micromake/micromake.github.io/docs/index.md

---
title: 导览
icon: lucide/rocket
---

<div class="grid cards" markdown>
-   :material-clock-fast:{ .lg .middle } __Tips__

    ---

    <ul>
      <li>搜索关键词以打开文章。</li>
      <li>通过主题和目录以打开文章。</li>
      <li>电脑端：请在上方标签栏选择语言，在左侧目录选择文章。</li>
      <li>移动端：请在上方标签栏选择语言，请点击左上角图标选择文章。</li>

</div>
