micromake/micromake.github.io/docs/delta/3/3.md

---
title: 传动组装
---

## 0.注意事项

!!! info "螺丝固定"
    螺丝需要涂抹螺纹胶,  需要涂抹螺纹胶的螺丝使用<strong><span style="color:#295FCC">蓝色</span></strong>显示：
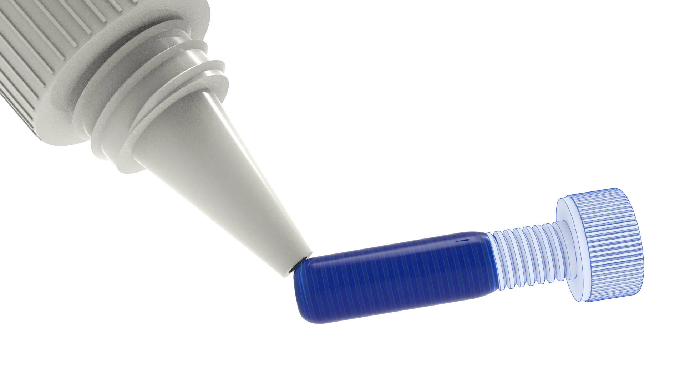
[picture p3: docs/delta/3/ls.webp]
    

???+ tip "安装建议"

    安装导轨时，建议佩戴手套。
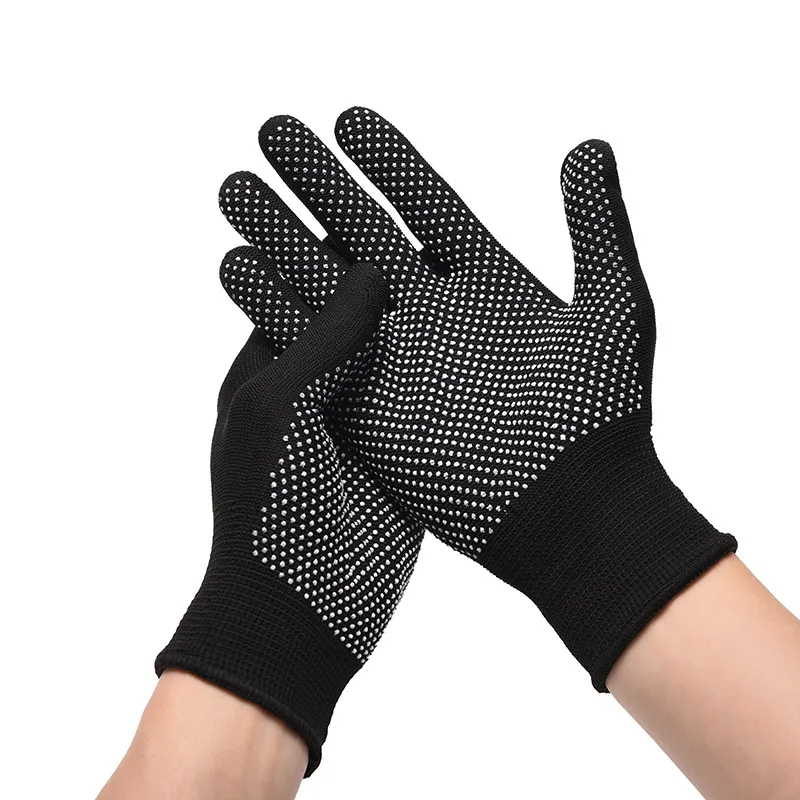
[picture p4: docs/delta/3/jy1.webp]
    
    建议在平整的桌面进行安装。
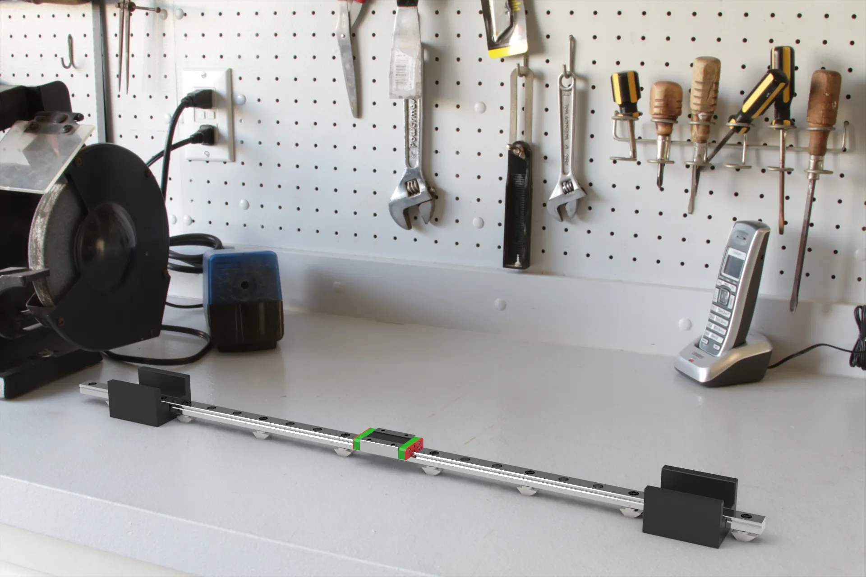
[picture p5: docs/delta/3/jy2.webp]
    

## 1.导轨组装

### 所需物料

1.直线导轨 * 3
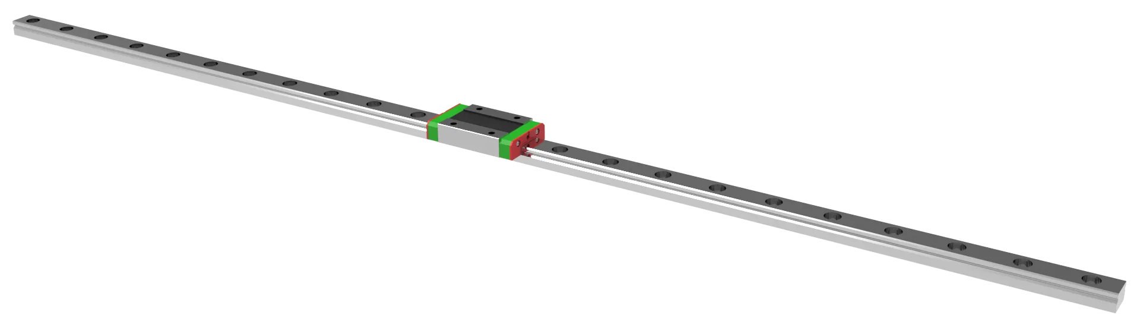
[picture p6: docs/delta/3/dg.webp]
   

2.M3*10 杯头螺丝 * 24
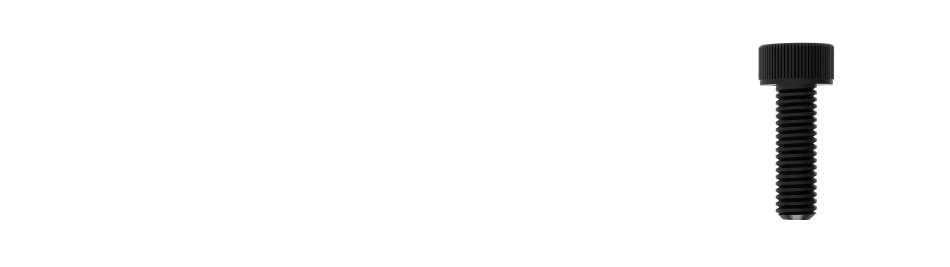
[picture p7: docs/delta/3/M3-10.webp]
   

3.M3*14 杯头螺丝 * 3
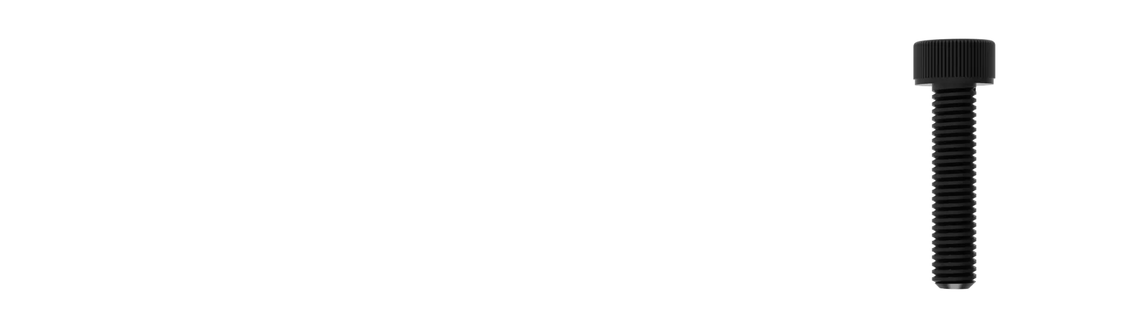
[picture p8: docs/delta/3/M3X14.webp]
   

4.船型螺母30型-M3 * 27
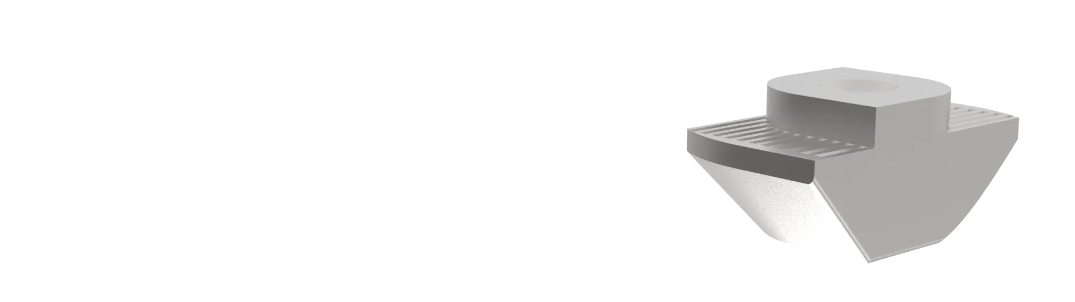
[picture p9: docs/delta/3/30M3.webp]
   

### 打印零件

1.[导轨定位件] * 2
[导轨定位件]: dy1.stl
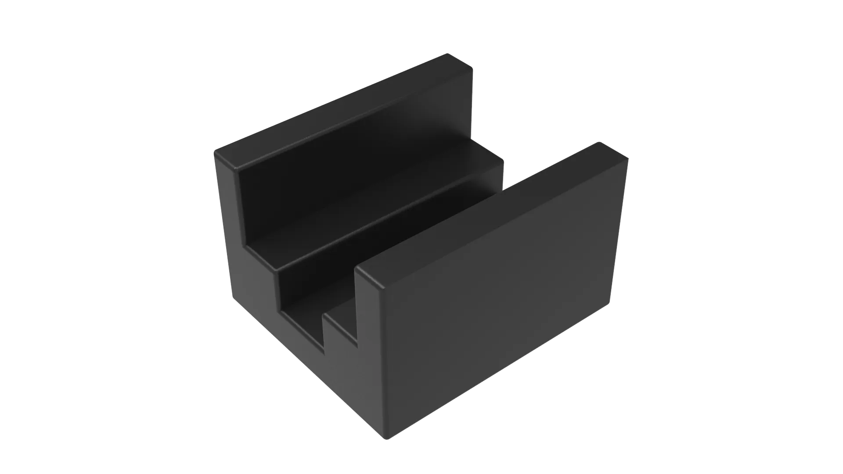
[picture p10: docs/delta/3/dy1.webp]
   

2.[导轨防脱块] * 3
[导轨防脱块]: dy2.stl
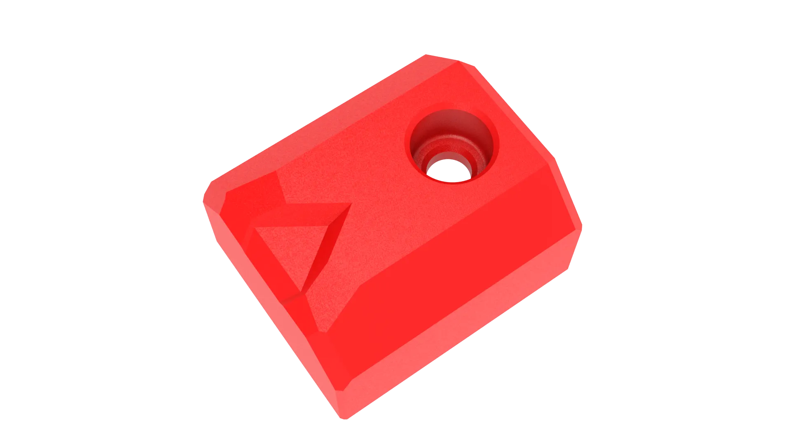
[picture p11: docs/delta/3/dy2.webp]
   

### 组装流程

1.拿出<strong>直线导轨</strong>使用两个<strong>导轨定位件</strong>将导轨撑起，使用<strong>M3*10 杯头螺丝</strong>穿过导轨，从上往下每隔两个孔安装一颗，总计八颗。
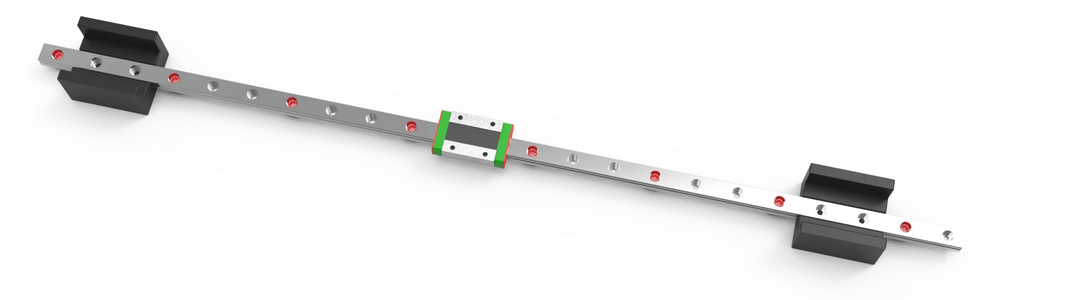
[picture p12: docs/delta/3/1.webp]
   

!!! info "info"
    此步骤建议在干净的桌面上进行操作。

2.在导轨处套入<strong>导轨防脱块</strong>使用<strong>M3*14 杯头螺丝</strong>穿过导轨。
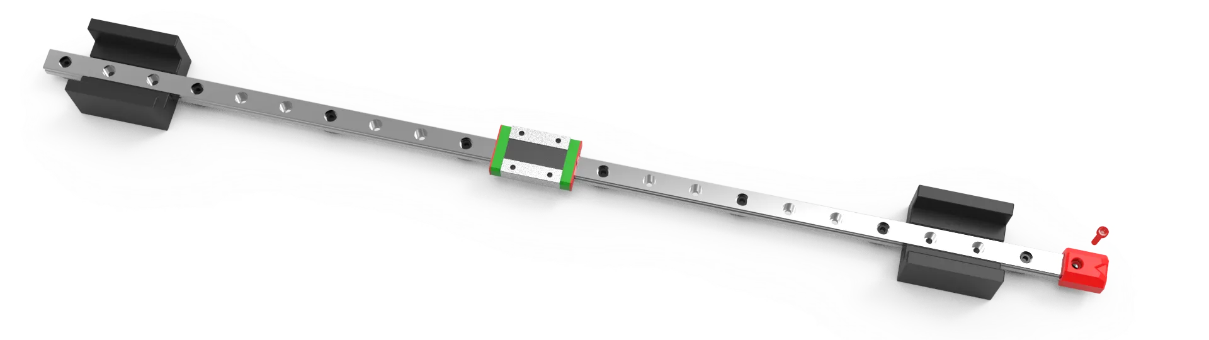
[picture p13: docs/delta/3/2.webp]
   

3.拧上九颗<strong>船型螺母30型-M3</strong>，不要拧紧，拧上即可。
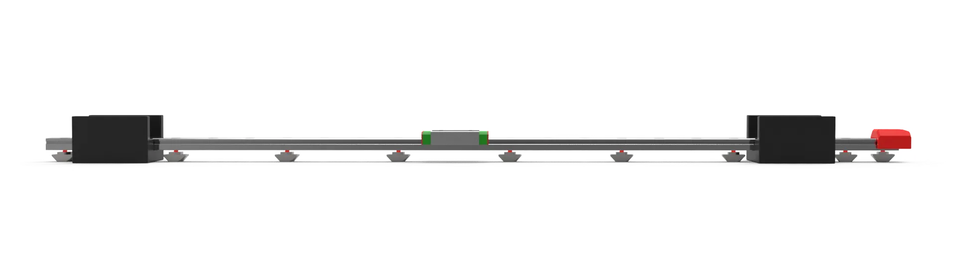
[picture p14: docs/delta/3/3.webp]
   

4.将<strong>直线导轨</strong>放入<strong>长型材</strong>上，<strong>船型螺母30型-M3</strong>应在槽内，使用两个<strong>导轨固定件</strong>辅助型材左右定位，防止滑块脱落，<strong>导轨防脱块</strong>在下方固定,如图所示。
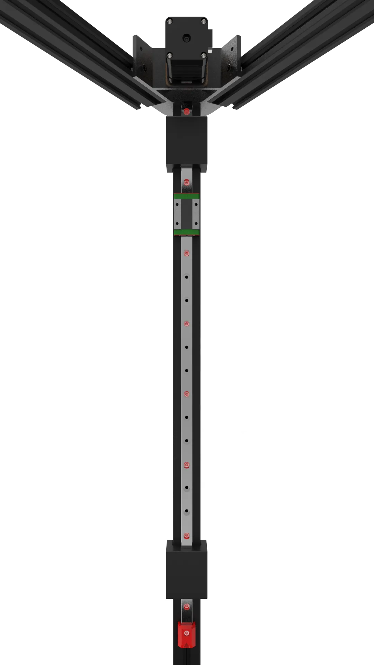
[picture p15: docs/delta/3/4.webp]
   
   
5.拧紧<strong>M3*10 杯头螺丝</strong>，确保所有<strong>船型螺母30型-M3</strong>全部卡到<strong>长型材</strong>槽内，安装完成后滑动<strong>直线导轨</strong>上的滑块，确认是否顺滑没有卡顿，可适当加入润滑油使滑块运动顺畅，最后取出<strong>导轨定位块</strong>，如图所示。
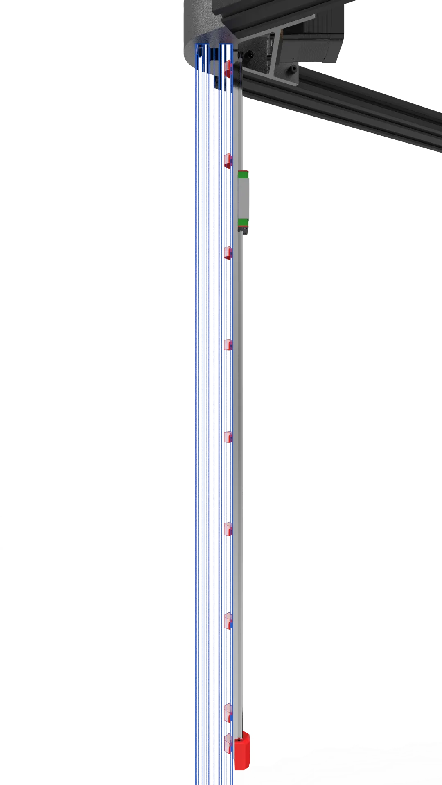
[picture p16: docs/delta/3/5.webp]
   

6.另外两根安装方法相同。
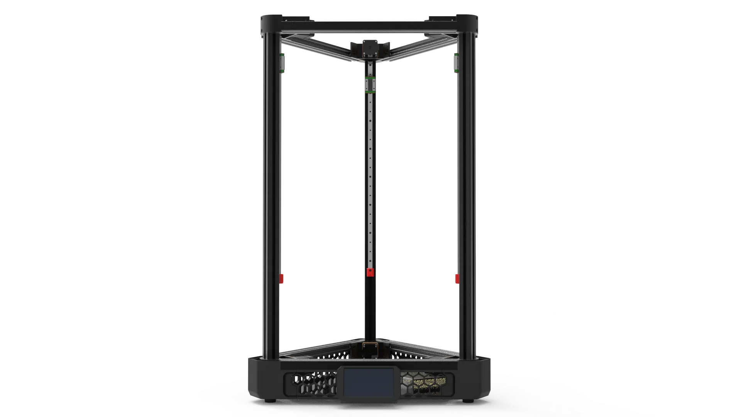
[picture p17: docs/delta/3/10.webp]
   
   
## 2.滑块组装

### 所需物料

1.金属连接滑块 * 3
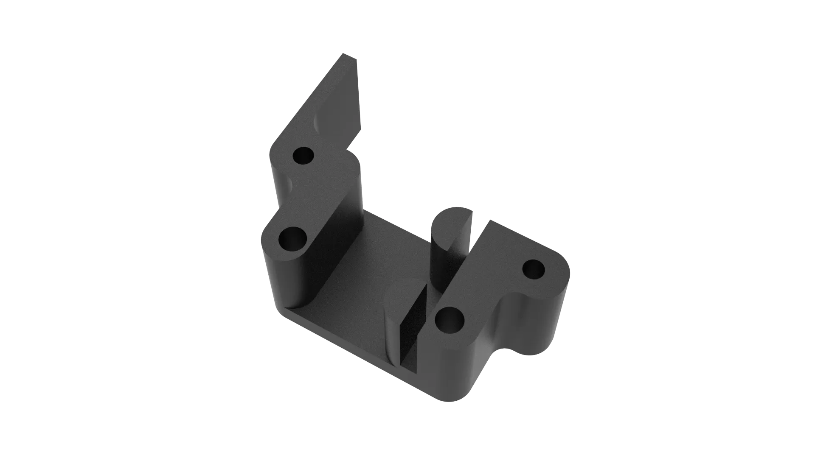
[picture p18: docs/delta/3/hk.webp]
   

2.金属球头连接件 * 3
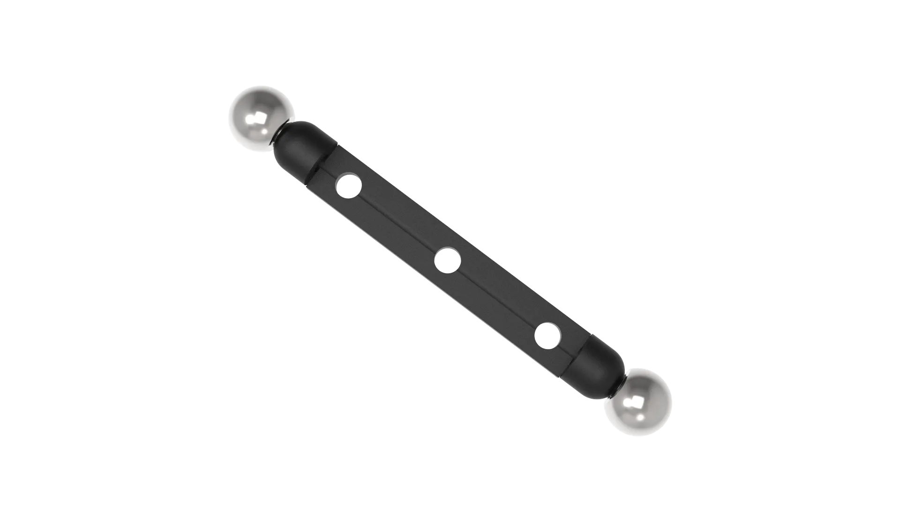
[picture p19: docs/delta/3/ljj.webp]
   

3.2GT开口同步带 * 3
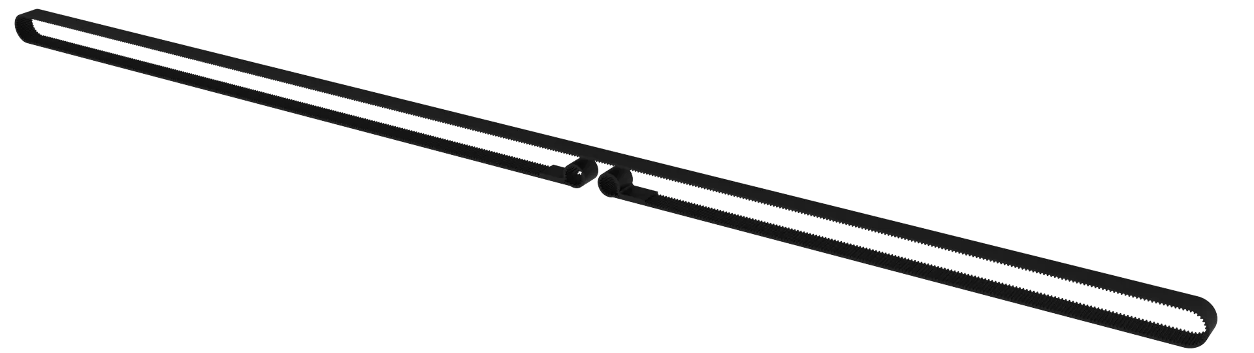
[picture p20: docs/delta/3/pd.webp]
   

4.扎带 * 12
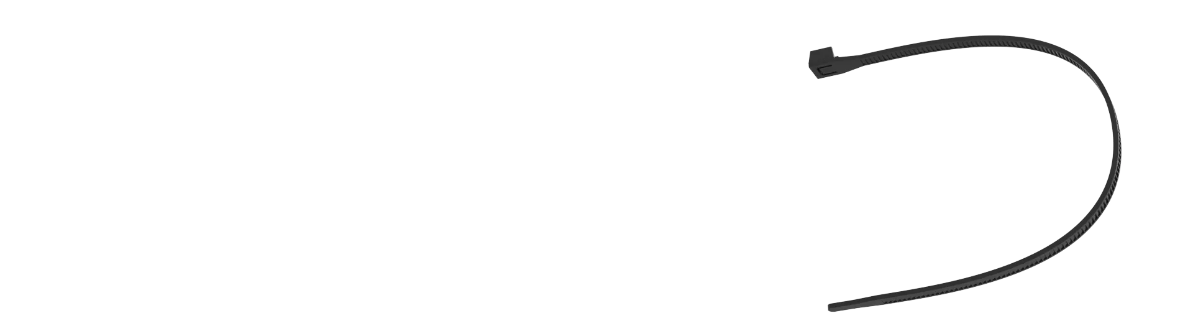
[picture p21: docs/delta/3/zd.webp]
   

5.M3*14 杯头螺丝 * 6
   

6.M3*20 杯头螺丝 * 6
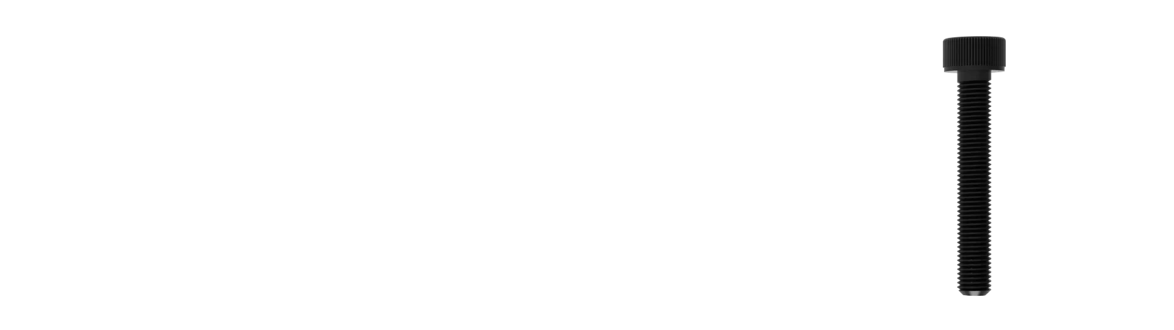
[picture p22: docs/delta/3/M3X20.webp]
   

### 打印零件

1.[滑块垫片] * 3
[滑块垫片]: dy3.stl
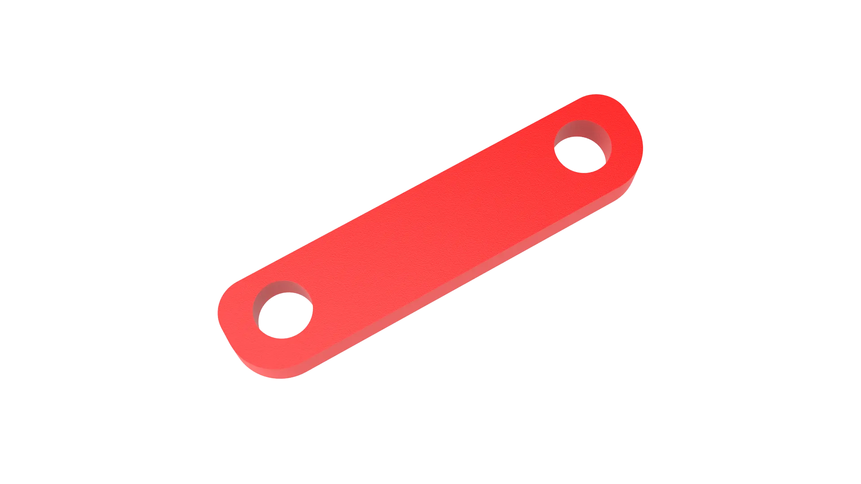
[picture p23: docs/delta/3/dy3.webp]
   

2.[滑块装饰块] * 3
[滑块装饰块]: dy4.stl
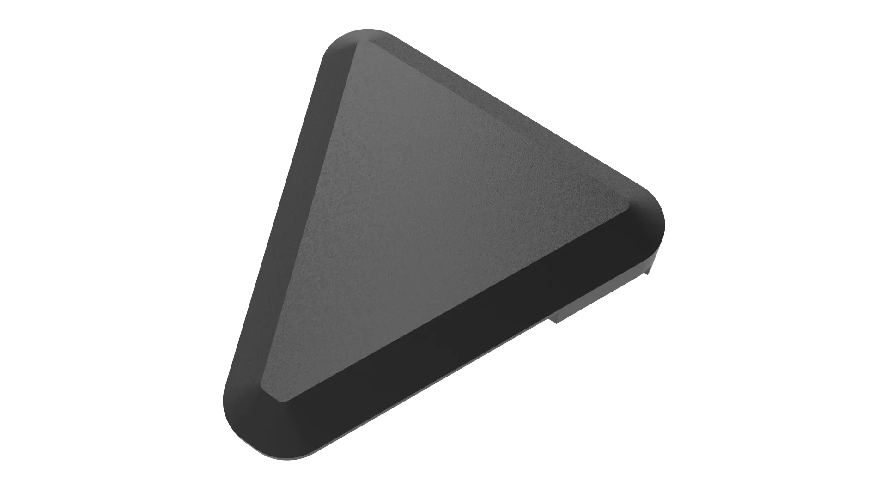
[picture p24: docs/delta/3/dy4.webp]
   

### 组装流程

1.将<strong>2GT开口同步带</strong>穿过两个<strong>步进电机</strong>，两端分别套到<strong>步进电机</strong>同步轮的槽内，如图所示。
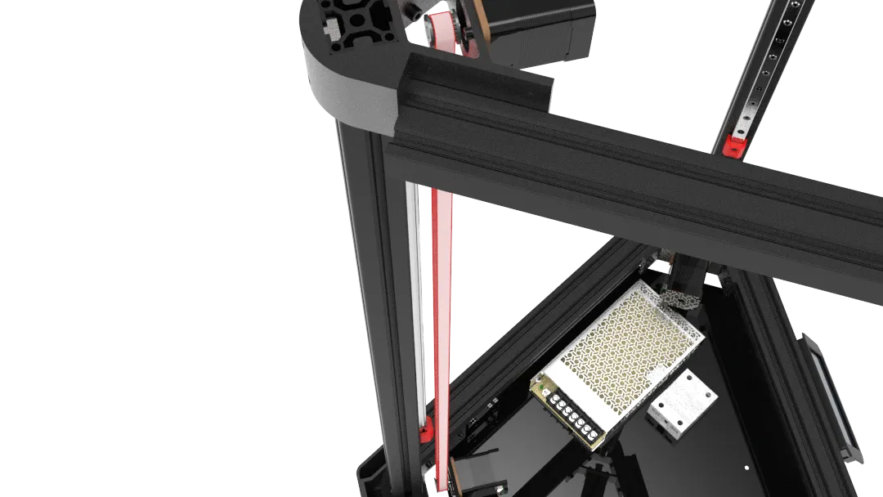
[picture p25: docs/delta/3/6.webp]
   
2.将<strong>2GT开口同步带</strong>的两端绕到<strong>金属连接滑块</strong>中，使用<strong>扎带</strong>将扎紧，并减去多余的部分，如图所示。
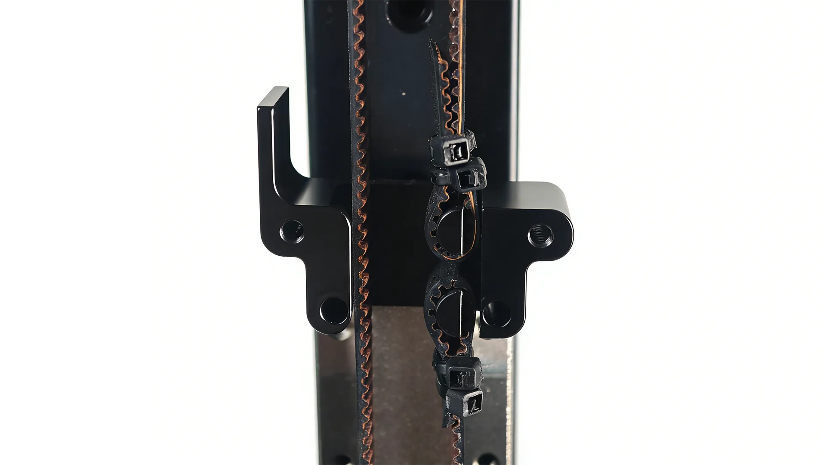
[picture p26: docs/delta/3/7.webp]
   

3.使用两颗<strong>M3*20 杯头螺丝</strong>穿过<strong>滑块垫片</strong>与<strong>金属连接滑块</strong>后固定到<strong>直线导轨</strong>的滑块上，需拧紧,如图所示。
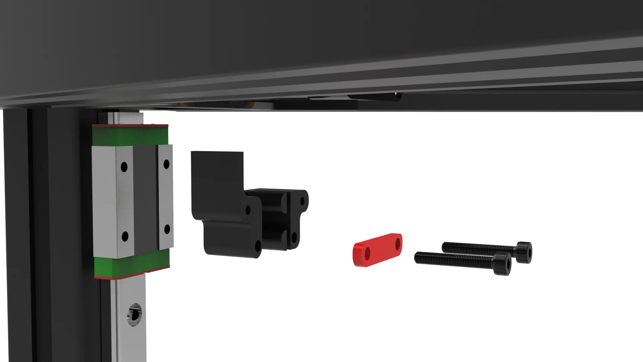
[picture p27: docs/delta/3/8.webp]
   
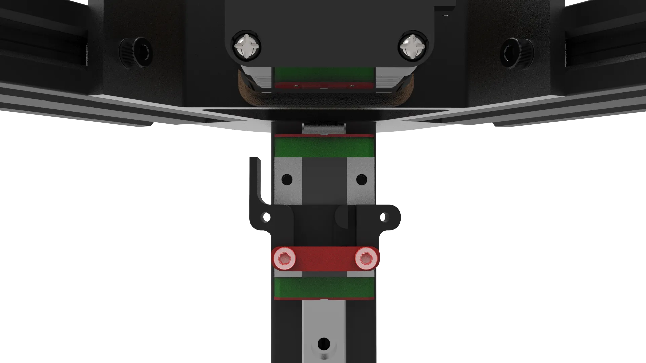
[picture p28: docs/delta/3/9.webp]
   

4.使用两颗<strong>M3*14 杯头螺丝</strong>穿过<strong>滑块垫片</strong>与<strong>金属连接滑块</strong>，涂抹上<strong>螺纹胶</strong>后固定到<strong>直线导轨</strong>的滑块上，需拧紧,如图所示。 
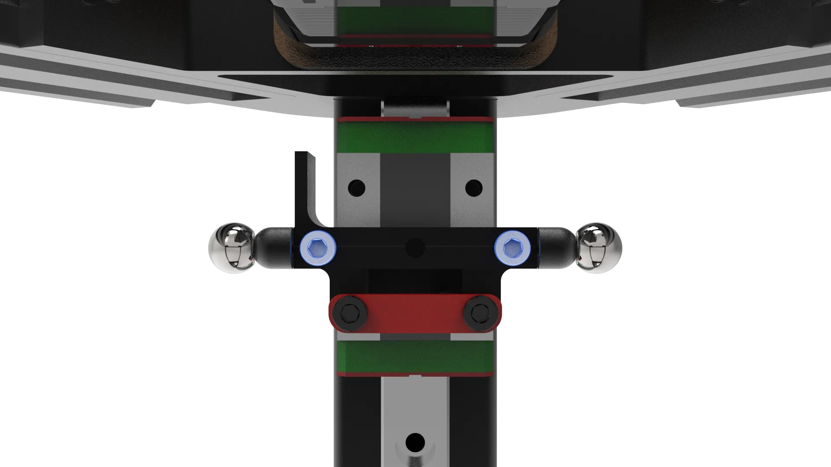
[picture p29: docs/delta/3/11.webp]
   

5.将<strong>滑块装饰块</strong>卡入到<strong>金属连接滑块</strong>上，如图所示。
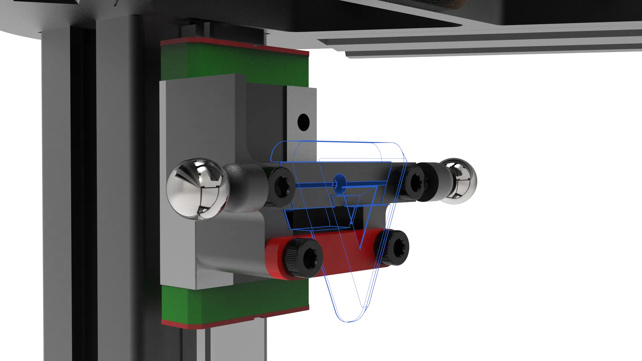
[picture p30: docs/delta/3/12.webp]
   
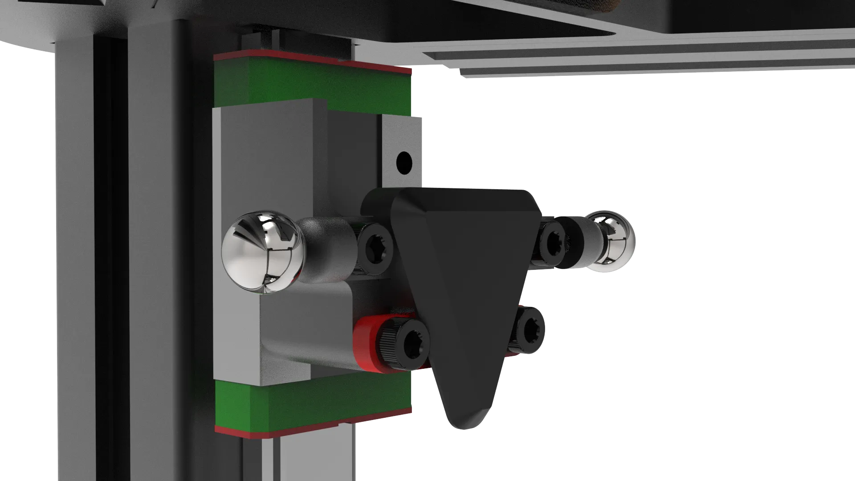
[picture p31: docs/delta/3/13.webp]
   

6.另外两组安装方法相同。
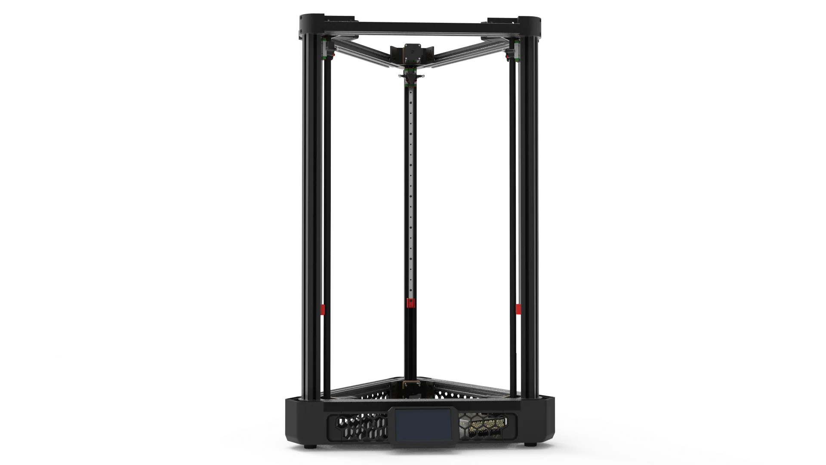
[picture p32: docs/delta/3/14.webp]
   

## 3.传动调节

### 所需物料

1.扭力弹簧 * 3
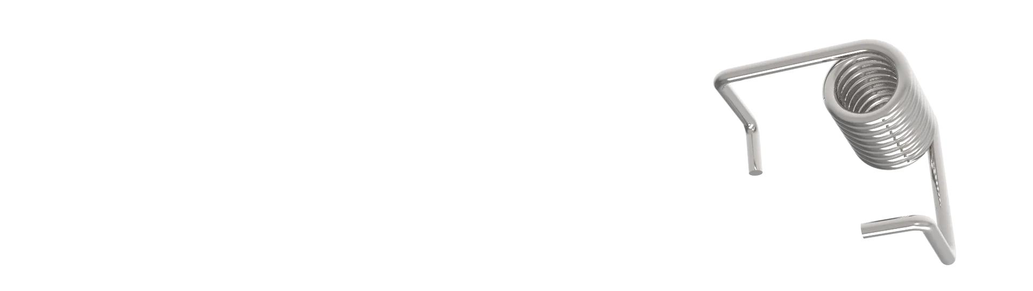
[picture p33: docs/delta/3/th.webp]
   

2.扎带 * 3
   

### 打印零件

1.[皮带松紧调节件] * 3
[皮带松紧调节件]: dy5.stl
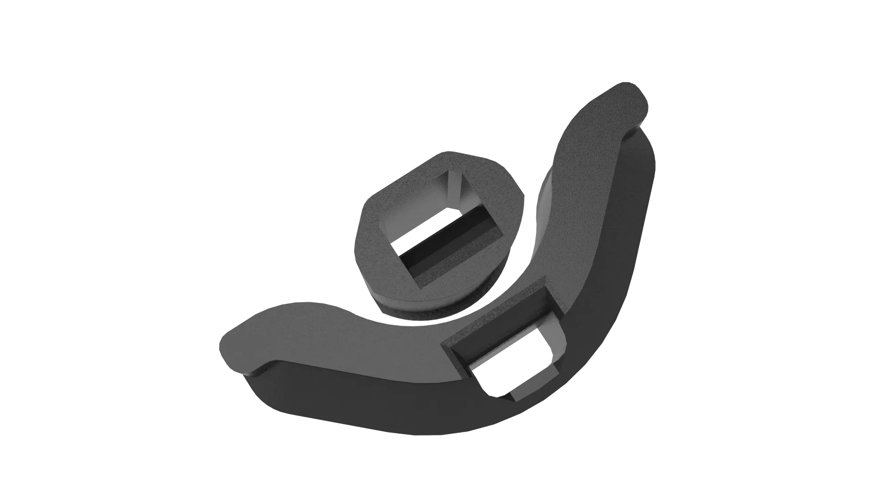
[picture p34: docs/delta/3/dy5.webp]
   

### 组装流程

1.将<strong>皮带松紧调节件</strong>与<strong>2GT开口同步带</strong>如图所示连接。
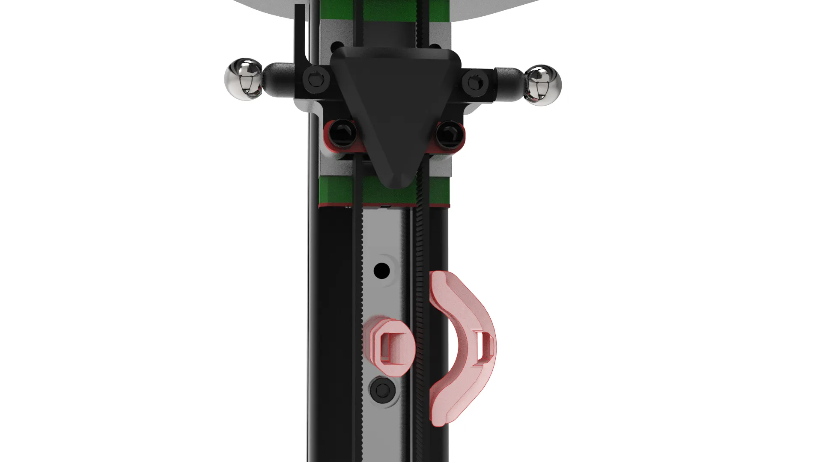
[picture p35: docs/delta/3/15.webp]
   

2.使用<strong>扎带</strong>拉紧<strong>皮带松紧调节件</strong>使<strong>2GT开口同步带</strong>紧绷。
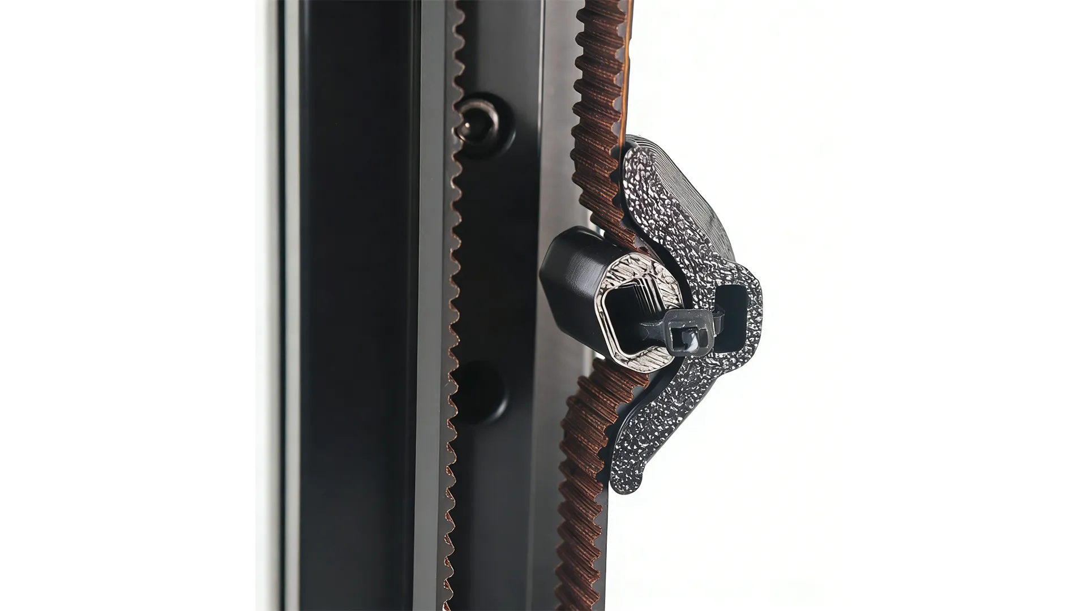
[picture p36: docs/delta/3/16.webp]
   
   
3.上下滑动<strong>金属连接滑块</strong>观察<strong>2GT开口同步带</strong>运动过程中是否会卡同步轮边缘，如图所示。
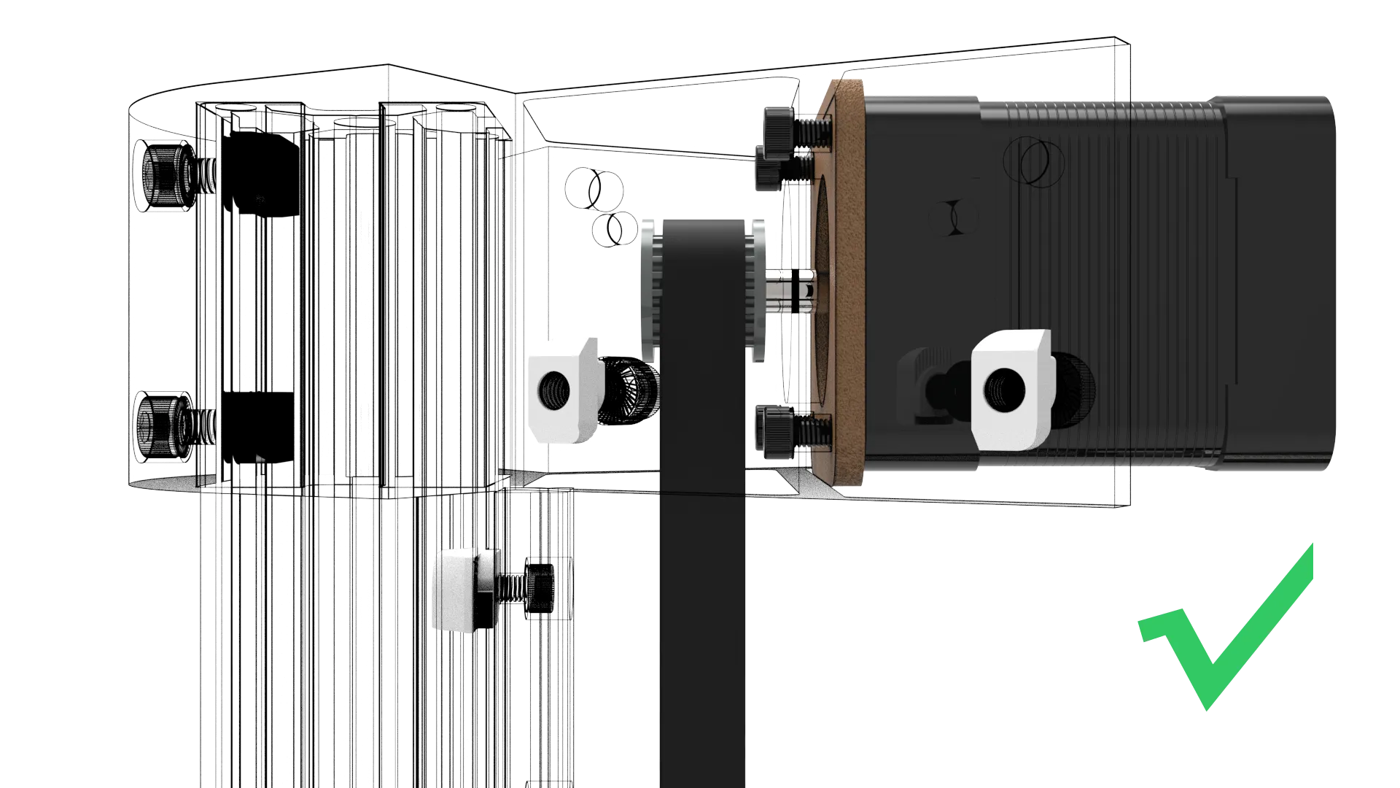
[picture p37: docs/delta/3/zq.webp]
   
!!! failure "错误"
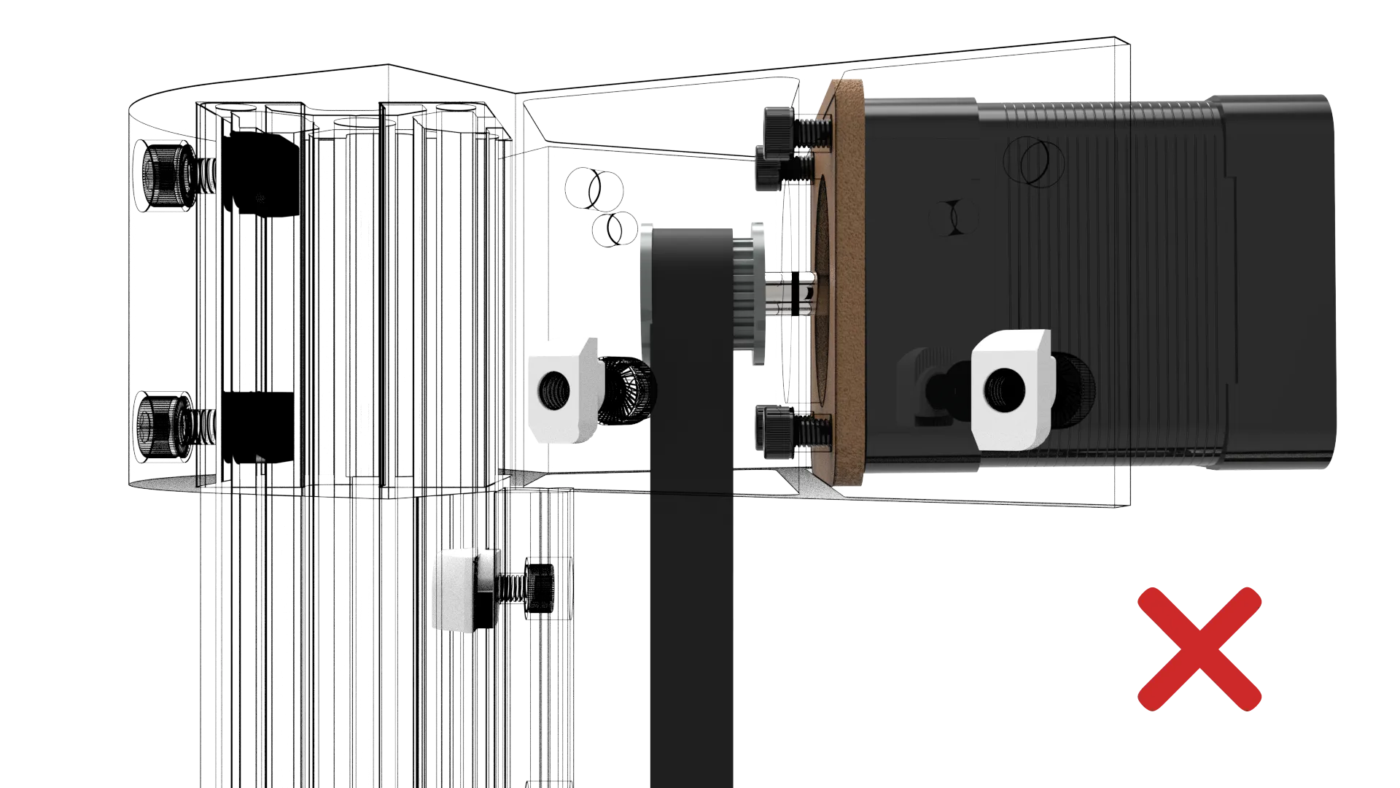
[picture p38: docs/delta/3/17.webp]
    
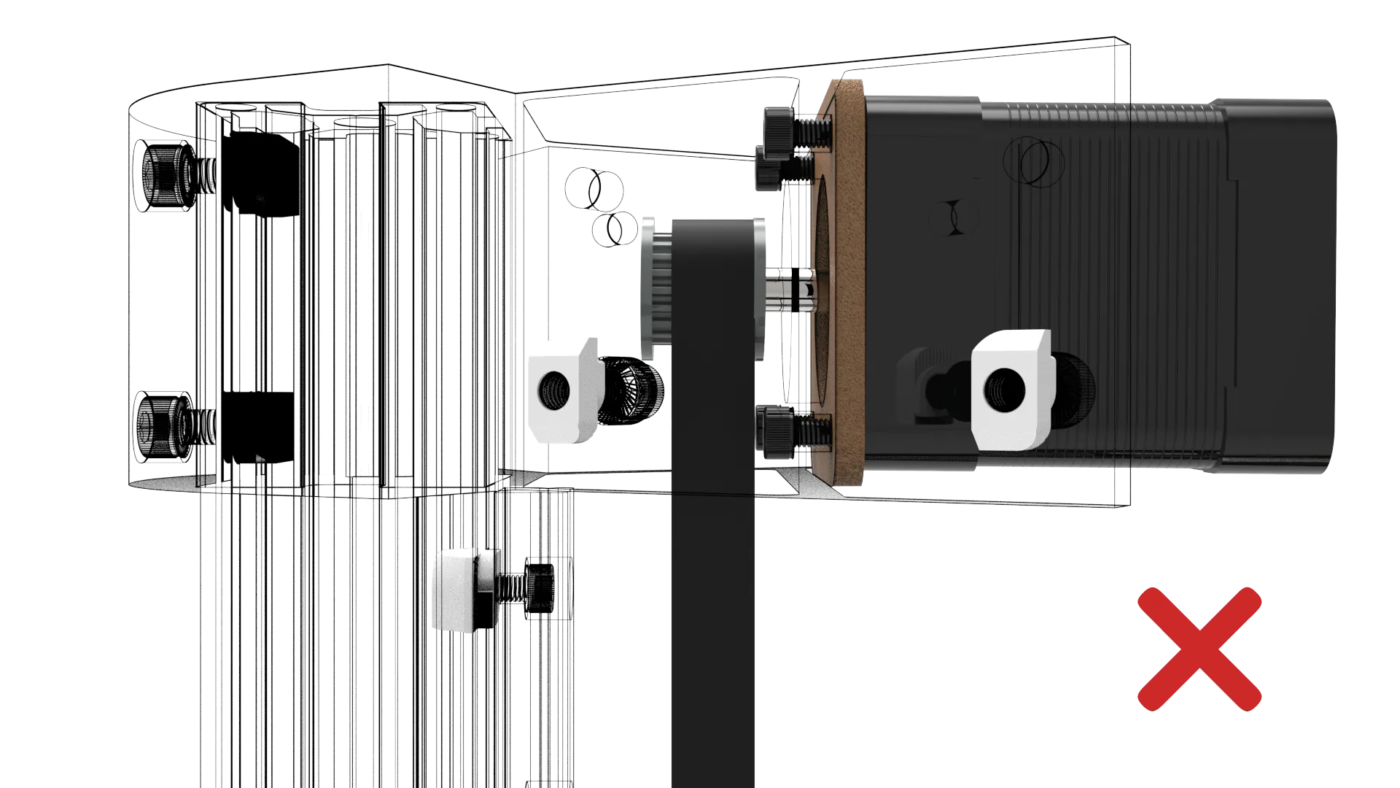
[picture p39: docs/delta/3/18.webp]
    

4.可调节<strong>步进电机</strong>的上下任意平行的两颗螺丝的松紧改变<strong>步进电机</strong>角度，使<strong>2GT开口同步带</strong>运动过程中不会摩擦<strong>步进电机</strong>的同步轮边缘。
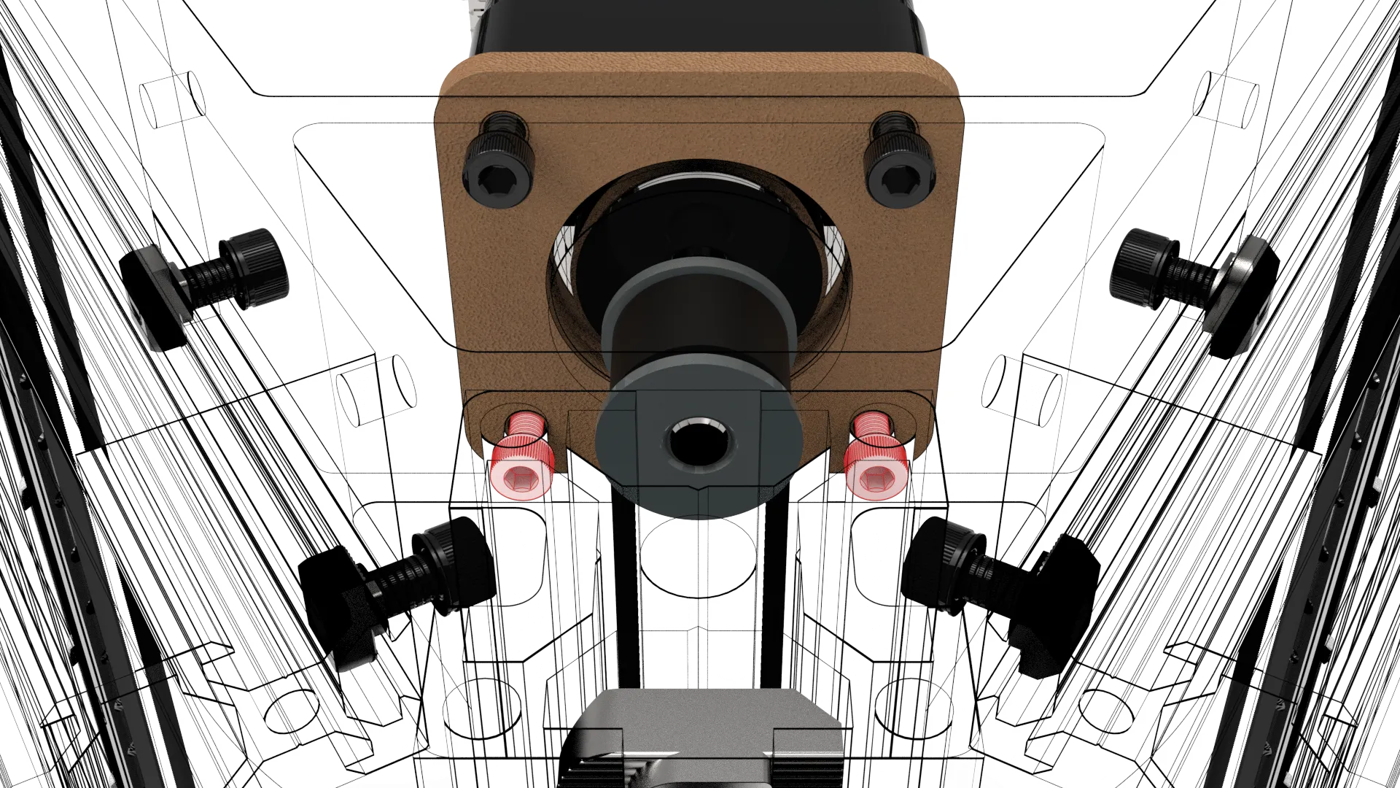
[picture p40: docs/delta/3/19.webp]
   
!!! success "正确"
    

5.最后如图所示位置安装<strong>扭力弹簧</strong>使具有一定自预紧力。
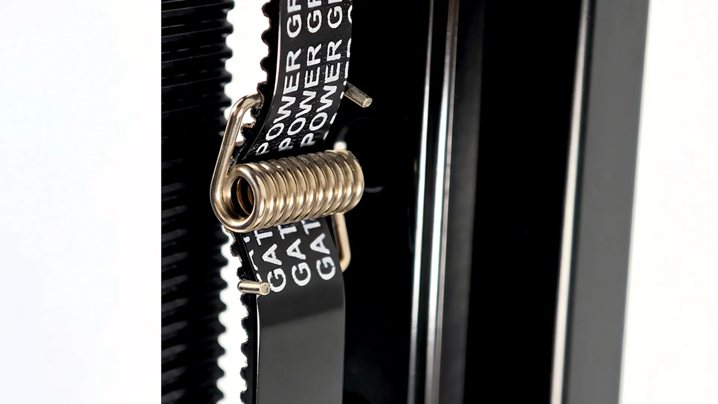
[picture p41: docs/delta/3/20.webp]
   

???- note "另一种皮带安装方法"

    这是另一种<strong>2GT开口同步带</strong>安装方法，原始的设计本应如此，更换为更加粗壮结实的同步带规格，最高支持到10MM宽度。
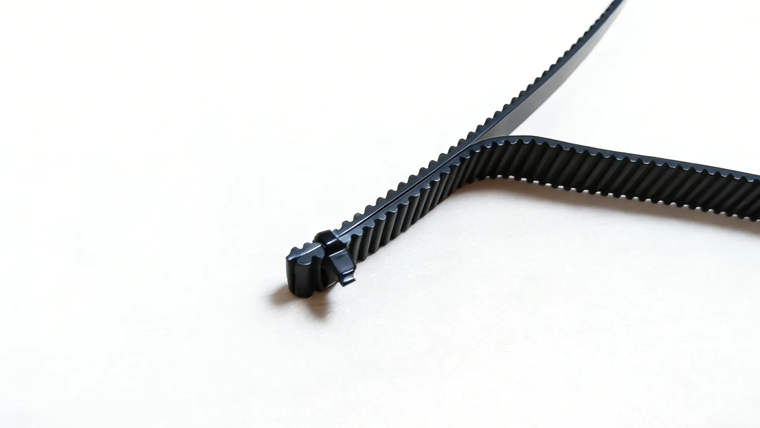
[picture p42: docs/delta/3/kz1.webp]
    
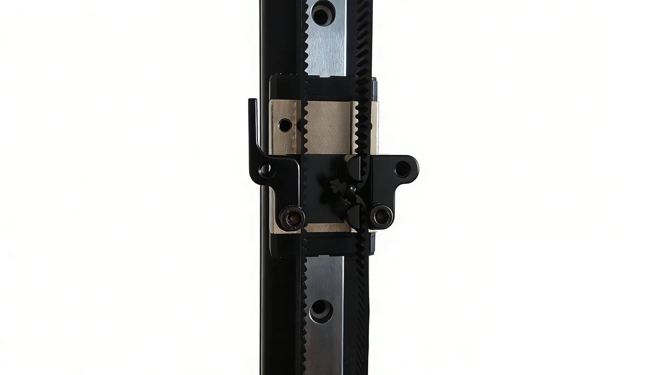
[picture p43: docs/delta/3/kz2.webp]
    
    使用另一种MGN滑块可以无需安装滑块垫片直接即可固定，因为量产的<strong>直线导轨</strong>变更，为了不额外增加螺丝种类才做了打印件进行抬升。（注意：如果不使用打印件而是直接进行螺丝固定，<strong>M3*20 杯头螺丝</strong>需要涂抹螺纹胶使其更加紧固。）

???- question "FAQ"

    **Q: 减震垫的作用是什么？**

    **A:** 步进电机与金属脚垫均为金属材质，电机高速运动时所产生的震动会传到了框架上，使用柔性垫片可以有效隔绝震动与噪音，同时因为是柔性垫片，可很方便的通过调节螺丝松紧度调节电机角度，进一步降低装配调试难度。
