micromake/micromake.github.io/docs/delta/2/2.md

---
title: 下部组装
---

## 0.注意事项

!!! warning "螺丝固定"
    螺丝固定打印件时，不要拧的过紧，以免拧坏打印件。

!!! info "嵌入螺母"
    部分打印件需借助烙铁压入<strong>滚花螺母</strong>：
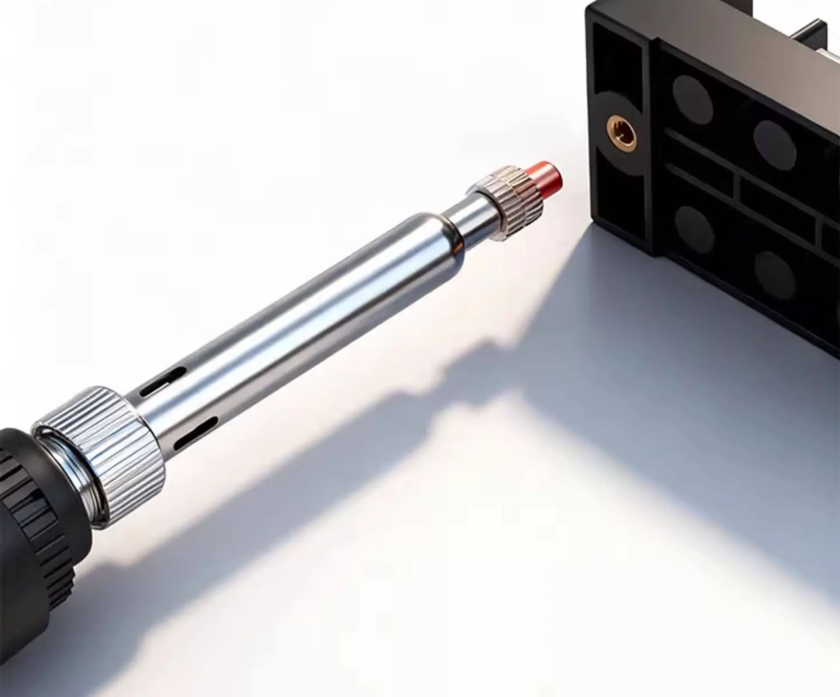
[picture p44: docs/delta/2/1.webp]
    

## 1.下装饰件

### 所需物料

1.脚垫 * 3
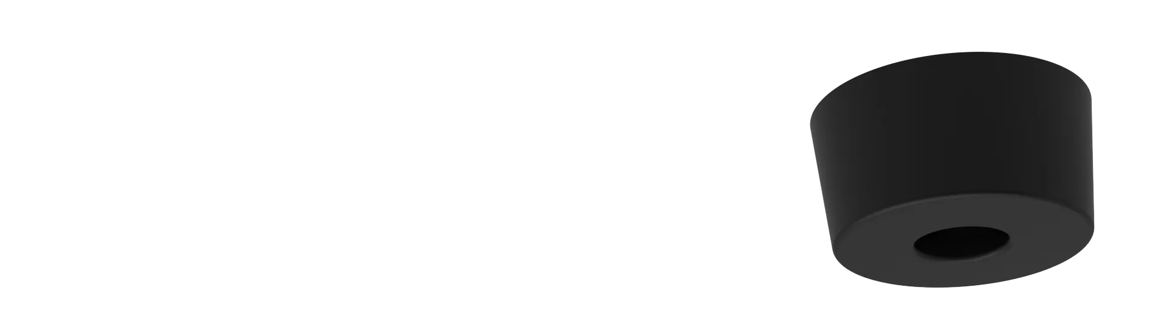
[picture p45: docs/delta/2/jd.webp]
   

2.船型螺母20型-M3 * 6
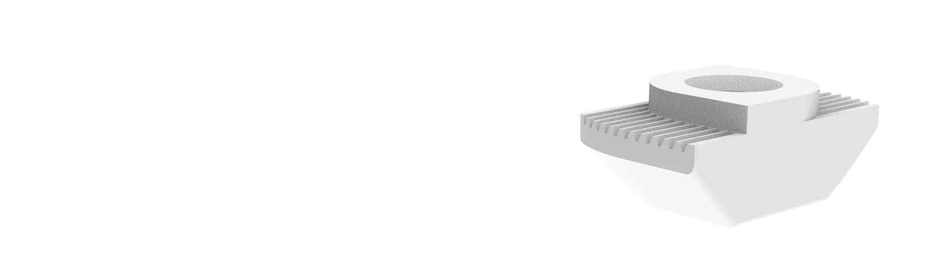
[picture p46: docs/delta/2/20M3.webp]
   

3.M5*16 杯头螺丝 * 3
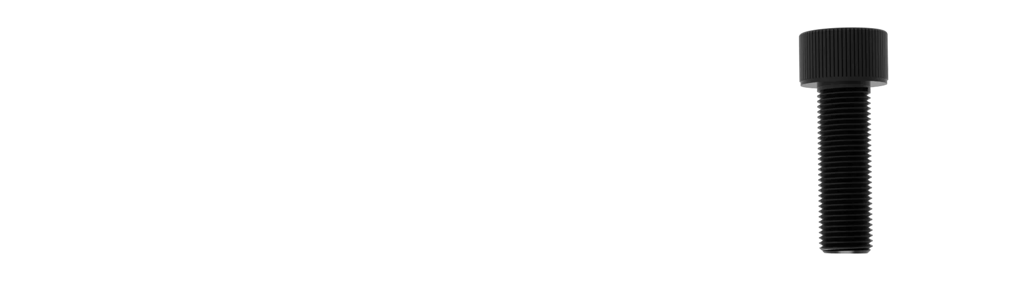
[picture p47: docs/delta/2/M5X16.webp]
   

4.M3*10 杯头螺丝 * 6
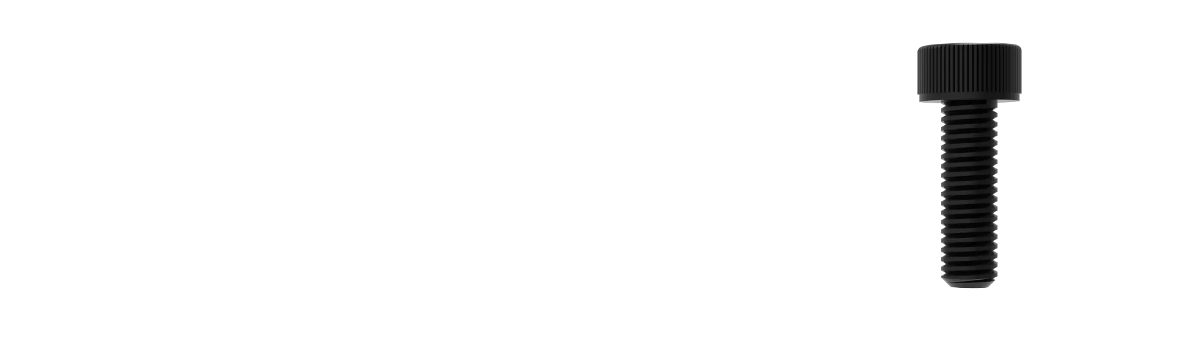
[picture p48: docs/delta/2/M3X10.webp]
   

### 打印零件

1.[下脚件装饰件] * 3
[下脚件装饰件]: dy1.stl
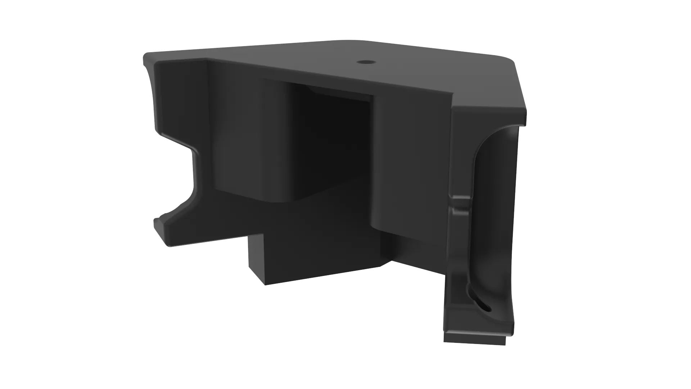
[picture p49: docs/delta/2/dy1.webp]
   

### 组装流程

1.将<strong>M5*16 杯头螺丝</strong>穿过<strong>脚垫</strong>拧入到<strong>下脚件装饰件</strong>中。
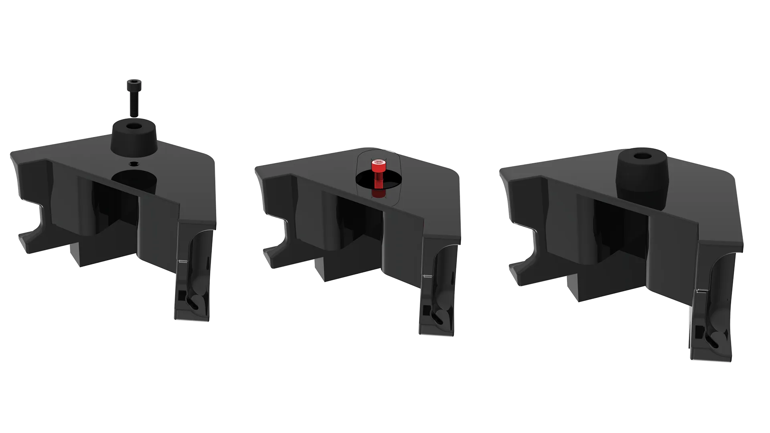
[picture p50: docs/delta/2/2.webp]
   

2.将<strong>M3*10 杯头螺丝</strong>穿过<strong>下脚件装饰件</strong>并套上<strong>船型螺母20型-M3</strong>。
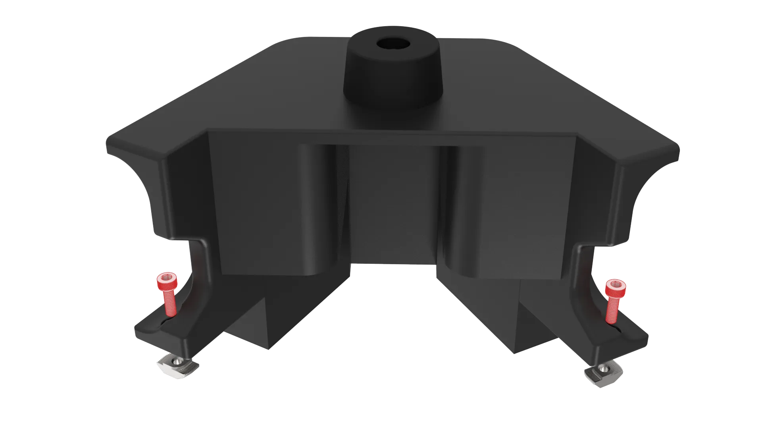
[picture p51: docs/delta/2/3.webp]
   

3.<strong>M3*10 杯头螺丝</strong>拧上即可，无需拧紧。
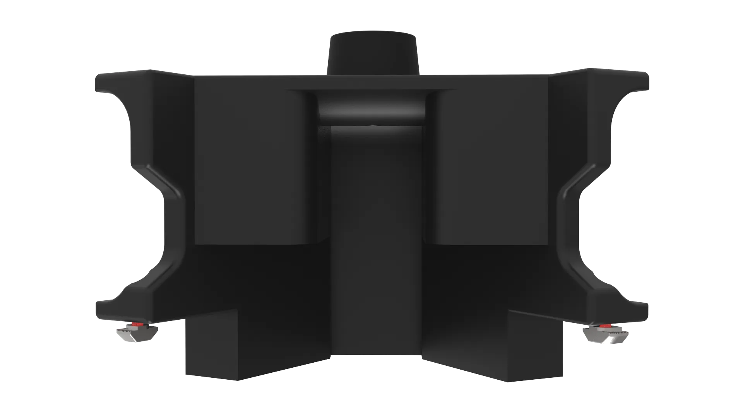
[picture p52: docs/delta/2/4.webp]
   

4.固定到<strong>短铝型材</strong>上。
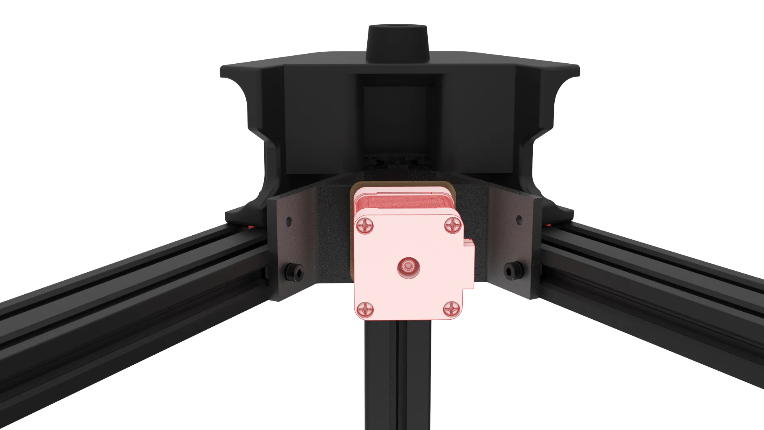
[picture p53: docs/delta/2/5.webp]
   

5.注意<strong>船型螺母20型-M3</strong>的位置，应卡在型材上，不要拧的过紧，以免拧坏<strong>下脚件装饰件</strong>。
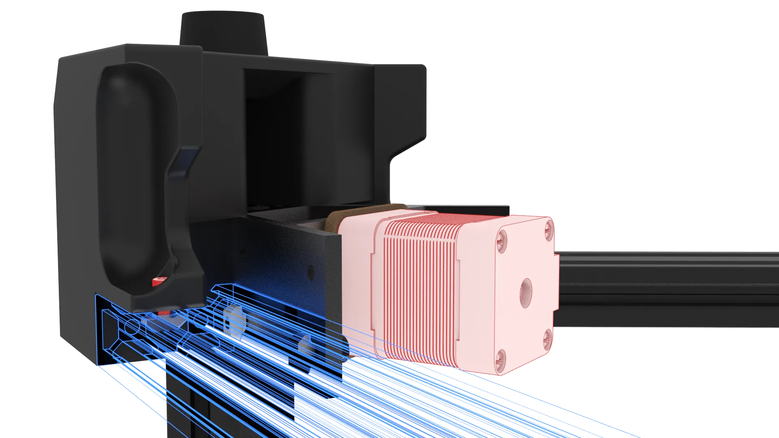
[picture p54: docs/delta/2/6.webp]
   

6.另外两组安装方法相同。
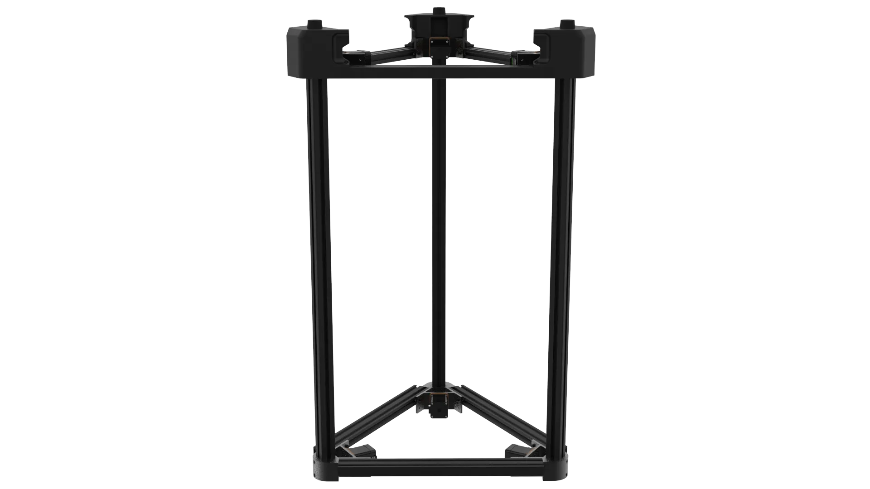
[picture p55: docs/delta/2/7.webp]
   

## 2.左侧裙边

### 所需物料

1.M3*8 沉头螺丝 * 6
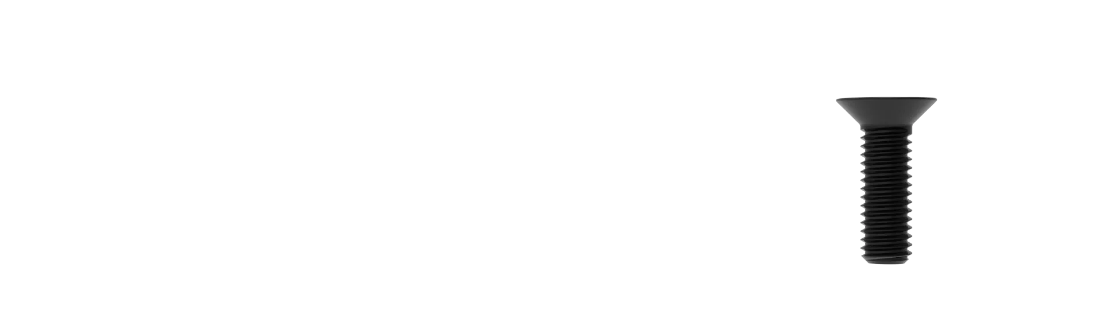
[picture p56: docs/delta/2/M3X8.webp]
   

2.滚花螺母 * 3
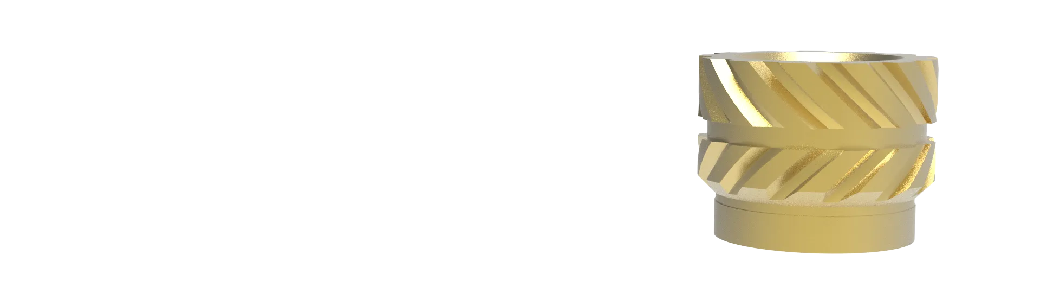
[picture p57: docs/delta/2/tlm.webp]
   
   
3.船型螺母20型-M3 * 6
   

### 打印零件

1.[左裙边打印件]  * 3
[左裙边打印件]: dy2.stl
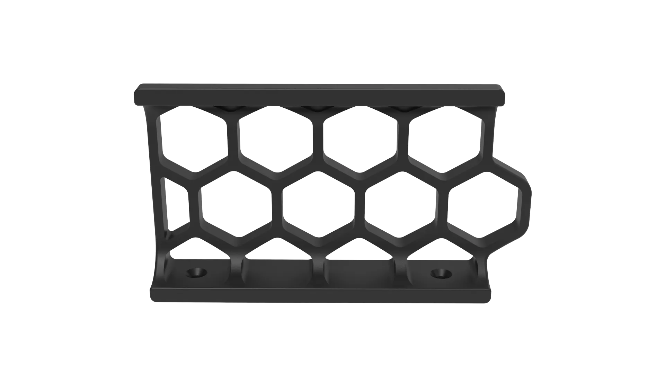
[picture p58: docs/delta/2/dy2.webp]
   

### 组装流程

1.使用烙铁将<strong>滚花螺母</strong>压入<strong>左裙边打印件</strong>中。
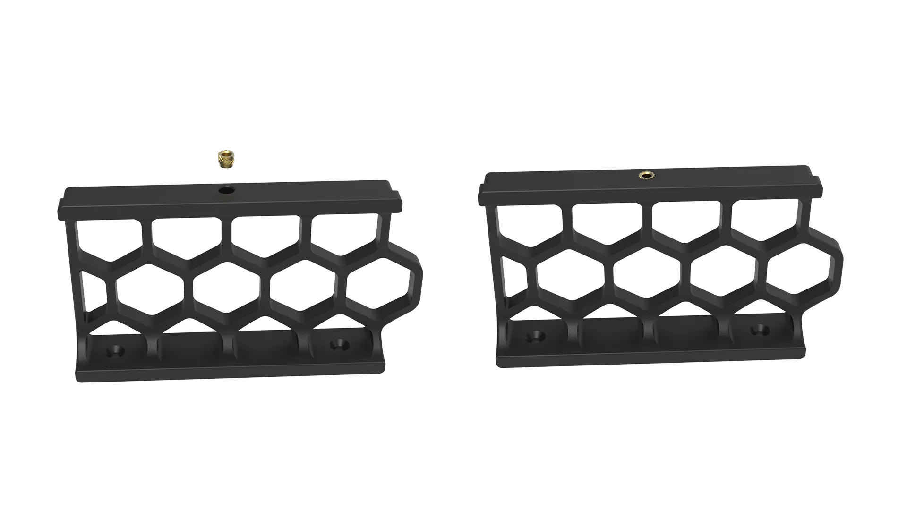
[picture p59: docs/delta/2/8.webp]
   

2.将<strong>M3*8 沉头螺丝</strong>穿过<strong>左裙边打印件</strong>并套上<strong>船型螺母20型-M3</strong>。
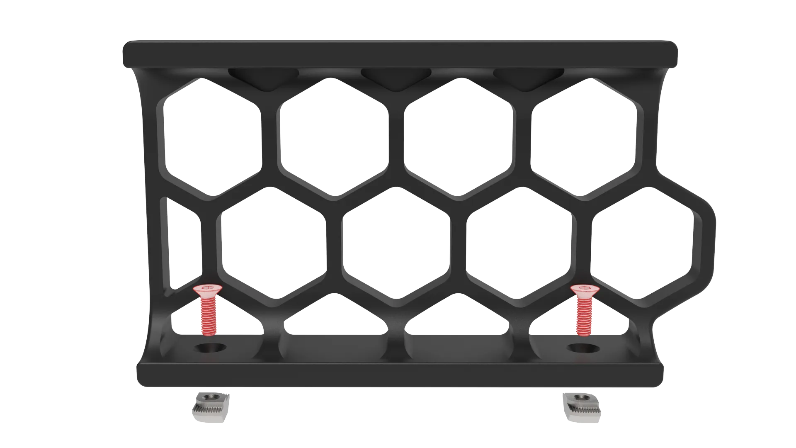
[picture p60: docs/delta/2/9.webp]
   

3.<strong>M3*8 沉头螺丝</strong>拧上即可，无需拧紧。
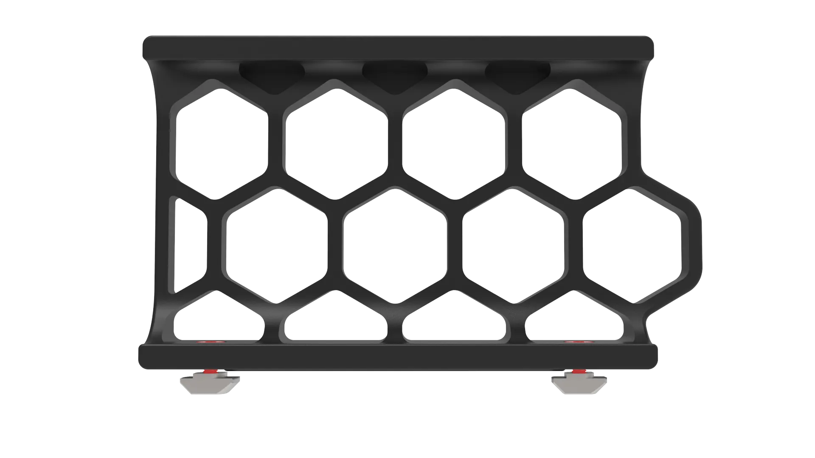
[picture p61: docs/delta/2/10.webp]
   

4.固定到<strong>短铝型材</strong>上。
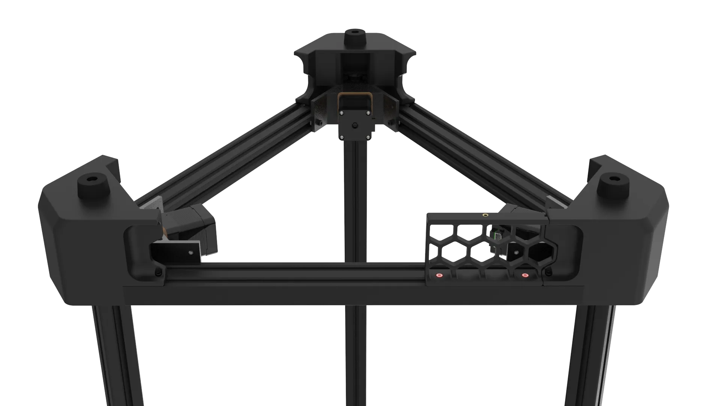
[picture p62: docs/delta/2/11.webp]
   

5.另外两组安装方法相同。
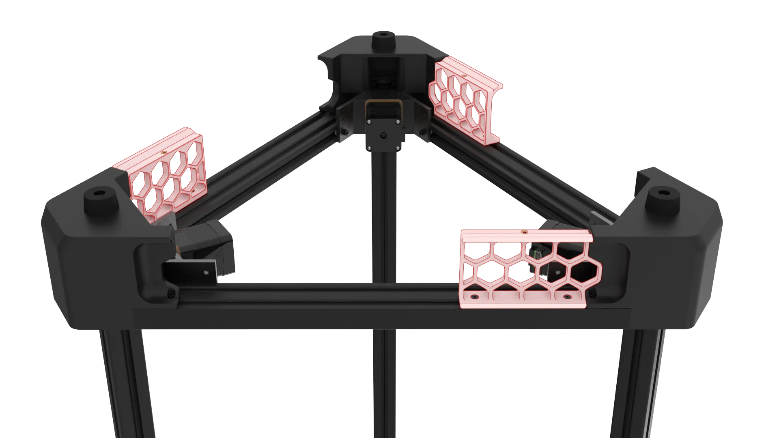
[picture p63: docs/delta/2/12.webp]
   
  
## 3.电源开关

### 所需物料

1.电源开关 * 1
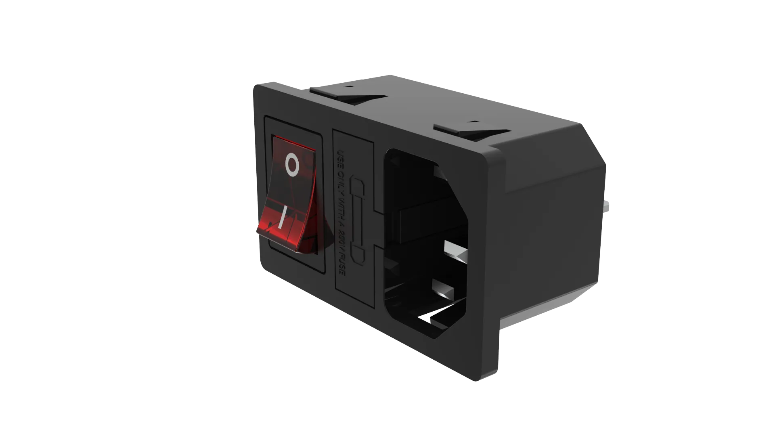
[picture p64: docs/delta/2/kg.webp]
   

2.M3*8 沉头螺丝 * 2
   

3.滚花螺母 * 1
   

4.船型螺母20型-M3 * 2
   

### 打印零件

1.[右裙边开关打印件] * 1
[右裙边开关打印件]: dy3.stl
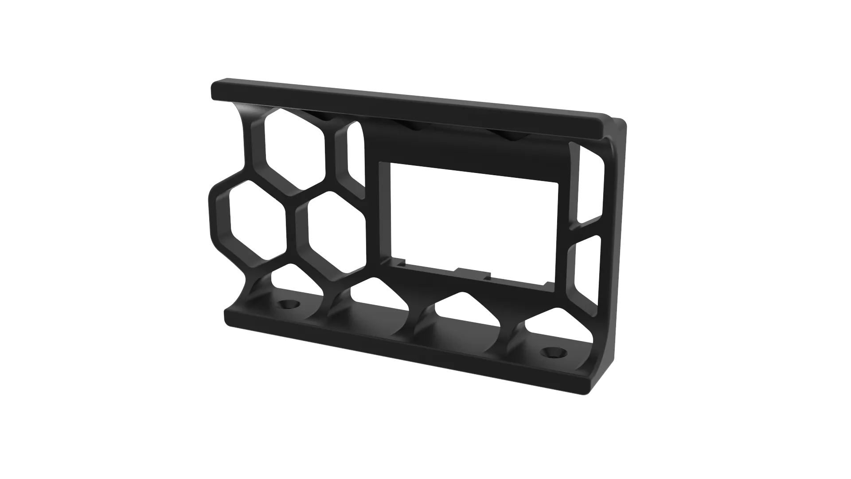
[picture p65: docs/delta/2/dy3.webp]
   

### 组装流程

1.使用烙铁将<strong>滚花螺母</strong>压入<strong>右裙边开关打印件</strong>中。
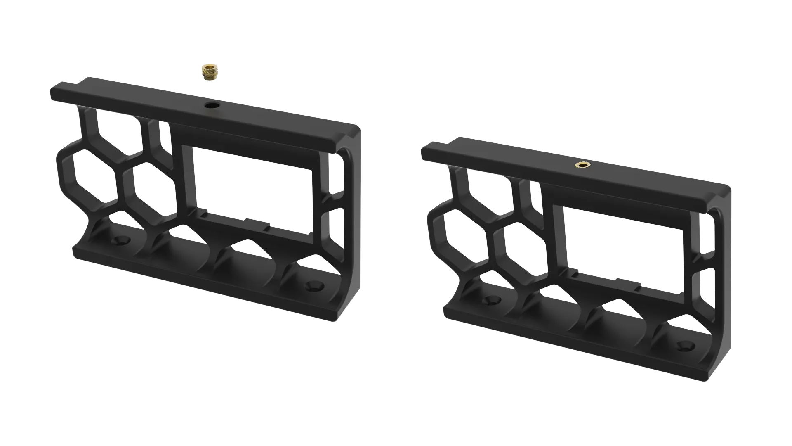
[picture p66: docs/delta/2/13.webp]
   

2.将<strong>电源开关</strong>装入<strong>右裙边开关打印件</strong>中。
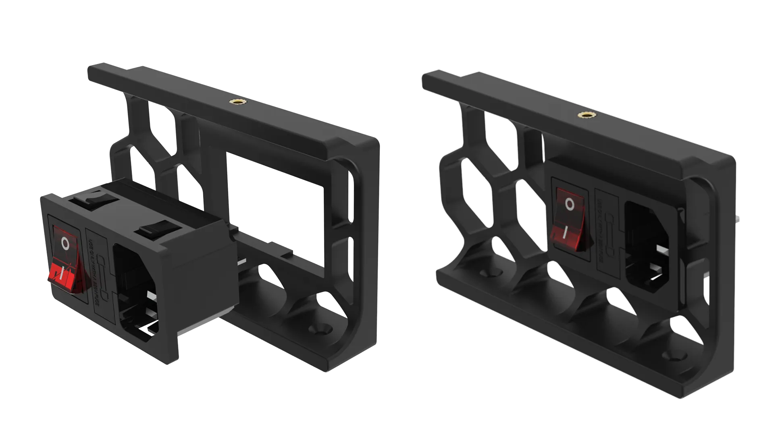
[picture p67: docs/delta/2/14.webp]
   

3.将<strong>M3*8 沉头螺丝</strong>穿过<strong>右裙边开关打印件</strong>并套上<strong>船型螺母20型-M3</strong>。
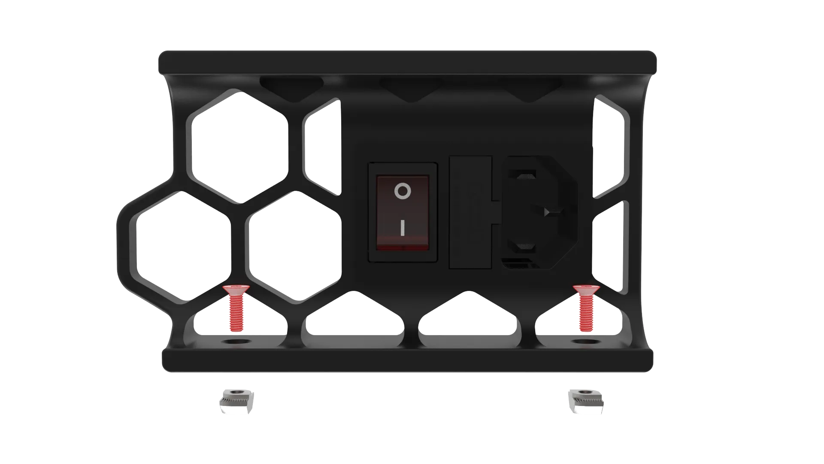
[picture p68: docs/delta/2/15.webp]
   

4.<strong>M3*8 沉头螺丝</strong>拧上即可，无需拧紧。
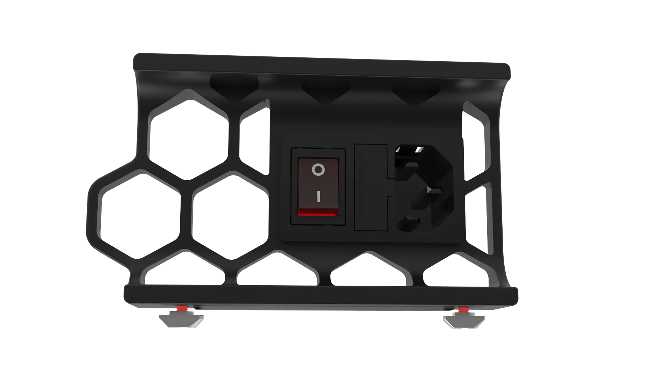
[picture p69: docs/delta/2/16.webp]
   

5.固定到<strong>短铝型材</strong>上。
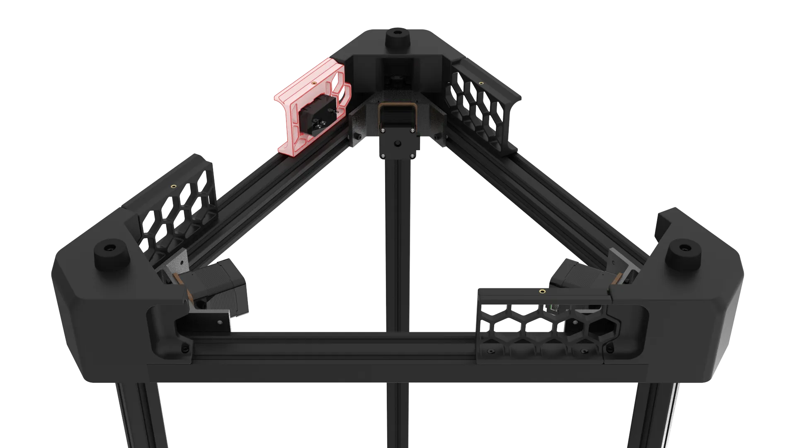
[picture p70: docs/delta/2/17.webp]
   

## 4.右侧裙边

### 所需物料

1.M3*8 沉头螺丝 * 4
   

2.滚花螺母 * 2
   

3.船型螺母20型-M3 * 4
   

### 打印零件

1.[右裙边打印件] * 2
[右裙边打印件]: dy4.stl
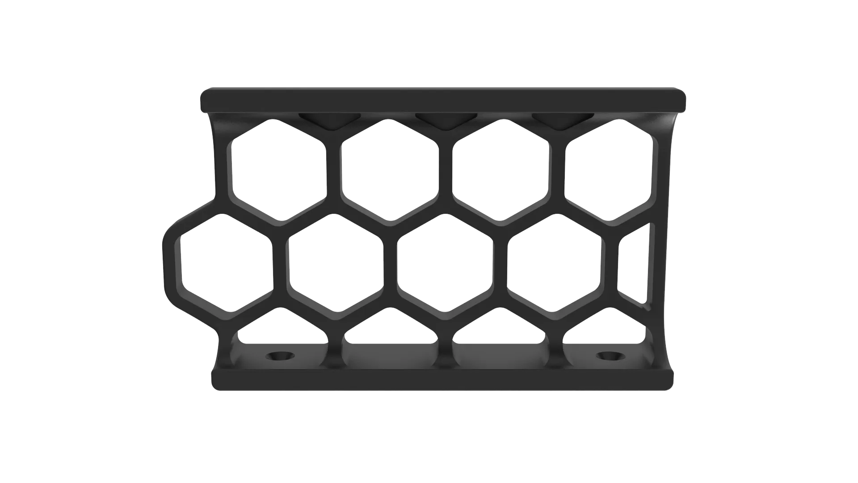
[picture p71: docs/delta/2/dy4.webp]
   

### 组装流程

1.使用烙铁将<strong>滚花螺母</strong>压入<strong>右裙边打印件</strong>中。
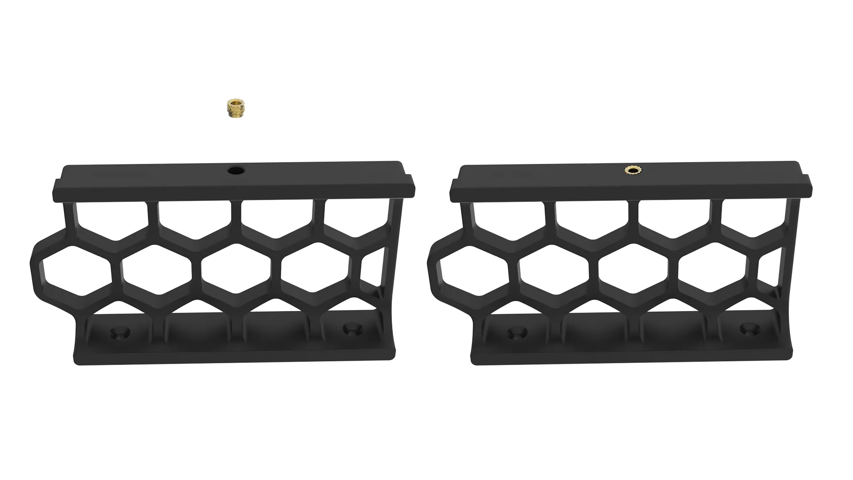
[picture p72: docs/delta/2/18.webp]
   

2.将<strong>M3*8 沉头螺丝</strong>穿过<strong>右裙边打印件</strong>并套上<strong>船型螺母20型-M3</strong>。
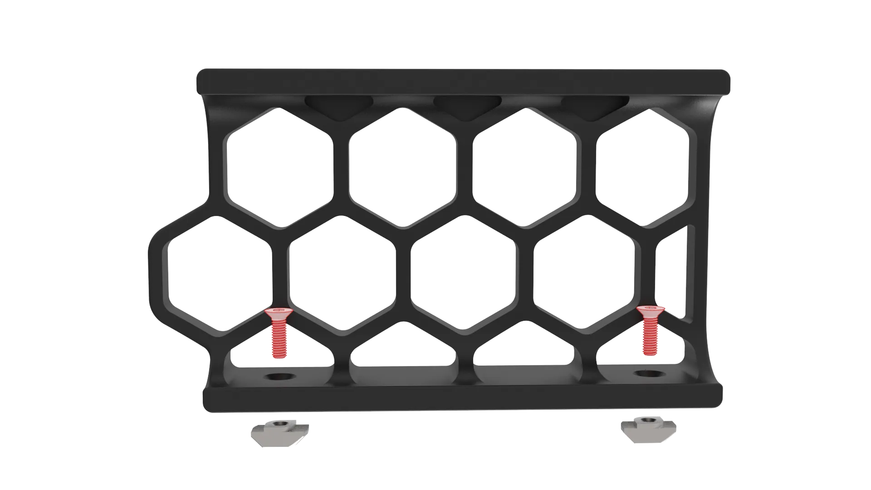
[picture p73: docs/delta/2/19.webp]
   

3.<strong>M3*8 沉头螺丝</strong>拧上即可，无需拧紧。
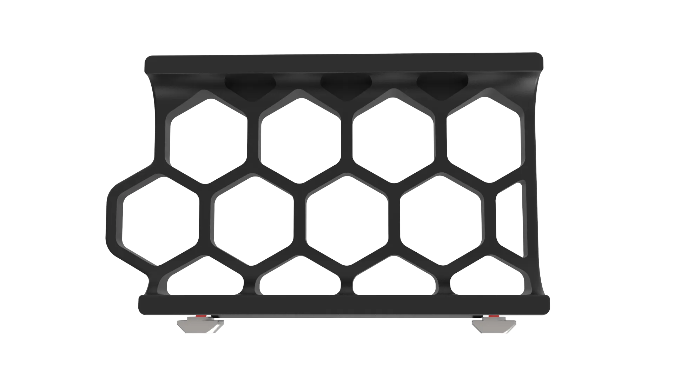
[picture p74: docs/delta/2/20.webp]
      

4.固定到<strong>短铝型材</strong>上。
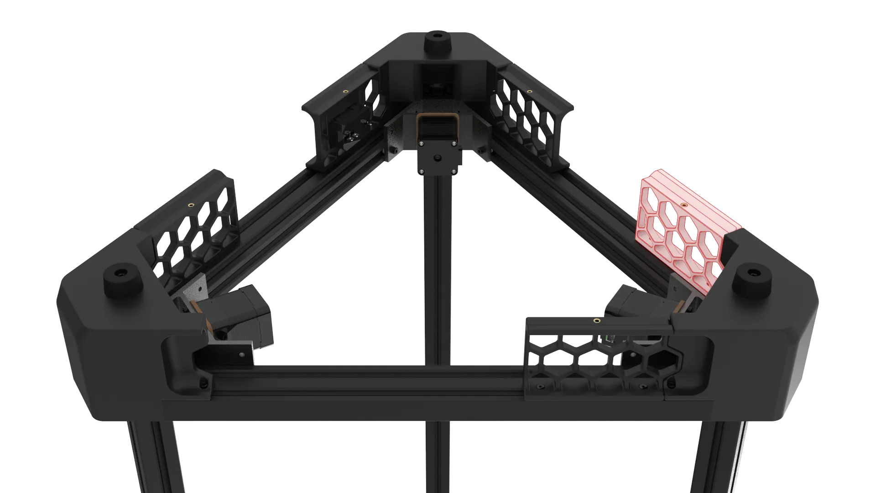
[picture p75: docs/delta/2/21.webp]
   

5.另外一组安装方法相同。
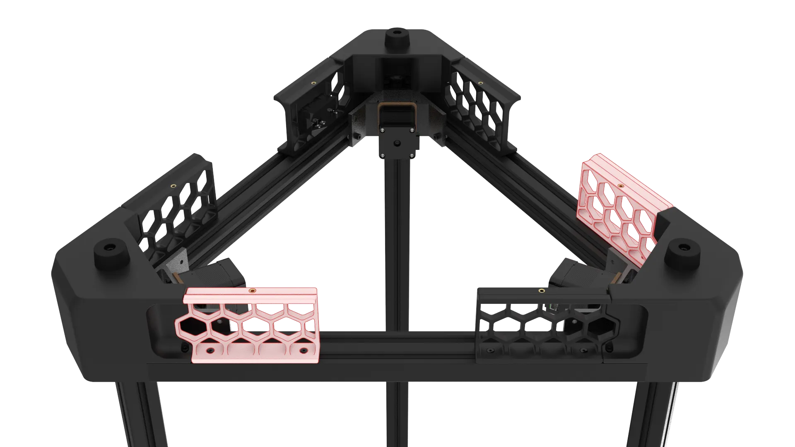
[picture p76: docs/delta/2/22.webp]
   

## 5.两侧裙边

### 所需物料

1.M3*8 沉头螺丝 * 4
   

2.滚花螺母 * 4
   

3.船型螺母20型-M3 * 4
   

### 打印零件

1.[中间裙边打印件] * 2
[中间裙边打印件]: dy5.stl
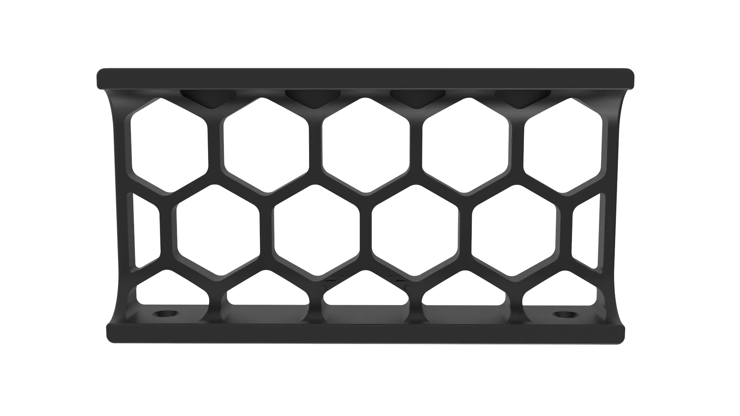
[picture p77: docs/delta/2/dy5.webp]
   

### 组装流程

1.使用烙铁将<strong>滚花螺母</strong>压入<strong>中间裙边打印件</strong>中。
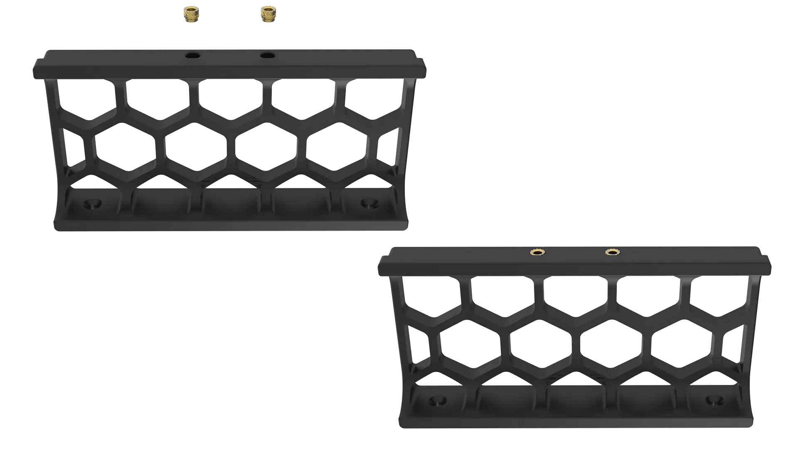
[picture p78: docs/delta/2/23.webp]
   

2.将<strong>M3*8 沉头螺丝</strong>穿过<strong>中间裙边打印件</strong>并套上<strong>船型螺母20型-M3</strong>。
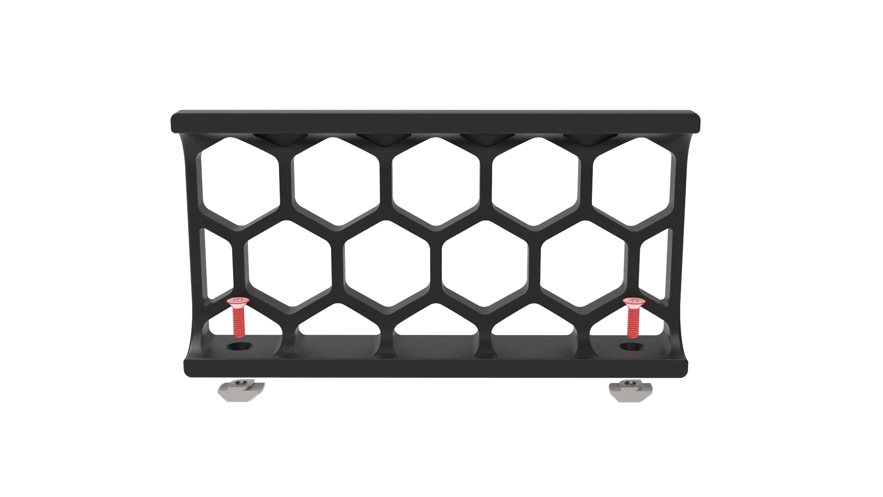
[picture p79: docs/delta/2/24.webp]
   

3.<strong>M3*8 沉头螺丝</strong>拧上即可，无需拧紧。
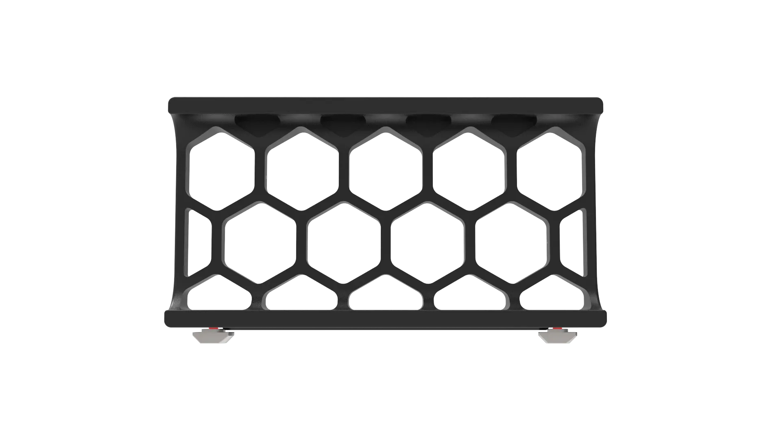
[picture p80: docs/delta/2/25.webp]
      

4.固定到<strong>短铝型材</strong>上。
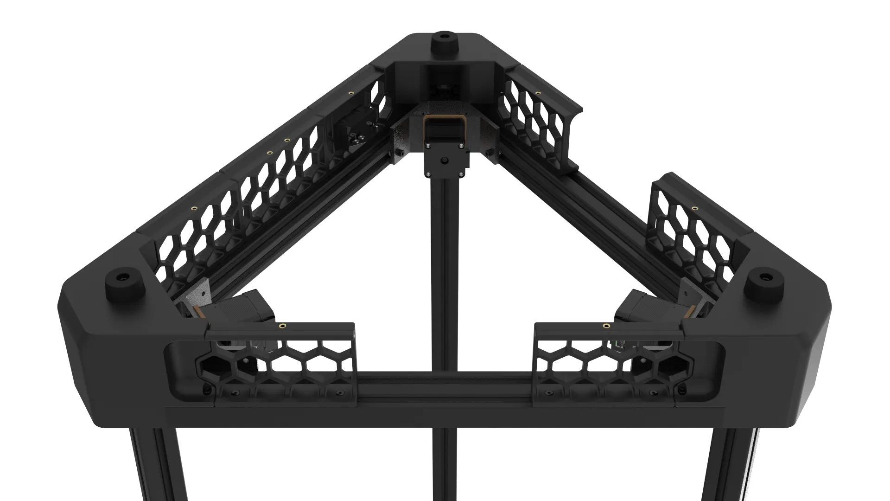
[picture p81: docs/delta/2/26.webp]
   

5.另外一组安装方法相同。
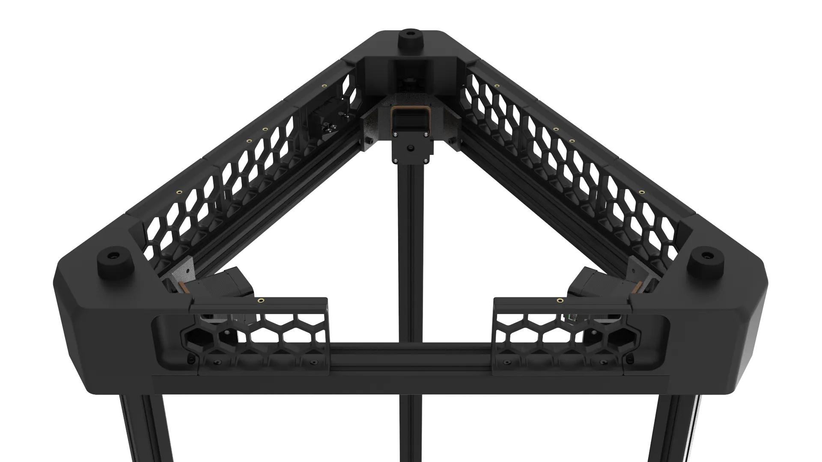
[picture p82: docs/delta/2/27.webp]
   

!!! info "注意开关的所在位置"
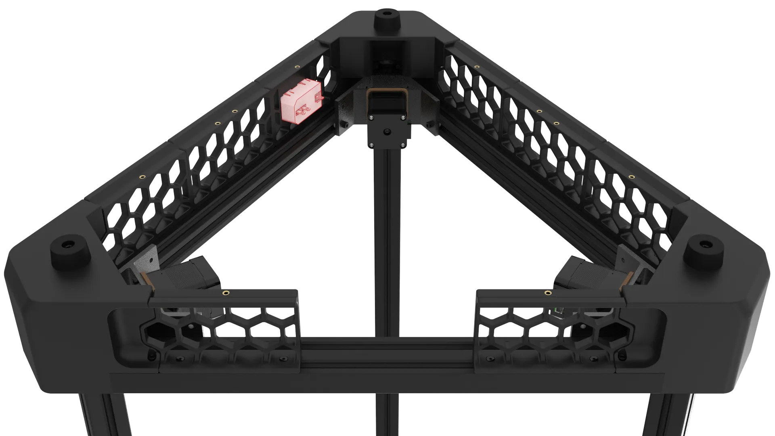
[picture p83: docs/delta/2/28.webp]
    

## 6.触摸屏幕

### 所需物料
1.触摸屏 * 1
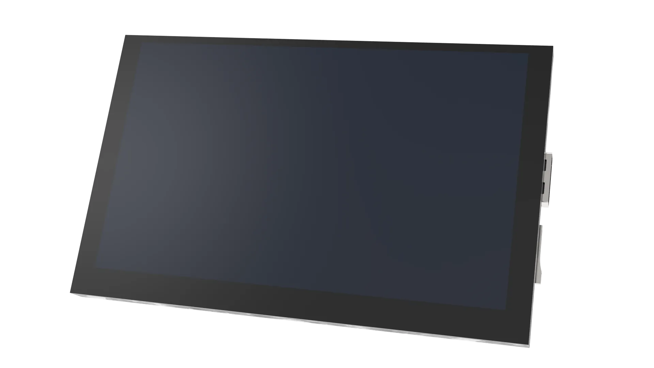
[picture p84: docs/delta/2/cmp.webp]
   

2.M3*8 沉头螺丝 * 2
   

3.滚花螺母 * 2
   

4.船型螺母20型-M3 * 2
   

### 打印零件

1.[屏幕固定件] * 1
[屏幕固定件]: dy6.stl
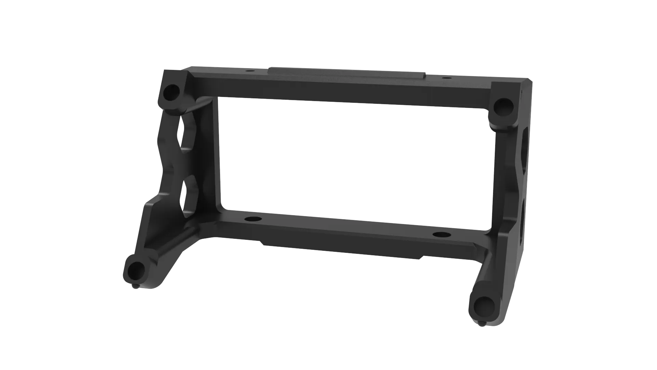
[picture p85: docs/delta/2/dy6.webp]
   
   
2.[屏幕前框] * 1
[屏幕前框]: dy7.stl
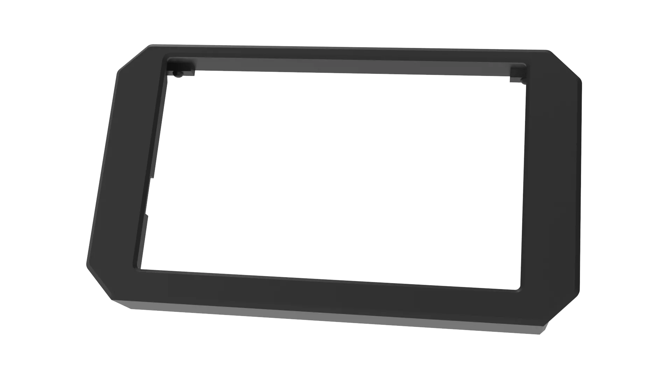
[picture p86: docs/delta/2/dy7.webp]
   

### 组装流程

1.使用烙铁将<strong>滚花螺母</strong>压入<strong>屏幕固定件</strong>中。
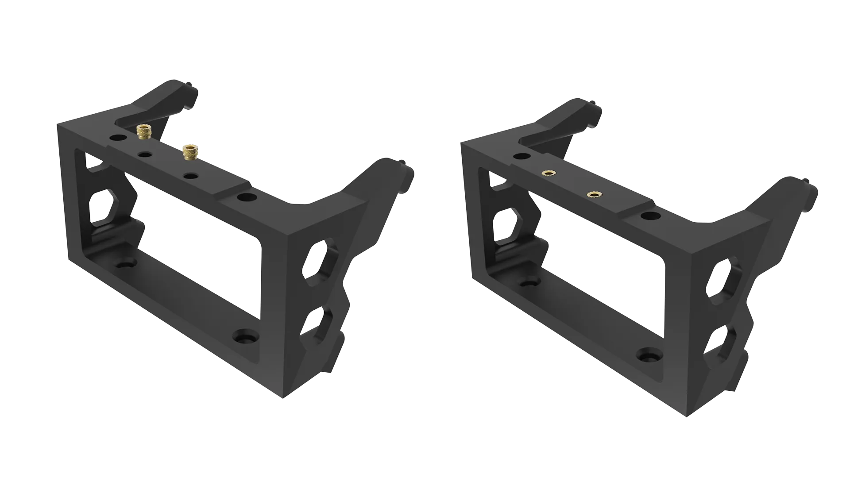
[picture p87: docs/delta/2/29.webp]
   

2.将<strong>M3*8 沉头螺丝</strong>穿过<strong>屏幕固定件</strong>并套上<strong>船型螺母20型-M3</strong>。
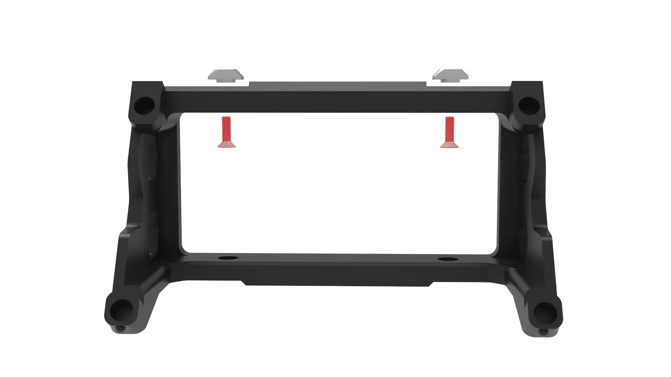
[picture p88: docs/delta/2/30.webp]
   

3.<strong>M3*8 沉头螺丝</strong>拧上即可，无需拧紧。
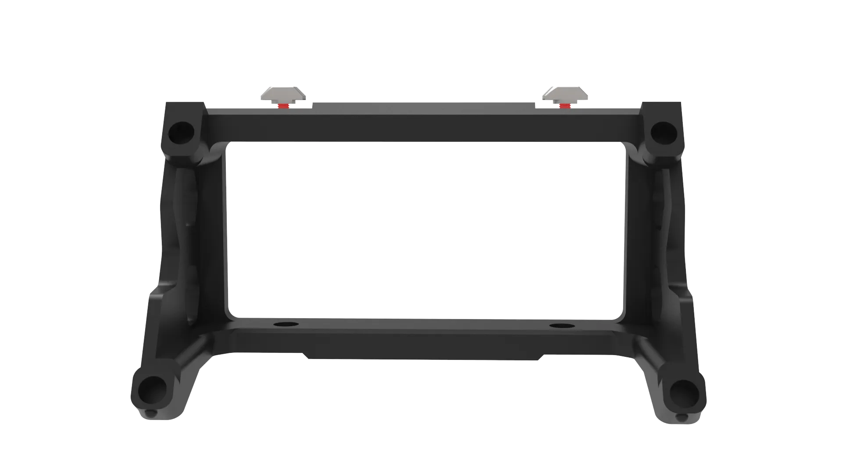
[picture p89: docs/delta/2/31.webp]
   

4.将<strong>触摸屏</strong>如图所示装入到<strong>屏幕固定件</strong>中。
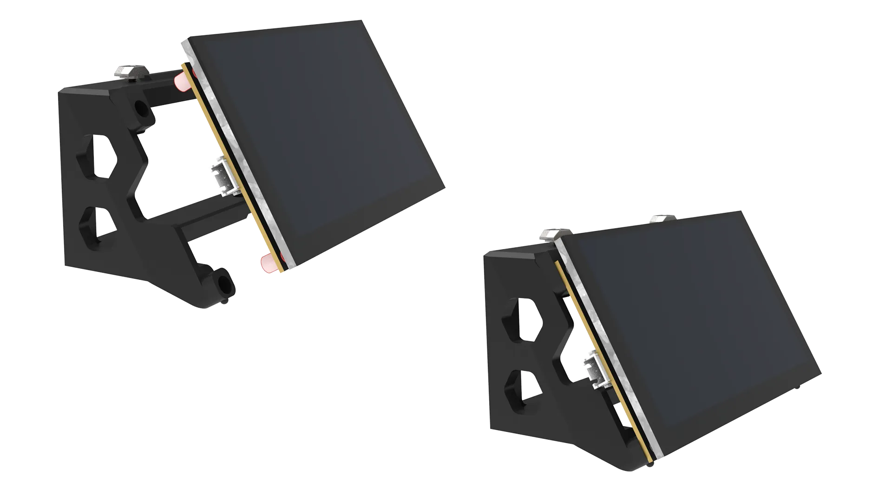
[picture p90: docs/delta/2/32.webp]
   

5.将<strong>屏幕前框</strong>扣入到屏幕上，注意角度，不要太过用力以免损坏屏幕。
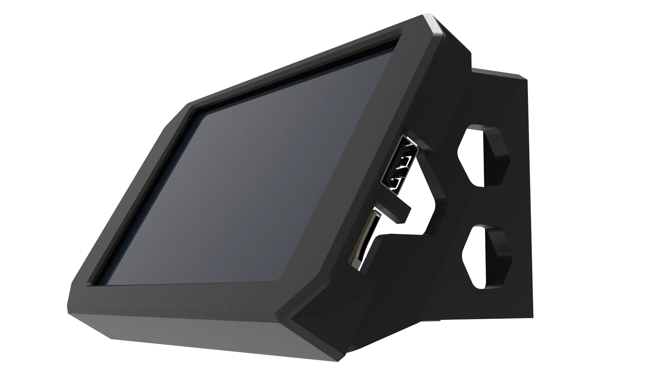
[picture p91: docs/delta/2/33.webp]
   
   
6.正确卡入时，<strong>屏幕前框</strong>应与<strong>屏幕固定件</strong>的卡扣相互扣合。
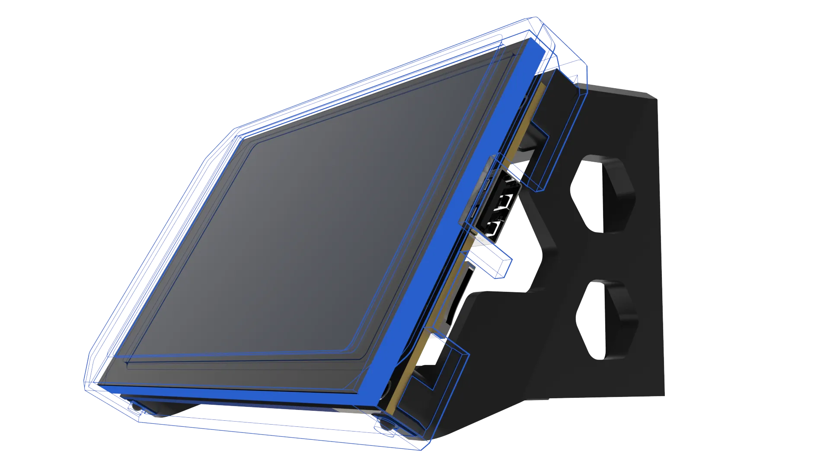
[picture p92: docs/delta/2/34.webp]
   

7.固定到<strong>短铝型材</strong>上。
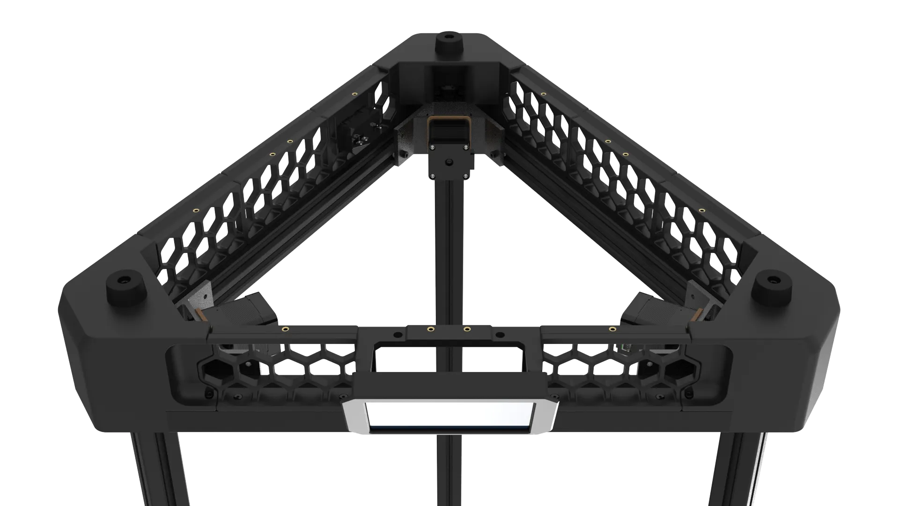
[picture p93: docs/delta/2/35.webp]
   

## 7.电器固定

### 所需物料
1.底部固定板 * 1
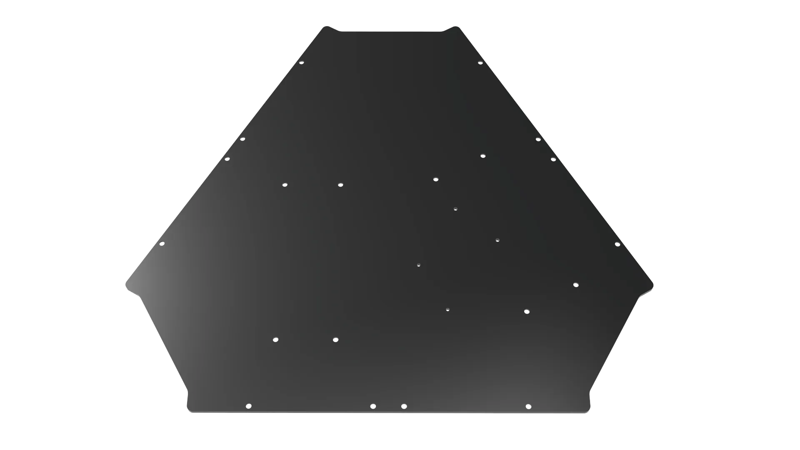
[picture p94: docs/delta/2/36.webp]
   

2.固态继电器 * 1
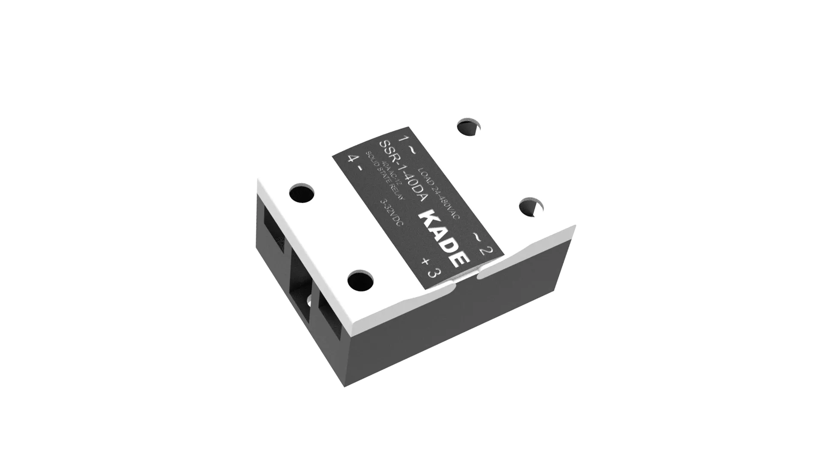
[picture p95: docs/delta/2/jdq.webp]
   

3.开关电源 * 1
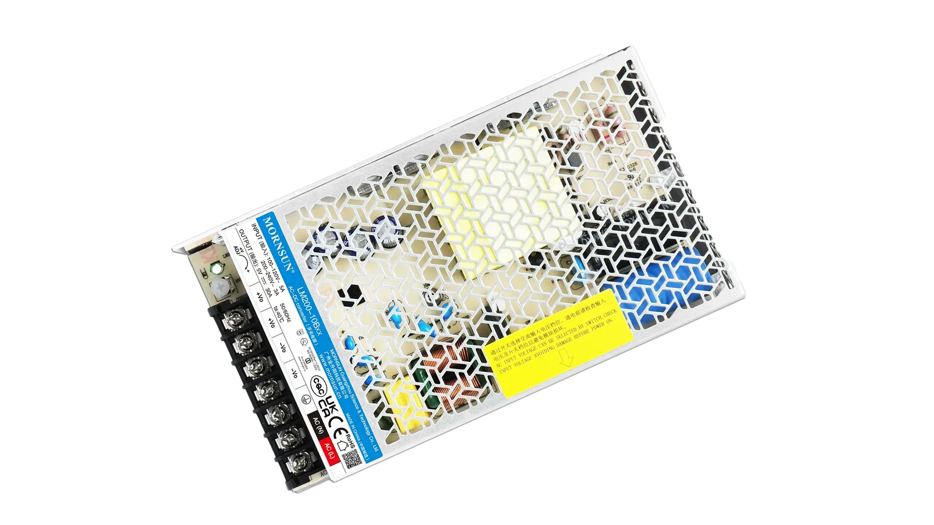
[picture p96: docs/delta/2/dy.webp]
   

4.M3*8 沉头螺丝 * 12
   

5.M3*10 杯头螺丝 * 2
   

6.M4*10 杯头螺丝 * 4
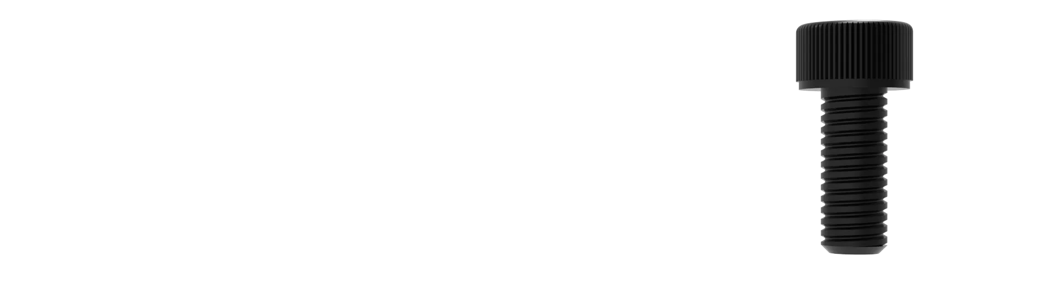
[picture p97: docs/delta/2/M4X10.webp]
   

7.M3自锁螺母 * 2
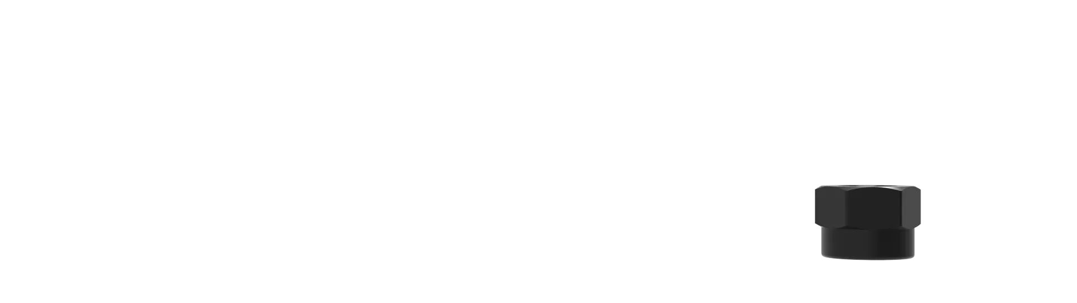
[picture p98: docs/delta/2/zslm.webp]
   

### 组装流程

1.将<strong>开关电源</strong>放置在<strong>底部固定板</strong>上，如图所示。
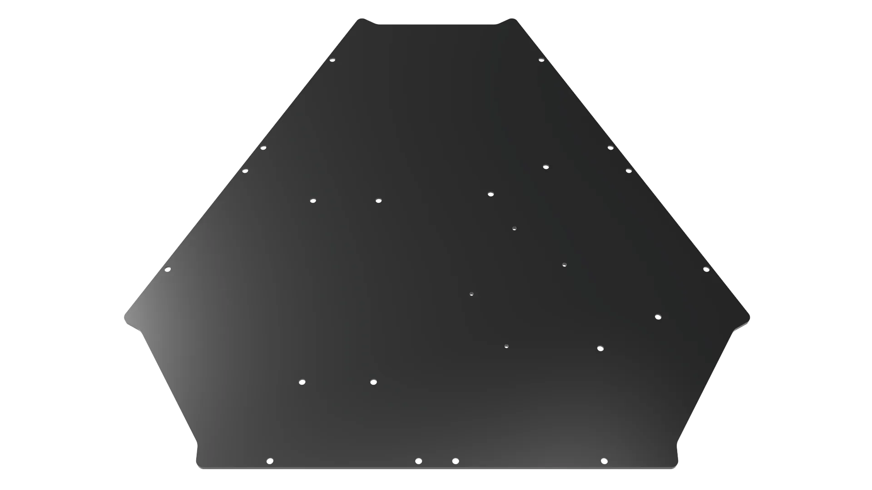
[picture p99: docs/delta/2/37.webp]
   
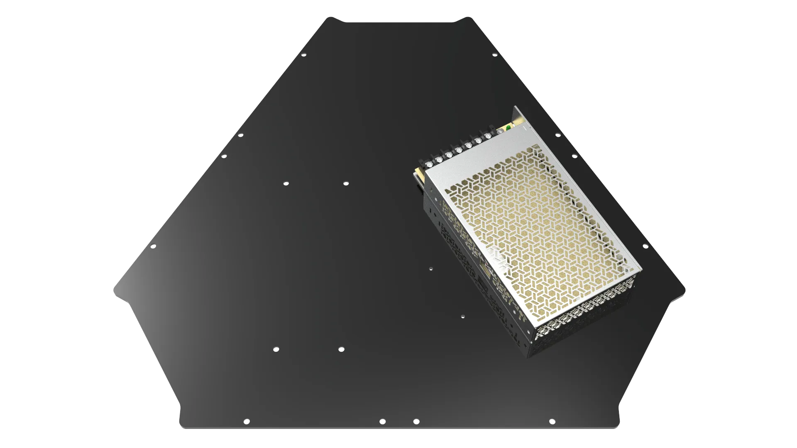
[picture p100: docs/delta/2/38.webp]
   

2.反转后，使用四颗<strong>M4*10 杯头螺丝</strong>进行固定，如图所示。
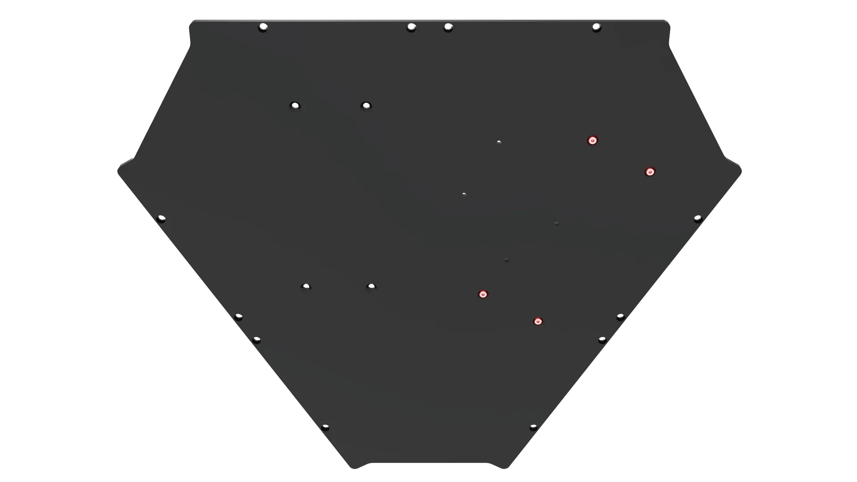
[picture p101: docs/delta/2/39.webp]
   

3.将<strong>固态继电器</strong>放置在<strong>电器固定盖板</strong>上，如图所示。
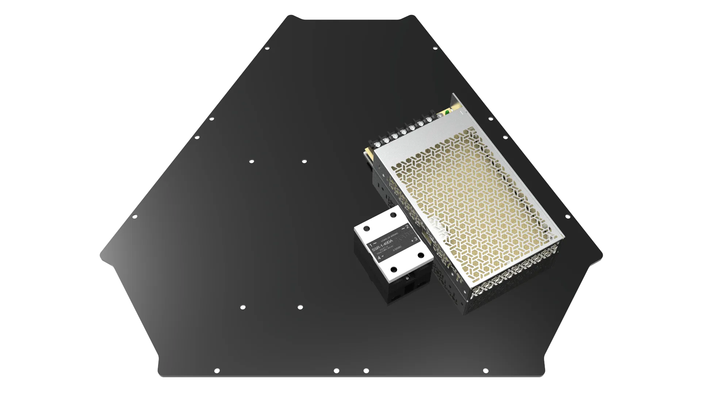
[picture p102: docs/delta/2/40.webp]
   

4.注意<strong>固态继电器</strong>的标识，如图所示。
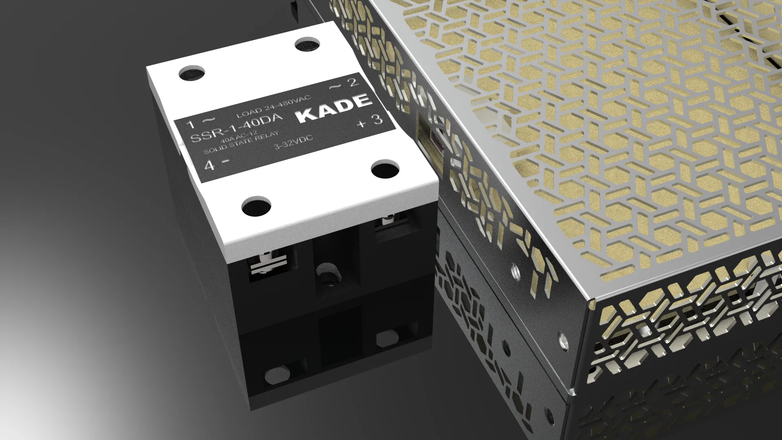
[picture p103: docs/delta/2/41.webp]
   

5.使用两颗<strong>M3*10 杯头螺丝</strong>穿过螺丝孔位。
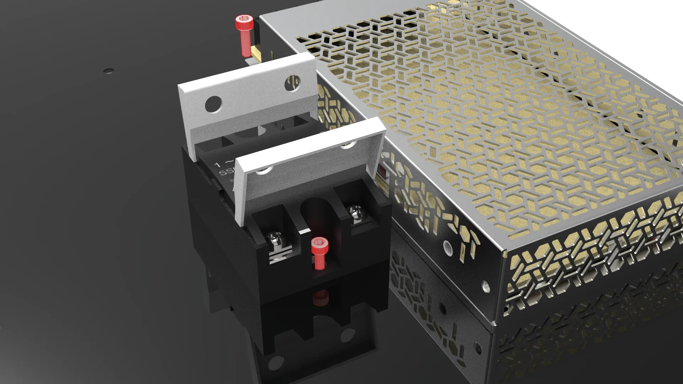
[picture p104: docs/delta/2/42.webp]
   
      
6.反转后使用两颗<strong>M3自锁螺母</strong>进行固定。
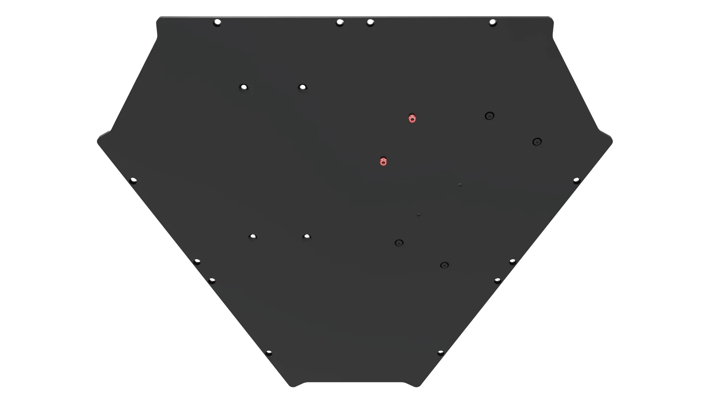
[picture p105: docs/delta/2/43.webp]
   
   
7.使用十二颗<strong>M3*8 沉头螺丝</strong>固定到底部。
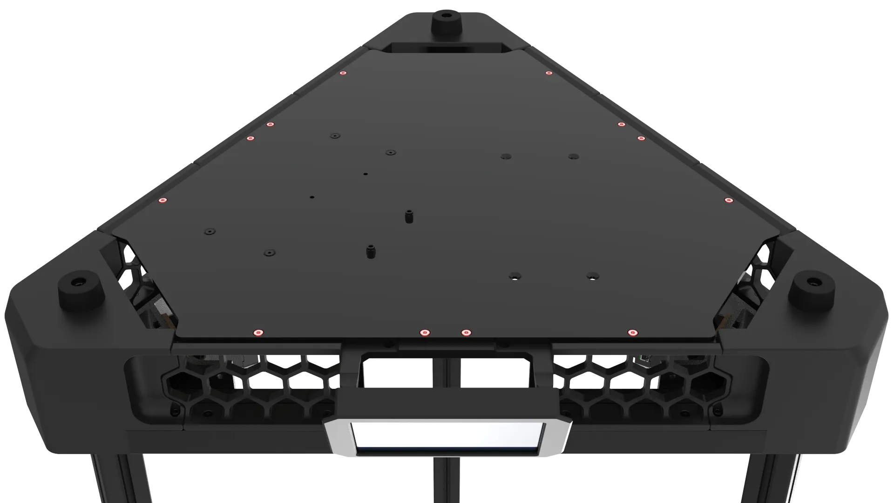
[picture p106: docs/delta/2/44.webp]
   

8.完成后后反转打印机，注意此时<strong>触摸屏</strong>朝前，<strong>开关电源</strong>与<strong>固态继电器</strong>应该右前侧。
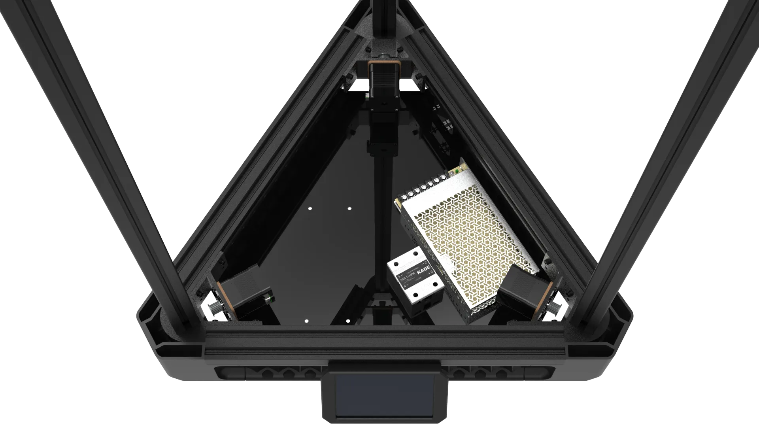
[picture p107: docs/delta/2/45.webp]
   

???- note "预留扩展"
    底部预留的四个孔位可安装第二个高压电源，适配MW与MORNSUN的螺丝孔位，安装方法相同。
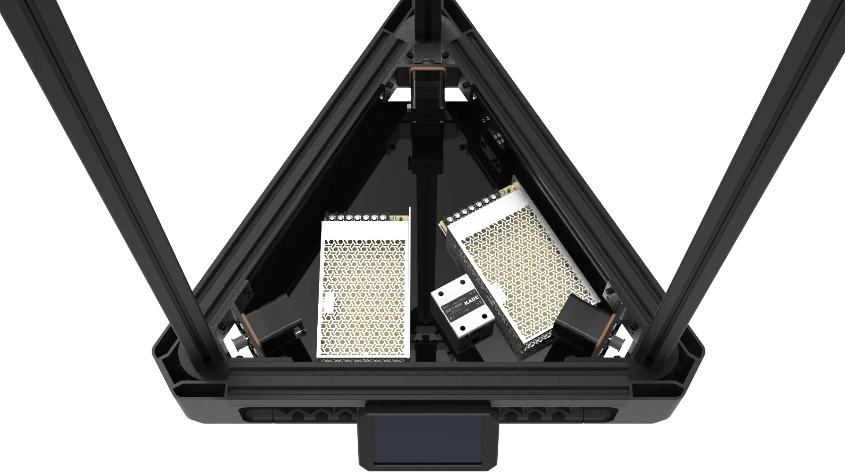
[picture p108: docs/delta/2/46.webp]
    

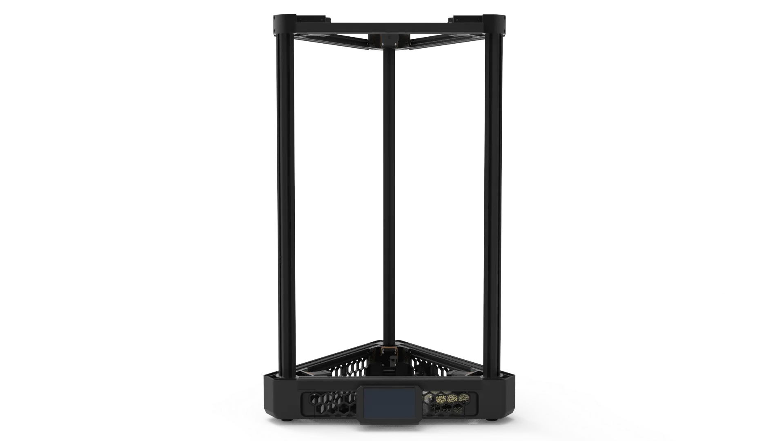
[picture p109: docs/delta/2/47.webp]


???- question "FAQ"

    **Q: 裙边与Voron是否兼容？**

    **A:** 是的，裙边打印件与Voron 3D打印机是兼容的，也可以安装到其他Voron风格的开源3D打印机上。

    **Q: 触摸屏可以装到Voron上么？**

    **A:** 是的，触摸屏与Voron 3D打印机是兼容的，也可以安装到其他任何使用2020铝型材的3D打印机上。

    **Q: 打印件放在框架下面晃动会影响打印精度么？**

    **A:** 不会，刚性骨架承重、柔性、易换件做功能与安装面，在高速、高温、高加速度场景下，稳定性、精度、维护性全面占优，避免打印件长期受力蠕变、高温软化导致框架失稳、平面度变差，金属框架高强度连接保证高温、震动下几乎永不松脱，打印件在下可减震、降噪、不共振，避免金属直接硬接触导致的高频振纹、层纹、边角拉丝问题，同时打印件自由度高可扩展可改装，所有打印件均能本机自己打印。
