micromake/micromake.github.io/docs/delta/5/5.md

---
title: 吊台组装
---

## 0.注意事项

!!! warning "螺丝固定"
    螺丝固定打印件时，不要拧的过紧，以免拧坏打印件。
    
    螺丝需要涂抹螺纹胶,  需要涂抹螺纹胶的螺丝使用<strong><span style="color:#295FCC">蓝色</span></strong>显示：
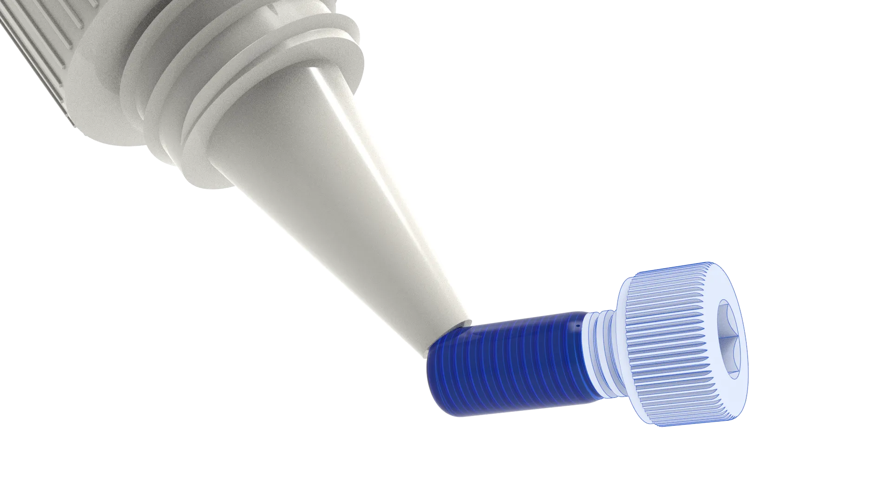
[picture p135: docs/delta/5/ls1.webp]
    
    
!!! info "嵌入螺母"
    部分打印件需借助烙铁压入<strong>滚花螺母</strong>：
    

???+ tip "安装建议"
    固定<strong>自锁螺母</strong>时，建议使用扳手辅助固定：
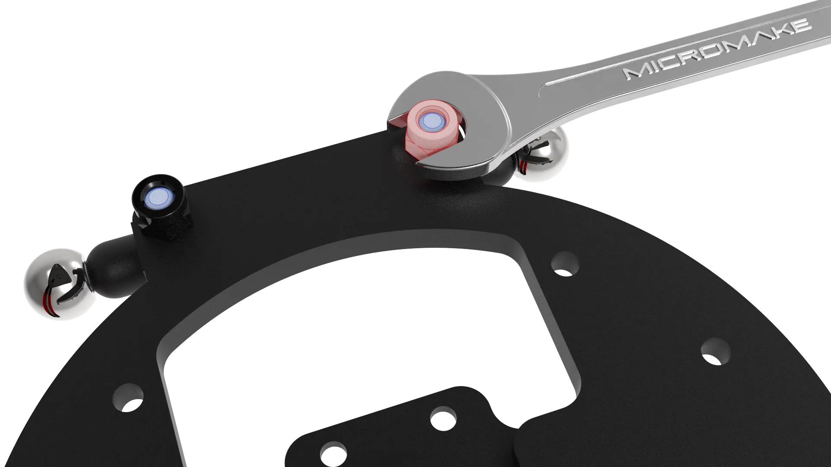
[picture p136: docs/delta/5/bs.webp]
    
    没有螺纹的打印件,使用电动工具安装会更轻松：
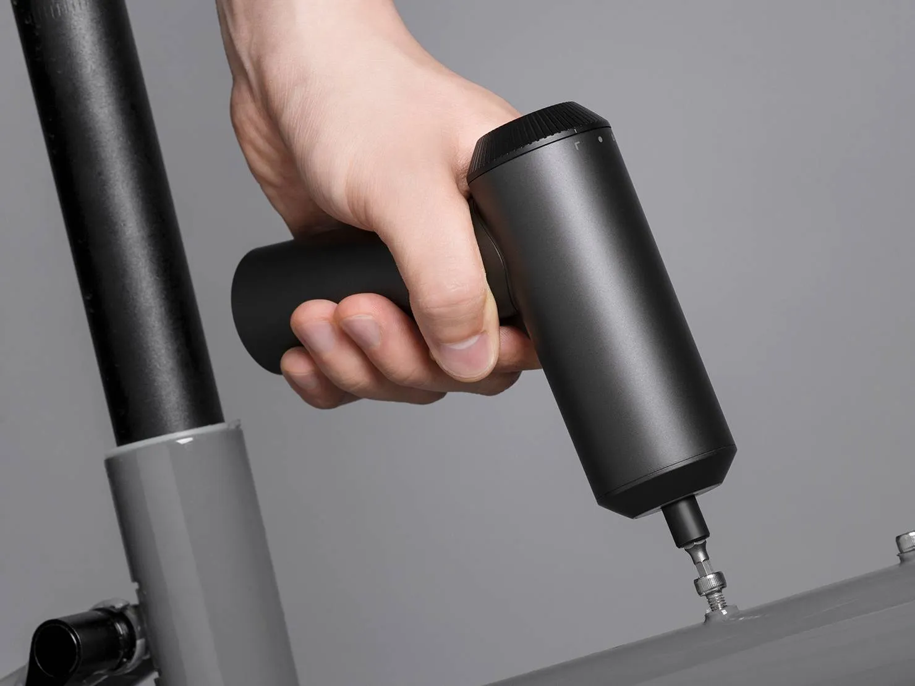
[picture p137: docs/delta/5/ddgj.webp]
    

## 1.热端组装

### 所需物料

1.金属吊台 * 1
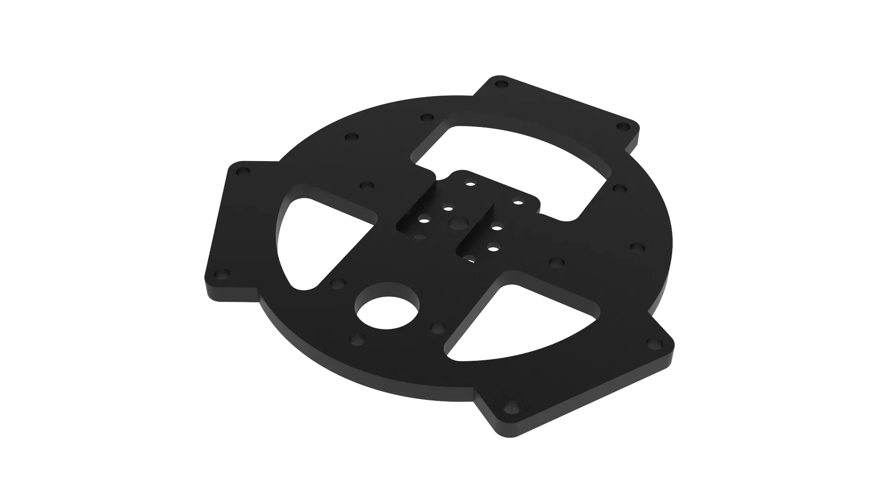
[picture p138: docs/delta/5/dt.webp]
   

2.金属球头连接件 * 3
   

3.打印头组件 * 1
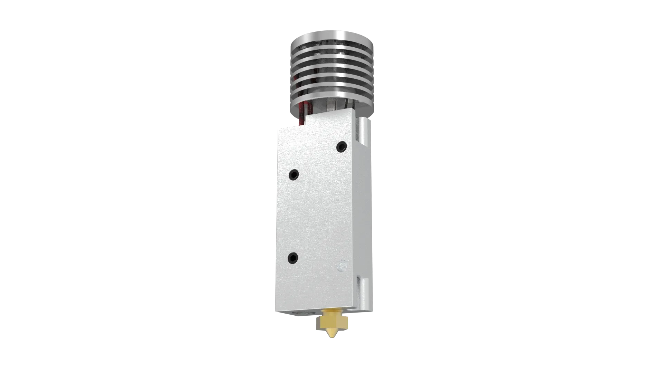
[picture p139: docs/delta/5/dyt.webp]
   

4.四氟管 * 1
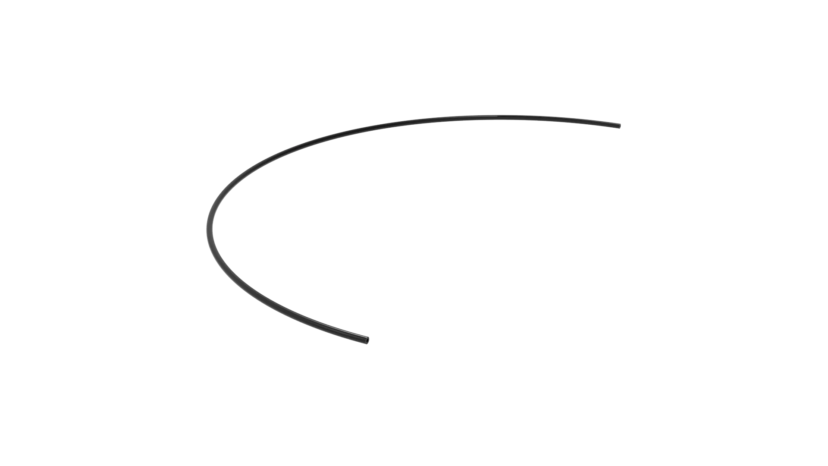
[picture p140: docs/delta/5/sfg.webp]
   

5.M2.5*6 杯头螺丝 * 4
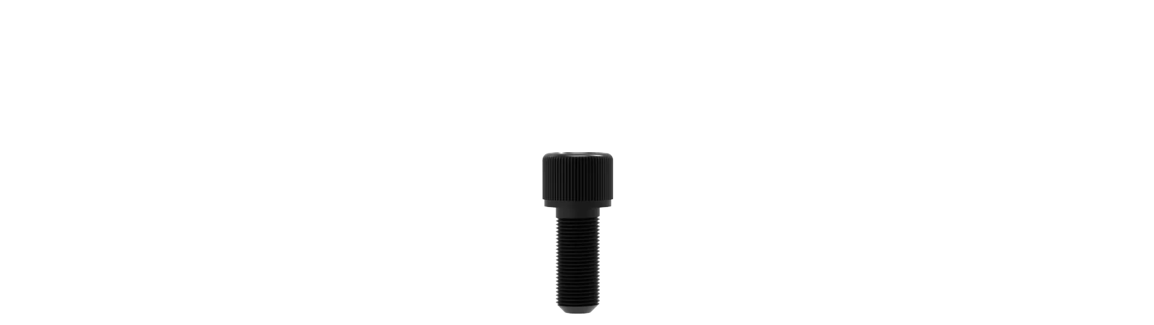
[picture p141: docs/delta/5/M2.5X6.webp]
   

6.M3*10 杯头螺丝 * 6
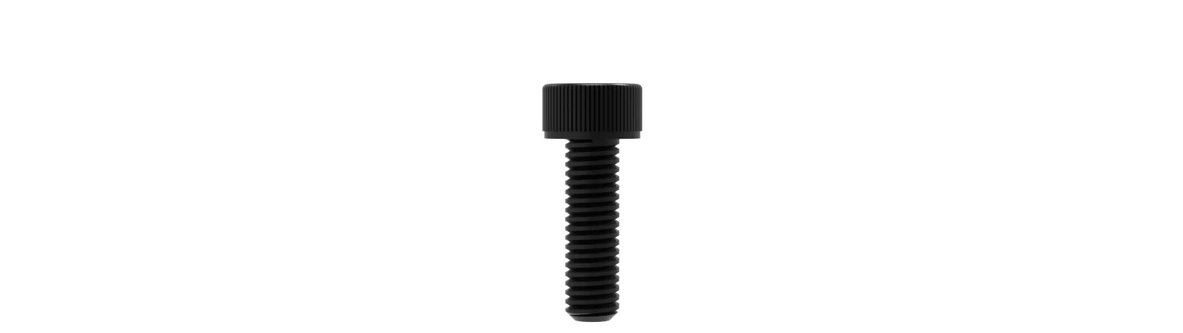
[picture p142: docs/delta/5/M3X10.webp]
   

7.自锁螺母 * 6
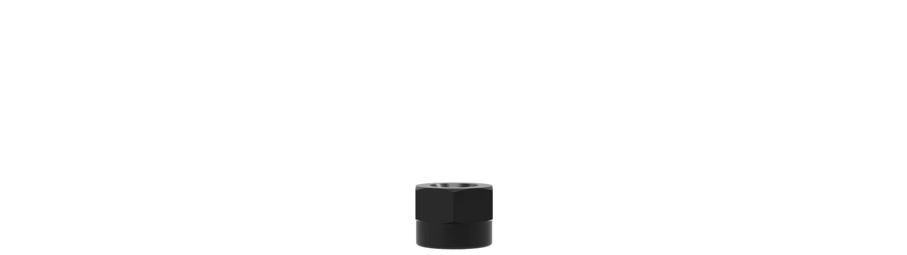
[picture p143: docs/delta/5/zslm.webp]
   

### 组装流程

1.将两颗<strong>M3*10 杯头螺丝</strong>丝插入<strong>金属球头连接件</strong>中，如图所示。
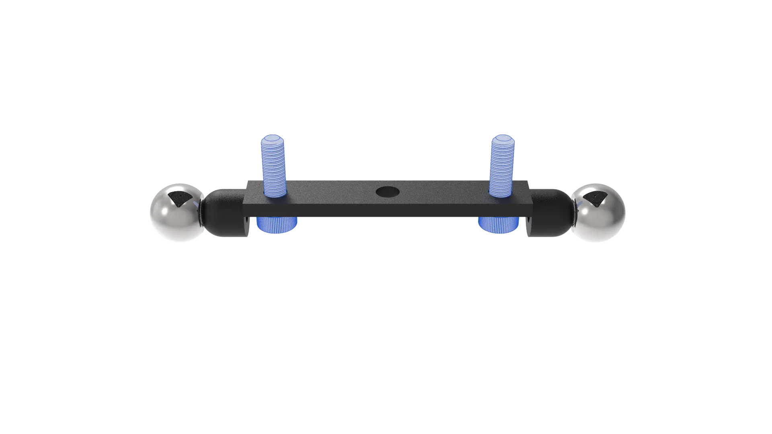
[picture p144: docs/delta/5/1.webp]
   

2.<strong>M3*10 杯头螺丝</strong>需要涂抹螺纹胶，插入到<strong>金属吊台</strong>上，使用两颗<strong>自锁螺母</strong>锁紧。
   
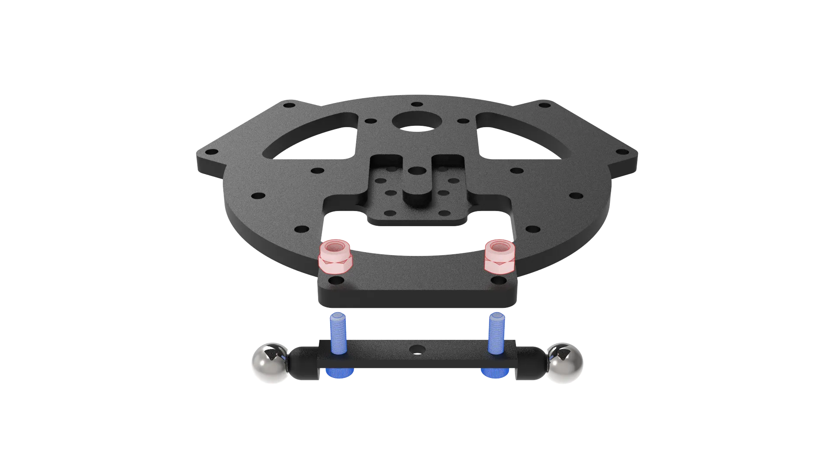
[picture p145: docs/delta/5/2.webp]
   

3.请务必锁紧，可使用扳手进行辅助固定。
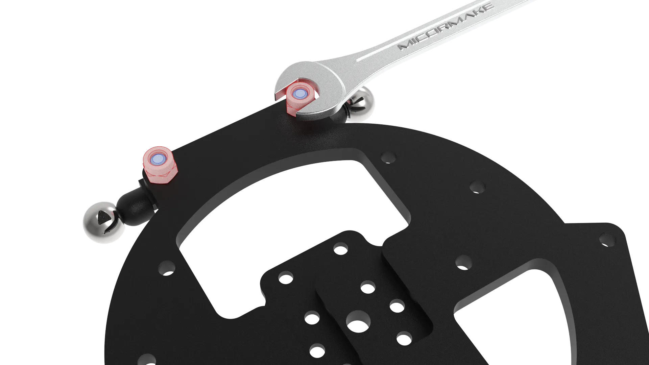
[picture p146: docs/delta/5/3.webp]
   
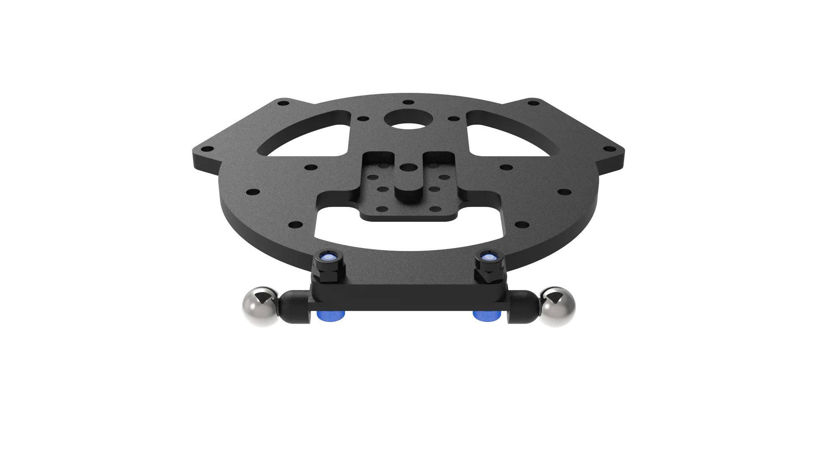
[picture p147: docs/delta/5/4.webp]
   

4.另外两组安装方法相同。
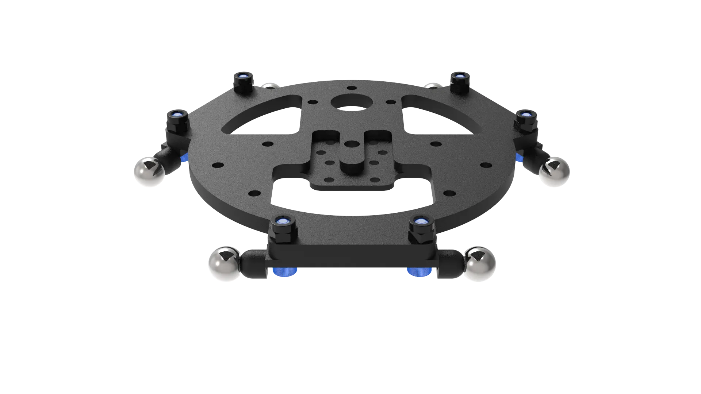
[picture p148: docs/delta/5/5.webp]
   

5.需要将四颗<strong>M2.5*6 杯头螺丝</strong>涂抹螺纹胶。
   
   
6.将<strong>四氟管</strong>裁剪出一段<strong>14MM</strong>长度的短管。
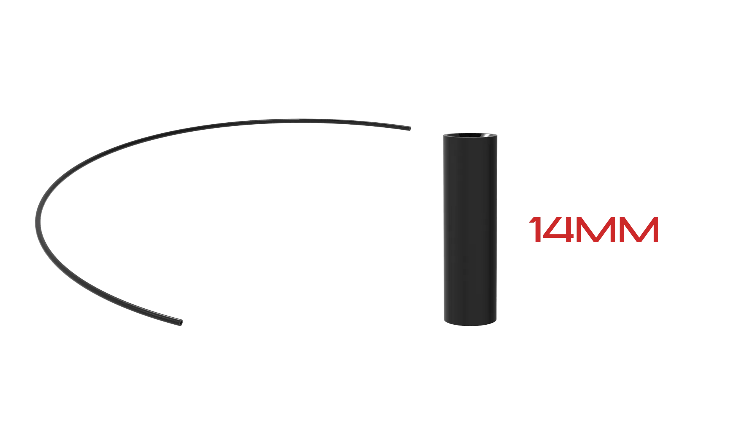
[picture p149: docs/delta/5/6.webp]
   

7.使用短管作为定位参考，如图所示将<strong>打印头组件</strong>与<strong>金属吊台</strong>连接。
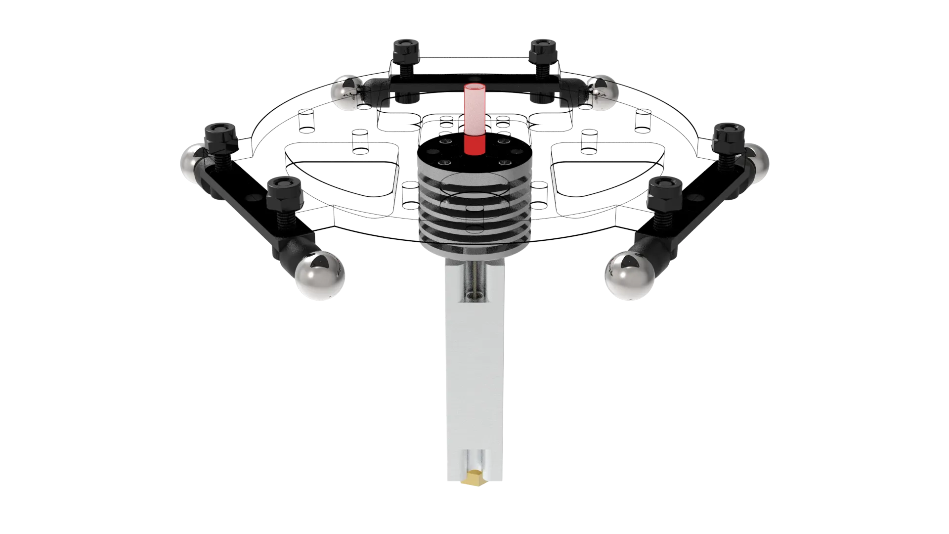
[picture p150: docs/delta/5/7.webp]
   
   
8.使用四颗<strong>M2.5*6 杯头螺丝</strong>穿过<strong>金属吊台</strong>与<strong>打印头组件</strong>固定，需要拧紧。
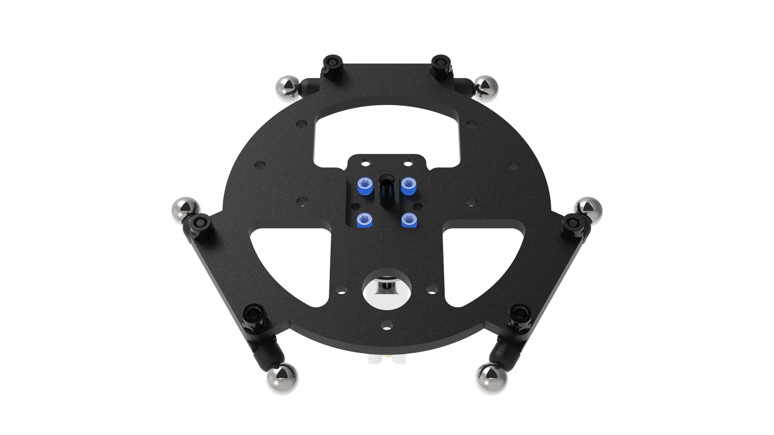
[picture p151: docs/delta/5/8.webp]
   

9.将<strong>打印头组件</strong>的线穿过<strong>金属吊台</strong>，如图所示的孔中。
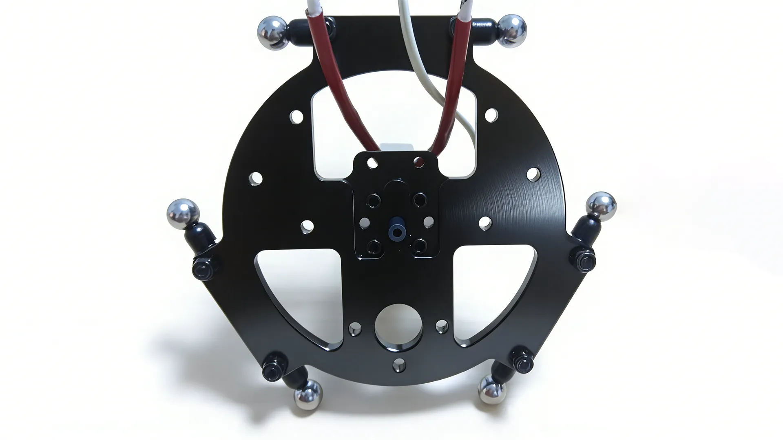
[picture p152: docs/delta/5/9.webp]
   

## 2.挤出组装

### 所需物料

1.挤出机背板 * 1
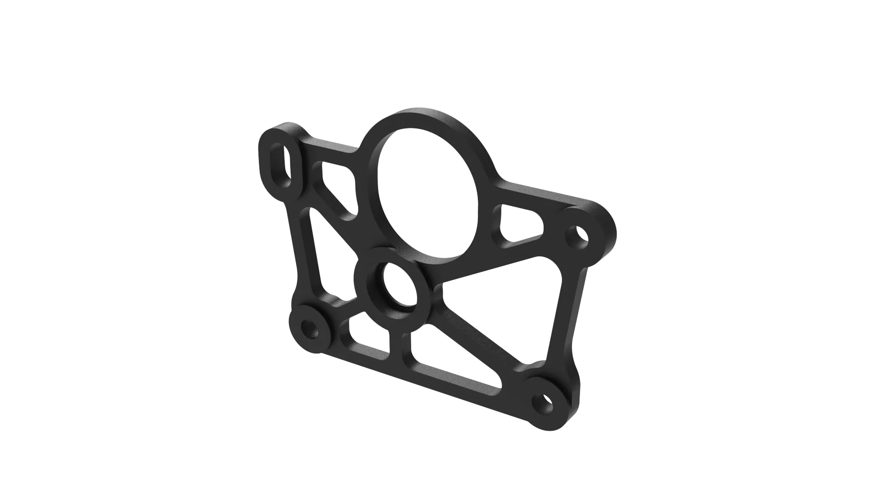
[picture p153: docs/delta/5/jsbb.webp]
   

2.挤出机电机 * 1
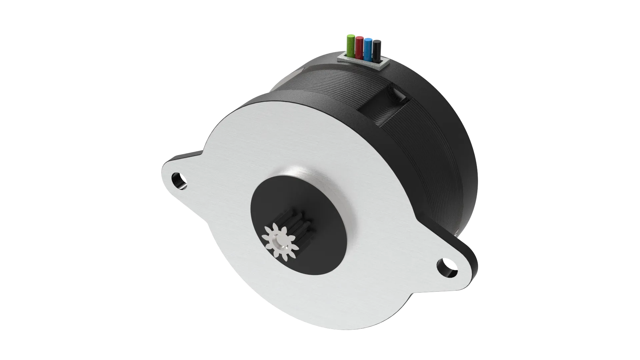
[picture p154: docs/delta/5/jcjdj.webp]
   

3.POM齿轮 * 1
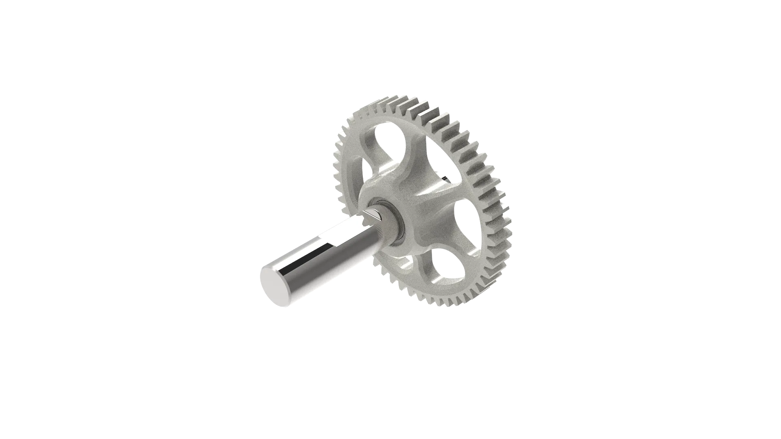
[picture p155: docs/delta/5/pom.webp]
   

4.长光轴 * 1
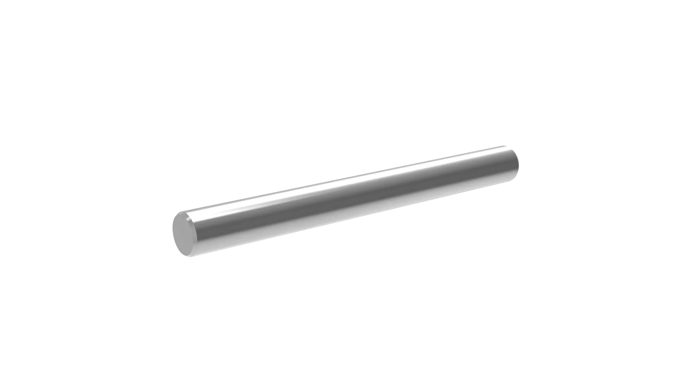
[picture p156: docs/delta/5/cgz.webp]
   

5.短光轴 * 1
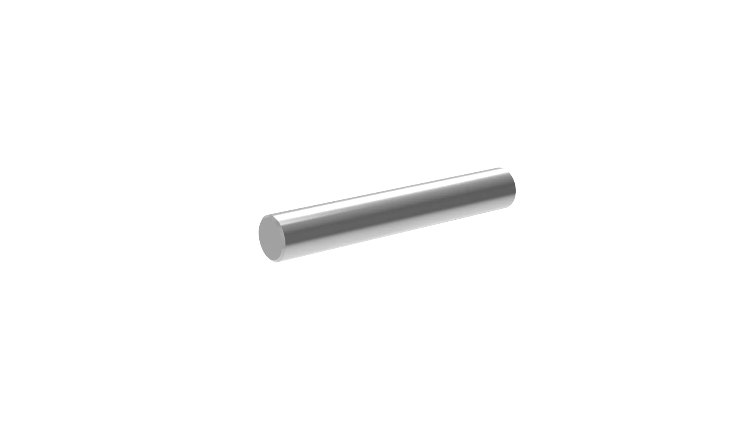
[picture p157: docs/delta/5/dgz.webp]
   

6.同步轮 * 1
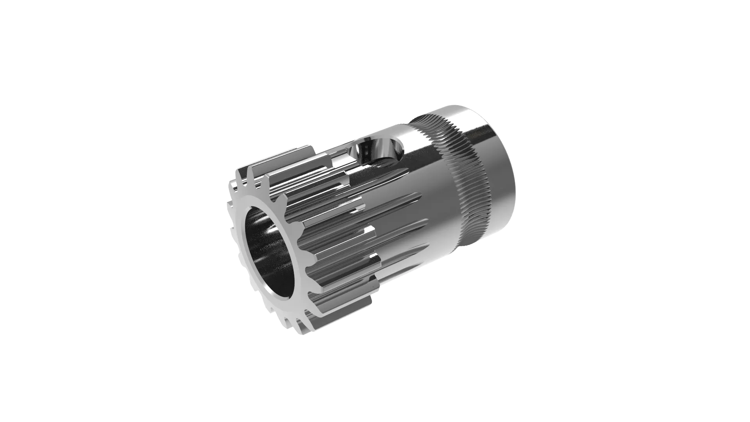
[picture p158: docs/delta/5/tbl.webp]
   

7.顶丝 * 1
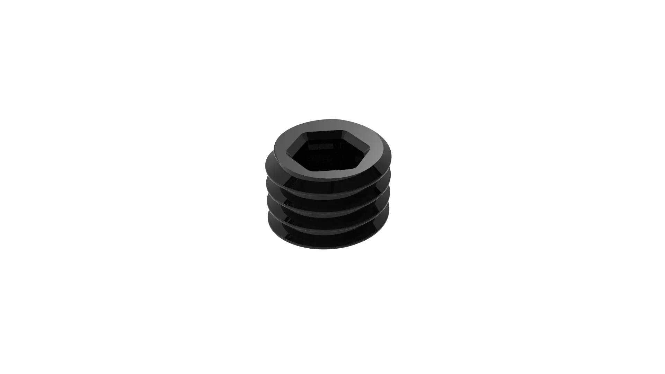
[picture p159: docs/delta/5/ds.webp]
   

8.惰轮 * 1
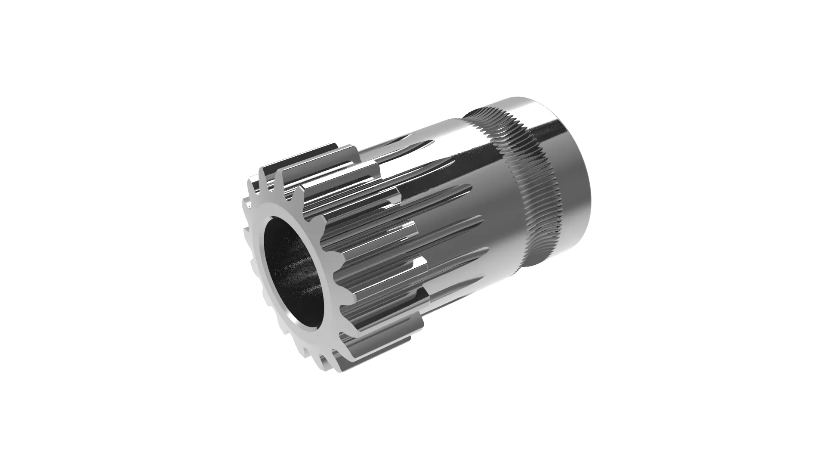
[picture p160: docs/delta/5/dl.webp]
   

9.弹簧 * 1
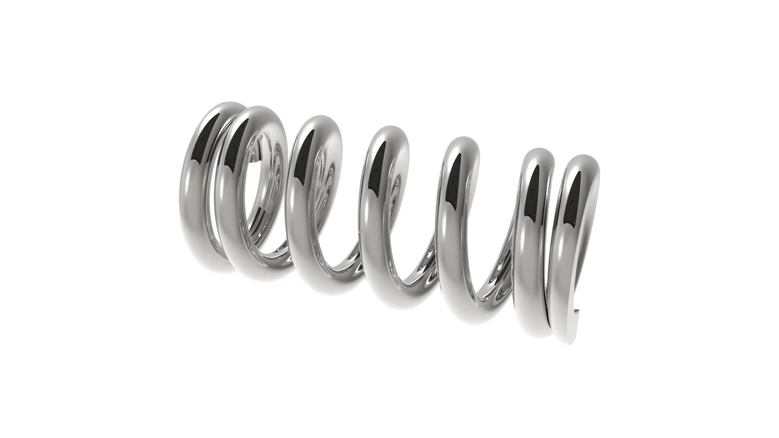
[picture p161: docs/delta/5/th.webp]
    

10.垫片 * 1
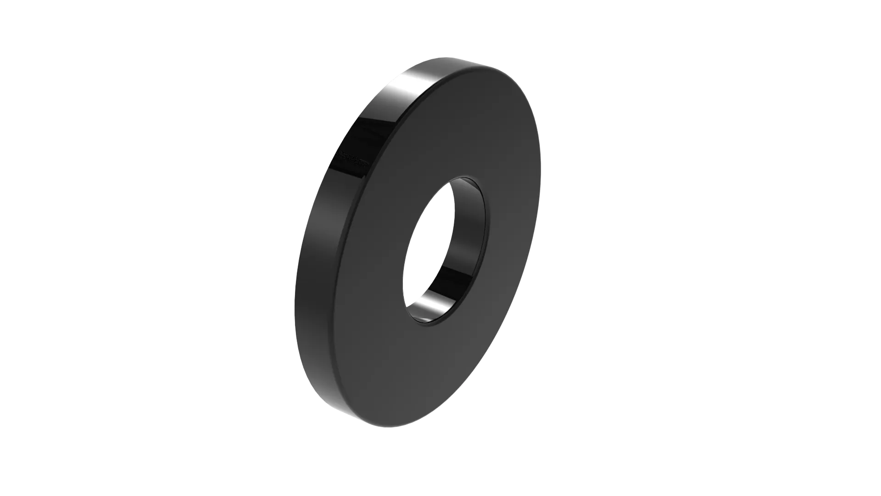
[picture p162: docs/delta/5/dp.webp]
    

11.手拧螺丝 * 1
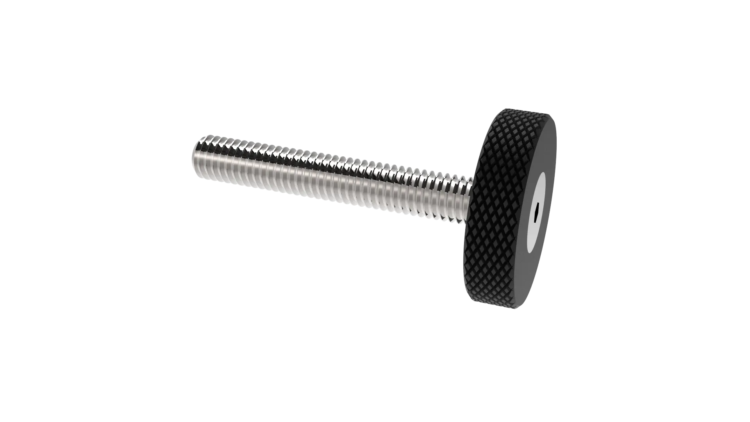
[picture p163: docs/delta/5/snlm.webp]
    

12.MR85轴承 * 2
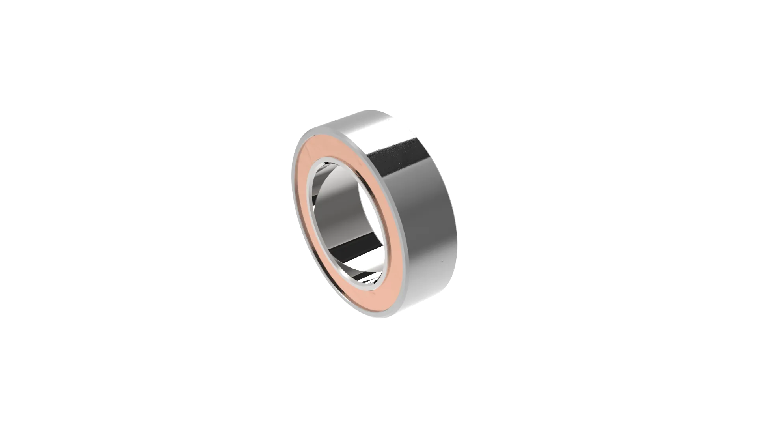
[picture p164: docs/delta/5/mr85.webp]
    

13.滚针轴承 * 2
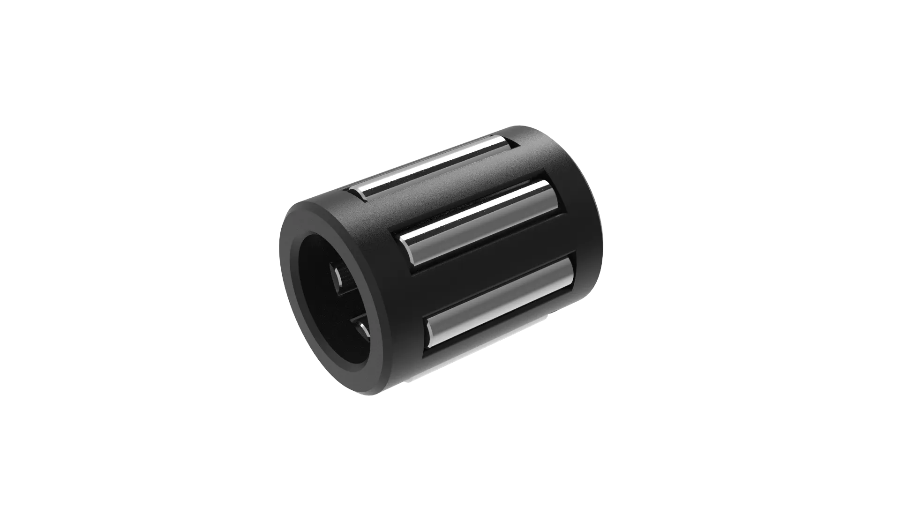
[picture p165: docs/delta/5/gzzc.webp]
    

14.尼龙隔离柱 * 4
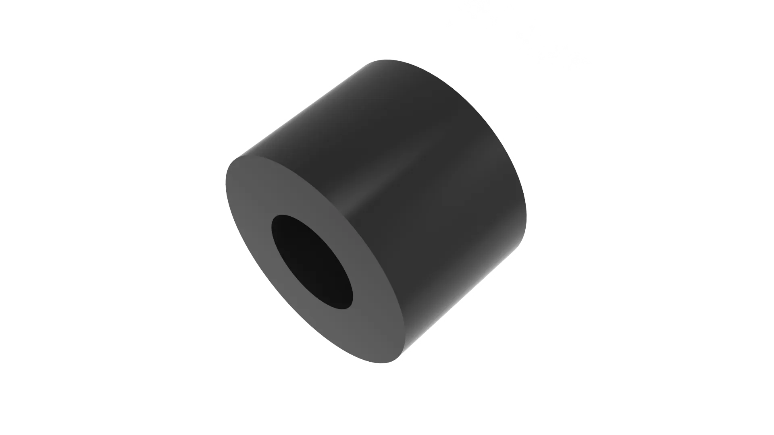
[picture p166: docs/delta/5/glz.webp]
    

15.自锁螺母 * 6
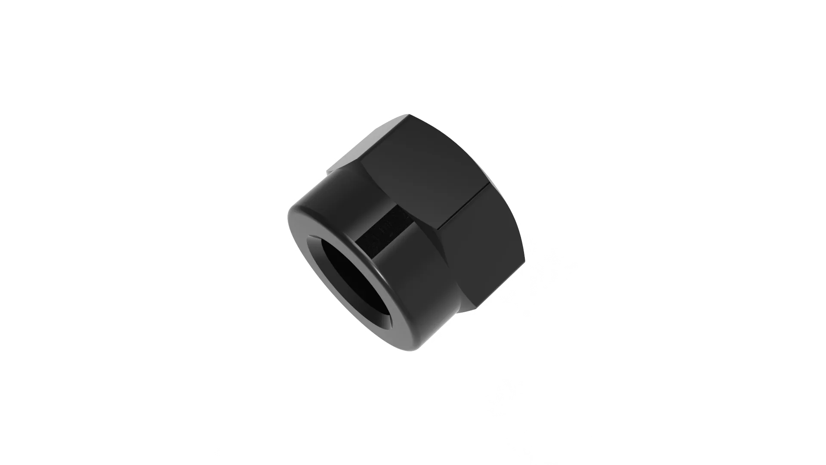
[picture p167: docs/delta/5/zs.webp]
    

16.滚花螺母 * 1
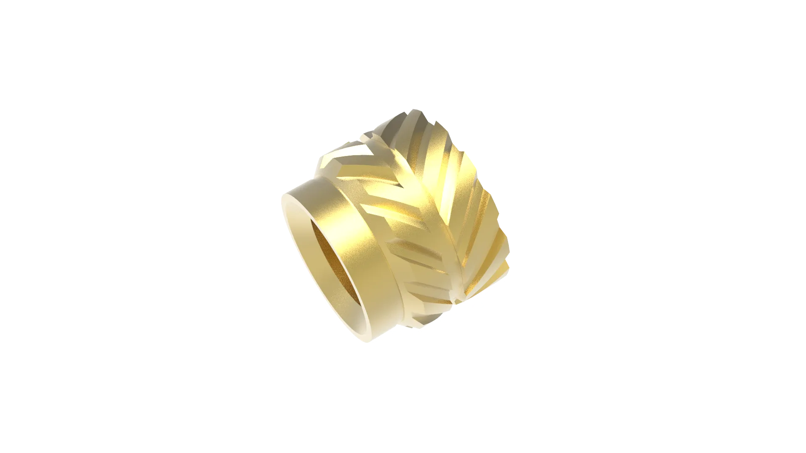
[picture p168: docs/delta/5/gh.webp]
   

17.M3*14 杯头螺丝 * 2
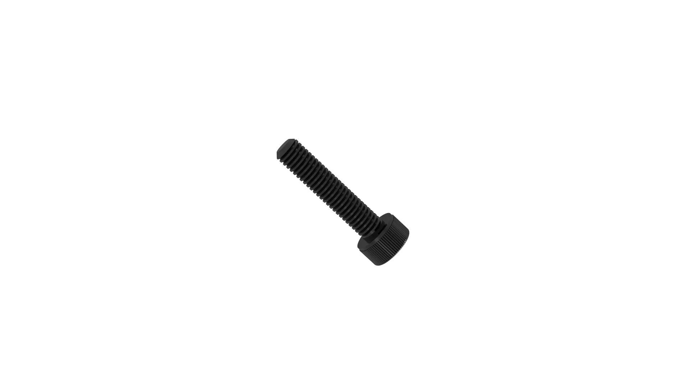
[picture p169: docs/delta/5/m3x14.webp]
    

18.M3*20 杯头螺丝 * 2
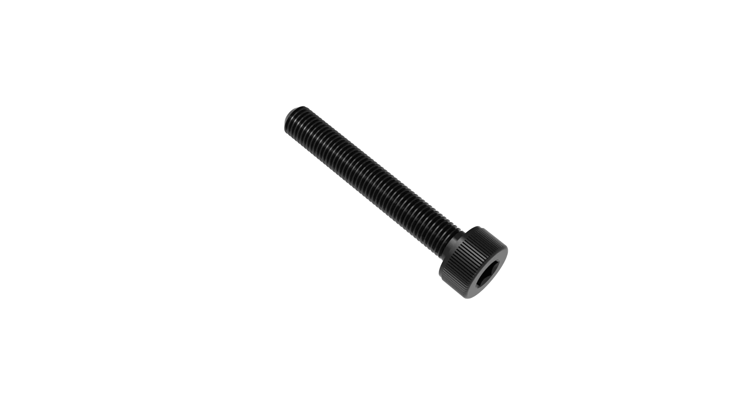
[picture p170: docs/delta/5/m3x20.webp]
    

19.M3*35 圆头螺丝 * 2
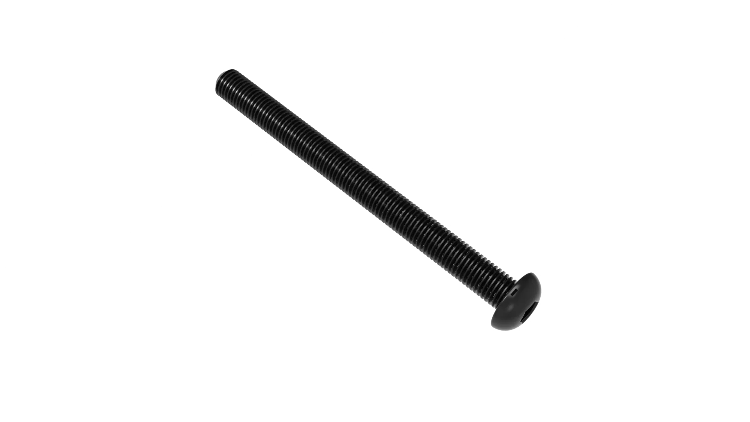
[picture p171: docs/delta/5/m3x35.webp]
    

### 打印零件

1.[挤出机打印件] * 1
[挤出机打印件]: dy1.stl
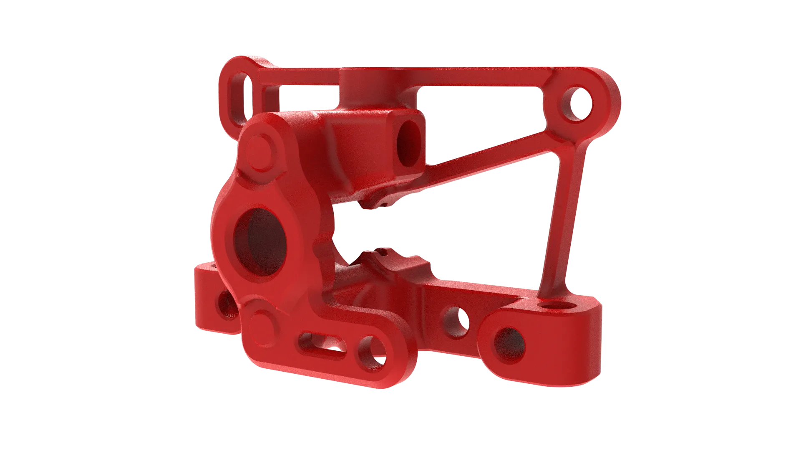
[picture p172: docs/delta/5/dy1.webp]
   

2.[挤出机扳手件] * 1
[挤出机扳手件]: dy2.stl
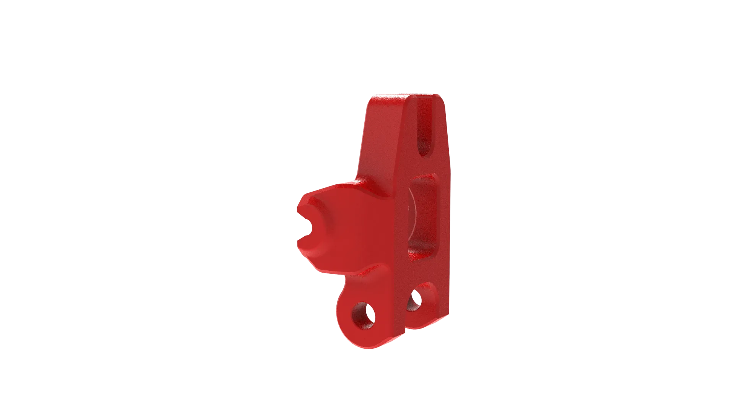
[picture p173: docs/delta/5/dy2.webp]
   

3.[波纹管固定件] * 1
[波纹管固定件]: dy3.stl
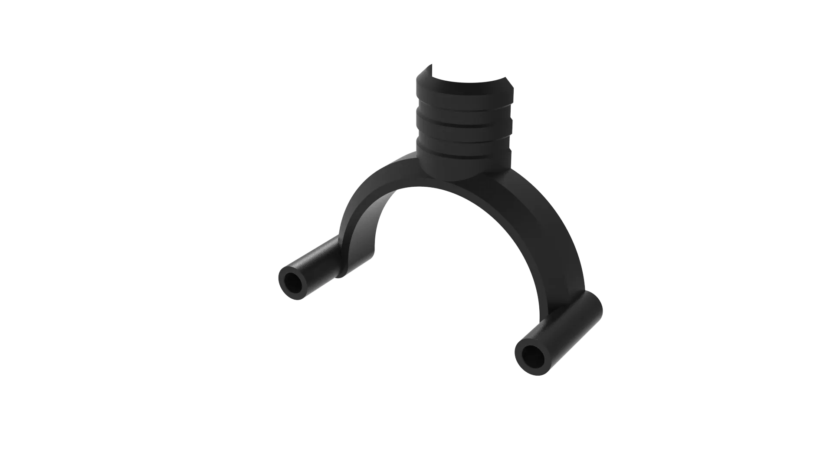
[picture p174: docs/delta/5/dy3.webp]
   

### 组装流程

1.将<strong>MR85轴承</strong>压入<strong>挤出机背板</strong>中，如图所示。
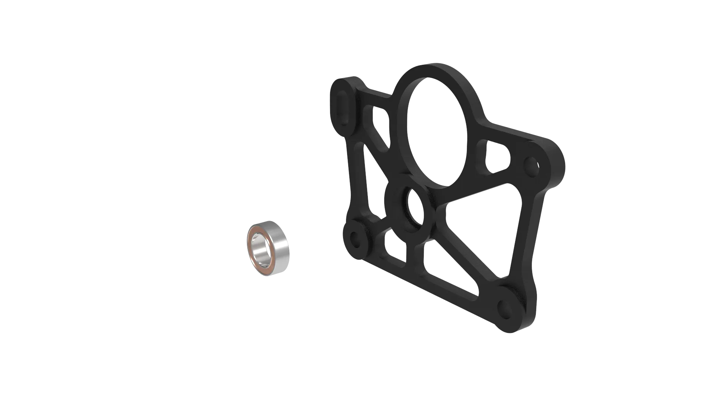
[picture p175: docs/delta/5/10.webp]
   
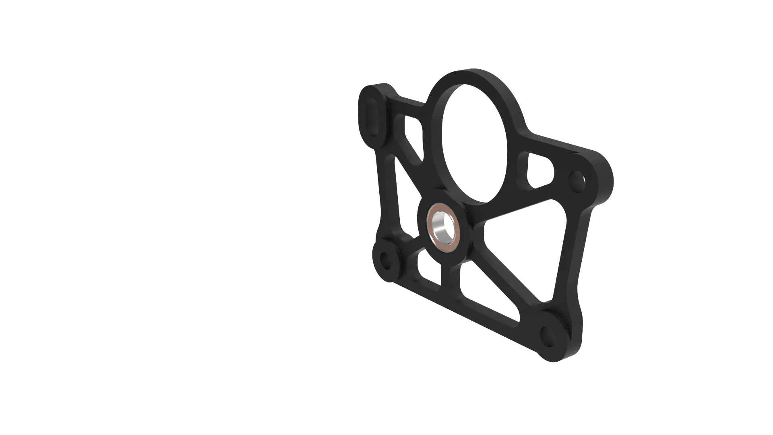
[picture p176: docs/delta/5/11.webp]
   

2.将<strong>同步轮</strong>穿入<strong>POM齿轮</strong>中，注意同步轮开孔的方向，如图所示。
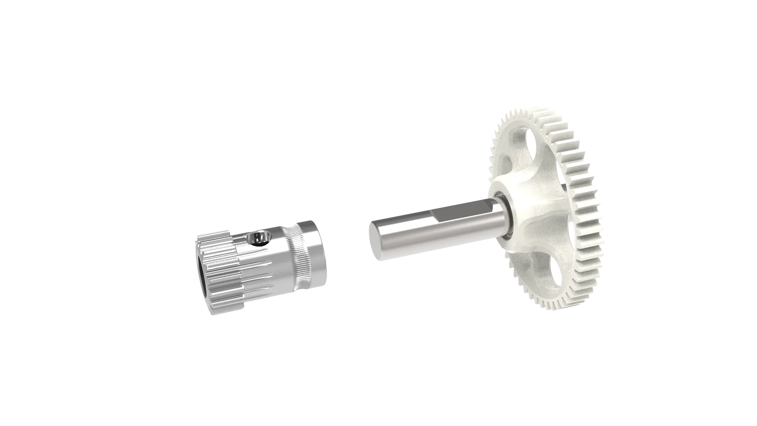
[picture p177: docs/delta/5/12.webp]
   
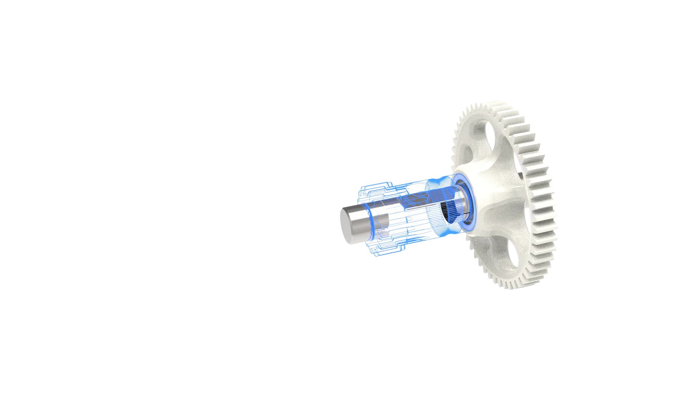
[picture p178: docs/delta/5/13.webp]
   

3.使用<strong>顶丝</strong>涂抹上<strong>螺纹胶</strong>后拧紧顶丝，顶丝应在<strong>POM齿轮</strong>的平槽上，如图所示。
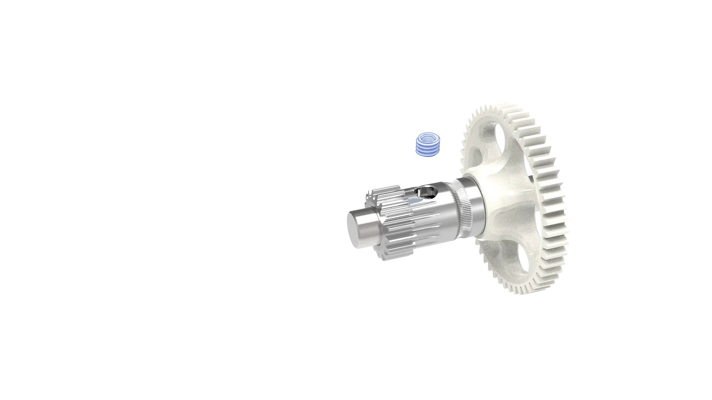
[picture p179: docs/delta/5/14.webp]
   
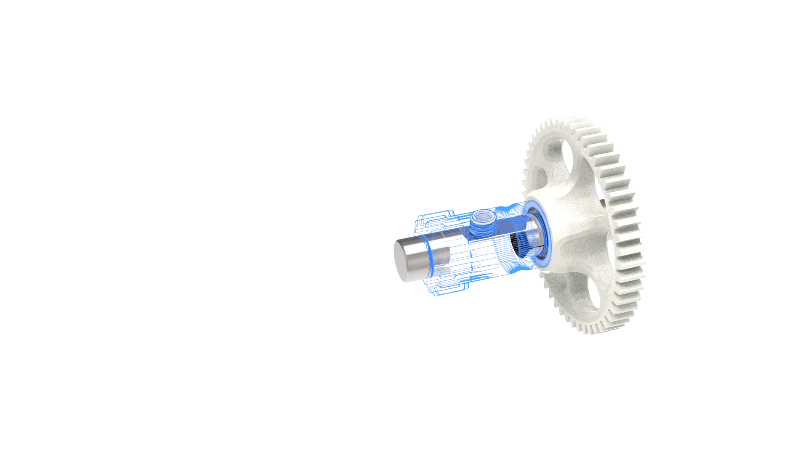
[picture p180: docs/delta/5/15.webp]
   
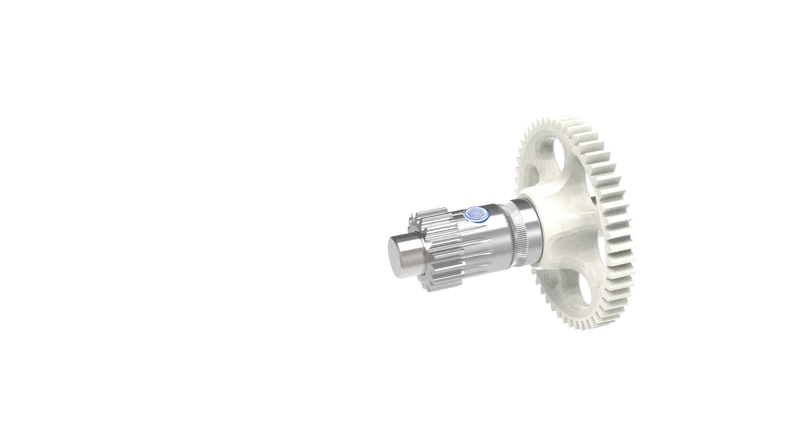
[picture p181: docs/delta/5/16.webp]
   

4.将<strong>MR85轴承</strong>穿入<strong>POM齿轮</strong>中，如图所示。
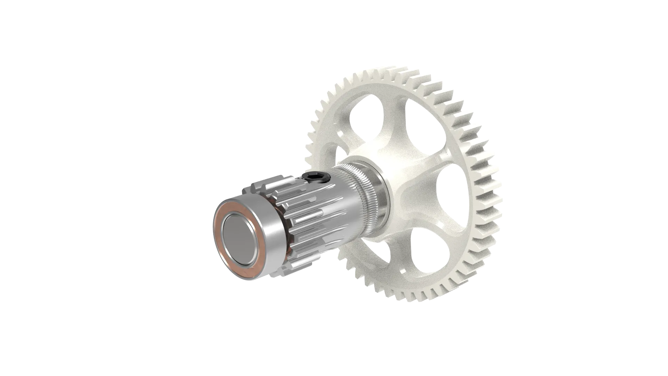
[picture p182: docs/delta/5/17.webp]
   

5.使用烙铁将<strong>滚花螺母</strong>压入<strong>挤出机打印件</strong>中，如图所示。
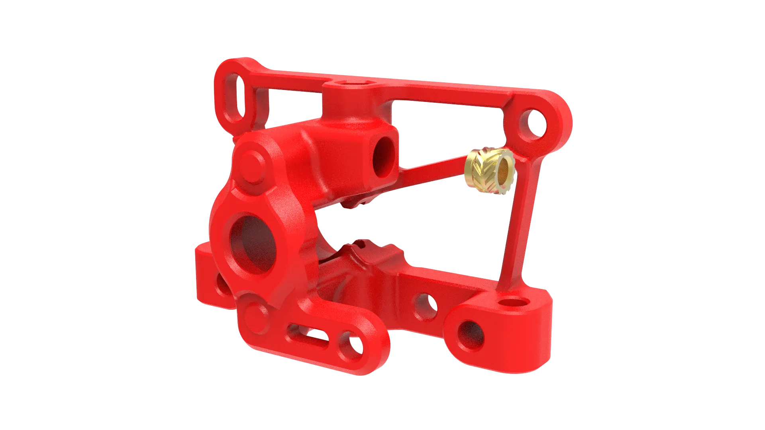
[picture p183: docs/delta/5/18.webp]
   
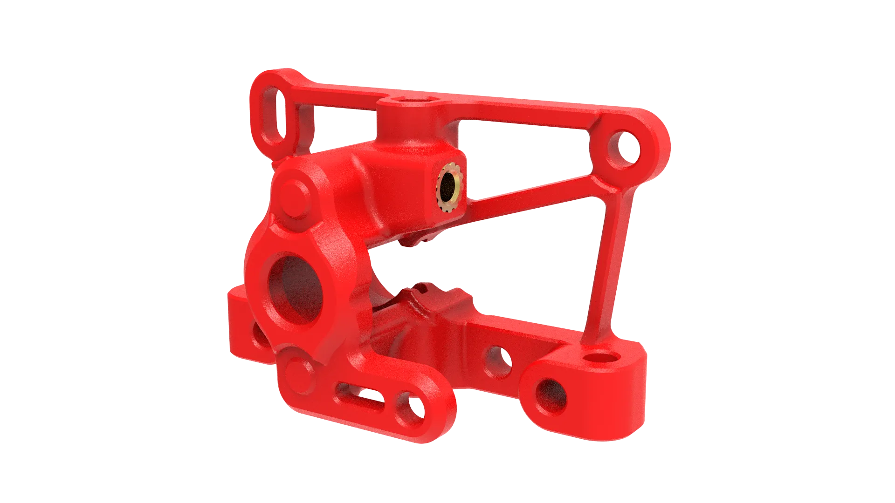
[picture p184: docs/delta/5/19.webp]
   

6.将<strong>POM齿轮</strong>与<strong>挤出机打印件</strong>连接，<strong>MR85轴承</strong>应卡在<strong>挤出机打印件</strong>的卡槽内，如图所示。
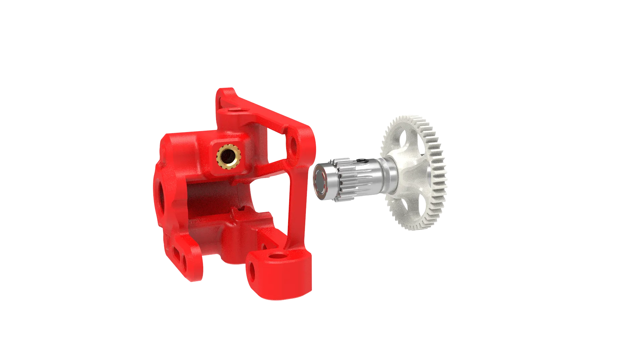
[picture p185: docs/delta/5/20.webp]
   
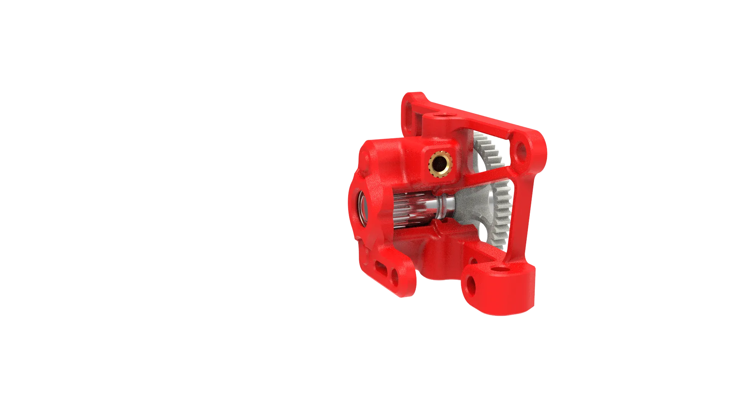
[picture p186: docs/delta/5/21.webp]
   

7.将<strong>POM齿轮</strong>与<strong>挤出机背板</strong>连接，<strong>POM齿轮</strong>应穿入<strong>挤出机背板</strong>的<strong>MR85轴承</strong>内，如图所示。
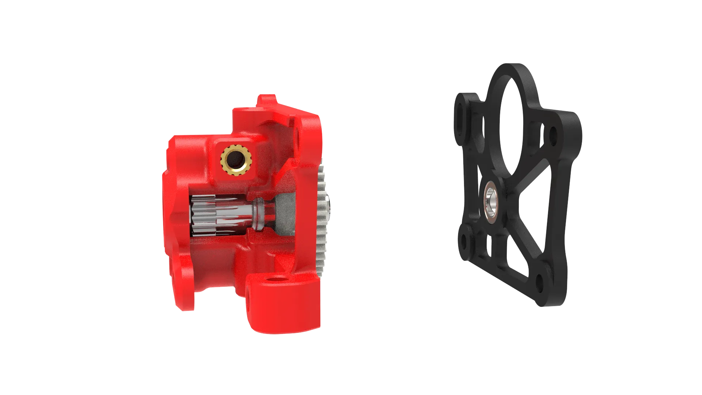
[picture p187: docs/delta/5/22.webp]
   
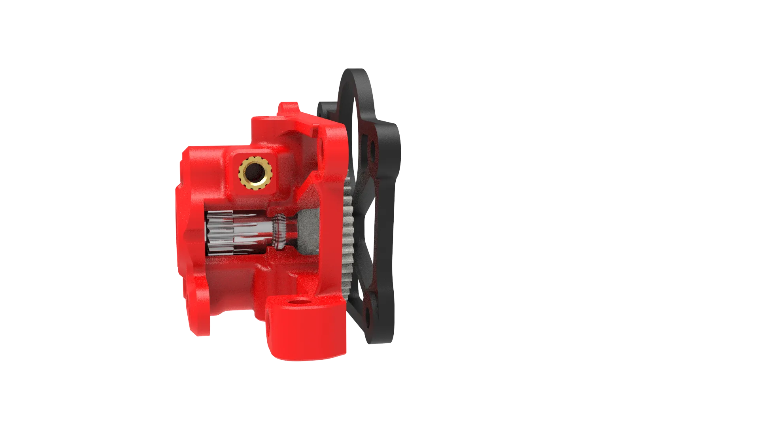
[picture p188: docs/delta/5/23.webp]
   

8.在<strong>挤出机背板</strong>与<strong>挤出机打印件</strong>之间的下方两个孔位放入两颗<strong>尼龙隔离柱</strong>使用两颗<strong>M3*20 杯头螺丝</strong>穿过并拧上<strong>自锁螺母</strong>，如图所示。
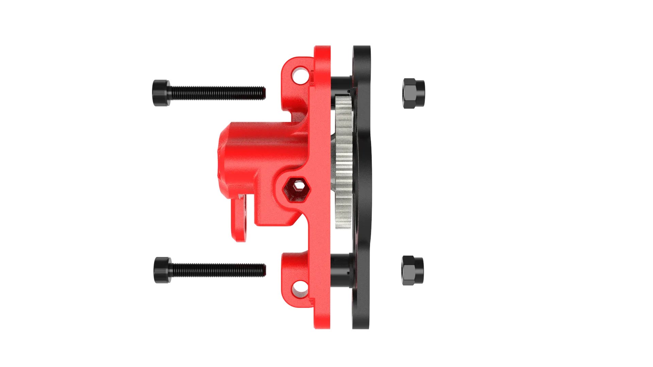
[picture p189: docs/delta/5/24.webp]
   
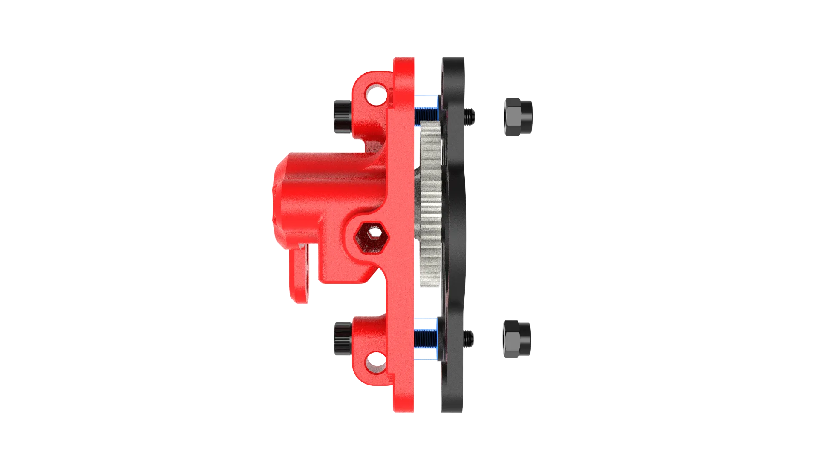
[picture p190: docs/delta/5/25.webp]
   
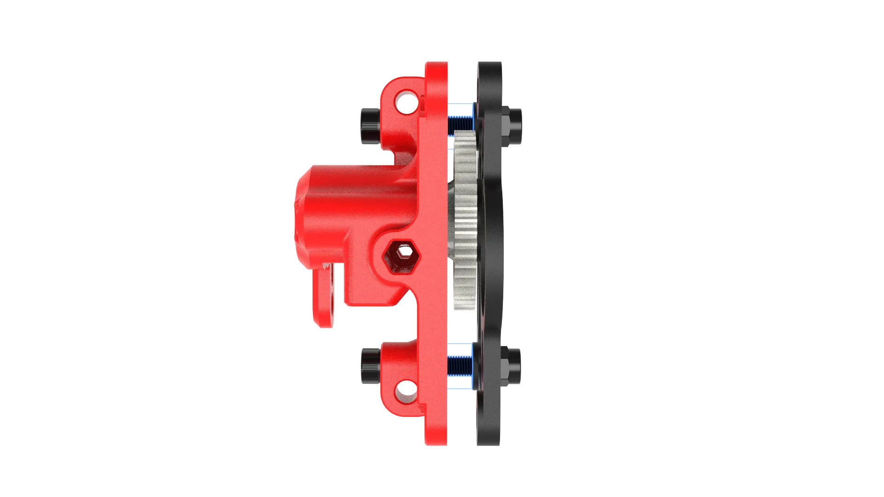
[picture p191: docs/delta/5/26.webp]
   
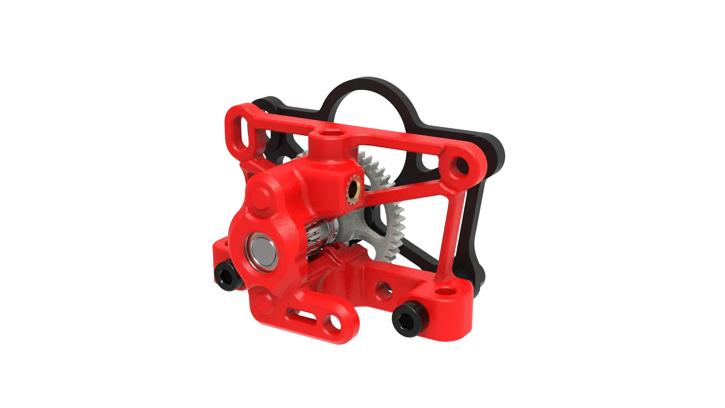
[picture p192: docs/delta/5/27.webp]
   

9.在<strong>挤出机背板</strong>与<strong>挤出机打印件</strong>之间的上方两个孔位放入两颗<strong>尼龙隔离柱</strong>使用两颗<strong>M3*35 杯头螺丝</strong>穿过，拧到<strong>挤出机电机</strong>上，穿过<strong>波纹管固定件</strong>并拧上<strong>自锁螺母</strong>，如图所示。
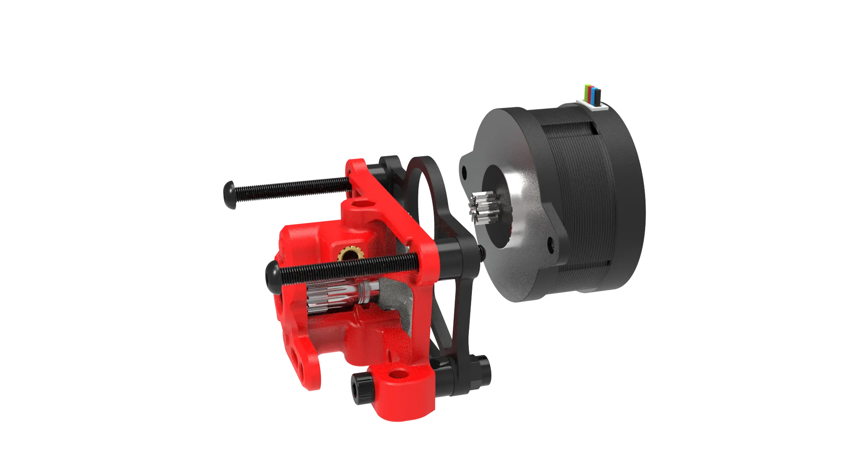
[picture p193: docs/delta/5/28.webp]
   
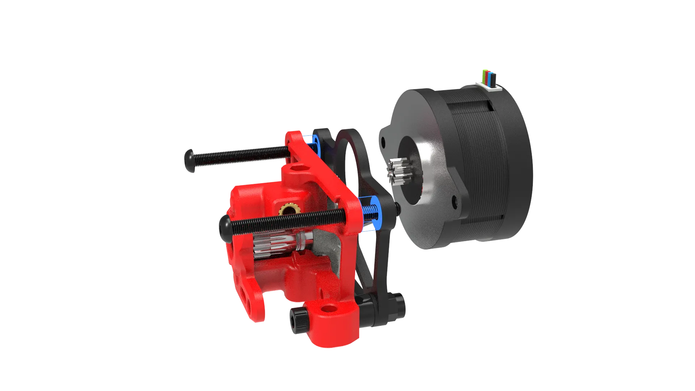
[picture p194: docs/delta/5/29.webp]
   
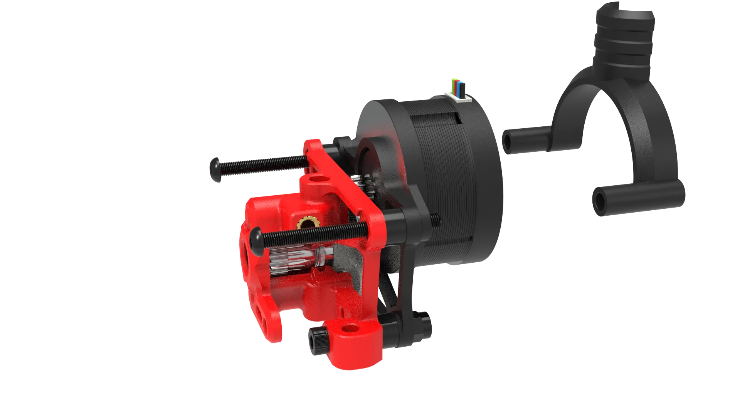
[picture p195: docs/delta/5/30.webp]
   
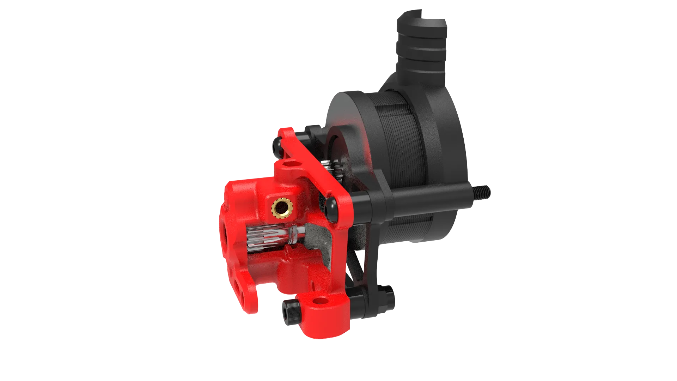
[picture p196: docs/delta/5/31.webp]
   
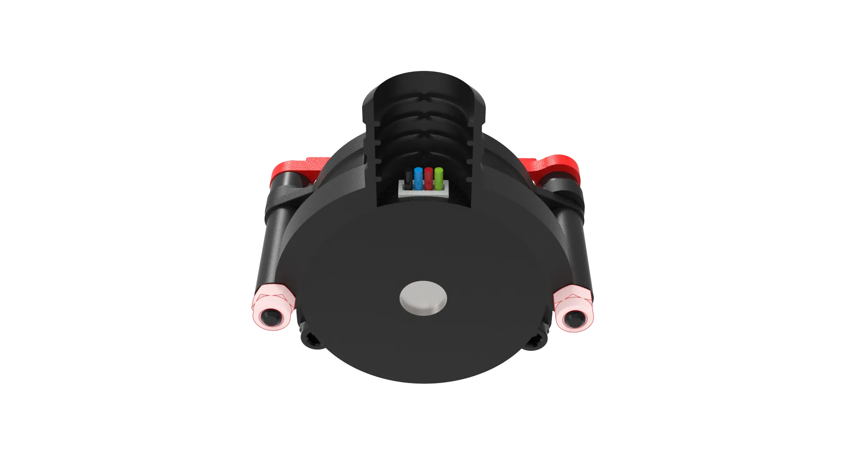
[picture p197: docs/delta/5/32.webp]
   
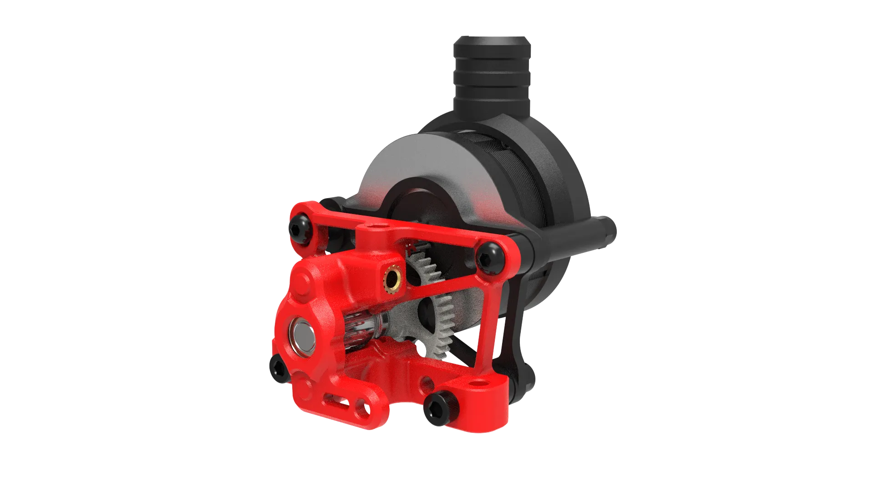
[picture p198: docs/delta/5/33.webp]
   

10.将两颗<strong>滚针轴承</strong>套入到<strong>短光轴</strong>内之后再套入<strong>同步轮</strong>，压入<strong>挤出机扳手件</strong>中，注意<strong>同步轮</strong>压入的方向，如图所示。
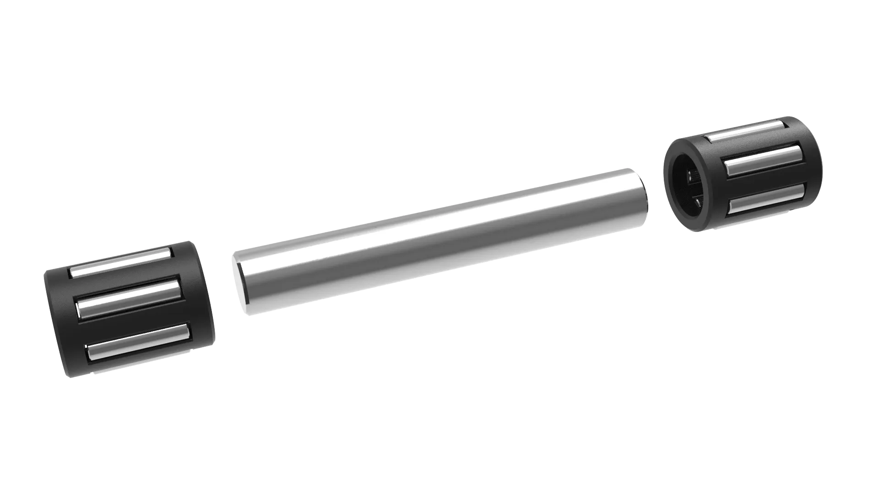
[picture p199: docs/delta/5/34.webp]
   
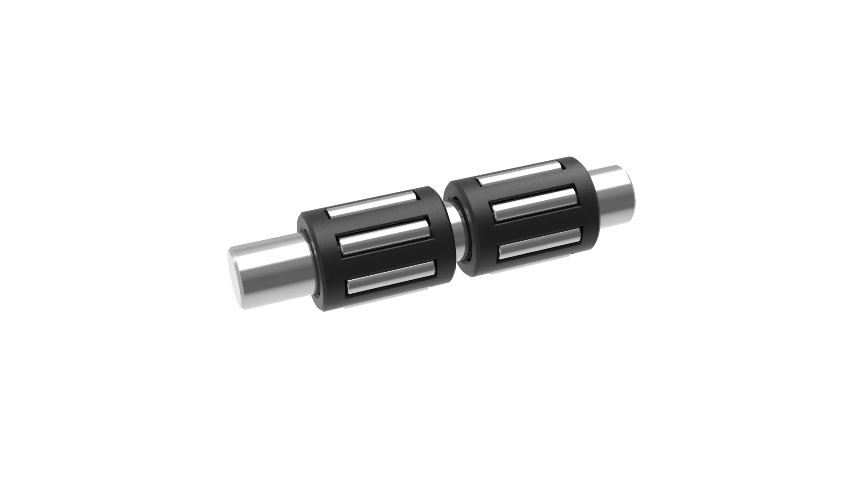
[picture p200: docs/delta/5/35.webp]
   
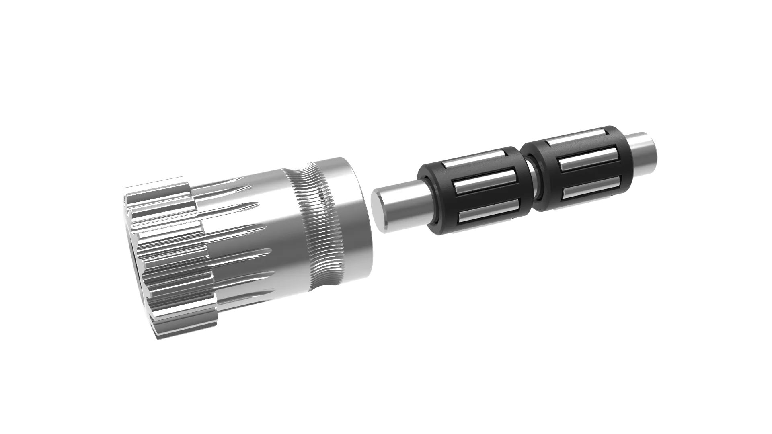
[picture p201: docs/delta/5/36.webp]
   
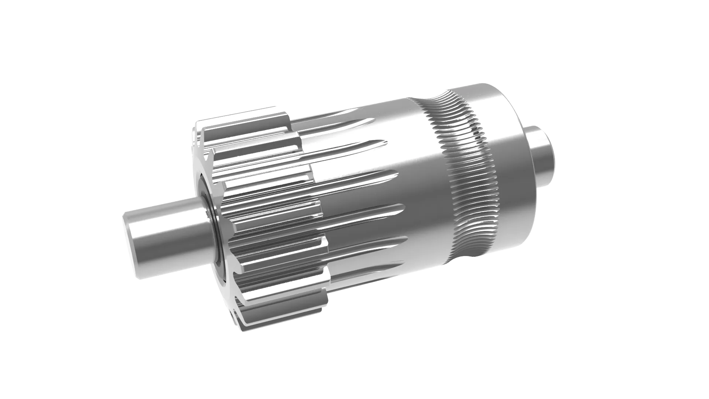
[picture p202: docs/delta/5/37.webp]
   
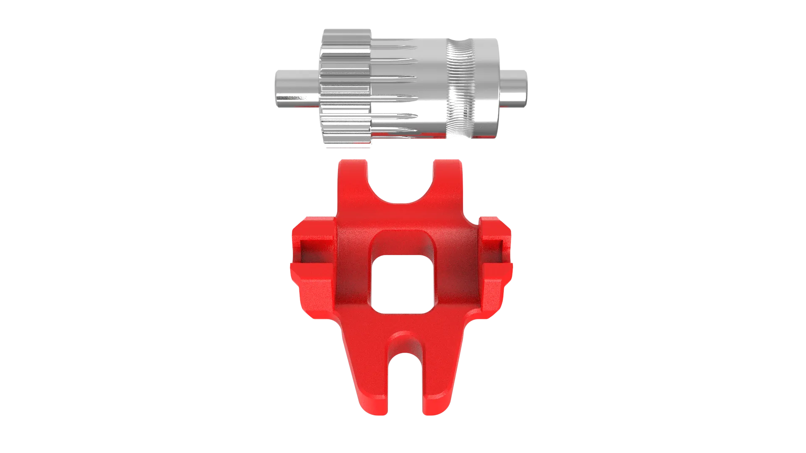
[picture p203: docs/delta/5/38.webp]
   
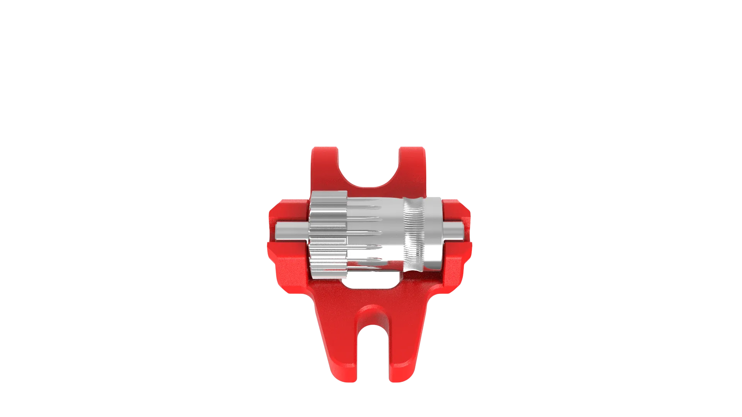
[picture p204: docs/delta/5/39.webp]
   

11.将<strong>长光轴</strong>穿过<strong>挤出机打印件</strong>与<strong>挤出机扳手件</strong>连接，如图所示。
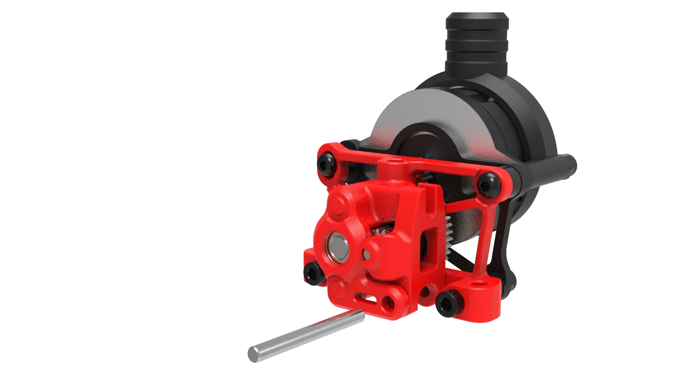
[picture p205: docs/delta/5/40.webp]
   
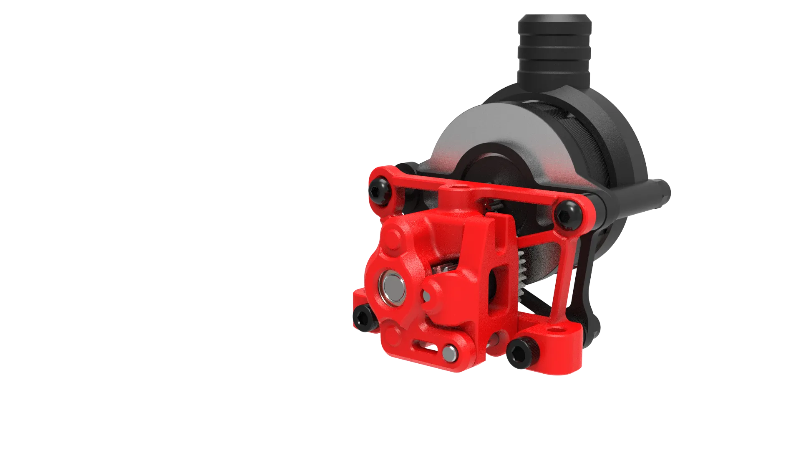
[picture p206: docs/delta/5/41.webp]
   

!!! info "压入光轴"
       <strong>长光轴</strong>不易压入时，可使用电动工具扩夹住<strong>长光轴</strong>对<strong>挤出机打印件</strong>进行扩孔，不要硬压以免损坏<strong>挤出机打印件</strong>。

12.将两颗<strong>M3*14 杯头螺丝</strong>穿过<strong>挤出机打印件</strong>与<strong>金属吊台</strong>连接并拧上两颗<strong>自锁螺母</strong>，如图所示。
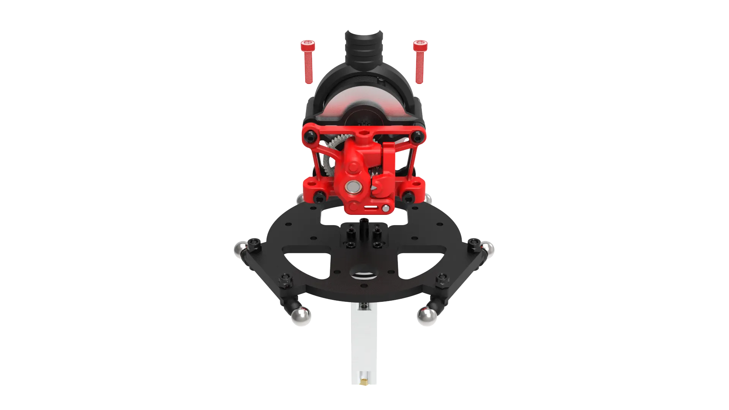
[picture p207: docs/delta/5/42.webp]
   
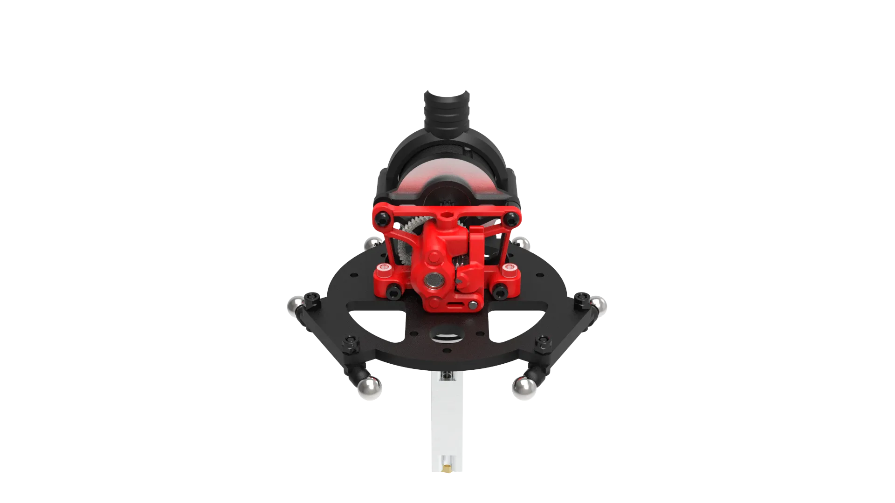
[picture p208: docs/delta/5/43.webp]
   
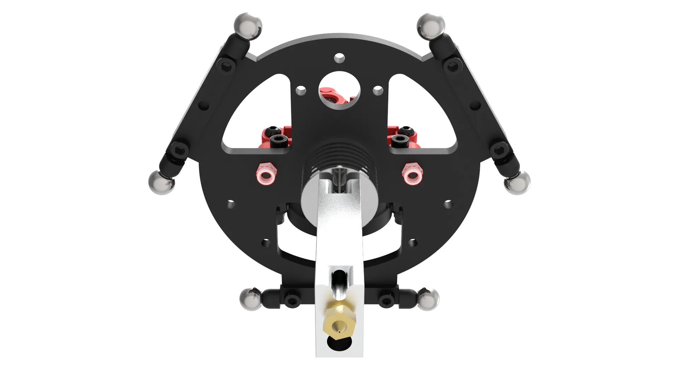
[picture p209: docs/delta/5/44.webp]
   

13.将<strong>手拧螺丝</strong>穿入<strong>弹簧</strong>与<strong>垫片</strong>，拧到<strong>挤出机打印件</strong>的<strong>滚花螺母</strong>上，如图所示。
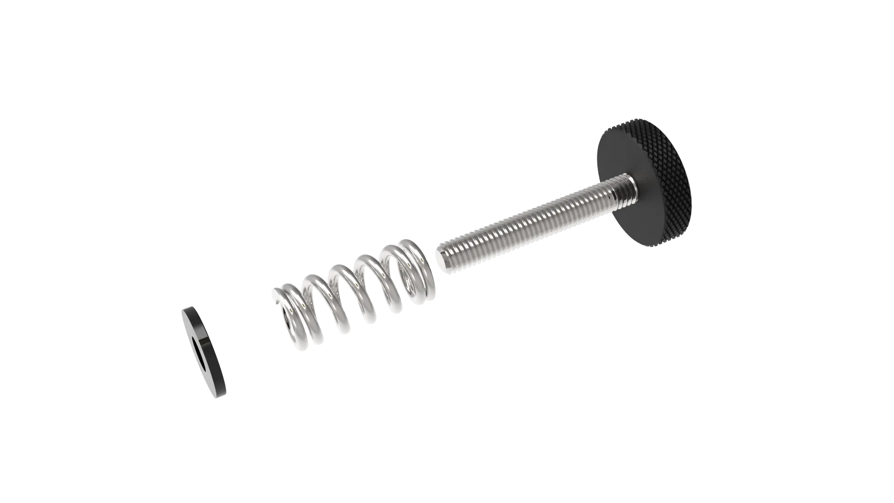
[picture p210: docs/delta/5/45.webp]
   
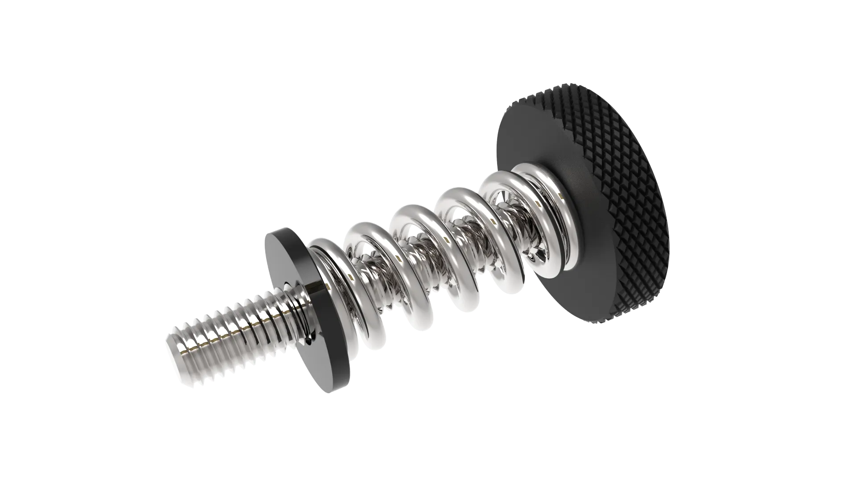
[picture p211: docs/delta/5/46.webp]
   
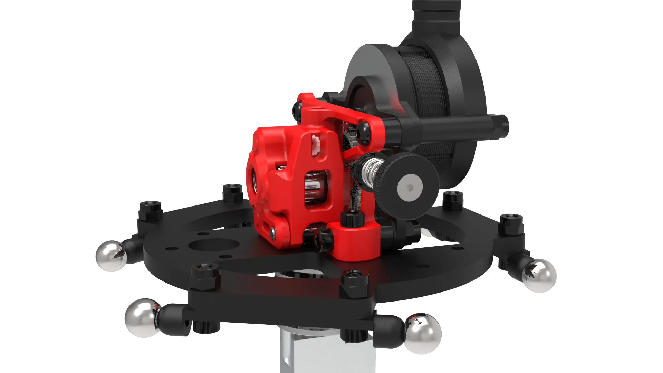
[picture p212: docs/delta/5/47.webp]
   
   

## 3.风道组装

### 所需物料

1.M2.5*6 杯头螺丝 * 3
   

2.M3*10 杯头螺丝 * 3
   
   
3.M3*14 杯头螺丝 * 2
   

### 打印零件

1.[风道导向件]  * 1
[风道导向件]: dy4.stl
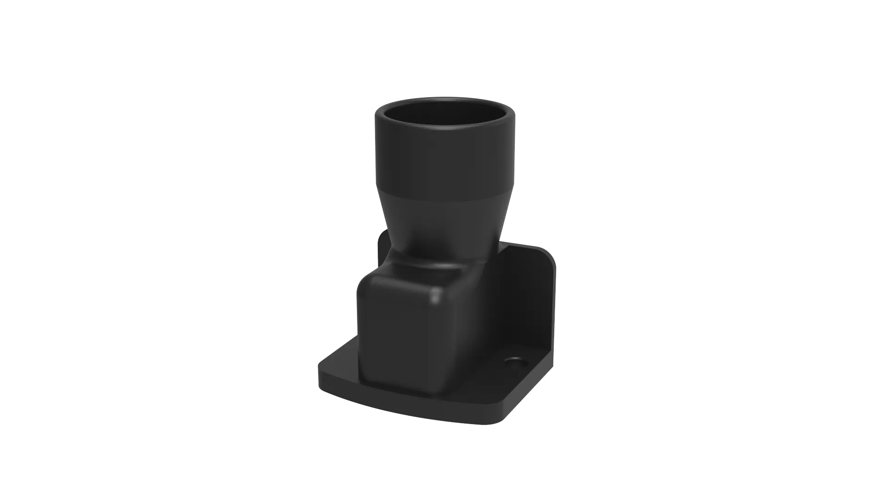
[picture p213: docs/delta/5/dy4.webp]
   

2.[风道连接件] * 1
[风道连接件]: dy5.stl
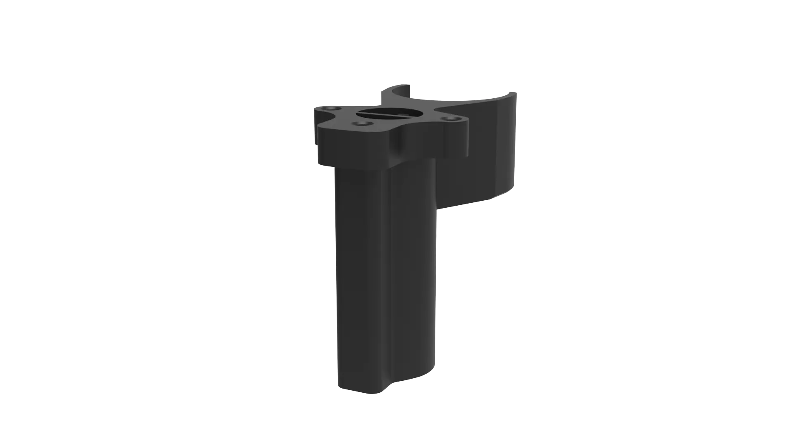
[picture p214: docs/delta/5/dy5.webp]
   

3.[风道固定件] * 1
[风道固定件]: dy6.stl
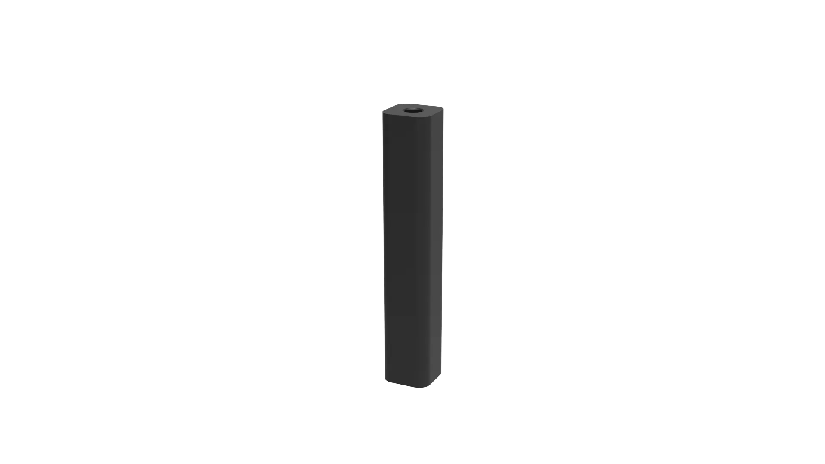
[picture p215: docs/delta/5/dy6.webp]
   

4.[堵风环] * 1
[堵风环]: dy7.stl
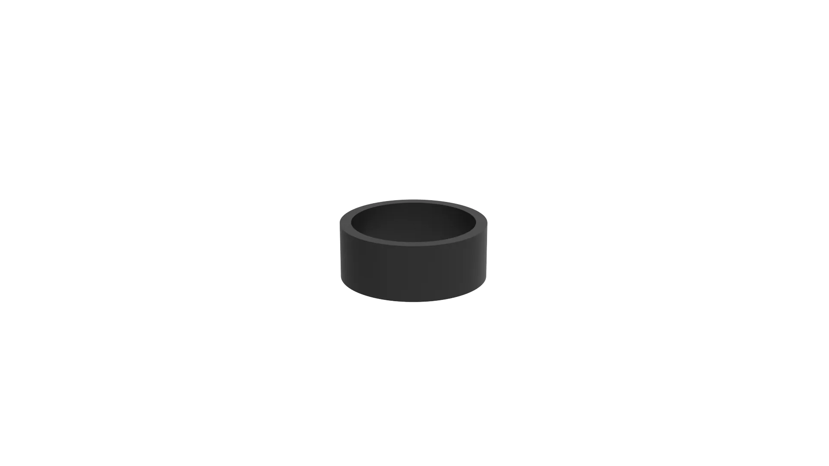
[picture p216: docs/delta/5/dy7.webp]
   

5.[风道件] * 1
[风道件]: dy8.stl
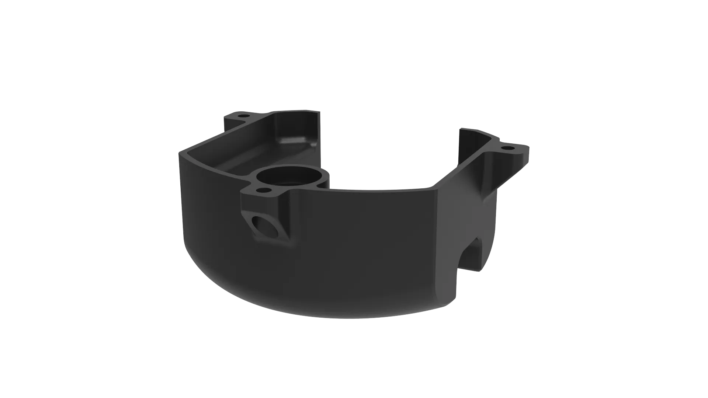
[picture p217: docs/delta/5/dy8.webp]
   

6.[吊台装饰件] * 1
[吊台装饰件]: dy9.stl
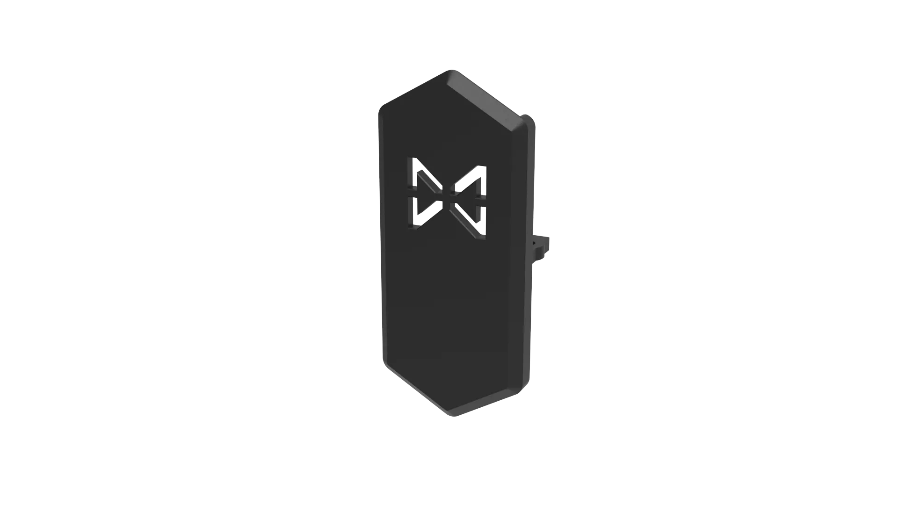
[picture p218: docs/delta/5/dy9.webp]
   

7.[吊台标识件] * 1
[吊台标识件]: dy10.stl
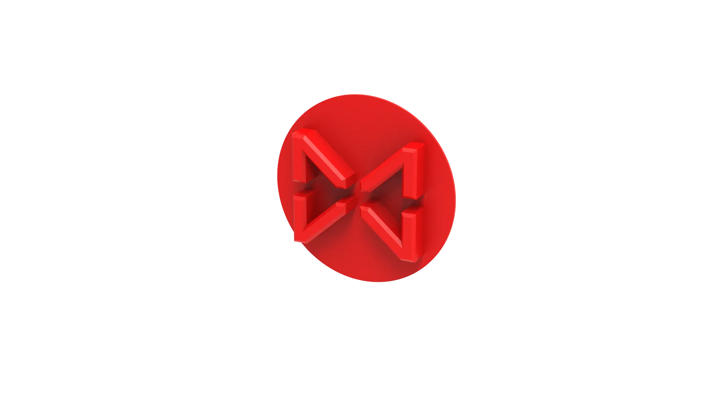
[picture p219: docs/delta/5/dy10.webp]
   
   
### 组装流程

1.将<strong>风道连接件</strong>卡住散热块，并使用<strong>M3*10 杯头螺丝</strong>穿过<strong>金属吊台</strong>进行固定，如图所示。
   
   
   

2.将<strong>吊台标识件</strong>压入到<strong>吊台装饰件</strong>中，如图所示。
   
   
   

3.将<strong>风道导向件</strong>放置到<strong>吊台装饰件</strong>下方，并使用两颗<strong>M3*14 杯头螺丝</strong>穿过，如图所示。
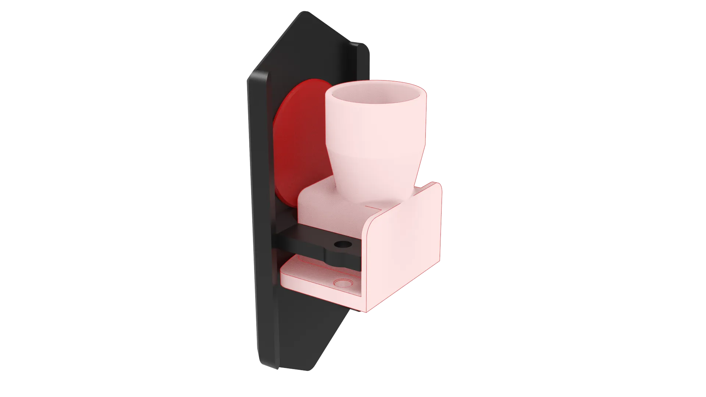
[picture p220: docs/delta/5/55.webp]
   
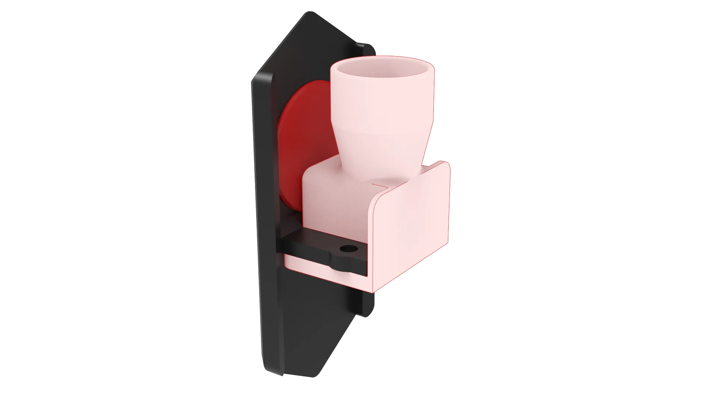
[picture p221: docs/delta/5/56.webp]
   
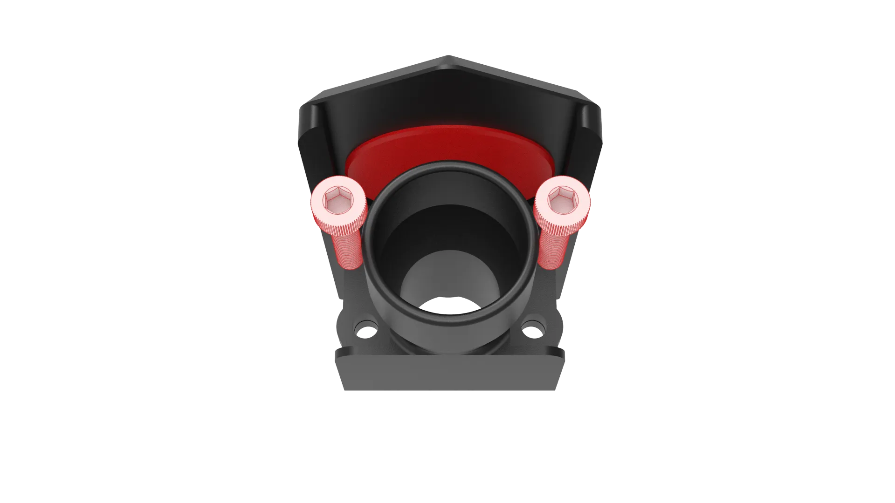
[picture p222: docs/delta/5/57.webp]
   
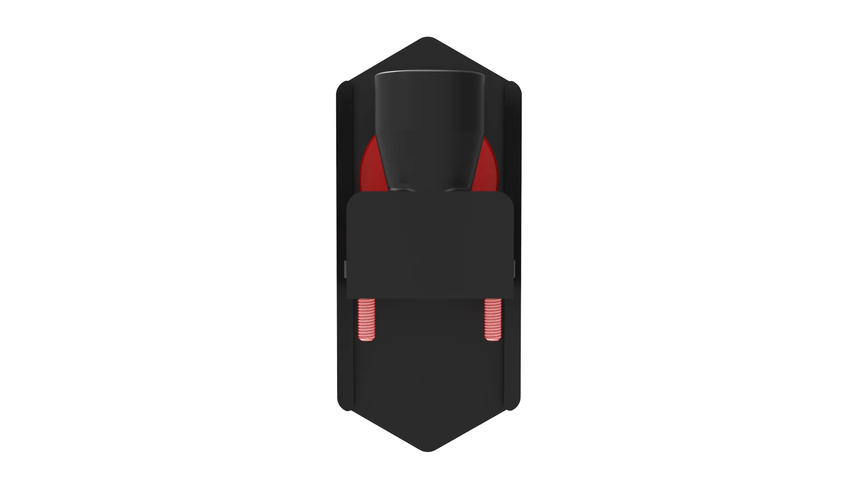
[picture p223: docs/delta/5/58.webp]
   

4.将两颗<strong>M3*14 杯头螺丝</strong>穿过<strong>金属吊台</strong>与<strong>风道连接件</strong>连接，拧好螺丝，如图所示。
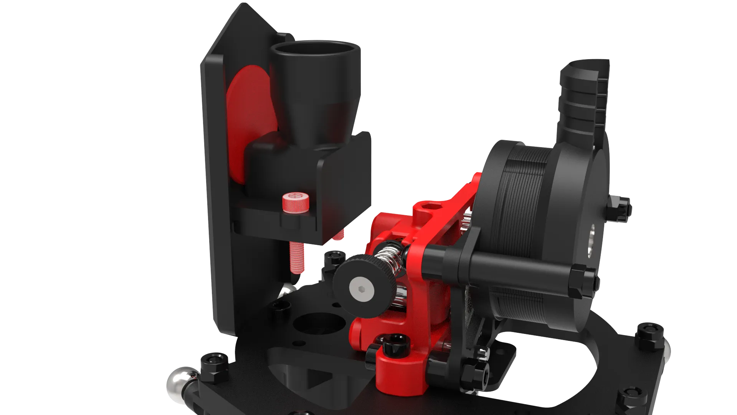
[picture p224: docs/delta/5/59.webp]
   
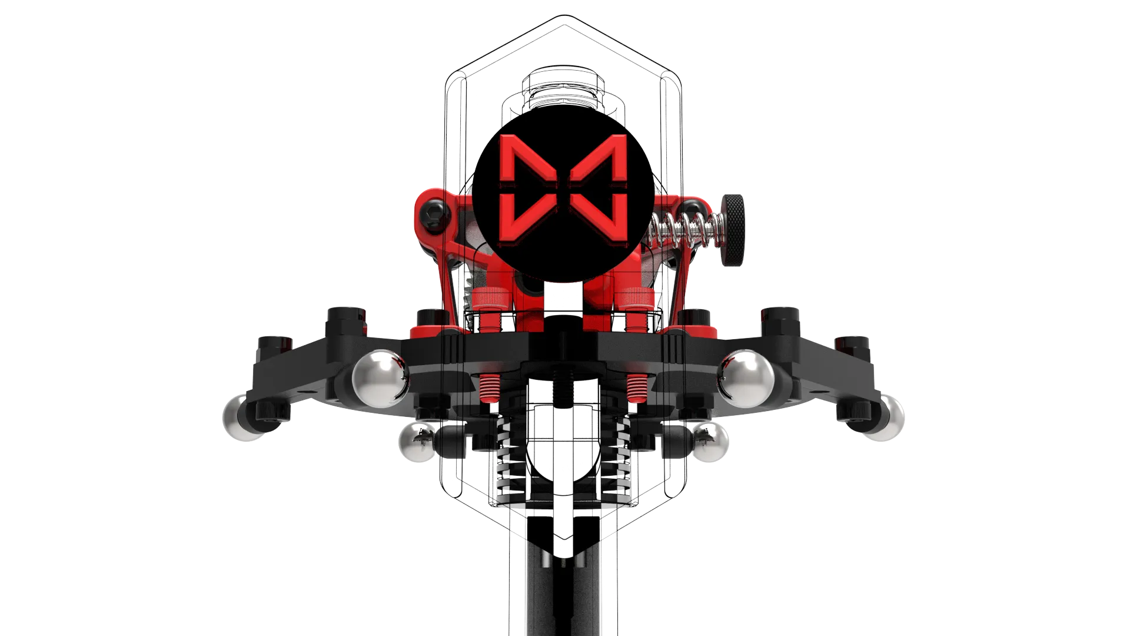
[picture p225: docs/delta/5/60.webp]
   
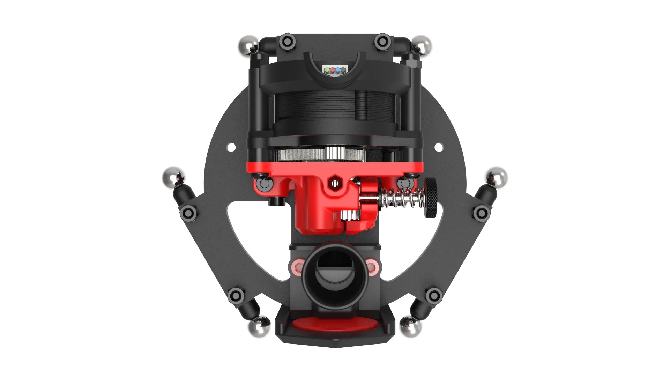
[picture p226: docs/delta/5/61.webp]
   

5.将<strong>M3*14 杯头螺丝</strong>穿过<strong>金属吊台</strong>与<strong>风道固定件</strong>连接，拧好螺丝，如图所示。
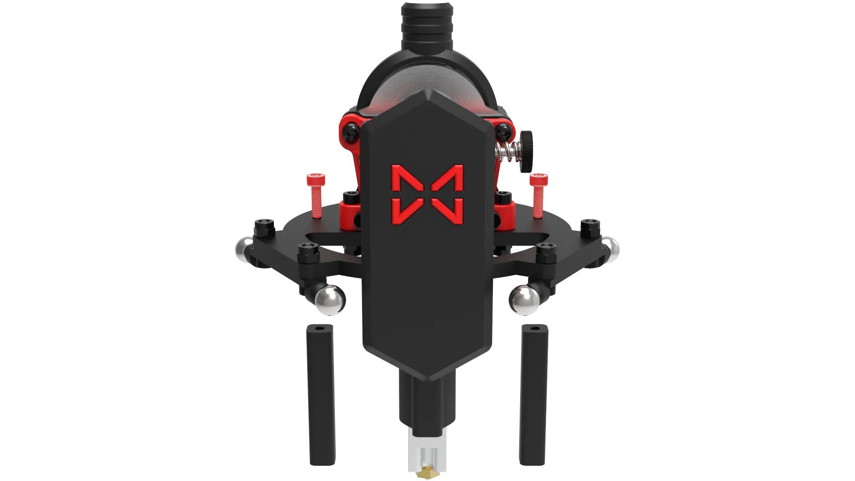
[picture p227: docs/delta/5/62.webp]
   
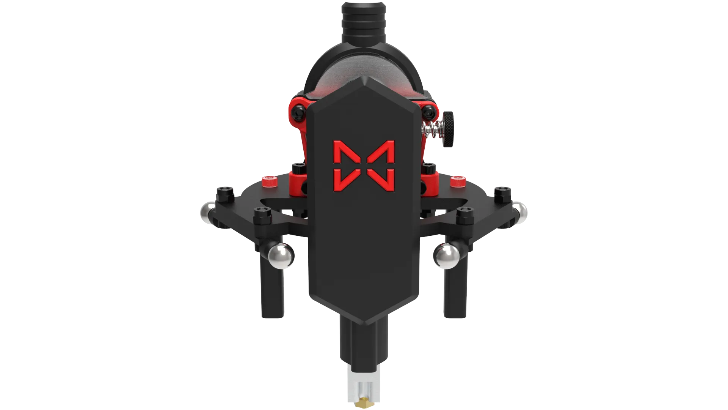
[picture p228: docs/delta/5/63.webp]
   

!!! info "风道固定件"
       注意<strong>风道固定件</strong>的方向，较大的孔与<strong>M3*14 杯头螺丝</strong>固定。
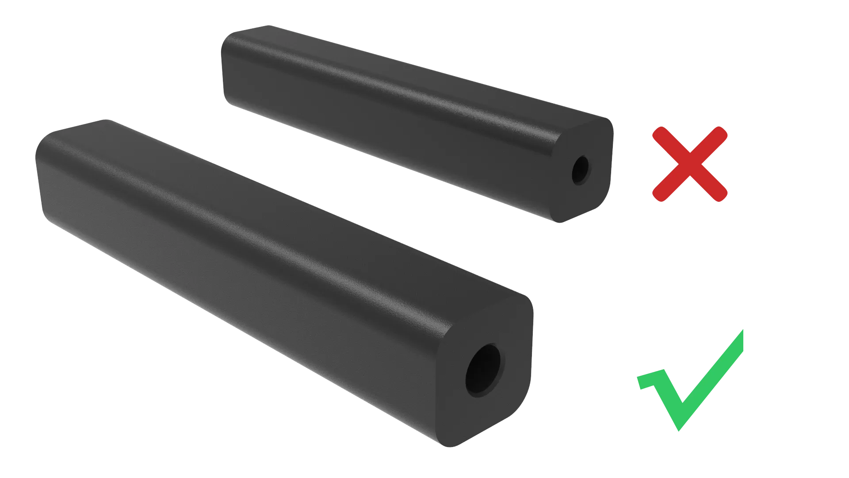
[picture p229: docs/delta/5/zysx.webp]
       

6.将<strong>堵风环</strong>卡到<strong>风道件</strong>中，与<strong>风道连接件</strong>连接，如图所示。
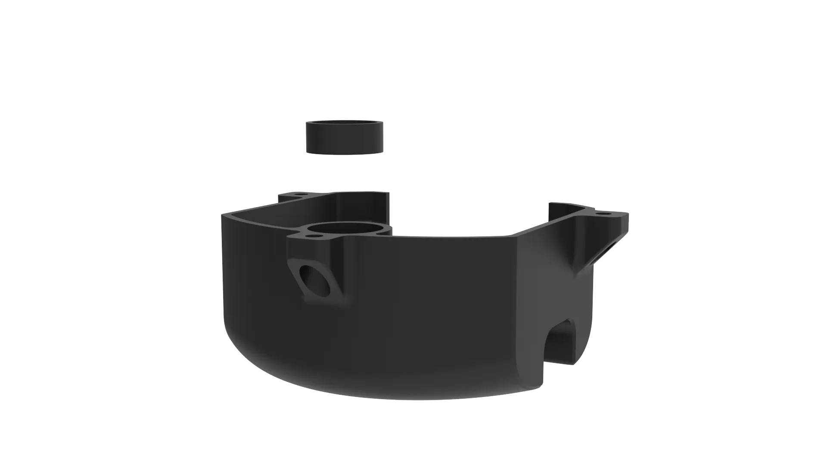
[picture p230: docs/delta/5/64.webp]
   
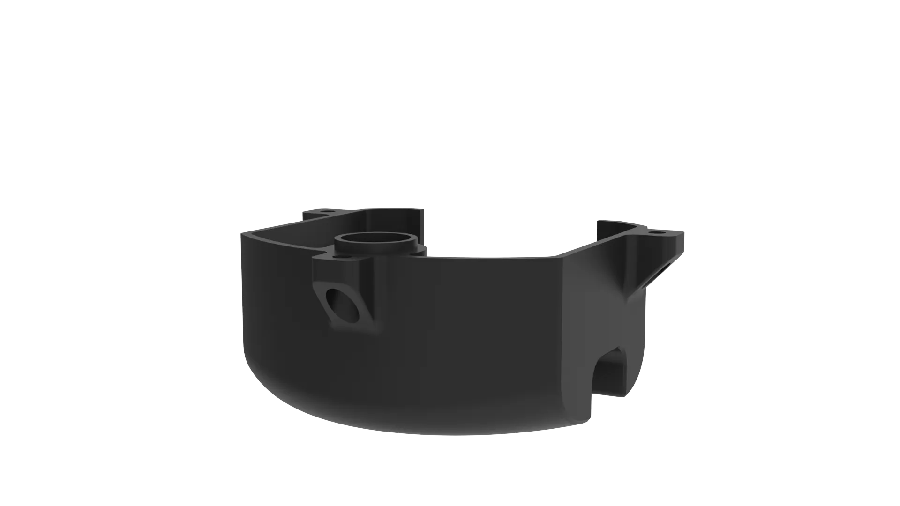
[picture p231: docs/delta/5/65.webp]
   
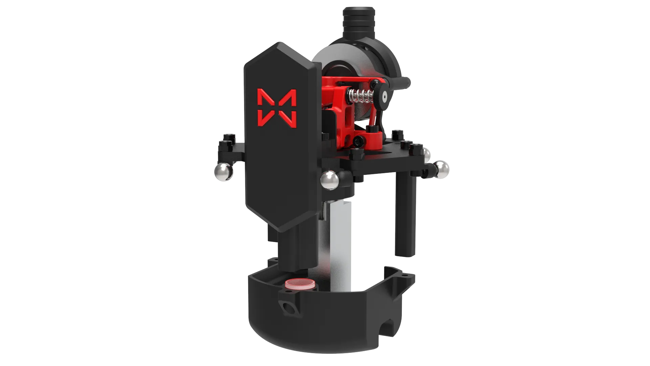
[picture p232: docs/delta/5/66.webp]
   
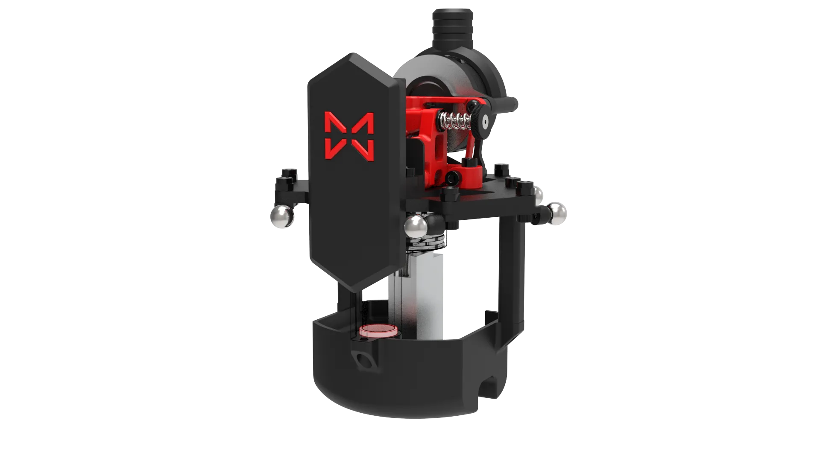
[picture p233: docs/delta/5/67.webp]
   
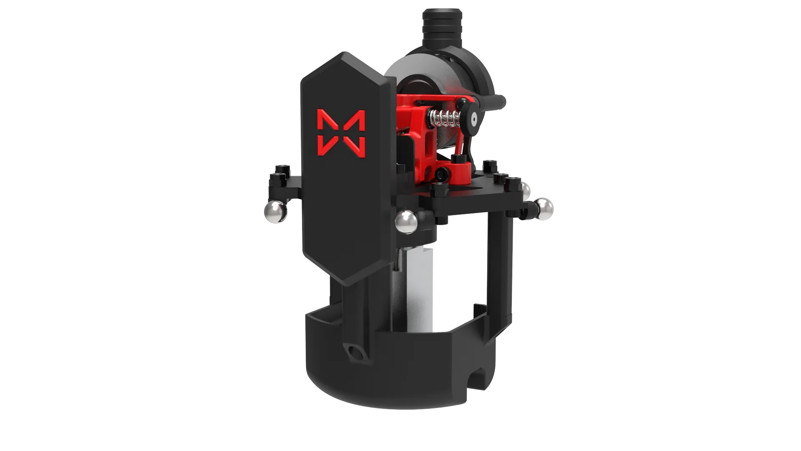
[picture p234: docs/delta/5/68.webp]
   

7.使用三颗<strong>M2.5*6 杯头螺丝</strong>固定，拧好螺丝，如图所示。
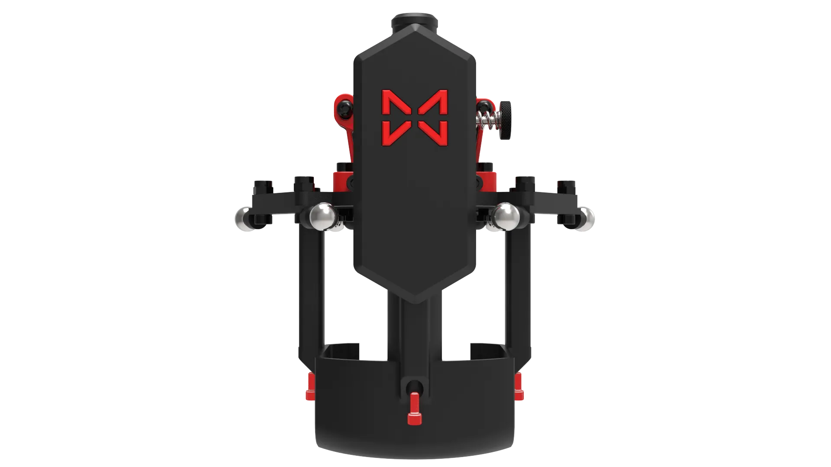
[picture p235: docs/delta/5/69.webp]
   
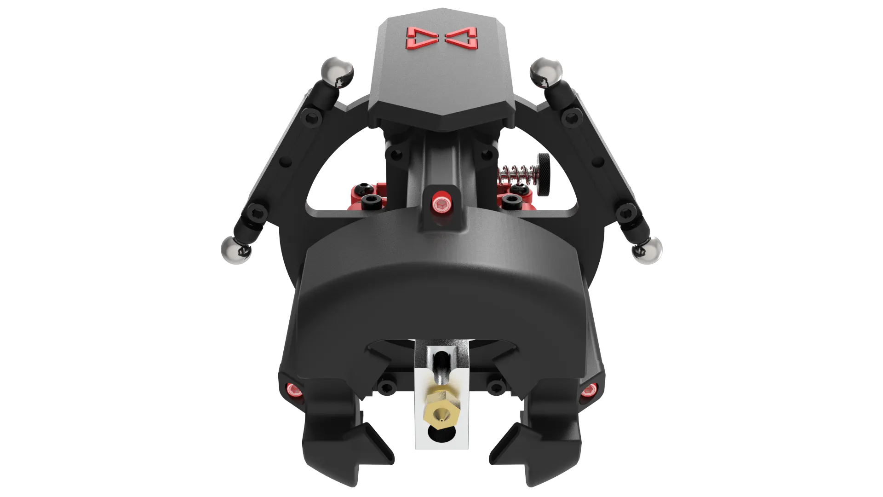
[picture p236: docs/delta/5/70.webp]
   
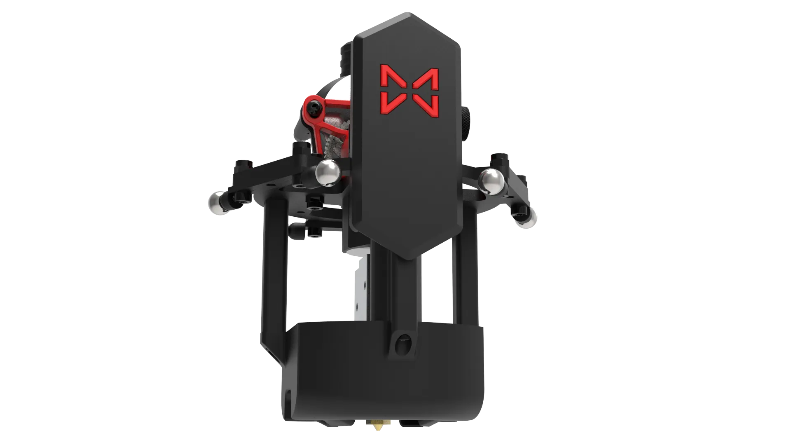
[picture p237: docs/delta/5/71.webp]
   

## 4.线材整理

### 所需物料

1.波纹管 * 1
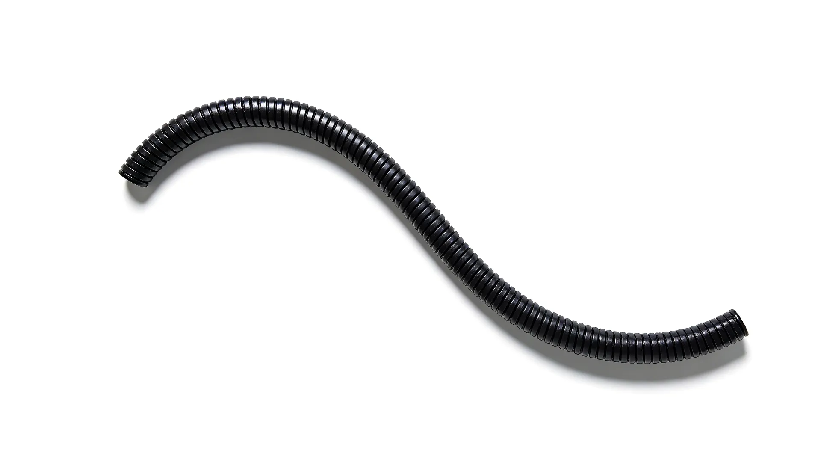
[picture p238: docs/delta/5/bwg.webp]
   

2.扎带 * 2
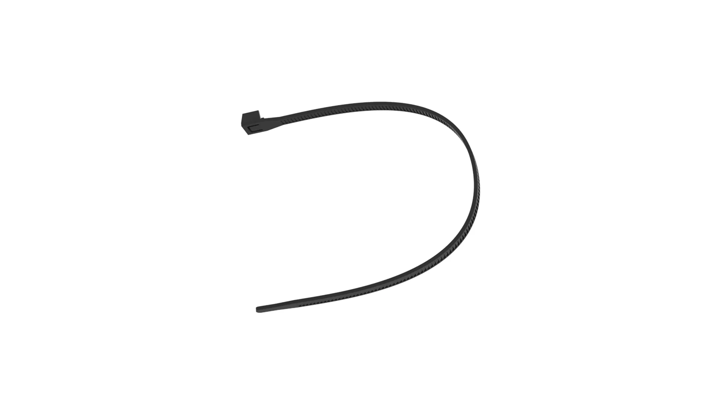
[picture p239: docs/delta/5/zd.webp]
   

### 打印零件

1.[穿线器打印件] * 1
[穿线器打印件]: dy11.stl
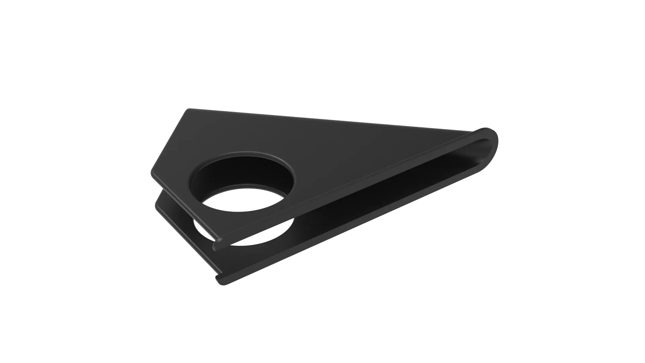
[picture p240: docs/delta/5/dy11.webp]
   

### 组装流程

1.使用<strong>穿线器打印件</strong>将线材穿入<strong>波纹管</strong>中，如图所示。
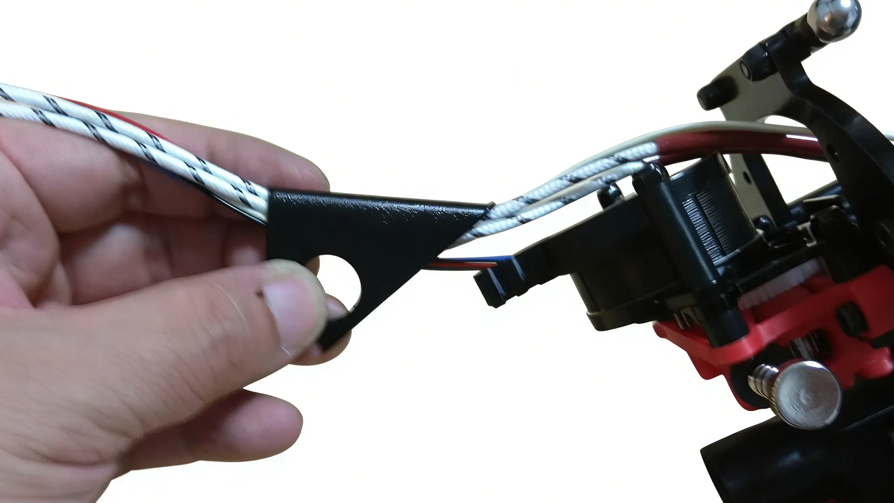
[picture p241: docs/delta/5/72.webp]
   
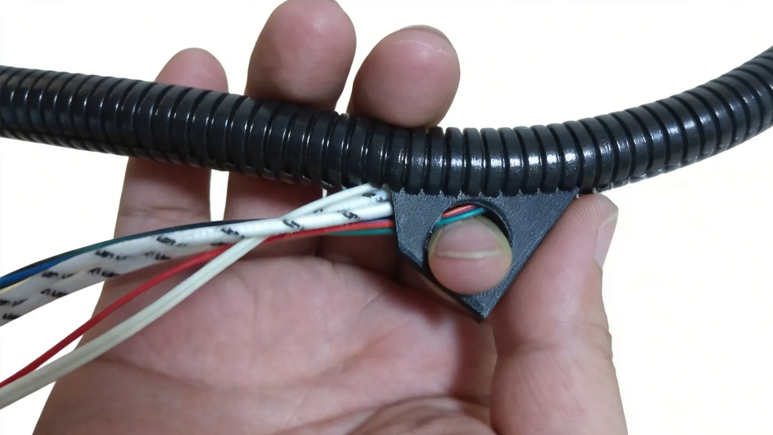
[picture p242: docs/delta/5/73.webp]
   
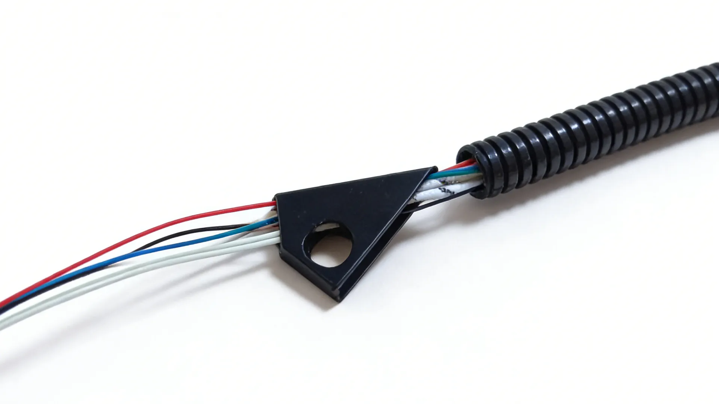
[picture p243: docs/delta/5/74.webp]
   

2.将<strong>穿线器打印件</strong>卡入<strong>波纹管固定件</strong>的凹槽内并使用<strong>扎带</strong>扎紧，减去多余部分，如图所示。
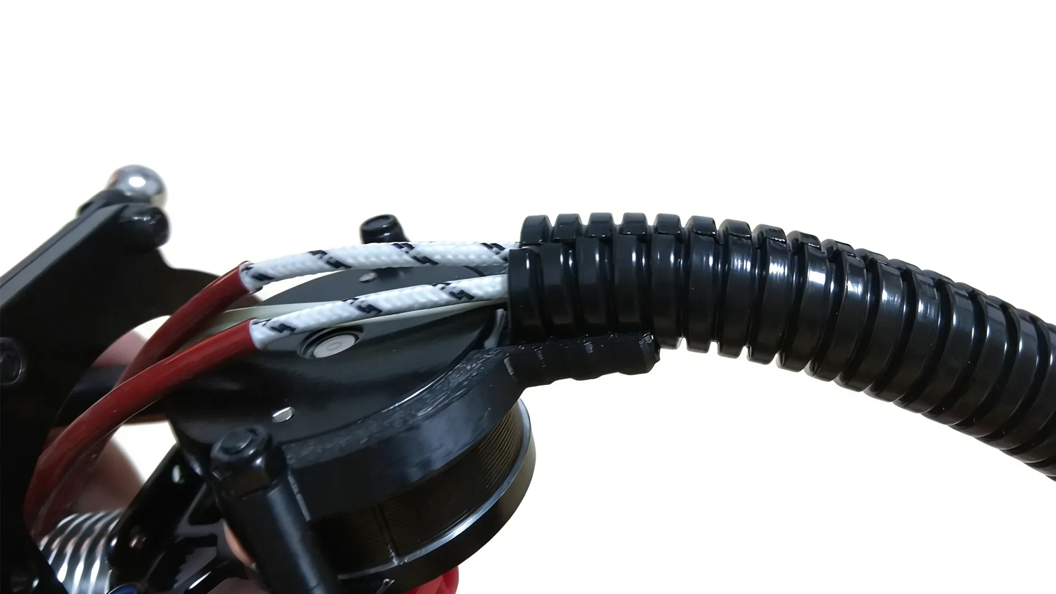
[picture p244: docs/delta/5/75.webp]
   
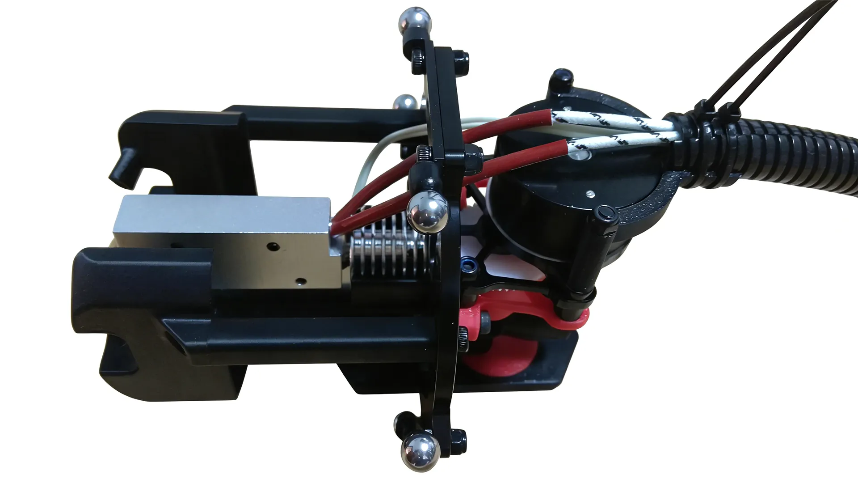
[picture p245: docs/delta/5/76.webp]
   
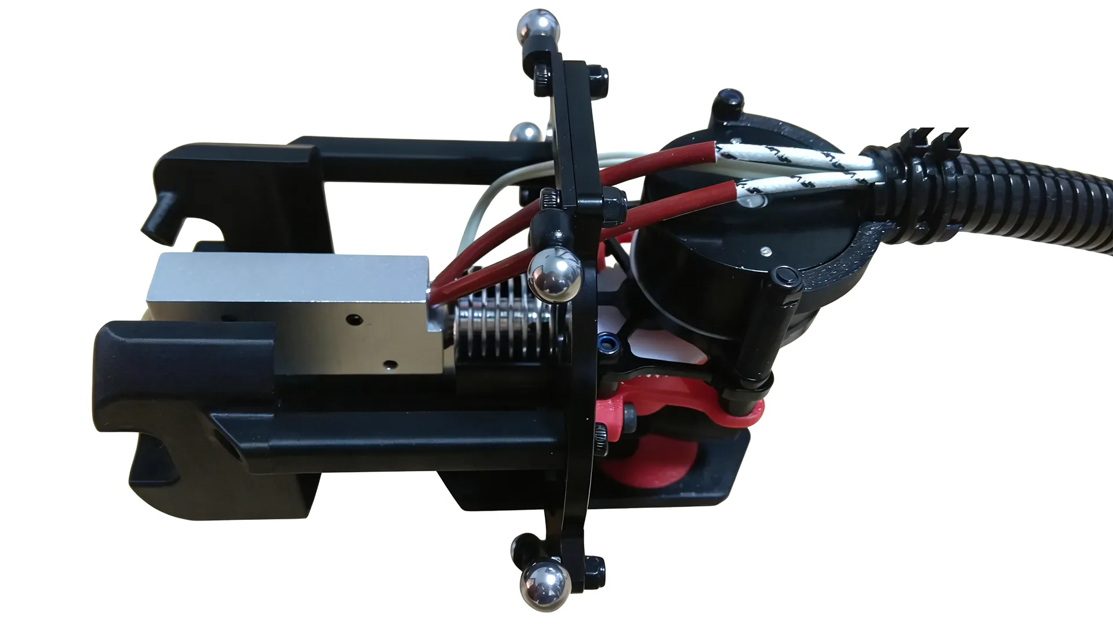
[picture p246: docs/delta/5/77.webp]
   

## 5.连杆组装

### 所需物料

1.勺形连杆 * 6
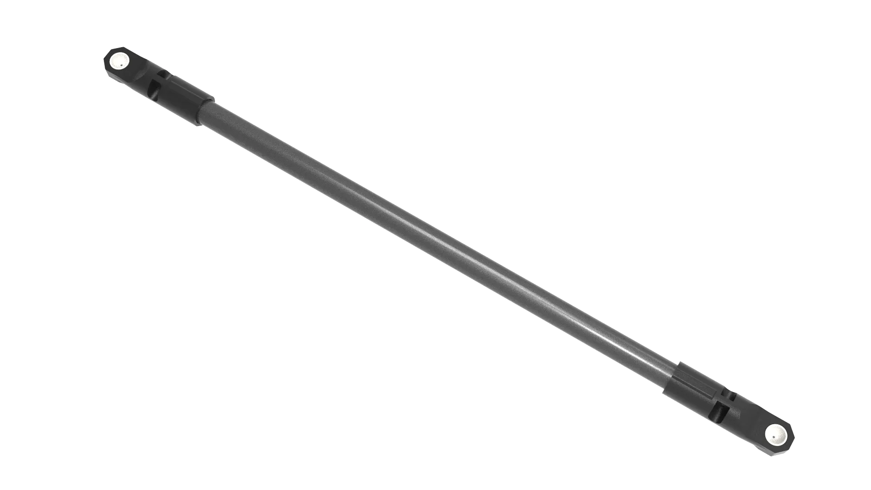
[picture p247: docs/delta/5/sxlg.webp]
   

2.拉力弹簧 * 6
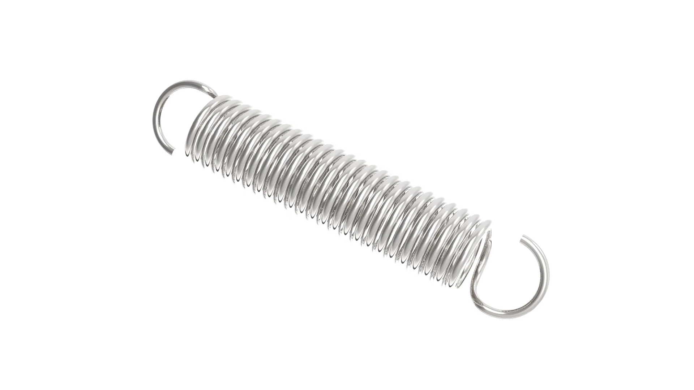
[picture p248: docs/delta/5/llth.webp]
   

### 组装流程

1.使用<strong>润滑脂</strong>涂抹到每个<strong>勺形连杆</strong>勺型孔中，保证配合时的运动顺滑，如图所示。
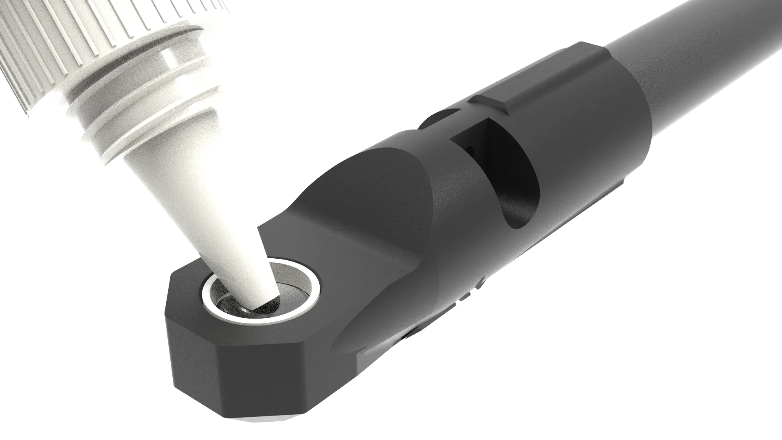
[picture p249: docs/delta/5/78.webp]
   

2.使用两个<strong>拉力弹簧</strong>将两个<strong>勺形连杆</strong>连接，如图所示。
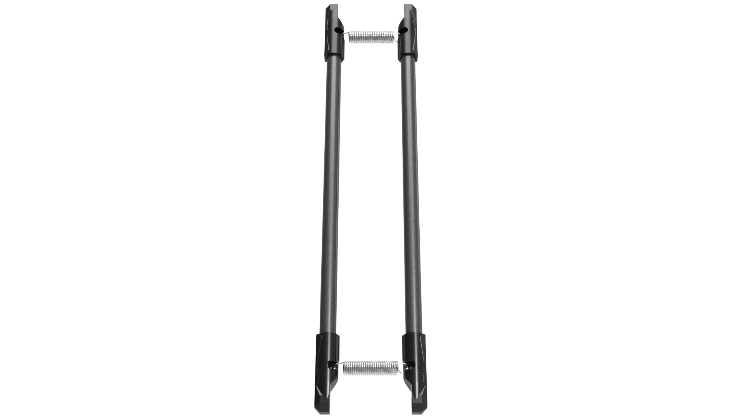
[picture p250: docs/delta/5/79.webp]
   

3.拉动<strong>拉力弹簧</strong>，将两个<strong>勺形连杆</strong>卡入到如图所示位置。
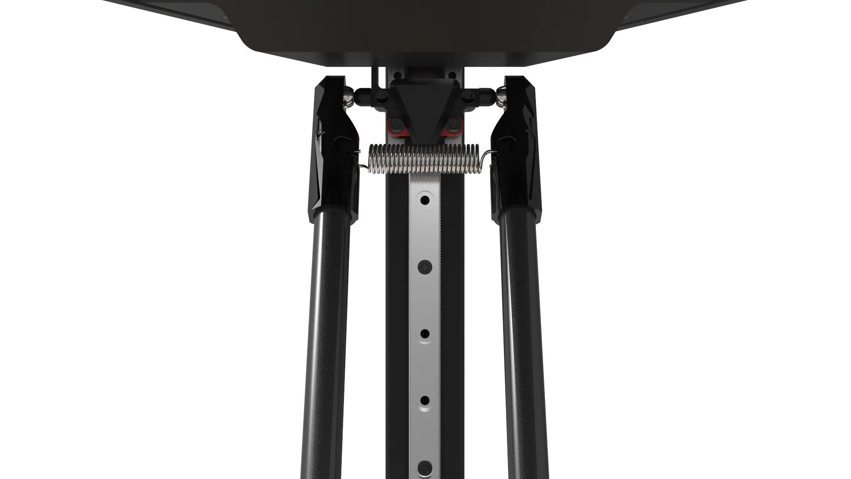
[picture p251: docs/delta/5/80.webp]
   
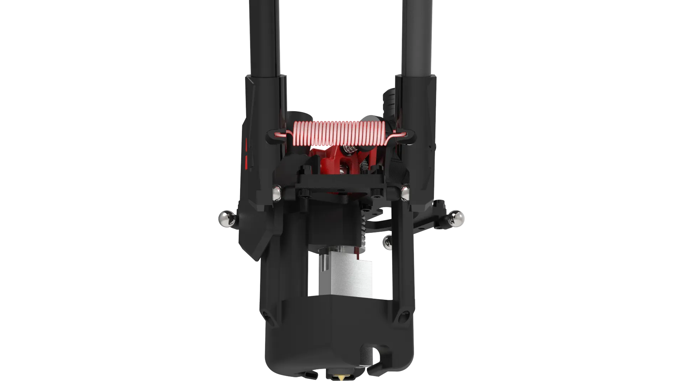
[picture p252: docs/delta/5/81.webp]
   

4.另外两组连接方式相同，如图所示。
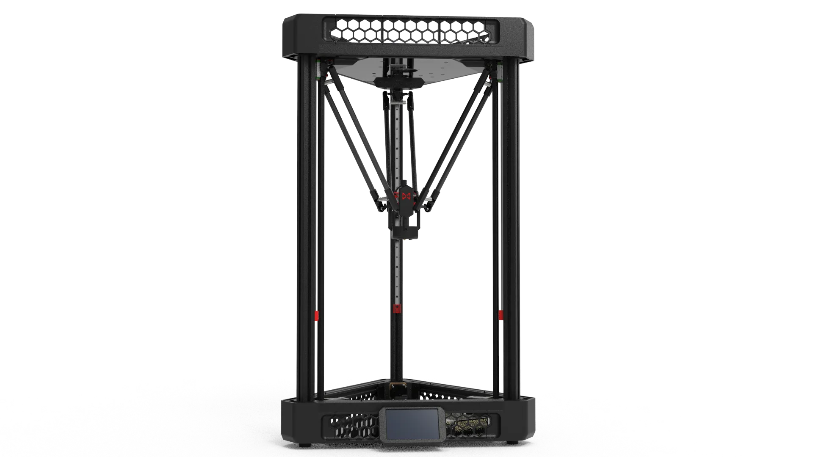
[picture p253: docs/delta/5/82.webp]
   

!!! warning "警告"
    请务必使用<strong>润滑脂</strong>涂抹到每个<strong>勺形连杆</strong>勺型孔中，这是保证运动顺滑的关键，润滑脂一般为白色膏状物，可使用凡士林替代。

!!! note "额外的装饰件"
    这是额外设计的<strong>连杆装饰件</strong>可根据自己喜好选择不同的颜色进行打印，这可改变<strong>勺形连杆</strong>的颜色，一般需要打印<strong>12</strong>个，也可以只打印几个作为点缀，你只要套上去即可，无需拆装你的<strong>勺形连杆</strong>。
    #### [连杆装饰件]
    [连杆装饰件]: dy13.stl
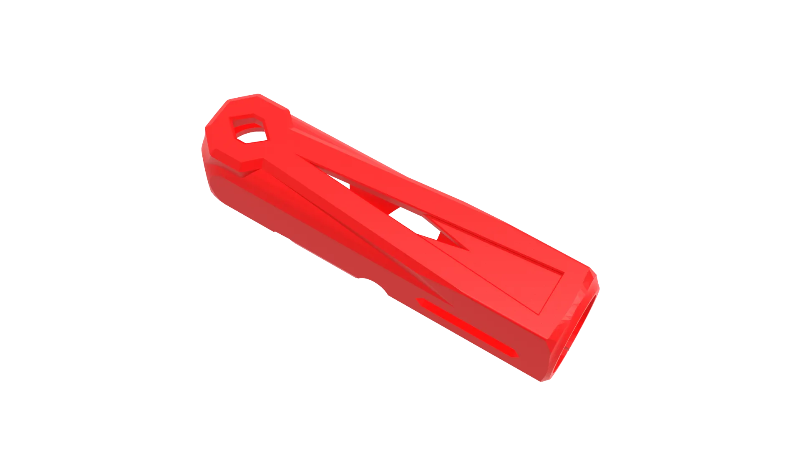
[picture p254: docs/delta/5/dy13.webp]
      

## 6.管线连接

### 所需物料

1.四氟管 * 1
   

### 打印零件

1.[管线卡扣] * 4
[管线卡扣]: dy12.stl
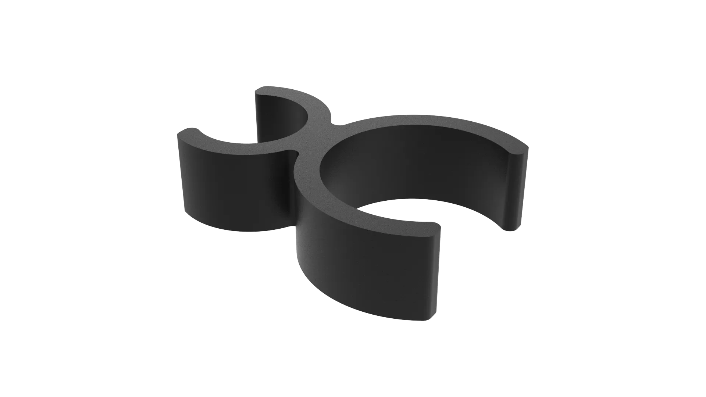
[picture p255: docs/delta/5/dy12.webp]
   

### 组装流程

1.将<strong>CPAP送风管</strong>安装到<strong>风道导向件</strong>上，如图所示。
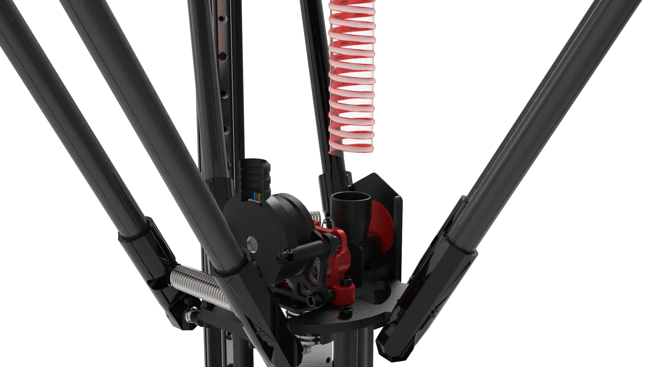
[picture p256: docs/delta/5/83.webp]
   
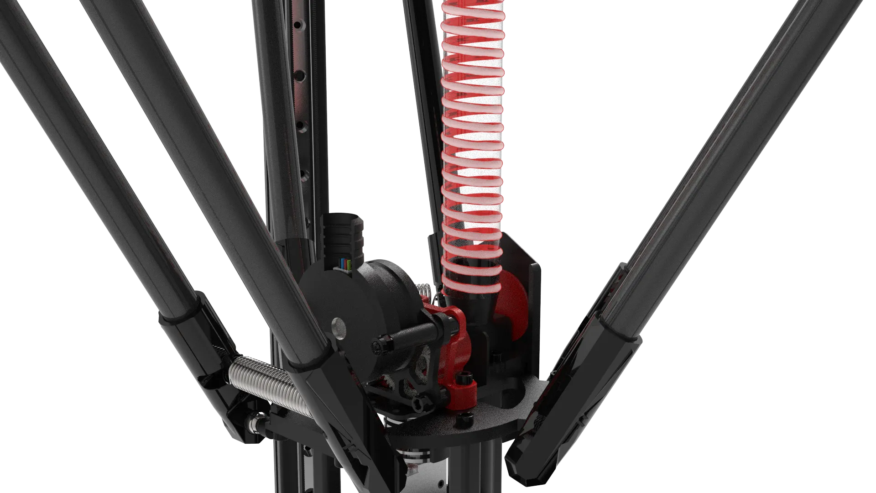
[picture p257: docs/delta/5/84.webp]
   
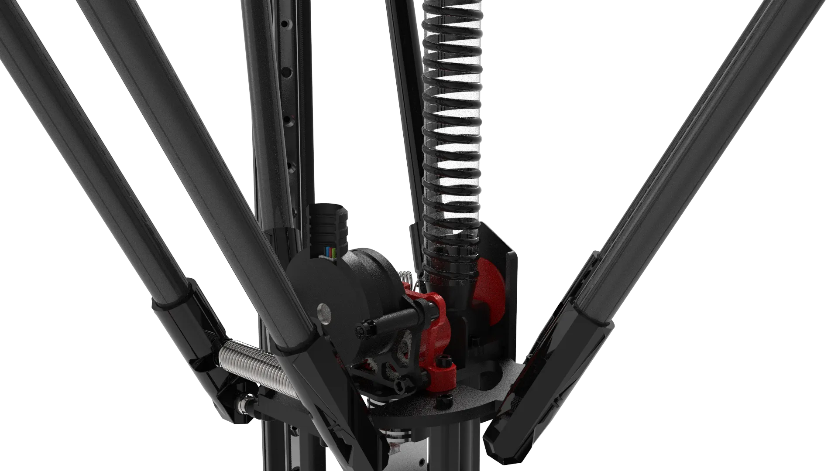
[picture p258: docs/delta/5/85.webp]
   

2.将<strong>四氟管</strong>裁剪出一段20MM长度的短管。
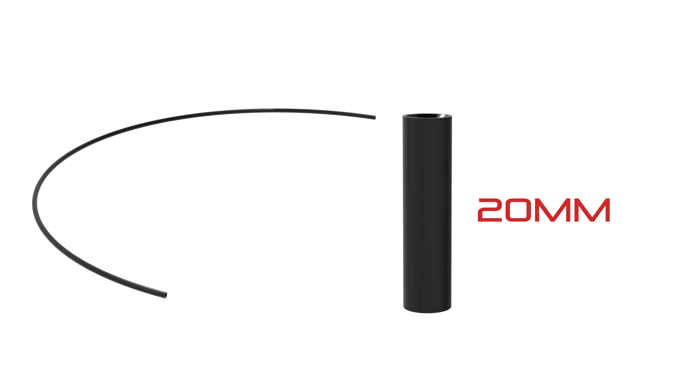
[picture p259: docs/delta/5/20MM.webp]
   

!!! info "四氟管长度"
    此处<strong>四氟管</strong>长度并无严格限制20MM以上也可以。

3.使用短管插入到<strong>挤出机打印件</strong>中，避免耗材磨损打印件，如图所示。
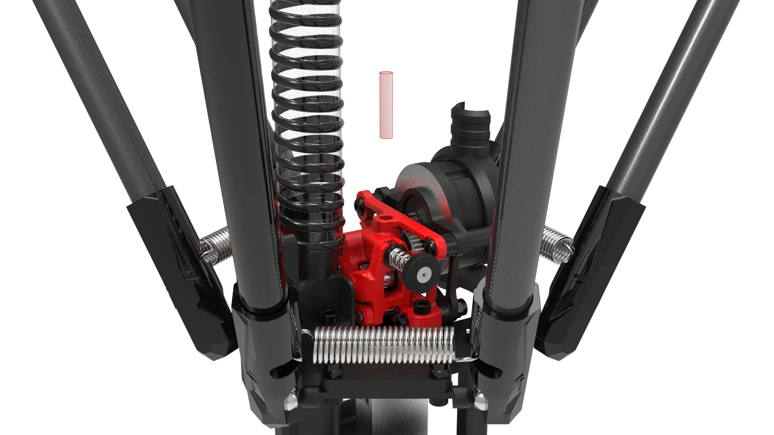
[picture p260: docs/delta/5/86.webp]
   
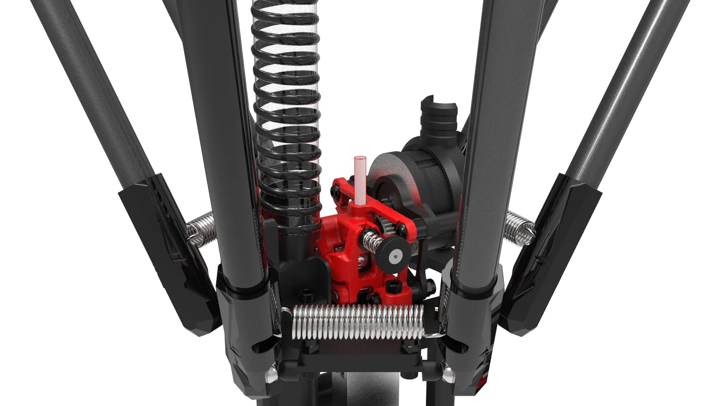
[picture p261: docs/delta/5/87.webp]
   
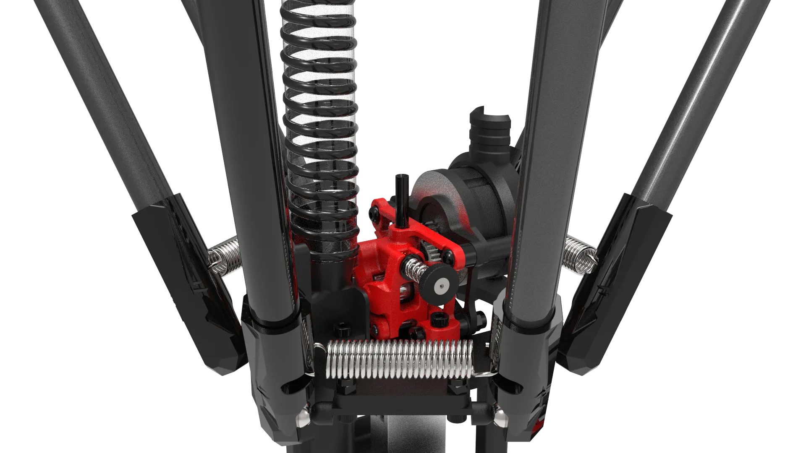
[picture p262: docs/delta/5/88.webp]
   

4.将<strong>波纹管</strong>穿入<strong>底板连接件</strong>的小孔中，如图所示。
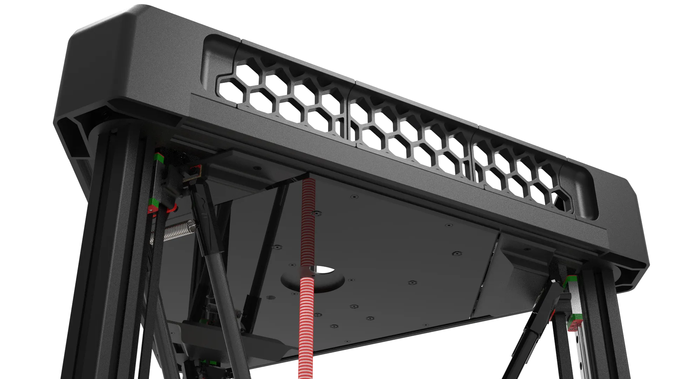
[picture p263: docs/delta/5/89.webp]
   
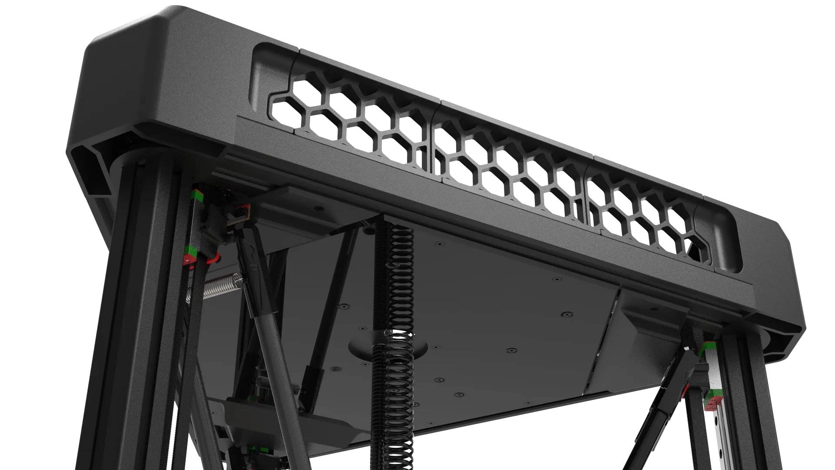
[picture p264: docs/delta/5/90.webp]
   

5.使用<strong>管线卡扣</strong>卡住<strong>CPAP送风管</strong>与<strong>波纹管</strong>，如图所示。
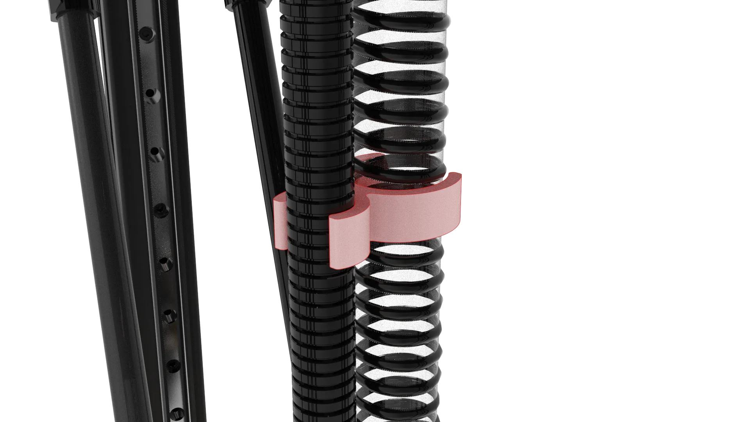
[picture p265: docs/delta/5/91.webp]
   
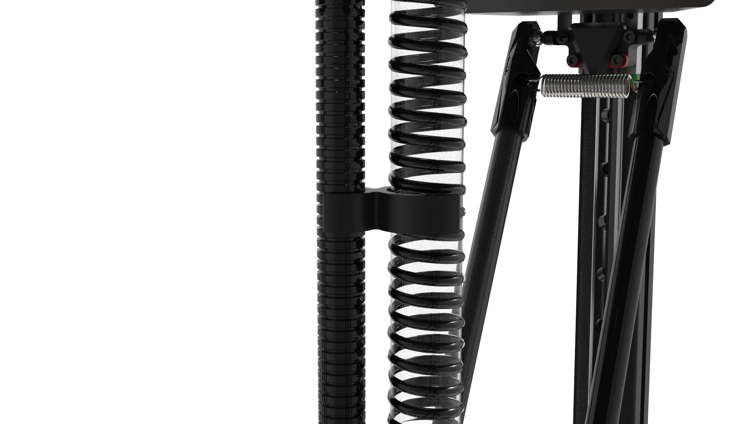
[picture p266: docs/delta/5/92.webp]
   

!!! info "管线卡扣"
    此处<strong>管线卡扣</strong>一般使用三到四个即可，起到美观作用，不打印也无影响。

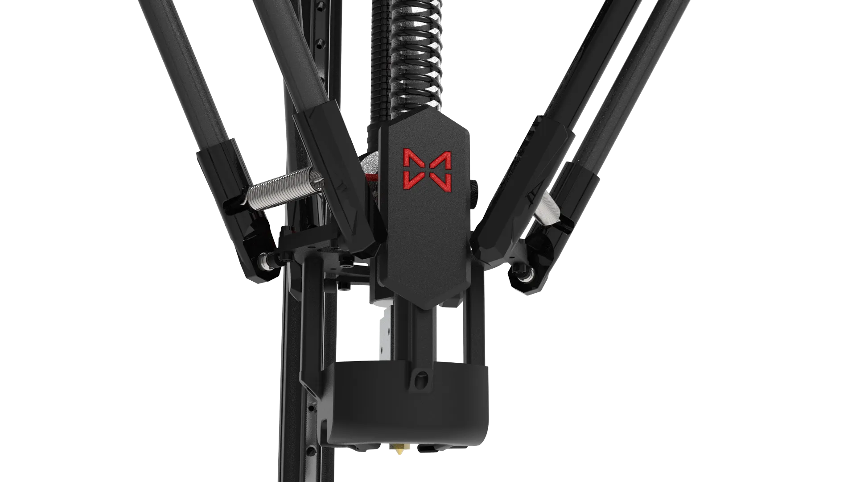
[picture p267: docs/delta/5/93.webp]


???- question "FAQ"

    **Q: 挤出机为什么这样设计？**

    **A:** 使用金属背板与电机固定起到一定散热作用，同时中间使用尼龙隔离柱隔离热量，挤出机采用一体打印，去除原有需要铜螺母与螺丝，降低装配难度提高装配精度（因为无需装配），同时得益于3D打印的优势使能改装与替换变得更加容易。

    **Q: 可以使用其他金属挤出机么？**

    **A:** 可以，孔位使用标准的Sherpa Mini挤出机孔位，可以使用全金属的Sherpa Mini、Sherpa micro、Lgx-lite等挤出机。

    **Q: Super Volcano会不会效果很差？**

    **A:** 我修改了Super Volcano的设计，将黄铜块改为了质量更轻的铝材料，同时喉管使用了TC4的钛合金喉管并进行了加粗，使强度更高，采用标准的V6喉管长度，减少了散热片的高度，经过长期测试效果并不是很差，同时因为喷嘴价格低廉更加适合长期使用。

    **Q: 可以更换其他加热块么？**

    **A:** 可以，使用标准E3DV6喉管，可以更换E3D V6、E3D Volcano与兼容E3D的环形加热块，从而可以选择更加多重种类的喷嘴，更换后可以使用CHT喷嘴。

    **Q: 可以更换整个更换么？**

    **A:** 可以，安装孔位与Voron V6兼容，可以使用大量Voron兼容的打印头。

    **Q: 可以更换风道件么？**

    **A:** 可以，我使用了Youtube的@NeedItMakeIt的导风罩设计挑战的孔位，所以在这场比赛中发布分享的所有导风模型均兼容。

    **Q: 可以安装独立散热风扇么？**

    **A:** 可以，我有预留孔位，可以加装独立喉管散热风扇，最初的设计本来就有，只是我解决了单风扇的问题，为了更高的打印速度，我舍弃了喉管散热风扇。
