micromake/micromake.github.io/docs/delta/4/4.md

---
title: 上部组装
---

## 0.注意事项

!!! warning "螺丝固定"
    螺丝固定打印件时，不要拧的过紧，以免拧坏打印件。

!!! info "嵌入螺母"
    部分打印件需借助烙铁压入<strong>滚花螺母</strong>：
    

## 1.限位组装

### 所需物料

1.光电限位板 * 3
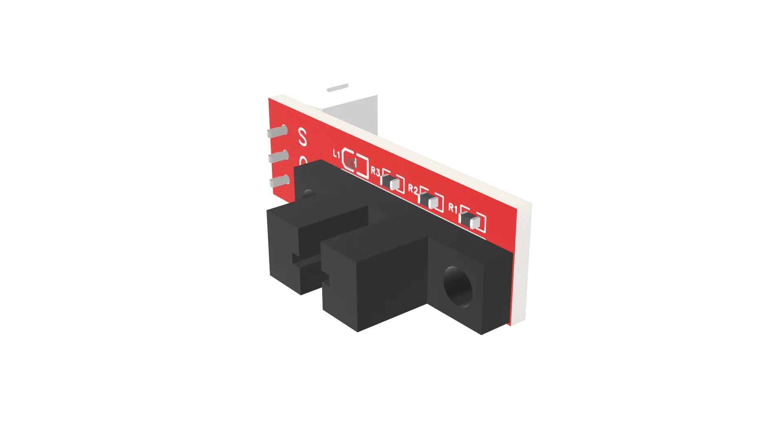
[picture p268: docs/delta/4/xwkg.webp]
   

2.M3*8 沉头螺丝 * 12
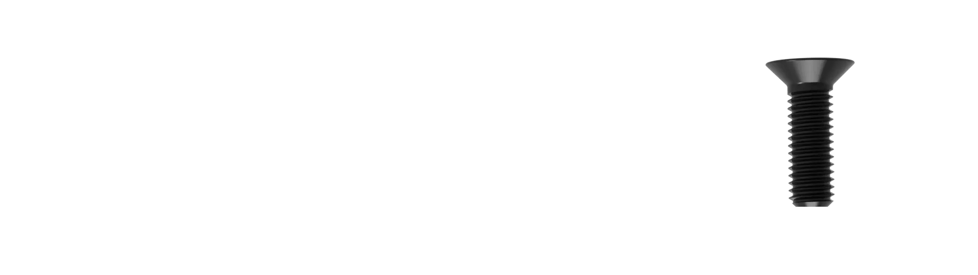
[picture p269: docs/delta/4/M3X8.webp]
   

3.船型螺母20型-M3 * 12
   

### 打印零件

1.[限位固定件] * 3
[限位固定件]: dy1.stl
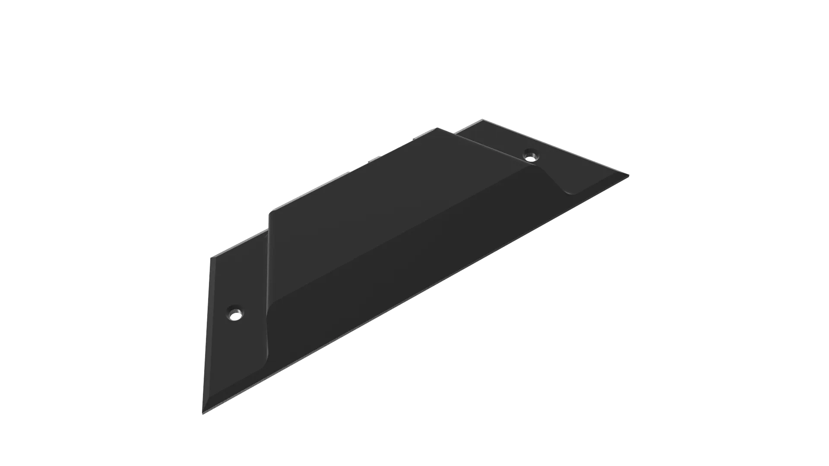
[picture p270: docs/delta/4/dy1.webp]
   

### 组装流程

1.将<strong>光电限位板</strong>穿入<strong>限位固定件</strong>中，拧好两颗<strong>M3*8 沉头螺丝</strong>，不要拧的过紧，以免拧坏打印件，如图所示。
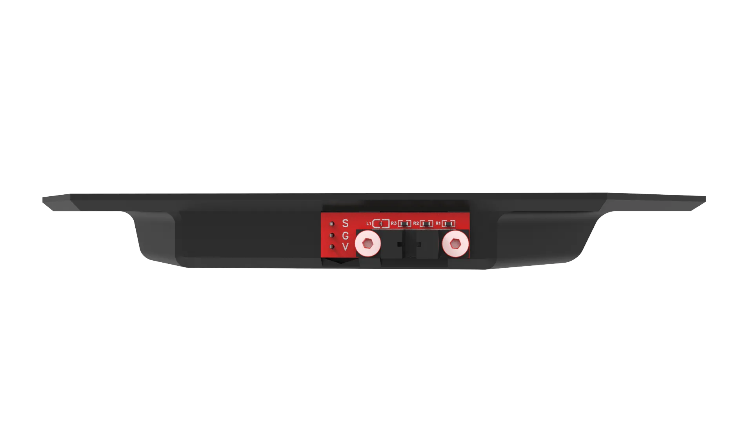
[picture p271: docs/delta/4/2.webp]
   

2.并将<strong>连接线</strong>从<strong>限位固定件</strong>的右侧拨出，避免安装时<strong>步进电机</strong>压到线。
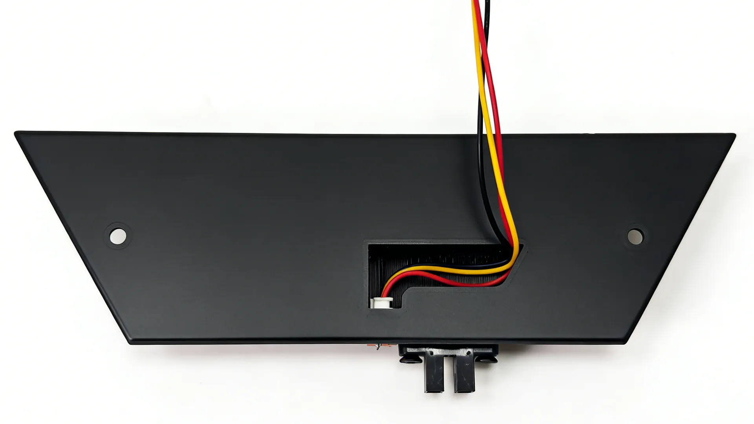
[picture p272: docs/delta/4/3.webp]
   

3.使用两颗<strong>M3*8 沉头螺丝</strong>穿过<strong>限位固定件</strong>并拧上两颗<strong>船型螺母20型-M3</strong>,不要拧紧，拧上即可，如图所示。
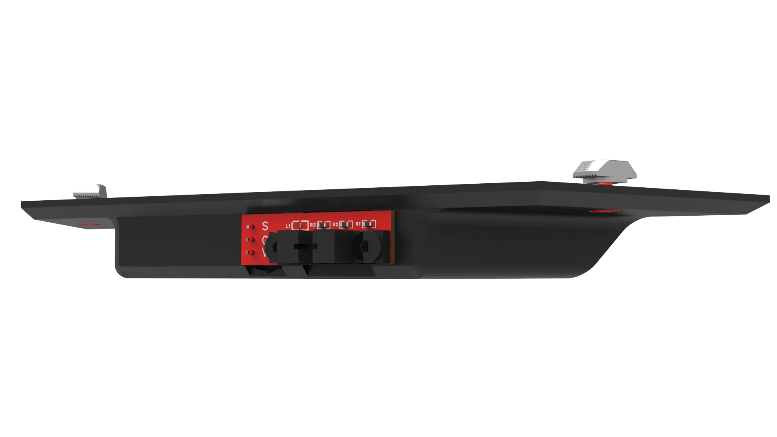
[picture p273: docs/delta/4/4.webp]
   

4.将<strong>限位固定件</strong>固定到框架上，安装时需注意，<strong>金属连接滑块</strong>的凸台需在<strong>光电限位板</strong>的光电传感器的中间位置。
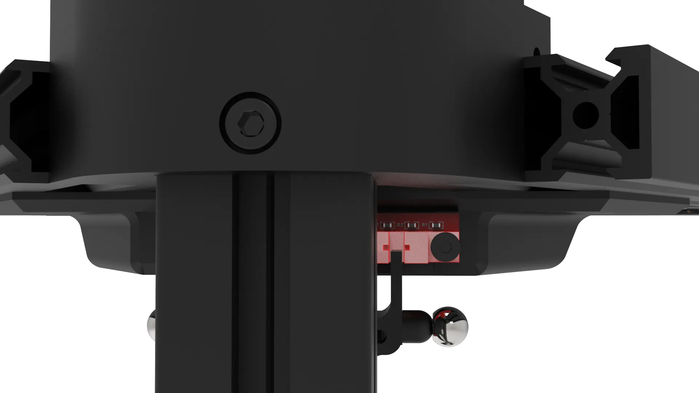
[picture p274: docs/delta/4/5.webp]
   

5.固定到<strong>短铝型材</strong>上，注意<strong>船型螺母20型-M3</strong>的位置，应卡在<strong>短型材</strong>的凹槽内，不要拧的过紧，以免拧坏打印件。
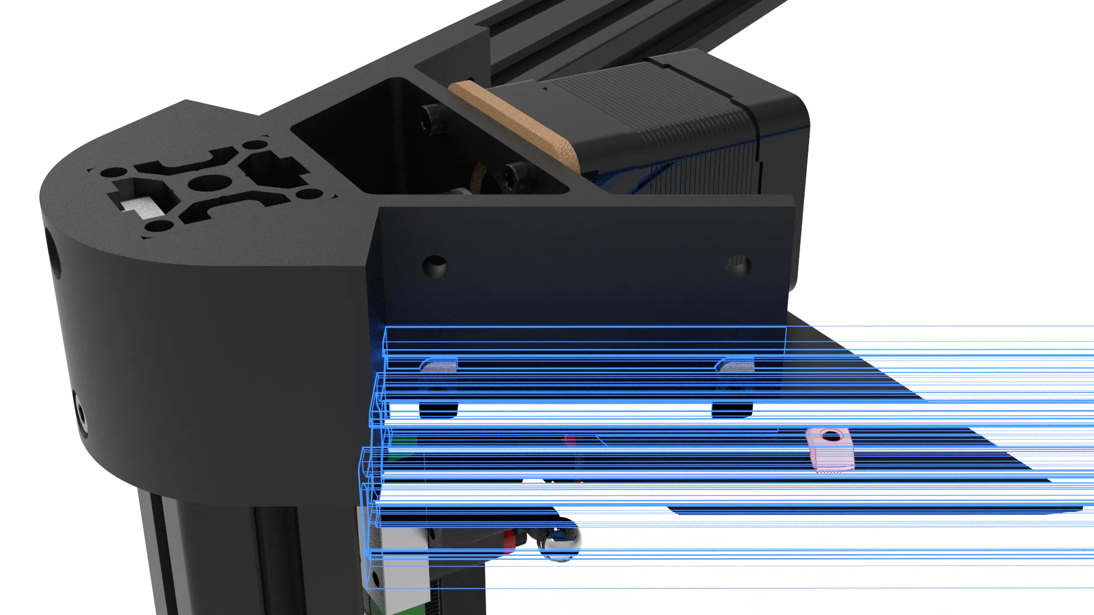
[picture p275: docs/delta/4/6.webp]
   

6.另外两组安装方法相同。
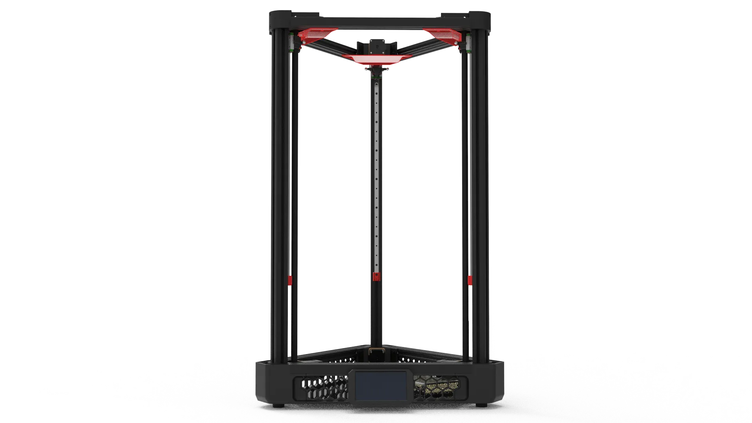
[picture p276: docs/delta/4/7.webp]
   

## 2.上装饰件

### 所需物料

1.M3*10 杯头螺丝 * 6
   
   
2.船型螺母20型-M3 * 6
   

### 打印零件

1.[上脚件装饰件] * 3
[上脚件装饰件]: dy2.stl
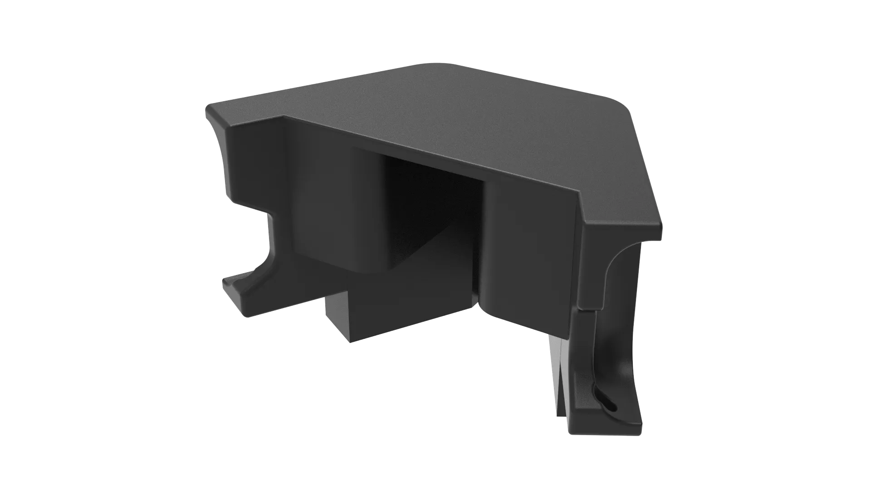
[picture p277: docs/delta/4/dy2.webp]
   

### 组装流程

1.将两颗<strong>M3*10 杯头螺丝</strong>穿过<strong>下脚件装饰件</strong>并套上两颗<strong>船型螺母20型-M3</strong>，不要拧紧，拧上即可，如图所示。
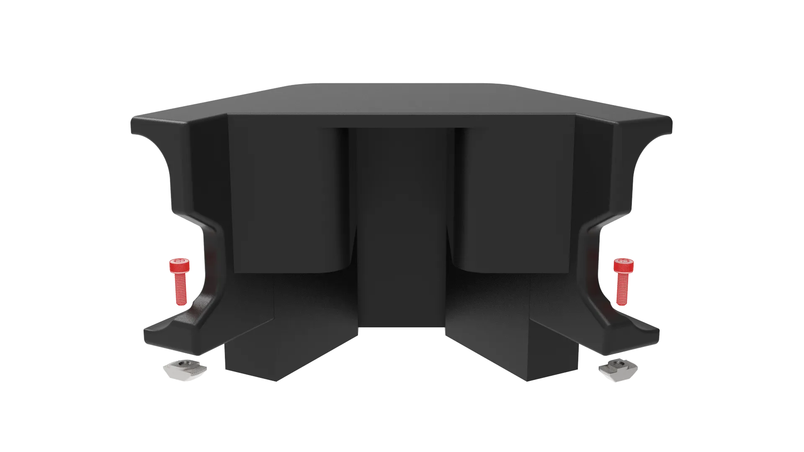
[picture p278: docs/delta/4/8.webp]
   
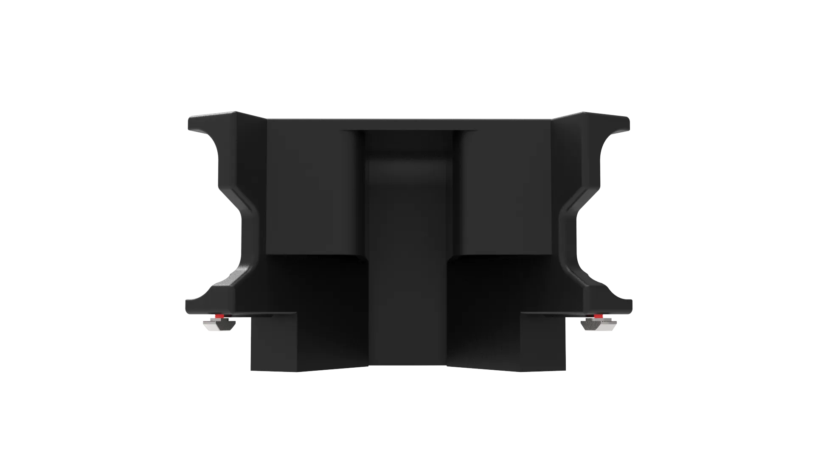
[picture p279: docs/delta/4/9.webp]
   

2.固定到<strong>短铝型材</strong>上，注意<strong>船型螺母20型-M3</strong>的位置，应卡在<strong>短型材</strong>的凹槽内，不要拧的过紧，以免拧坏打印件。
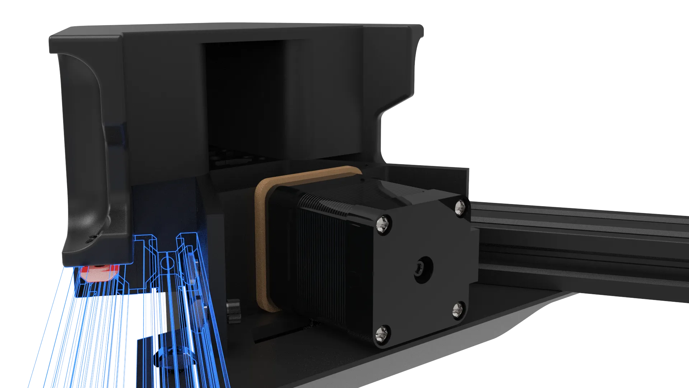
[picture p280: docs/delta/4/10.webp]
   

3.另外两组安装方法相同。
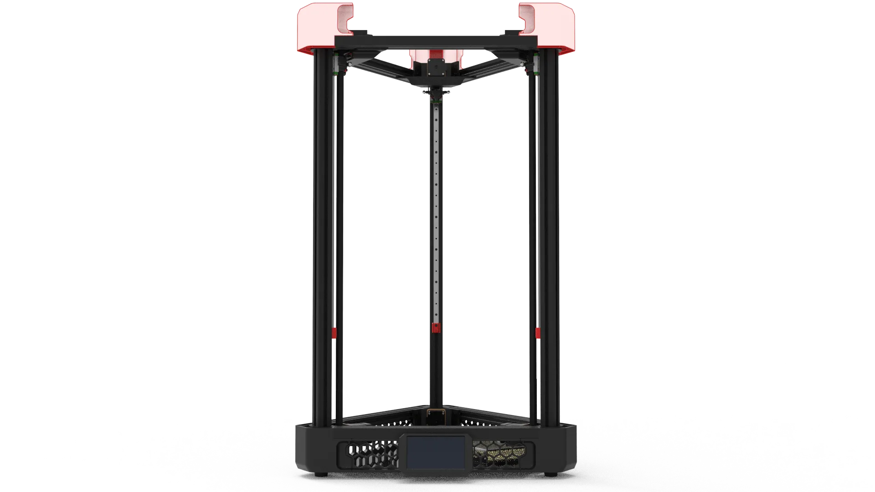
[picture p281: docs/delta/4/11.webp]
   

## 3.左侧裙边

### 所需物料

1.M3*8 沉头螺丝 * 6
   

2.滚花螺母 * 3
   
   
3.船型螺母20型-M3 * 6
   

### 打印零件

1.[左裙边打印件]  * 3
[左裙边打印件]: dy3.stl
   

### 组装流程

1.使用烙铁将<strong>滚花螺母</strong>压入<strong>左裙边打印件</strong>中。
   

2.将<strong>M3*8 沉头螺丝</strong>穿过<strong>左裙边打印件</strong>并套上<strong>船型螺母20型-M3</strong>。
   

3.<strong>M3*8 沉头螺丝</strong>拧上即可，无需拧紧。
   

4.固定到<strong>短铝型材</strong>上，注意<strong>船型螺母20型-M3</strong>的位置，应卡在<strong>短型材</strong>的凹槽内，不要拧的过紧，以免拧坏打印件。
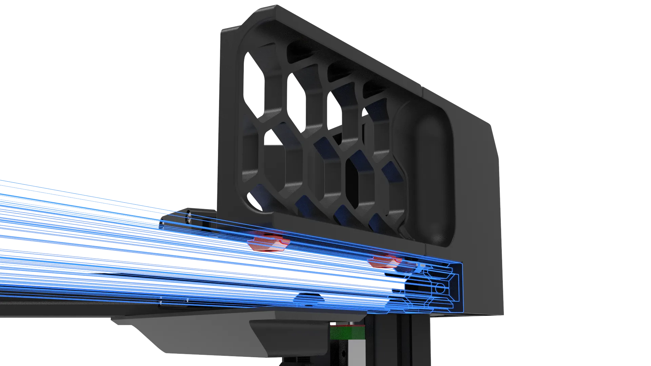
[picture p282: docs/delta/4/20.webp]
   

5.另外两组安装方法相同。
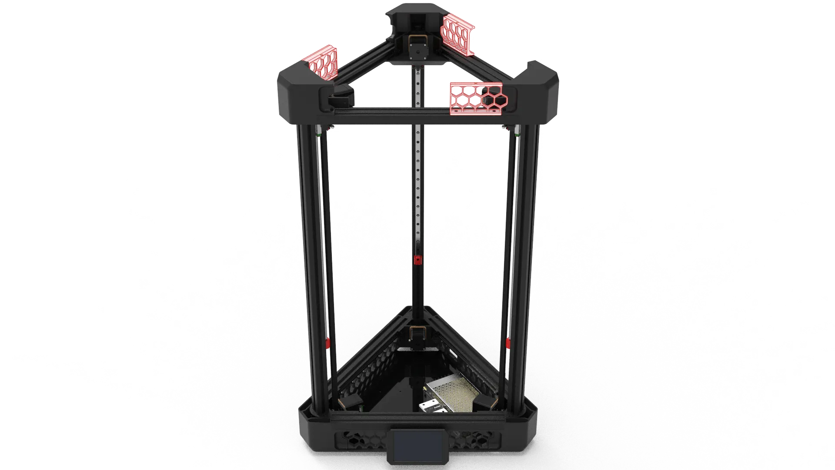
[picture p283: docs/delta/4/21.webp]
   

## 4.右侧裙边

### 所需物料

1.M3*8 沉头螺丝 * 6
   

2.滚花螺母 * 3
   

3.船型螺母20型-M3 * 6
   

### 打印零件

1.[右裙边打印件] * 3
[右裙边打印件]: dy4.stl
   

### 组装流程

1.使用烙铁将<strong>滚花螺母</strong>压入<strong>右裙边打印件</strong>中。
   

2.将<strong>M3*8 沉头螺丝</strong>穿过<strong>右裙边打印件</strong>并套上<strong>船型螺母20型-M3</strong>。
   

3.<strong>M3*8 沉头螺丝</strong>拧上即可，无需拧紧。
      

4.固定到<strong>短铝型材</strong>上，注意<strong>船型螺母20型-M3</strong>的位置，应卡在<strong>短型材</strong>的凹槽内，不要拧的过紧，以免拧坏打印件。
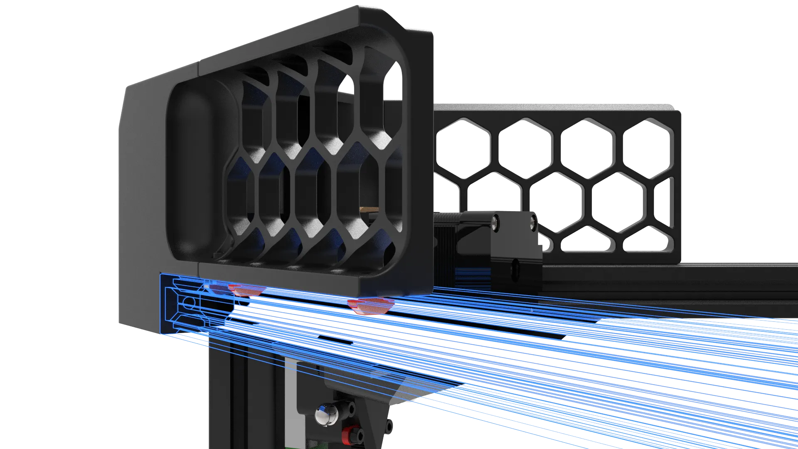
[picture p284: docs/delta/4/18.webp]
   

5.另外两组安装方法相同。
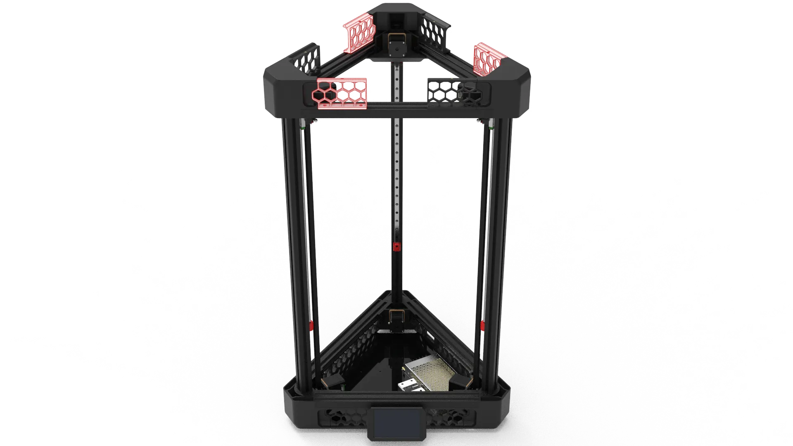
[picture p285: docs/delta/4/19.webp]
   

## 5.中间裙边

### 所需物料

1.M3*8 沉头螺丝 * 6
   

2.滚花螺母 * 6
   

3.船型螺母20型-M3 * 6
   

### 打印零件

1.[中间裙边打印件] * 3
[中间裙边打印件]: dy5.stl
   

### 组装流程

1.使用烙铁将<strong>滚花螺母</strong>压入<strong>中间裙边打印件</strong>中。
   

2.将<strong>M3*8 沉头螺丝</strong>穿过<strong>中间裙边打印件</strong>并套上<strong>船型螺母20型-M3</strong>。
   

3.<strong>M3*8 沉头螺丝</strong>拧上即可，无需拧紧。
      

4.固定到<strong>短铝型材</strong>上，注意<strong>船型螺母20型-M3</strong>的位置，应卡在<strong>短型材</strong>的凹槽内，不要拧的过紧，以免拧坏打印件。
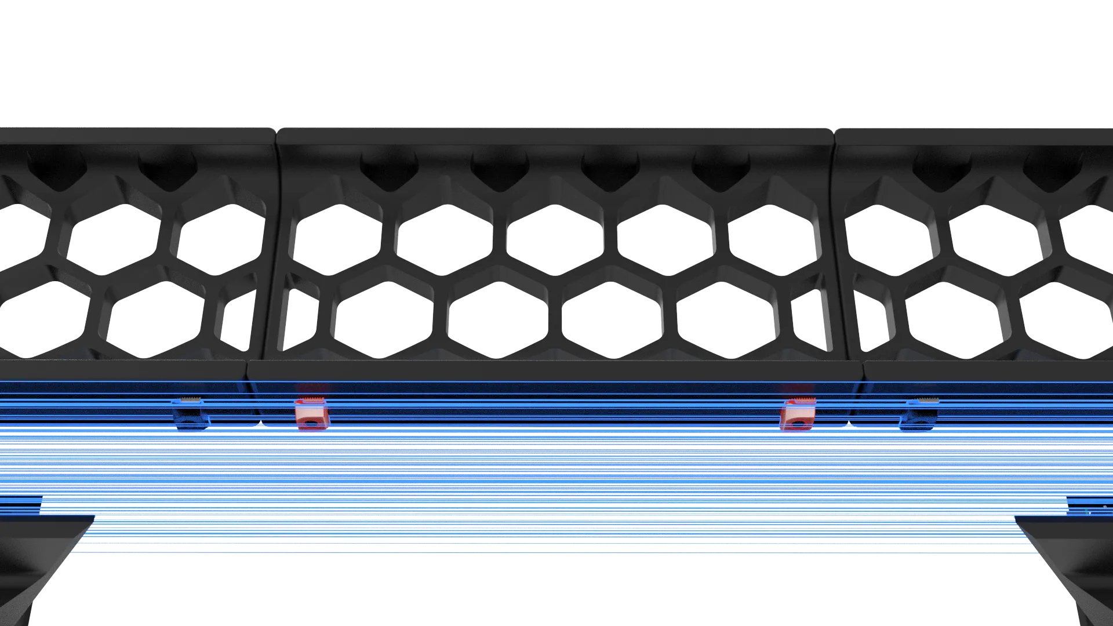
[picture p286: docs/delta/4/26.webp]
   

5.另外两组安装方法相同。
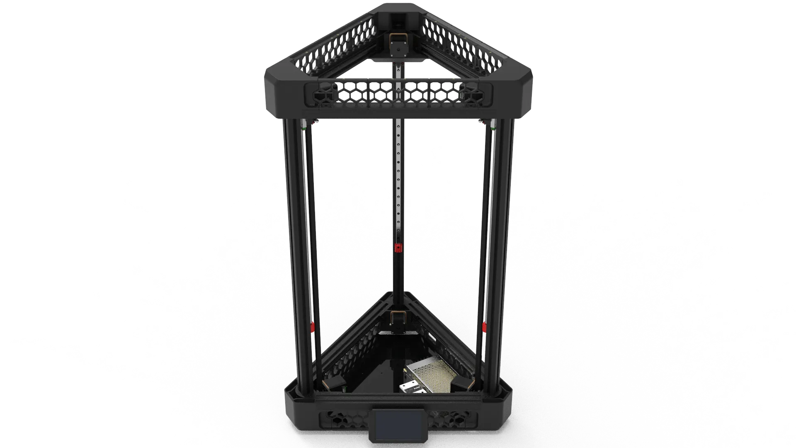
[picture p287: docs/delta/4/27.webp]
   

## 6.电器固定

### 所需物料

1.顶部固定板 * 1
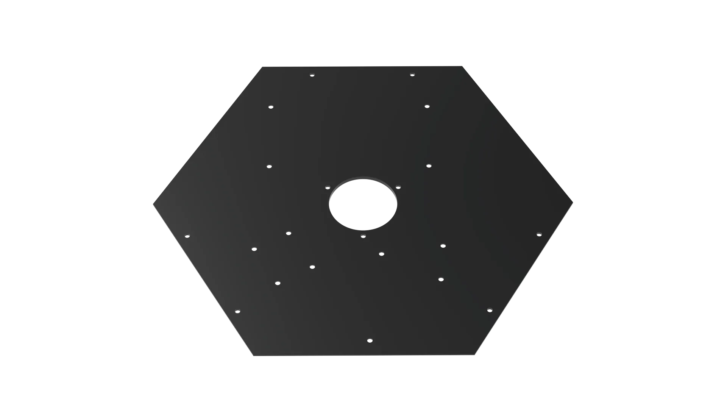
[picture p288: docs/delta/4/dgb.webp]
   

2.下位机主板 * 1
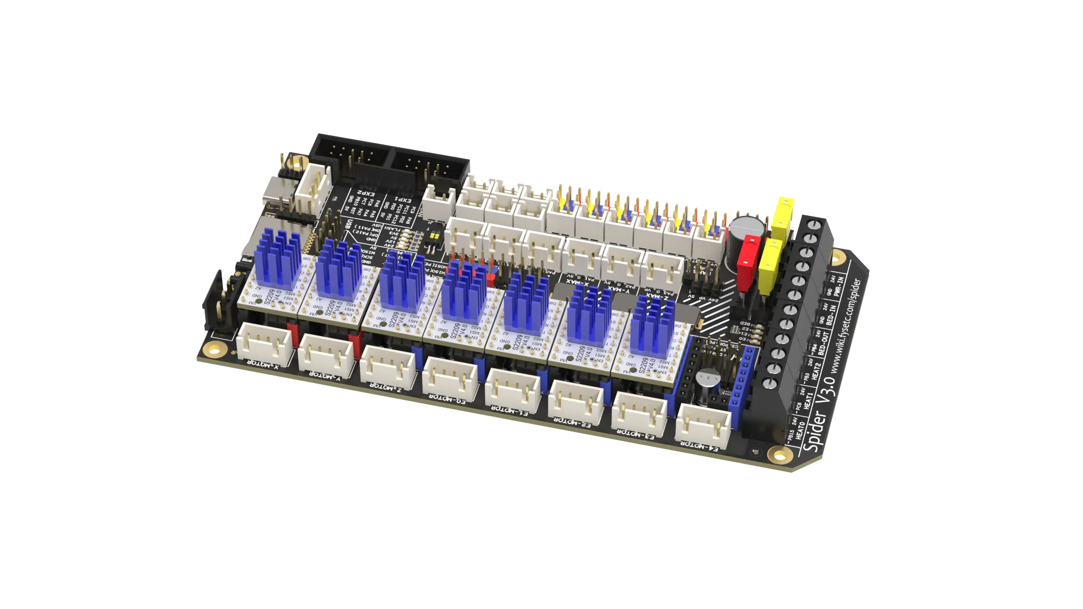
[picture p289: docs/delta/4/spiderV3.webp]
   

3.CPAP驱动板 * 1
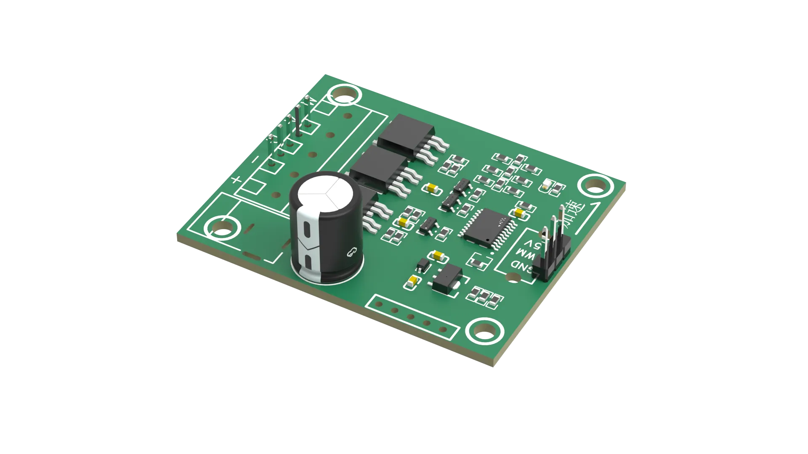
[picture p290: docs/delta/4/qdb.webp]
   

4.CPAP风扇 * 1
   

5.CPAP送风管 * 1
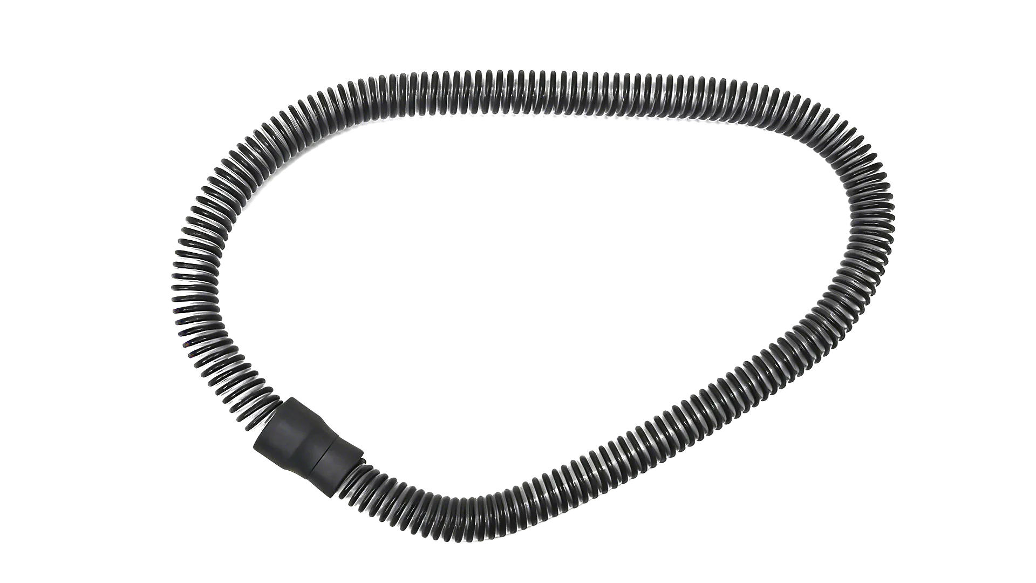
[picture p291: docs/delta/4/sfg.webp]
   

6.黄色杜邦线 * 1
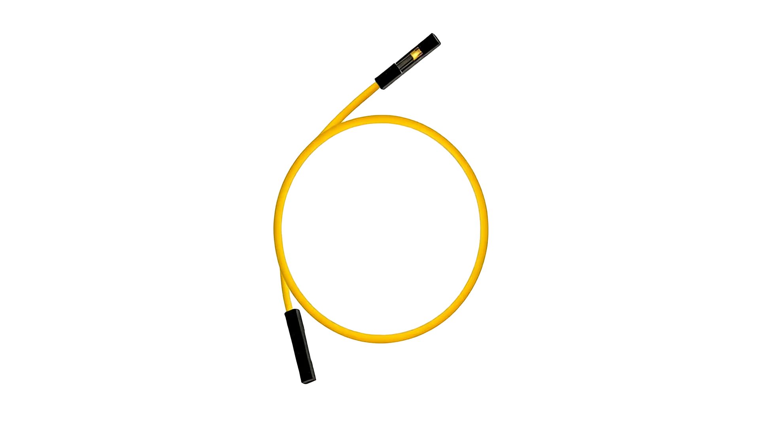
[picture p292: docs/delta/4/1dbx.webp]
   

7.红黑杜邦线 * 1
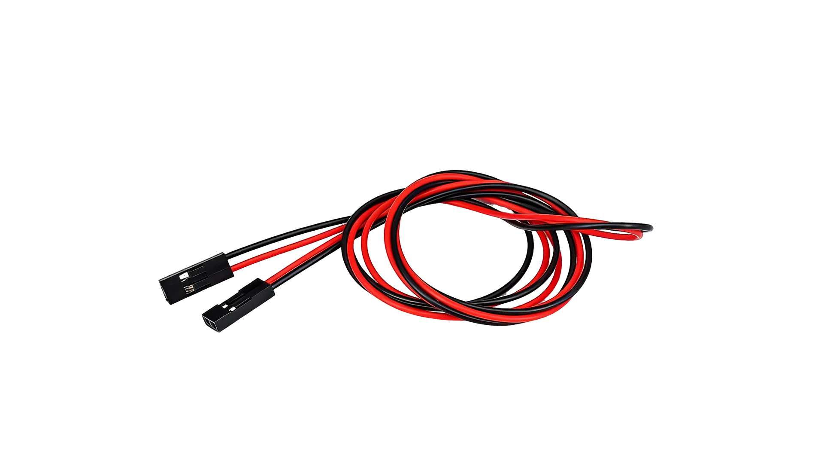
[picture p293: docs/delta/4/2dbx.webp]
   

8.M3*8 沉头螺丝 * 29
   

9.滚花螺母 * 3
   

10.船型螺母20型-M3 * 6
   

### 打印零件

1.[底板连接件] * 1
[底板连接件]: dy6.stl
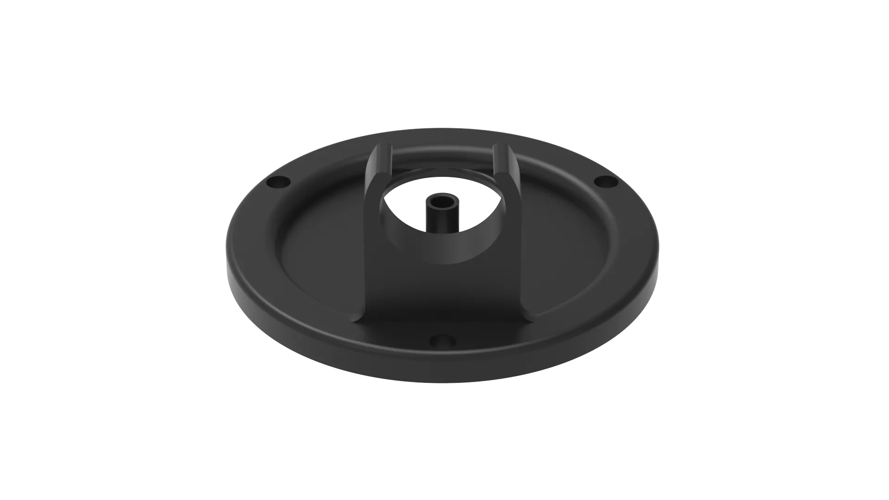
[picture p294: docs/delta/4/dy6.webp]
   

2.[短隔离柱] * 8
[短隔离柱]: dy7.stl
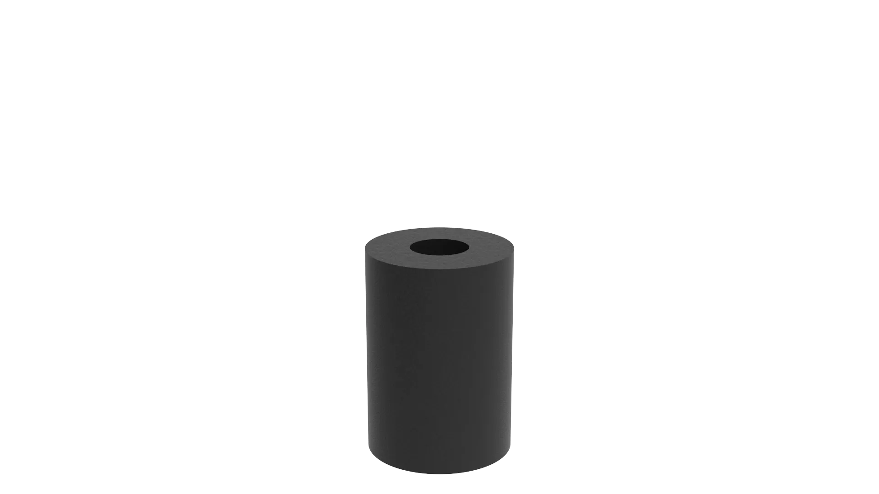
[picture p295: docs/delta/4/dy7.webp]
   

3.[长隔离柱] * 2
[长隔离柱]: dy8.stl
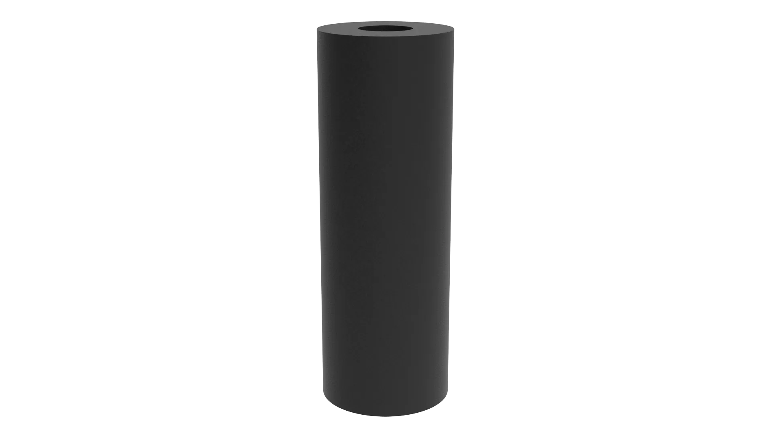
[picture p296: docs/delta/4/dy8.webp]
   

### 组装流程

1.使用烙铁将三颗<strong>滚花螺母</strong>压入<strong>底板连接件</strong>中。
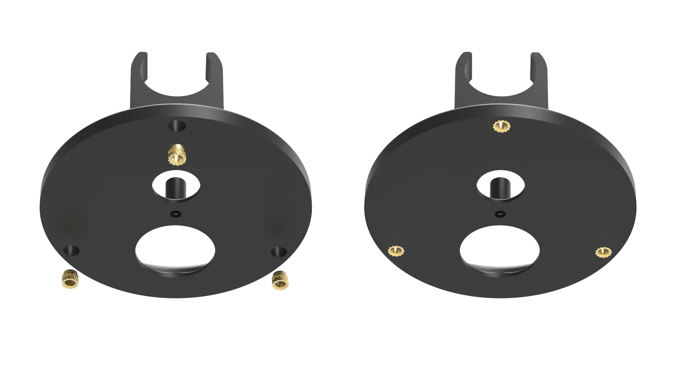
[picture p297: docs/delta/4/28.webp]
   

2.使用三颗<strong>M3*8 沉头螺丝</strong>穿入顶部固定板，如图所示。
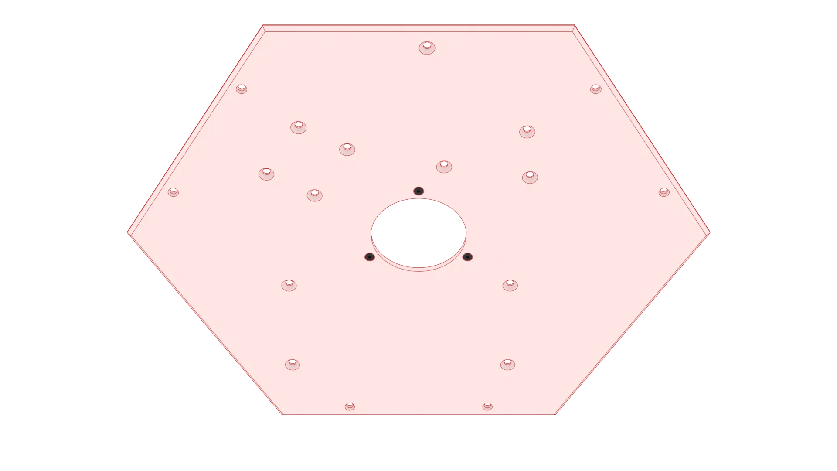
[picture p298: docs/delta/4/29.webp]
   

3.将<strong>底板连接件</strong>与<strong>顶部固定板</strong>使用三颗<strong>M3*8 沉头螺丝</strong>锁紧，如图所示。
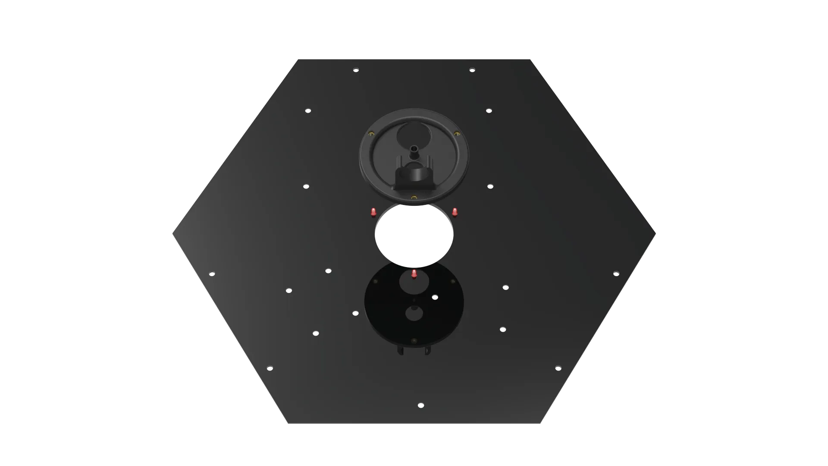
[picture p299: docs/delta/4/30.webp]
   
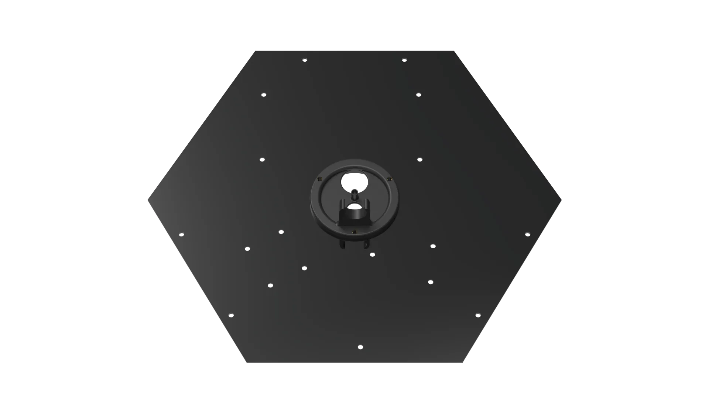
[picture p300: docs/delta/4/31.webp]
   

4.将<strong>底板连接件</strong>与<strong>短隔离柱</strong>使用<strong>M3*8 沉头螺丝</strong>锁紧，如图所示。
   
   

5.安装<strong>下位机主板</strong>使用四颗<strong>M3*8 沉头螺丝</strong>锁紧，如图所示。
   
      
6.将<strong>底板连接件</strong>与<strong>短隔离柱</strong>使用<strong>M3*8 沉头螺丝</strong>锁紧，如图所示。
   
   

7.安装<strong>CPAP驱动板</strong>使用四颗<strong>M3*8 沉头螺丝</strong>锁紧，如图所示。
   
   
8.将<strong>底板连接件</strong>与<strong>长隔离柱</strong>使用<strong>M3*8 沉头螺丝</strong>锁紧，如图所示。
   
   
   
   
9.使用两颗<strong>M3*8 沉头螺丝</strong>，将<strong>CPAP风扇</strong>安装到<strong>电路固定底板</strong>上，如图所示。
   
   

!!! tip "提示"
    <strong>CPAP风扇</strong>默认已安装了<strong>风扇转接件</strong>，如果安装时不慎损坏，在此处并重新下载打印即可。
    #### [风扇转接件]
    [风扇转接件]: dy9.stl
      

10.将<strong>CPAP送风管</strong>插入<strong>CPAP风扇</strong>的出风口中，将管道穿过<strong>底板连接件</strong>的卡扣中，如图所示。
    

!!! info "接线图"
    

11.使用<strong>M3*8 沉头螺丝</strong>穿过<strong>顶部固定板</strong>并套上<strong>船型螺母20型-M3</strong>后,固定如图所示位置。
    

12.注意安装的方向，<strong>下位机主板</strong>应在前方，如图所示位置。
    

13.调整<strong>船型螺母20型-M3</strong>，确保所有螺母均卡在<strong>短型材</strong>的卡槽中后再拧紧。
    



???- question "FAQ"

    **Q: CPAP风扇的作用是什么？**

    **A:** 使用CPAP风扇风量大、低频风噪小、风压恒定、散热更稳，进风环境干净，寿命更长，同时因为风扇进风不在腔体内，不会受腔体温度影响，无风扇就无震动、不干扰打印头，同时进一步降低吊台的重量，满足高速打印需求。
