micromake/micromake.github.io/docs/delta/6/6.md

---
title: 热床组装
---

## 0.注意事项

!!! warning "螺丝固定"
    螺丝固定打印件时，不要拧的过紧，以免拧坏打印件。

## 1.热床支架

### 所需物料

1.热床铝板 * 1
   

2.M3*14 杯头螺丝 * 6
   

3.船型螺母20型-M3 * 6
   

4.M4*8 圆头螺丝 * 3
   

5.盲孔球头 * 3
   

### 打印零件

1.[热床支架] * 3
[热床支架]: dy1.stl
   

### 组装流程

1.将<strong>M4*8 圆头螺丝</strong>穿过<strong>热床支架</strong>并拧入<strong>盲孔球头</strong>，需拧紧，如图所示。
   
   
   

2.使用两颗<strong>M3*14 杯头螺丝</strong>穿过<strong>热床支架</strong>并拧上两颗<strong>船型螺母20型-M3</strong>,不要拧紧，拧上即可，如图所示。
   
   

3.固定到<strong>短铝型材</strong>上，注意两颗<strong>船型螺母20型-M3</strong>的位置，应卡在<strong>短型材</strong>的凹槽内，不要拧紧，如图所示。
   
   

4.调整<strong>热床支架</strong>的位置，使<strong>短铝型材</strong>的边缘与<strong>热床支架</strong>两边的距离相同，如图所示。
   

5.另外两组安装方法相同。
   
   
6.将<strong>热床铝板</strong>放到<strong>热床支架</strong>上，如图所示。
   
   

!!! info "热床铝板"
    注意<strong>热床铝板</strong>的正反，台阶孔应朝上，
    

7.微调<strong>热床铝板</strong>与<strong>热床支架</strong>的位置，使<strong>热床铝板</strong>的三个孔均能放入<strong>热床支架</strong>的<strong>盲孔球头</strong>中，在确保<strong>热床铝板</strong>的三个孔均能放入<strong>热床支架</strong>的<strong>盲孔球头</strong>后，测量并微调<strong>短铝型材</strong>的边缘与<strong>热床支架</strong>两边的距离使基本一致后，锁紧所有<strong>热床支架</strong>固定型材上的<strong>M3*14 杯头螺丝</strong>，不要拧的过紧，以免损坏打印件，如图所示。
   
   
!!! info "嵌入螺母"
    锁紧后检查<strong>热床铝板</strong>，确保<strong>热床铝板</strong>与<strong>热床支架</strong>的<strong>盲孔球头</strong>紧密贴合没有间隙，不会产生晃动或不平的问题，如果有需松掉螺丝重新调整。

    可通过<strong>短铝型材</strong>两侧观察<strong>船型螺母20型-M3</strong>的位置，确保两边的螺丝均卡在<strong>短型材</strong>的凹槽内并已拧紧。

    

## 2.两侧挡板

### 所需物料

1.M3*8 沉头螺丝 * 4
   

2.船型螺母20型-M3 * 4
   

### 打印零件

1.[两侧热床挡板] * 2
[两侧热床挡板]: dy2.stl
   

### 组装流程

1.使用两颗<strong>M3*8 沉头螺丝</strong>穿过<strong>热床支架</strong>并拧上两颗<strong>船型螺母20型-M3</strong>,不要拧紧，拧上即可，如图所示。
   
   

2.固定到<strong>短铝型材</strong>上，注意两颗<strong>船型螺母20型-M3</strong>的位置，应卡在<strong>短型材</strong>的凹槽内，并锁紧，不要拧的过紧，以免损坏打印件，如图所示。
   

3.另外一侧安装方法相同。
   

## 3.后侧挡板

### 所需物料

1.M3*8 沉头螺丝 * 2
   

2.船型螺母20型-M3 * 2
   

### 打印零件

1.[后侧热床挡板] * 1
[后侧热床挡板]: dy3.stl
   

### 组装流程

1.将两颗<strong>M3*8 沉头螺丝</strong>穿过<strong>热床支架</strong>并拧上两颗<strong>船型螺母20型-M3</strong>，不要拧紧，拧上即可，如图所示。
   
   

2.固定到<strong>短铝型材</strong>上，注意两颗<strong>船型螺母20型-M3</strong>的位置，应卡在<strong>短型材</strong>的凹槽内，并锁紧，不要拧的过紧，以免损坏打印件，如图所示。
   

## 4.热床组装

### 所需物料

1.PEI板 * 1
   

2.磁吸贴 * 1
   

3.加热膜 * 1
   

4.热床保险 * 1
   

5.保险连接线 * 1
   

6.M3*10 杯头螺丝 * 1
   

7.自锁螺母 * 1
   

### 组装流程

1.使用<strong>M3*10 杯头螺丝</strong>穿过<strong>热床铝板</strong>与<strong>热床保险</strong>,使用<strong>自锁螺母</strong>拧紧，如图所示。
   

!!! warning "螺丝固定"
    注意<strong>M3*10 杯头螺丝</strong>安装<strong>热床铝板</strong>的方向，台阶孔应朝上。
    

2.连接<strong>保险连接线</strong>，如图所示。
   

3.将<strong>加热膜</strong>贴到<strong>热床铝板</strong>上，<strong>加热膜</strong>应在<strong>热床铝板</strong>中间，出线位置靠近<strong>热床保险</strong>，如图所示。
   
   

4.将<strong>加热膜</strong>的保险连接线与<strong>热床保险</strong>的连接线进行连接，如图所示。
   
   

5.反转<strong>热床铝板</strong>将<strong>磁吸贴</strong>贴到<strong>热床铝板</strong>上，如图所示。
   
   

6.将<strong>PEI板</strong>装到<strong>热床铝板</strong>上，如图所示。
   
   

???- question "FAQ"

    **Q: 为什么热床固定不使用螺丝而使用球头固定热床？**

    **A:** 螺丝固定受热后，影响热床平整度,加热会使铝板热变形，使用螺丝固定使热应力无法正常延伸，温度越高、螺丝越多、排布越密、应力越大。

    **Q: 这样设计的优点有哪些？**

    **A:** 三点确定一个平面，无论铝板怎么膨胀变形，三点使能保证一个稳定的平面，同时方便维护，可随时将热床放置在后侧卡槽中，对底部电器仓进行清理及改装。

    **Q: 为什么热床不贴保温棉？**

    **A:** 保温棉的作用是防止热量流失，常用于直流热床，因功率所限，升温速度慢，需要保温，使用交流热床有着较快的升温速度，功率相对较大，为了提高生产效率，不使用保温棉，可更快的冷却热床，提高取件效率。

    **Q: 可以给热床贴保温棉么?**

    **A:** 可以，不过增加保温棉后热床冷却的时间将会增加，可能需要取下PEI板，加快冷却时间使能更快的取下3D打印的模型。
