micromake/micromake.github.io/docs/delta/1/31.webp

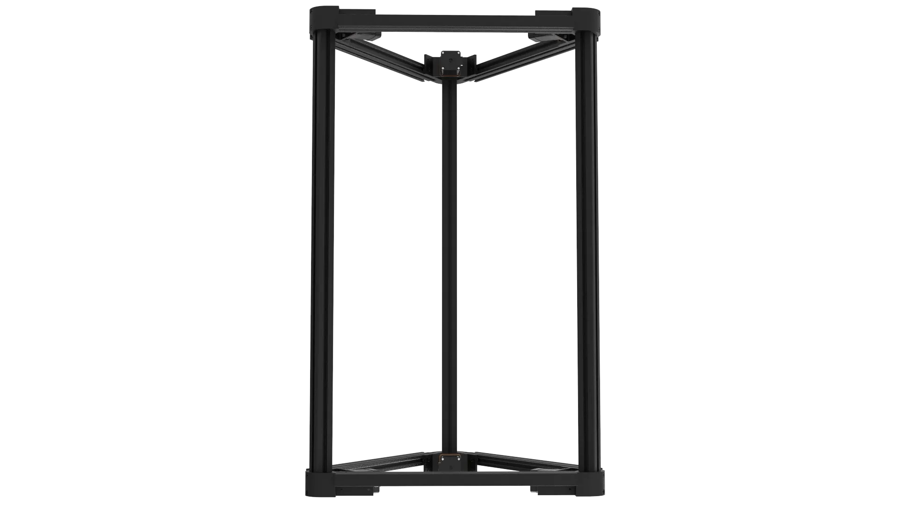
docs/delta/1/31.webp
