micromake/micromake.github.io/docs/delta/1/20401.webp

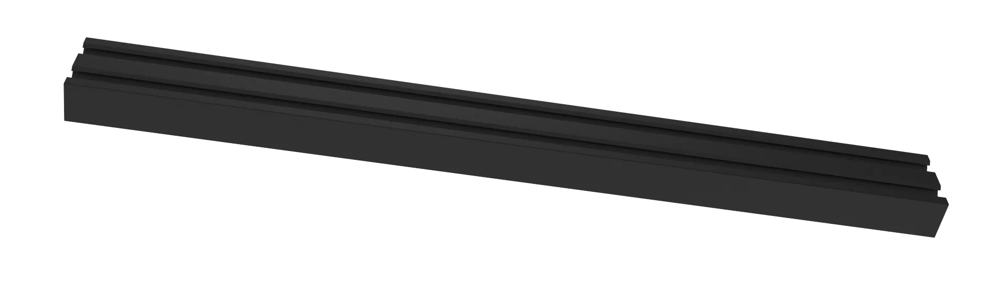
docs/delta/1/20401.webp
