micromake/micromake.github.io/docs/delta/2/dy1.stl

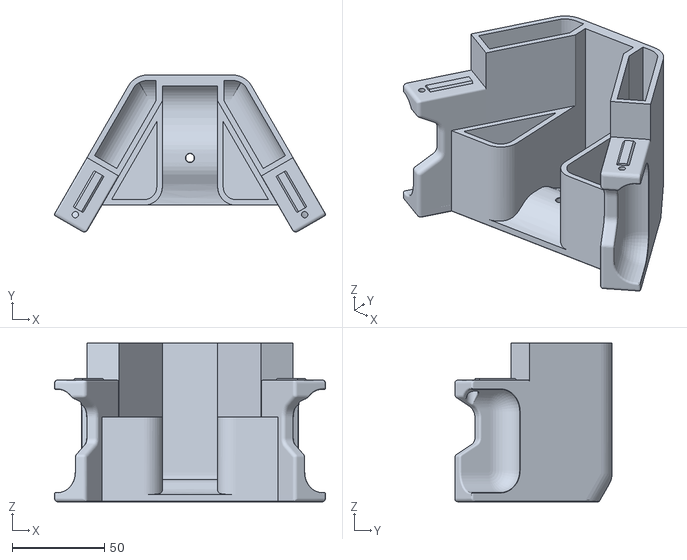
[picture p303: CAD file, 2026-02-28]
docs/delta/2/dy1.stl
147.0 x 85.2 x 86.0
