micromake/micromake.github.io/docs/delta/3/dy5.stl

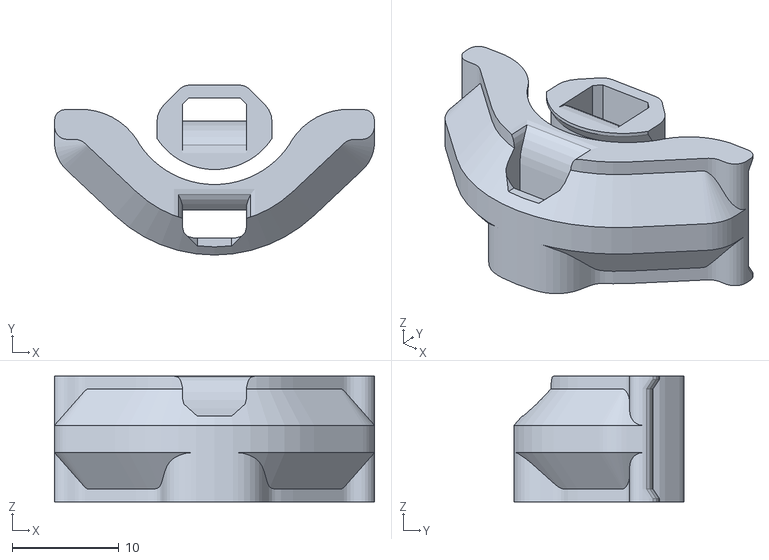
[picture p304: CAD file, 2026-02-28]
docs/delta/3/dy5.stl
30.0 x 15.9 x 11.8
