micromake/micromake.github.io/docs/delta/4/dy9.stl

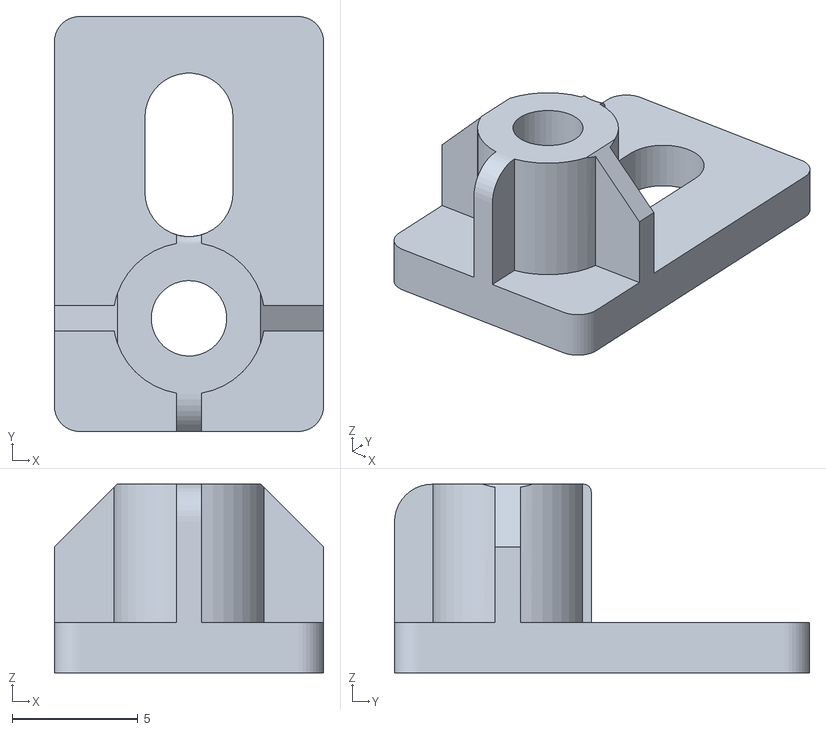
[picture p305: CAD file, 2026-03-17]
docs/delta/4/dy9.stl
10.7 x 16.5 x 7.50
