micromake/micromake.github.io/docs/delta/5/dy13.stl

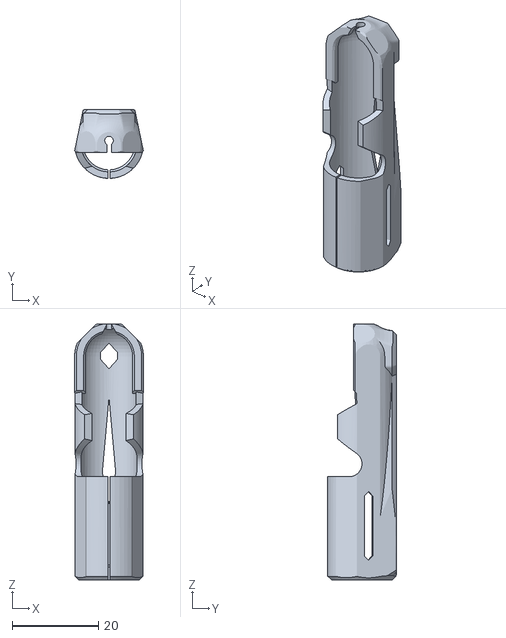
[picture p306: CAD file, 2026-03-17]
docs/delta/5/dy13.stl
16.0 x 16.0 x 59.5
