micromake/micromake.github.io/docs/delta/6/dy3.stl

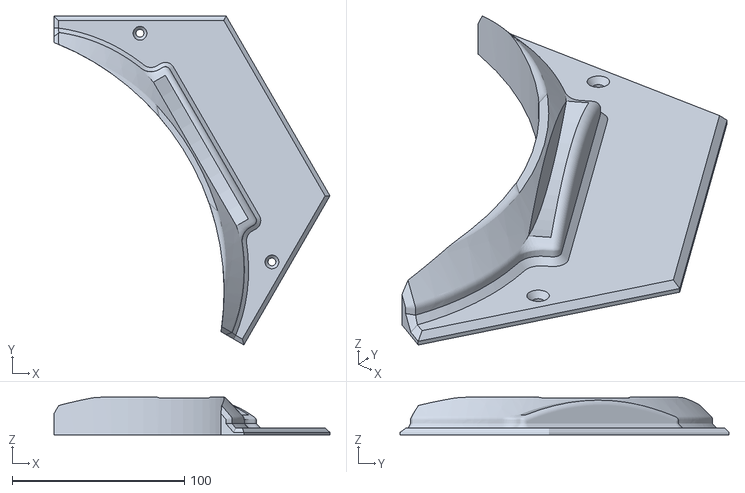
[picture p307: CAD file, 2026-03-04]
docs/delta/6/dy3.stl
160.3 x 191.0 x 22.0
