micromake/micromake.github.io/docs/delta/7/dy10.stl

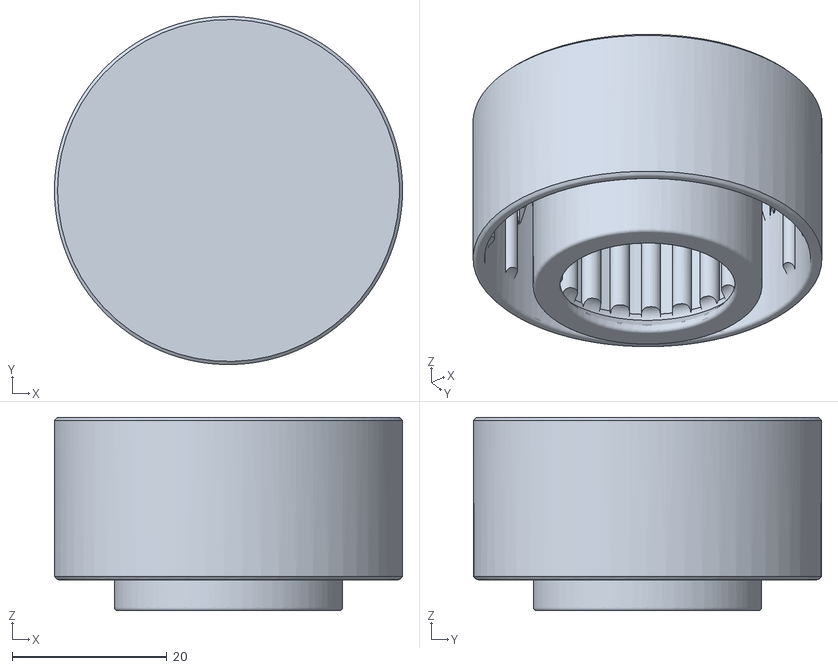
[picture p308: CAD file, 2026-03-17]
docs/delta/7/dy10.stl
45.0 x 45.0 x 25.0
