micromake/micromake.github.io/docs/delta/2/dy6.stl

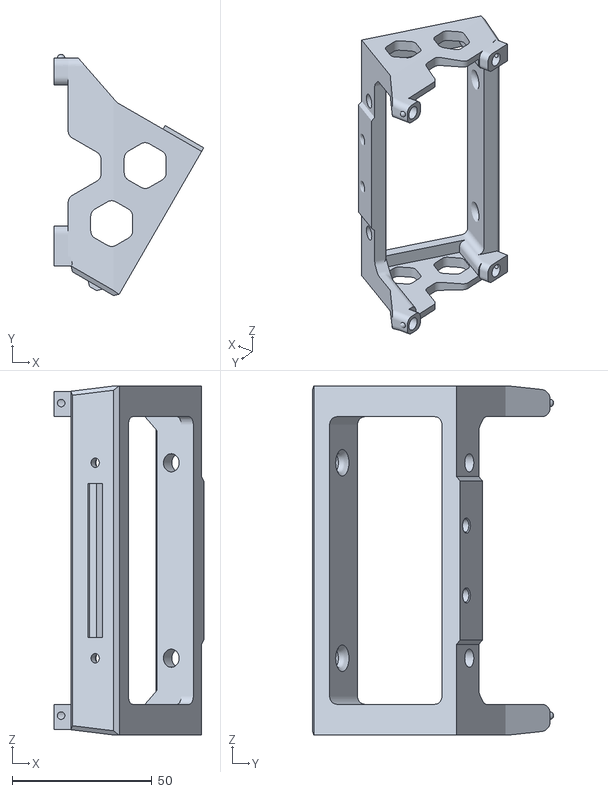
[picture p309: CAD file, 2026-02-28]
docs/delta/2/dy6.stl
53.6 x 86.4 x 125.0
