micromake/micromake.github.io/docs/delta/3/dy1.stl

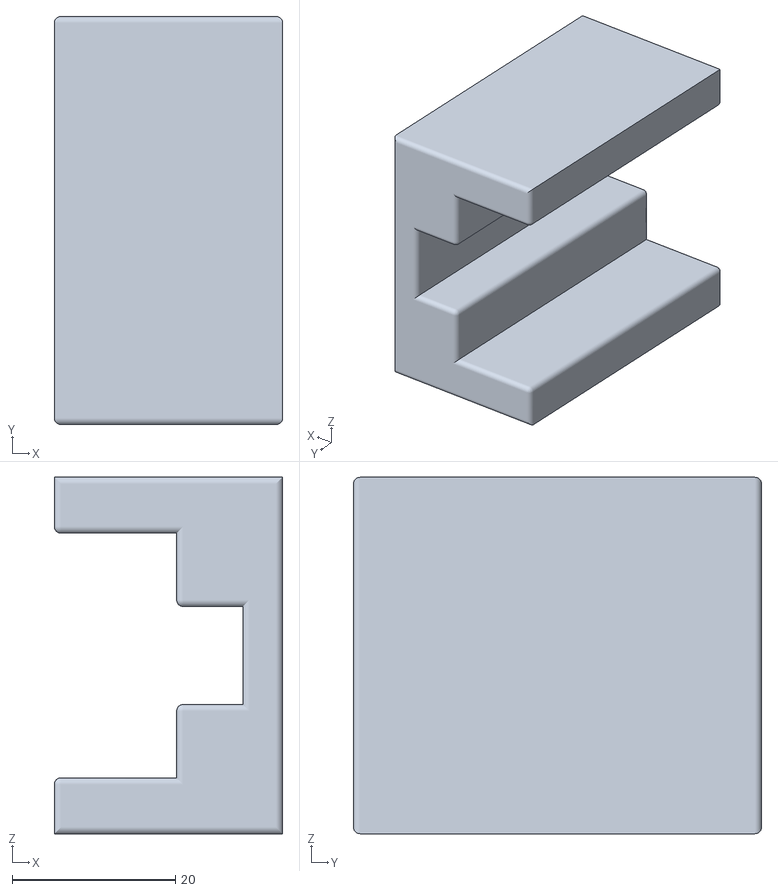
[picture p310: CAD file, 2026-02-28]
docs/delta/3/dy1.stl
28.0 x 50.0 x 43.7
