micromake/micromake.github.io/docs/delta/4/dy6.stl

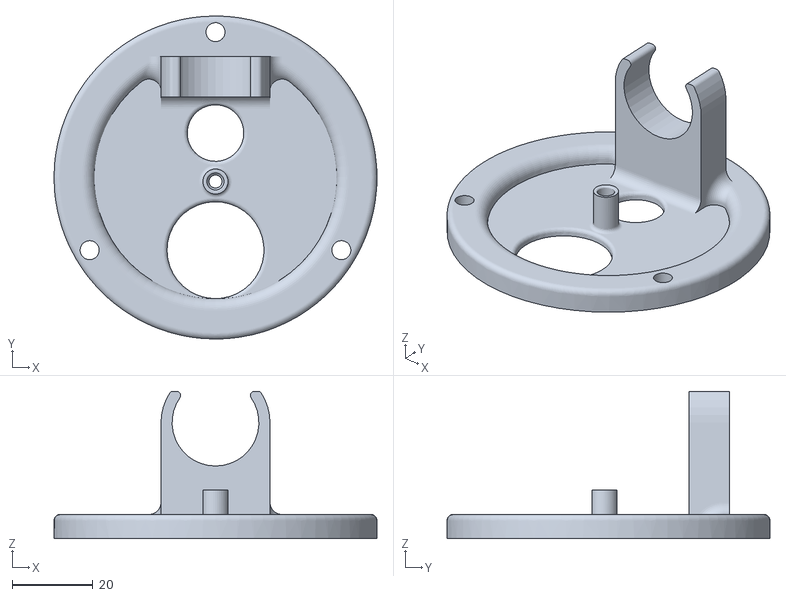
[picture p311: CAD file, 2026-02-28]
docs/delta/4/dy6.stl
80.0 x 80.0 x 36.5
