micromake/micromake.github.io/docs/delta/5/dy10.stl

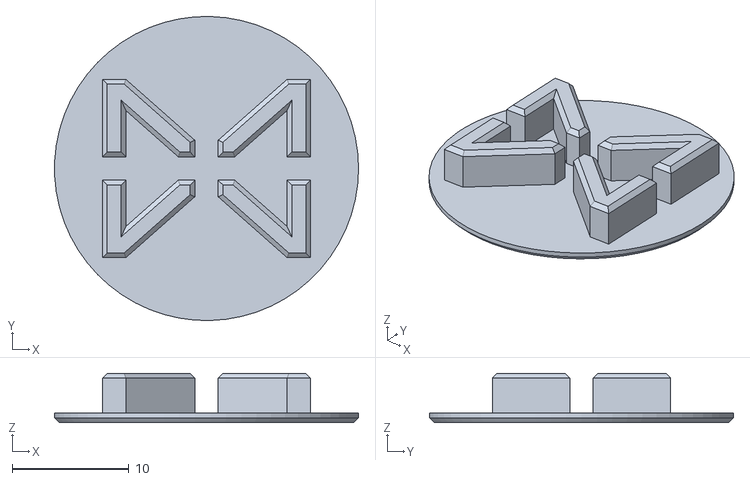
[picture p312: CAD file, 2026-02-28]
docs/delta/5/dy10.stl
26.0 x 26.0 x 4.20
