micromake/micromake.github.io/docs/delta/6/dy2.stl

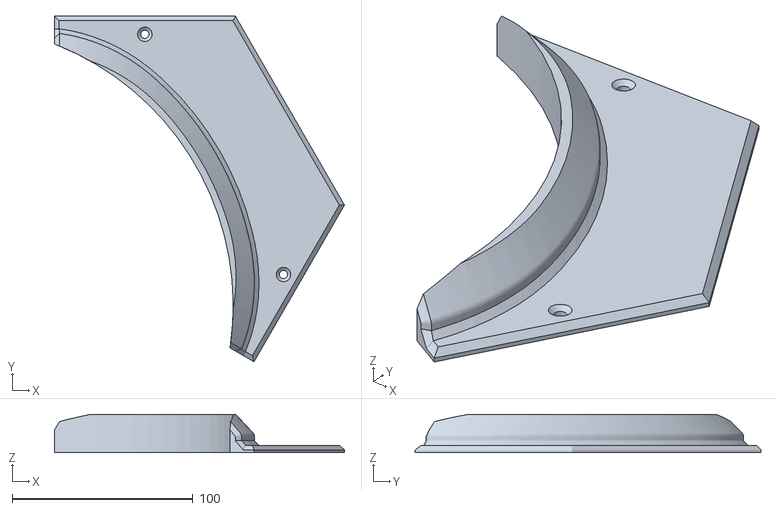
[picture p313: CAD file, 2026-03-04]
docs/delta/6/dy2.stl
160.3 x 191.0 x 21.0
