micromake/micromake.github.io/docs/delta/7/dy11.stl

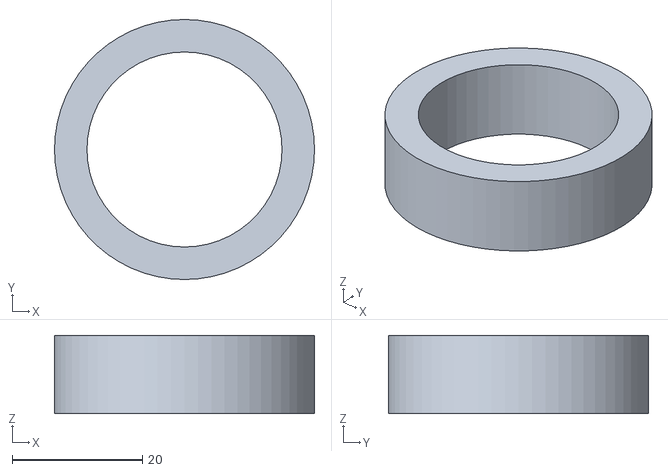
[picture p314: CAD file, 2026-03-17]
docs/delta/7/dy11.stl
40.0 x 40.0 x 12.0
