micromake/micromake.github.io/docs/delta/2/dy7.stl

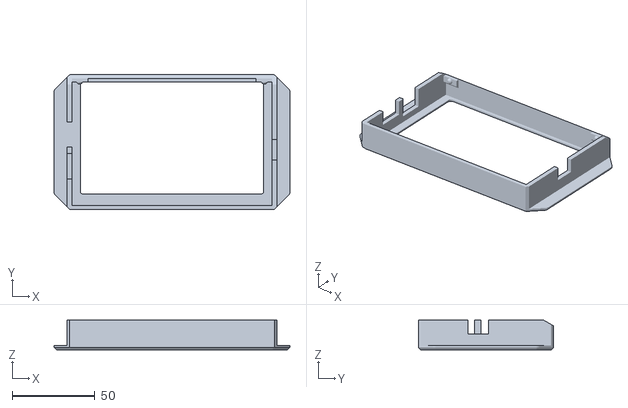
[picture p315: CAD file, 2026-02-28]
docs/delta/2/dy7.stl
143.0 x 82.0 x 18.0
