micromake/micromake.github.io/docs/delta/3/dy2.stl

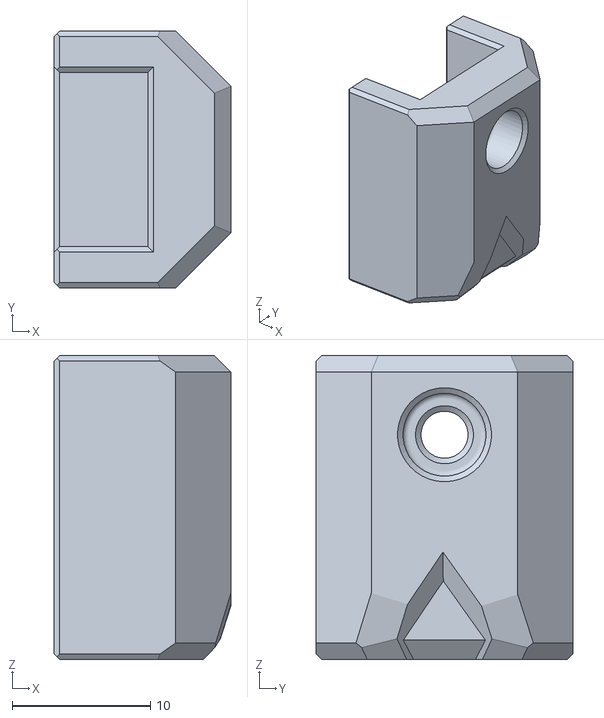
[picture p316: CAD file, 2026-02-28]
docs/delta/3/dy2.stl
12.8 x 18.6 x 22.0
