micromake/micromake.github.io/docs/delta/4/dy8.stl

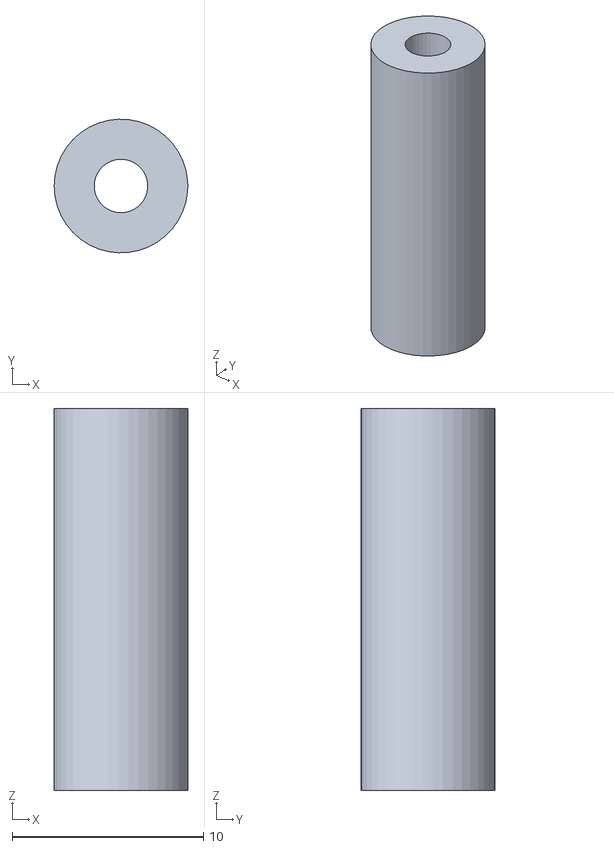
[picture p317: CAD file, 2026-02-28]
docs/delta/4/dy8.stl
7.00 x 6.99 x 20.0
