micromake/micromake.github.io/docs/delta/5/dy1.stl

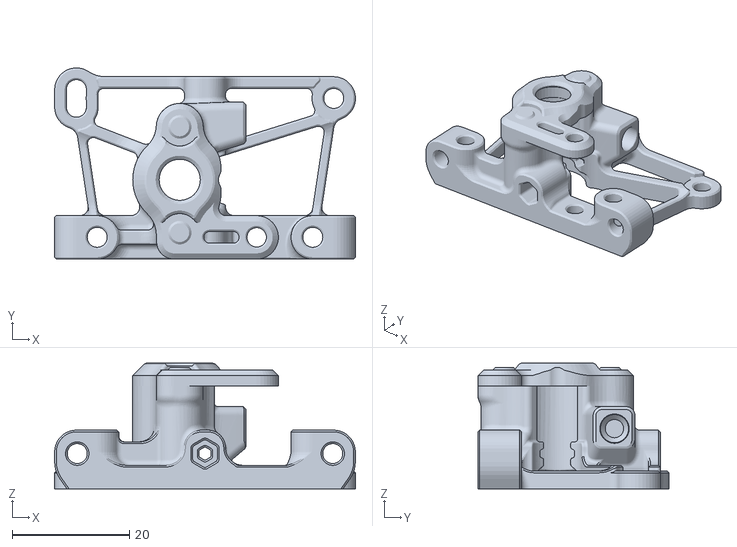
[picture p318: CAD file, 2026-02-28]
docs/delta/5/dy1.stl
51.2 x 32.5 x 21.4
