micromake/micromake.github.io/docs/delta/6/dy1.stl

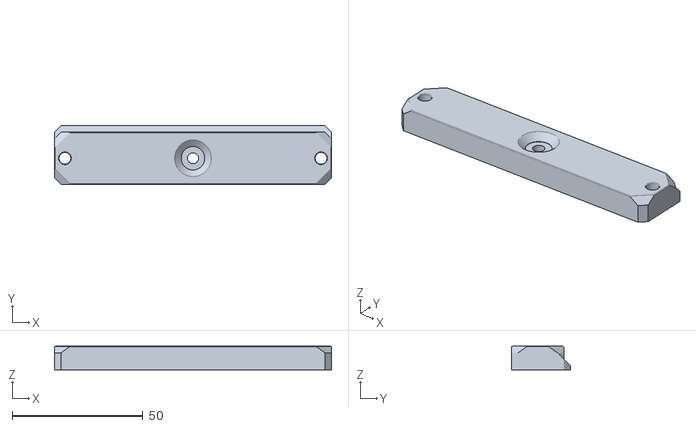
[picture p319: CAD file, 2026-03-04]
docs/delta/6/dy1.stl
106.0 x 22.5 x 9.00
