micromake/micromake.github.io/docs/delta/7/dy9.stl

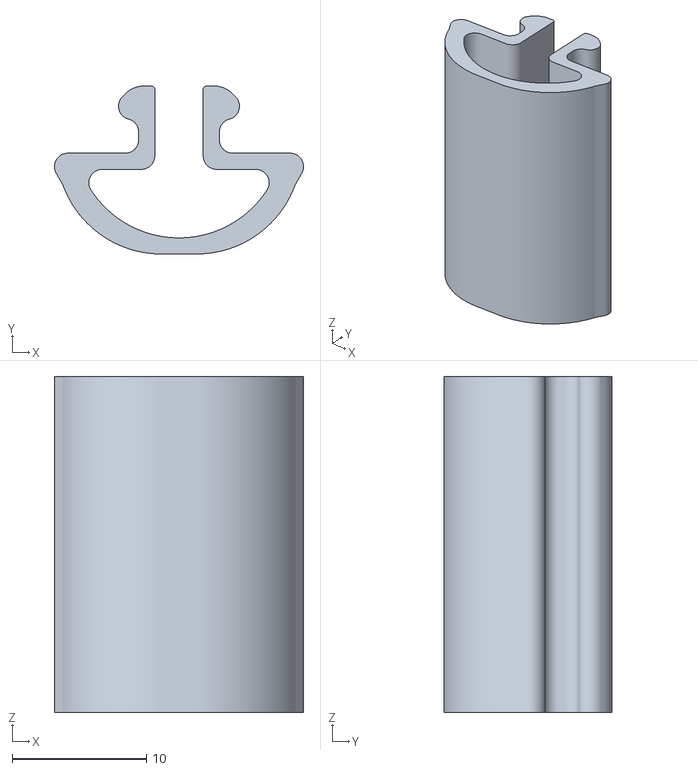
[picture p320: CAD file, 2026-03-16]
docs/delta/7/dy9.stl
18.5 x 12.5 x 25.0
