micromake/micromake.github.io/docs/delta/2/dy2.stl

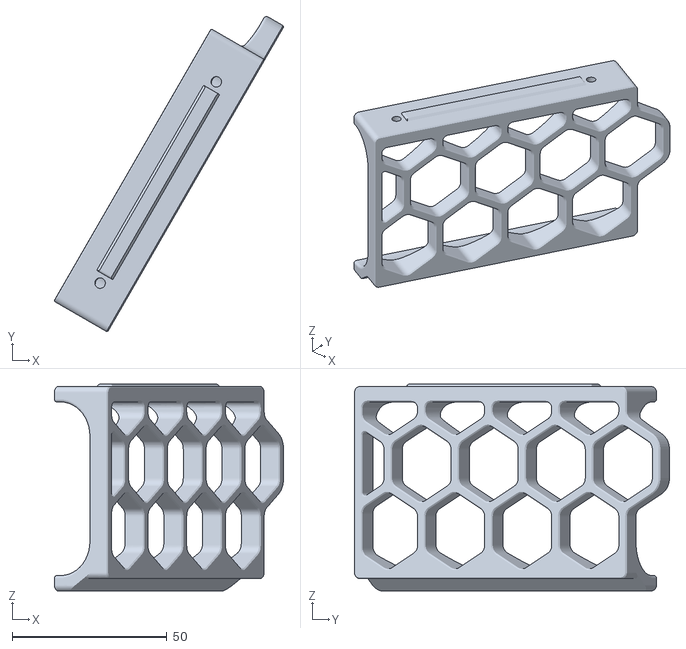
[picture p321: CAD file, 2026-02-28]
docs/delta/2/dy2.stl
73.9 x 101.7 x 66.8
