micromake/micromake.github.io/docs/delta/3/dy3.stl

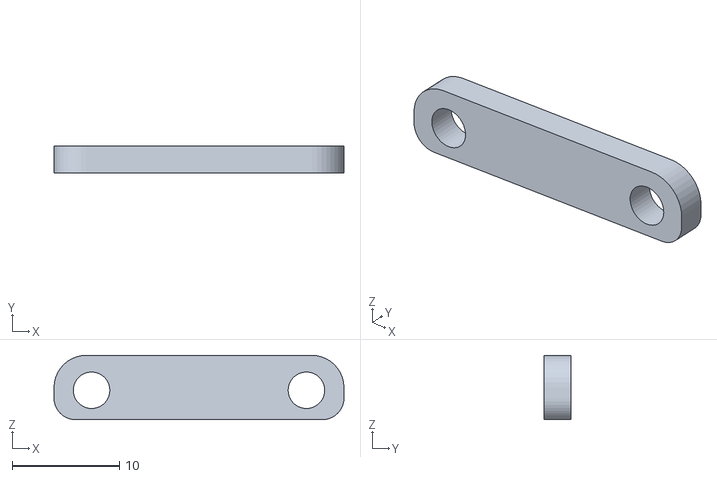
[picture p322: CAD file, 2026-02-28]
docs/delta/3/dy3.stl
27.0 x 2.50 x 5.98
