micromake/micromake.github.io/docs/delta/4/dy1.stl

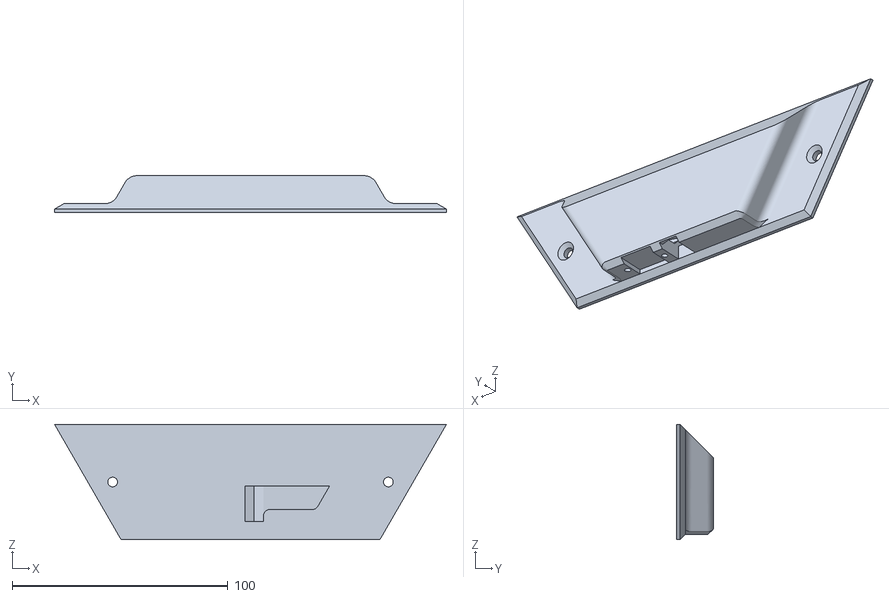
[picture p323: CAD file, 2026-02-28]
docs/delta/4/dy1.stl
181.9 x 17.0 x 53.5
