micromake/micromake.github.io/docs/delta/5/dy9.stl

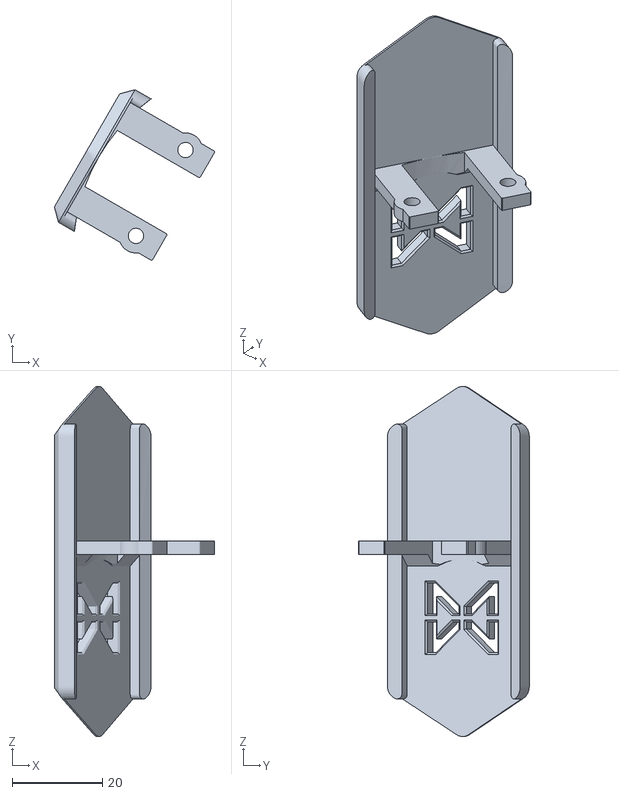
[picture p324: CAD file, 2026-02-28]
docs/delta/5/dy9.stl
35.6 x 37.9 x 77.7
