micromake/micromake.github.io/docs/delta/7/dy7.stl

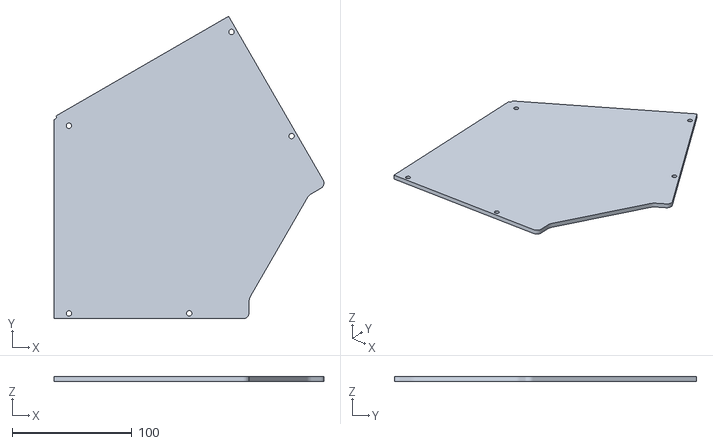
[picture p325: CAD file, 2026-03-05]
docs/delta/7/dy7.stl
225.6 x 252.8 x 4.00
