micromake/micromake.github.io/docs/delta/2/dy3.stl

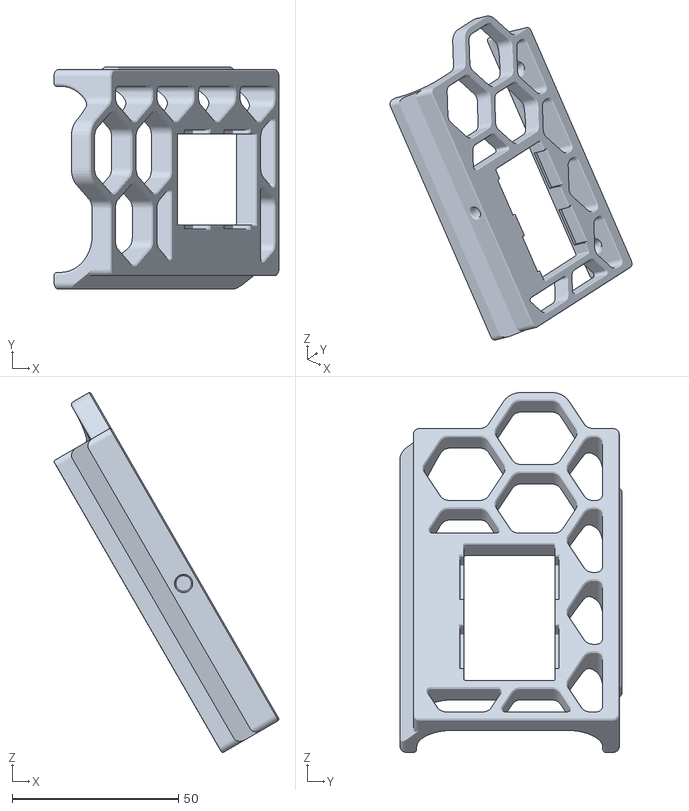
[picture p326: CAD file, 2026-02-28]
docs/delta/2/dy3.stl
67.7 x 66.8 x 108.3
