micromake/micromake.github.io/docs/delta/3/dy4.stl

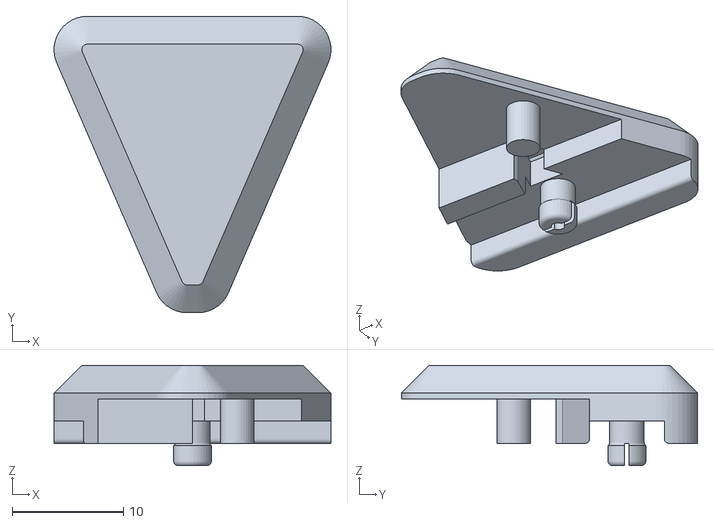
[picture p327: CAD file, 2026-02-28]
docs/delta/3/dy4.stl
24.9 x 26.6 x 9.00
