micromake/micromake.github.io/docs/delta/4/dy7.stl

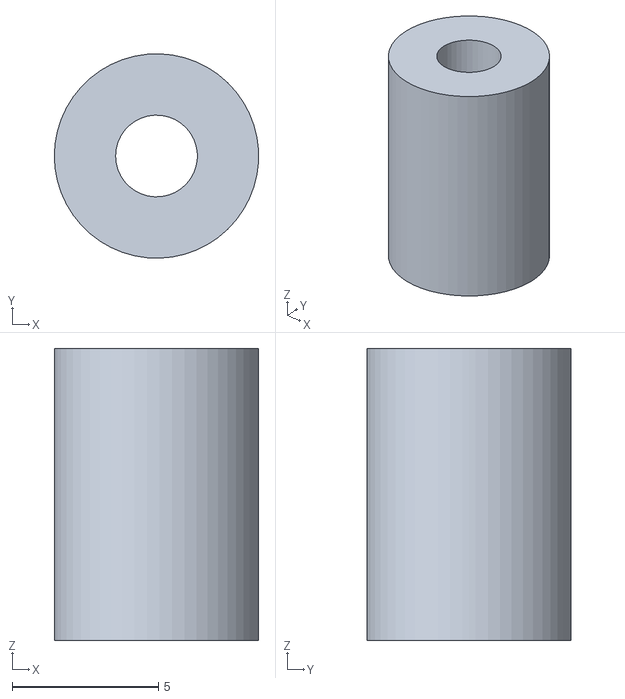
[picture p328: CAD file, 2026-02-28]
docs/delta/4/dy7.stl
7.00 x 7.00 x 10.0
