micromake/micromake.github.io/docs/delta/5/dy3.stl

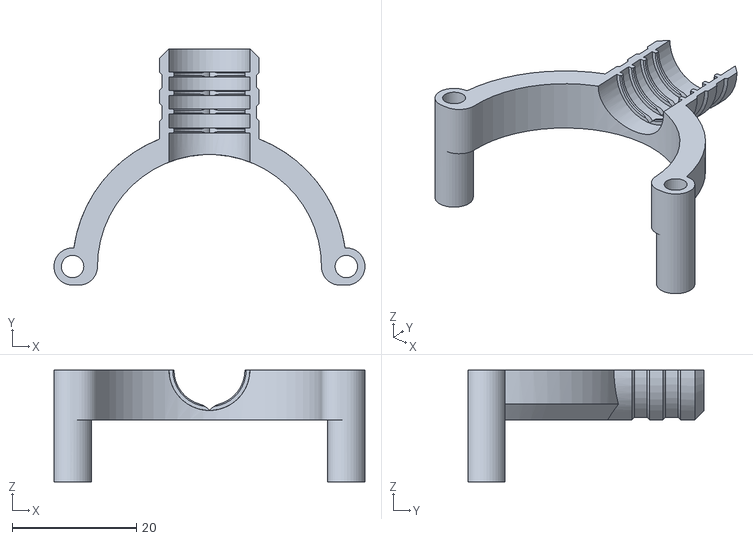
[picture p329: CAD file, 2026-02-28]
docs/delta/5/dy3.stl
50.0 x 38.0 x 18.0
