micromake/micromake.github.io/docs/delta/7/dy6.stl

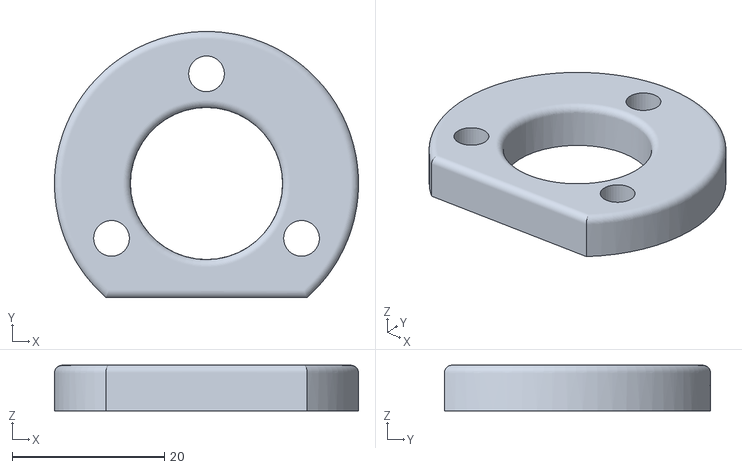
[picture p330: CAD file, 2026-03-05]
docs/delta/7/dy6.stl
40.0 x 35.0 x 6.00
