micromake/micromake.github.io/docs/delta/5/dy4.stl

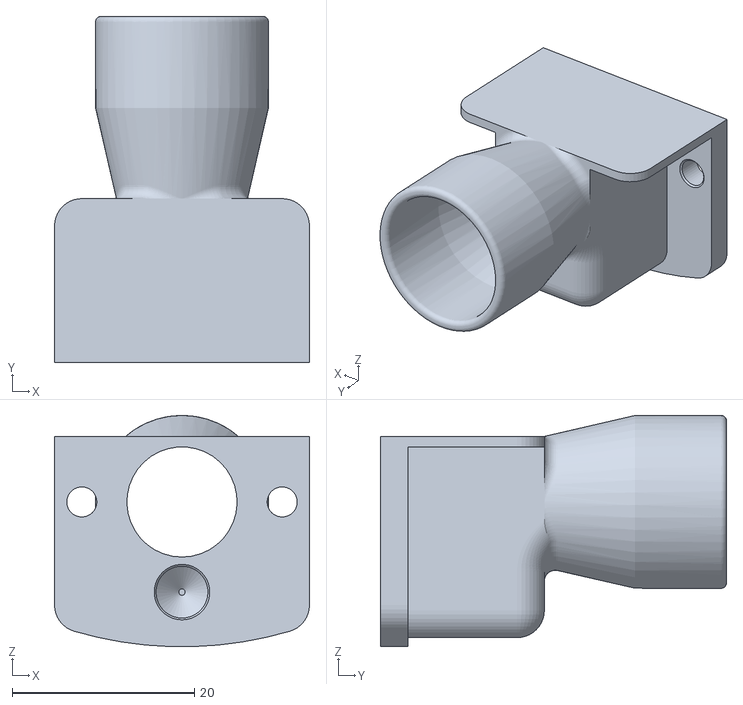
[picture p331: CAD file, 2026-02-28]
docs/delta/5/dy4.stl
28.0 x 38.0 x 25.4
