micromake/micromake.github.io/docs/delta/7/dy5.stl

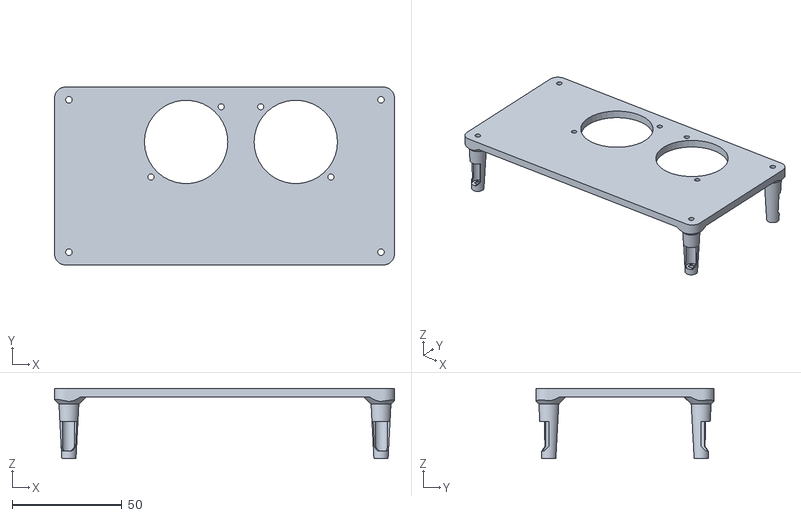
[picture p332: CAD file, 2026-03-05]
docs/delta/7/dy5.stl
155.0 x 81.1 x 32.0
