micromake/micromake.github.io/docs/delta/5/dy12.stl

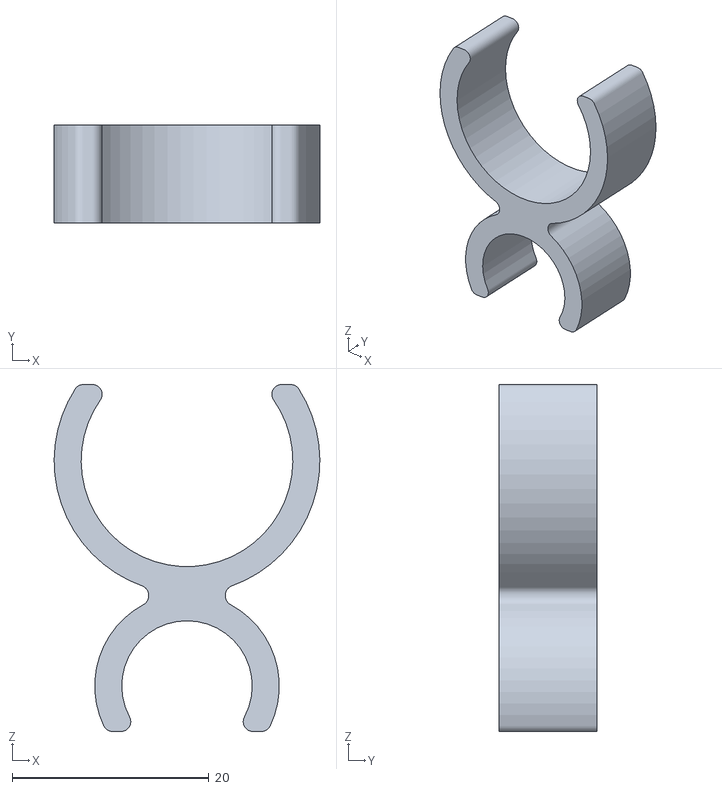
[picture p333: CAD file, 2026-02-28]
docs/delta/5/dy12.stl
27.0 x 10.0 x 35.2
