micromake/micromake.github.io/docs/delta/7/dy8.stl

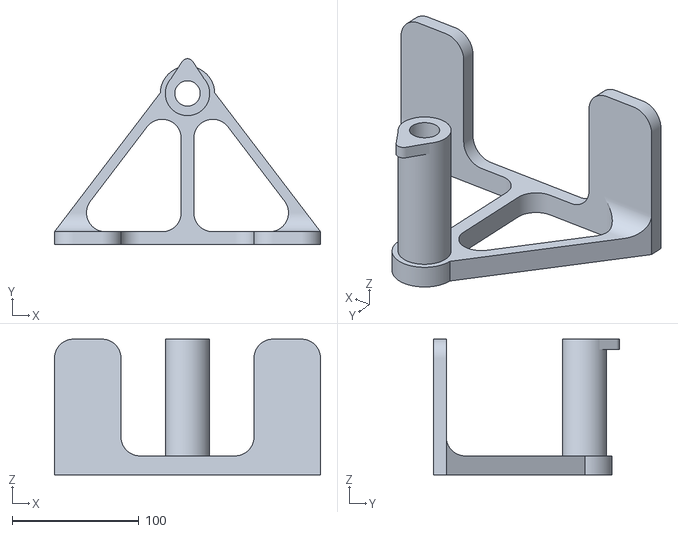
[picture p334: CAD file, 2026-03-05]
docs/delta/7/dy8.stl
210.0 x 146.6 x 107.2
