micromake/micromake.github.io/docs/delta/4/dy5.stl

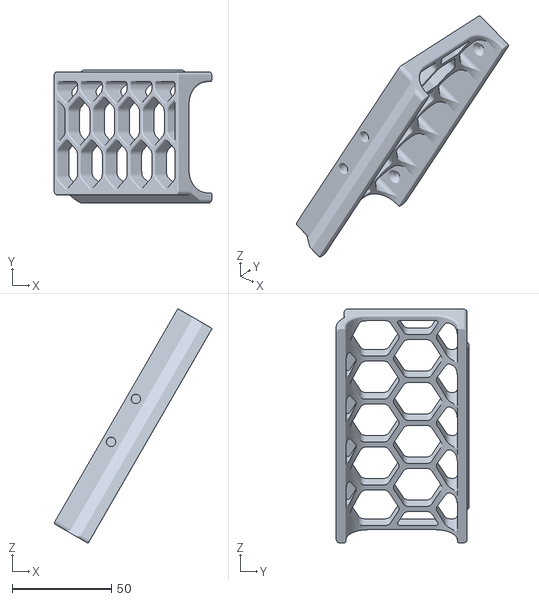
[picture p335: CAD file, 2026-02-28]
docs/delta/4/dy5.stl
79.4 x 66.8 x 117.9
