micromake/micromake.github.io/docs/delta/5/dy6.stl

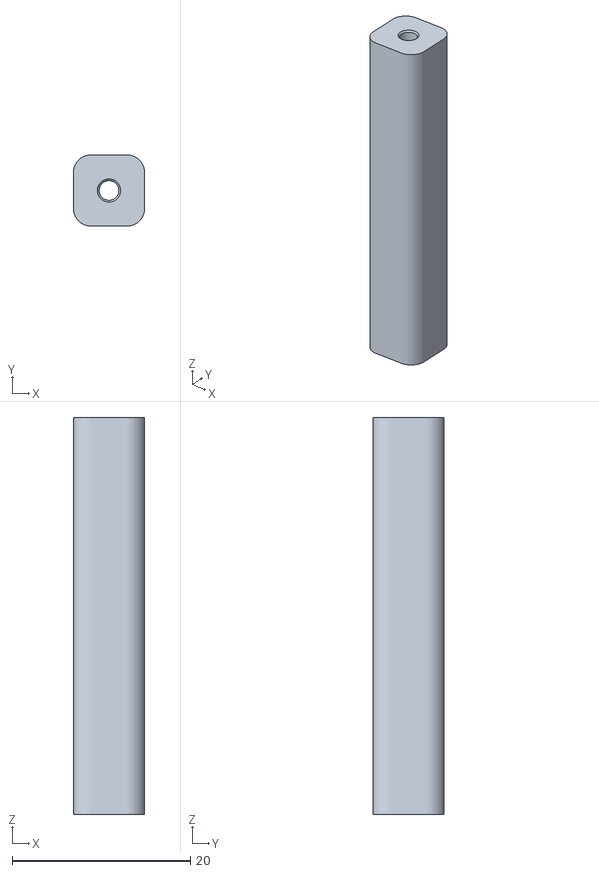
[picture p336: CAD file, 2026-02-28]
docs/delta/5/dy6.stl
8.00 x 8.00 x 44.5
