micromake/micromake.github.io/docs/delta/5/dy5.stl

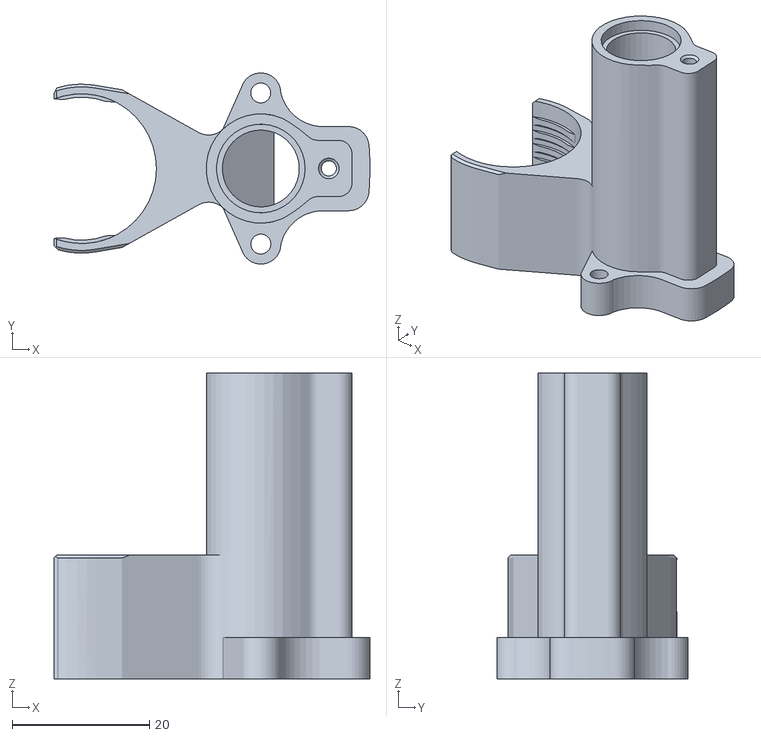
[picture p337: CAD file, 2026-02-28]
docs/delta/5/dy5.stl
46.0 x 27.8 x 44.5
