micromake/micromake.github.io/docs/delta/5/dy2.stl

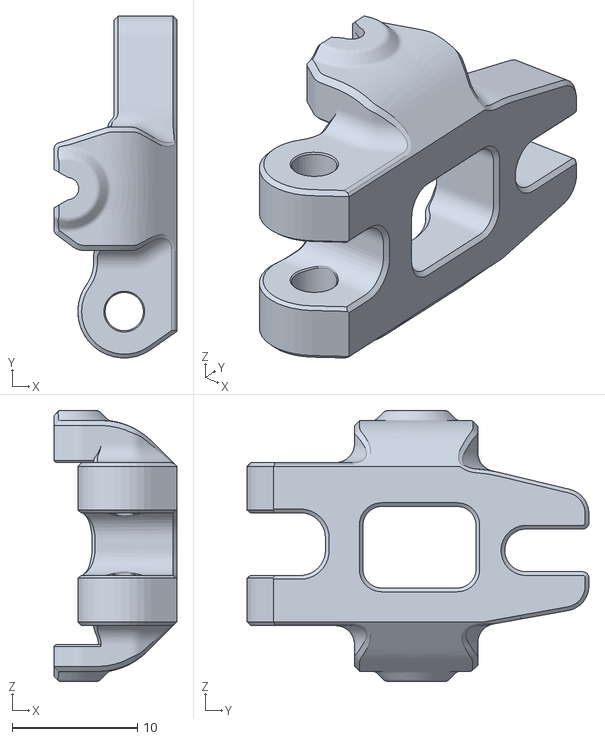
[picture p338: CAD file, 2026-02-28]
docs/delta/5/dy2.stl
9.80 x 27.3 x 21.6
