micromake/micromake.github.io/docs/delta/5/dy7.stl

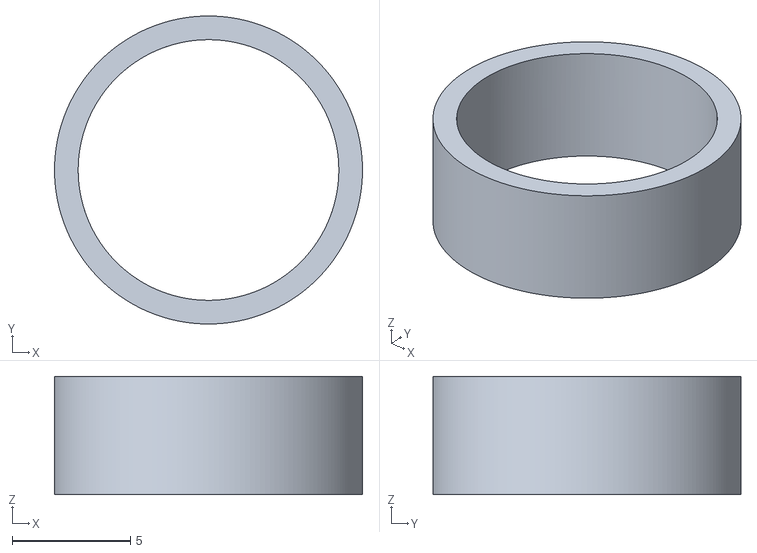
[picture p339: CAD file, 2026-02-28]
docs/delta/5/dy7.stl
13.0 x 13.0 x 4.99
