micromake/micromake.github.io/docs/delta/5/dy11.stl

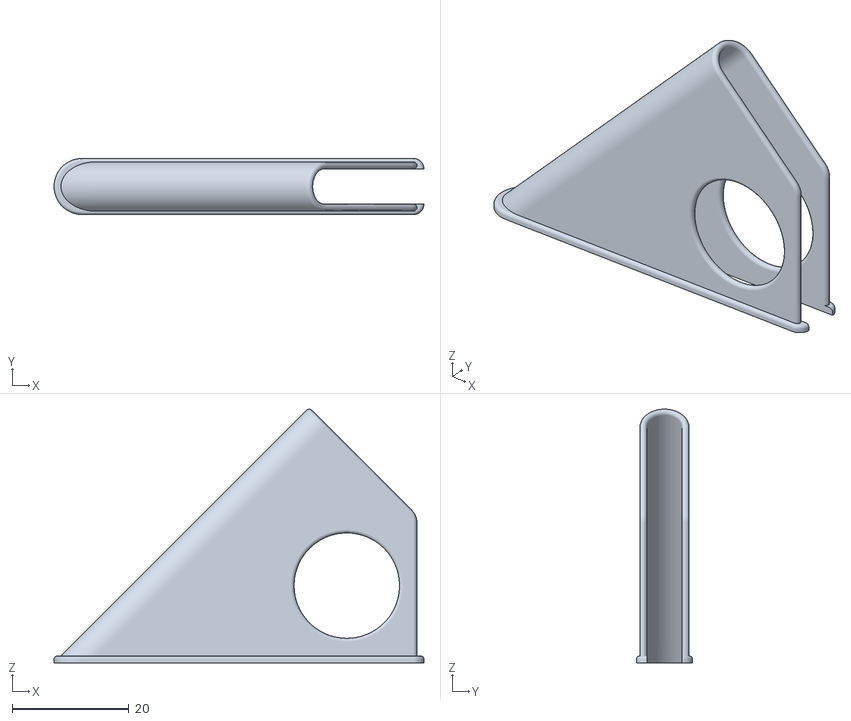
[picture p340: CAD file, 2026-02-28]
docs/delta/5/dy11.stl
63.3 x 9.60 x 43.4
