micromake/micromake.github.io/(list of files, cad)

Other CAD files:
docs/delta/4/dy2.stl
docs/delta/4/dy3.stl
docs/delta/4/dy4.stl
