micromake/micromake.github.io/(commit log)

2026-02-09 Update copyright year and reorganize DIY套件 section
    Updated copyright year to 2026 and modified the DIY套件 section for better organization.
2026-02-25 Update assembly instructions for吊台组装
    fix err
2026-02-28 update stl.
    [dy1.stl, dy2.stl, dy3.stl, dy4.stl, dy5.stl, dy6.stl, dy7.stl]
2026-02-28 update stl
    update stl
    [dy1.stl, dy10.stl, dy11.stl, dy12.stl, dy2.stl, dy3.stl, dy4.stl, dy5.stl]
2026-03-13 Revise tips and layout in index.md
    Updated tips for accessing articles on different devices.
2026-04-30 Update 3.md
    fix M3 nut err.
2026-04-30 Update 2.md
    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
2026-04-30 Add files via upload
    update nut img
2026-06-09 Update 2.md
    修复文字与编号错误
